g-rahul/5KW_OBC/Auxillary_Supply_UCC28740/IDFReport_Auxillary_Supply_UCC28740.html

Altium customize

# IDF File Translation Report

Date: | | 8/30/2020
Time: | | 11:17:08 AM
Elapsed Time: | | 00:00:00
PCB Filename | : | C:\Users\Public\Documents\Altium\Project\5kw_OBC\UCC2895-Q_KW\Auxillary_Supply_UCC28740\Auxillary_Supply_UCC28740.PcbDoc
IDF Board Filename | : | C:\Users\Public\Documents\Altium\Project\5kw_OBC\UCC2895-Q_KW\Auxillary_Supply_UCC28740\Auxillary_Supply_UCC28740.brd
IDF Library Filename | : | C:\Users\Public\Documents\Altium\Project\5kw_OBC\UCC2895-Q_KW\Auxillary_Supply_UCC28740\Auxillary_Supply_UCC28740.pro

Errors

Back to top

Warnings

Back to top

Save Warnings

Back to top

Save Errors

Back to top

Export Warnings

Back to top

Export Errors

Back to top
