g-rahul/5KW_OBC/Auxillary_Supply_UCC28740/WBDesign24.pdf

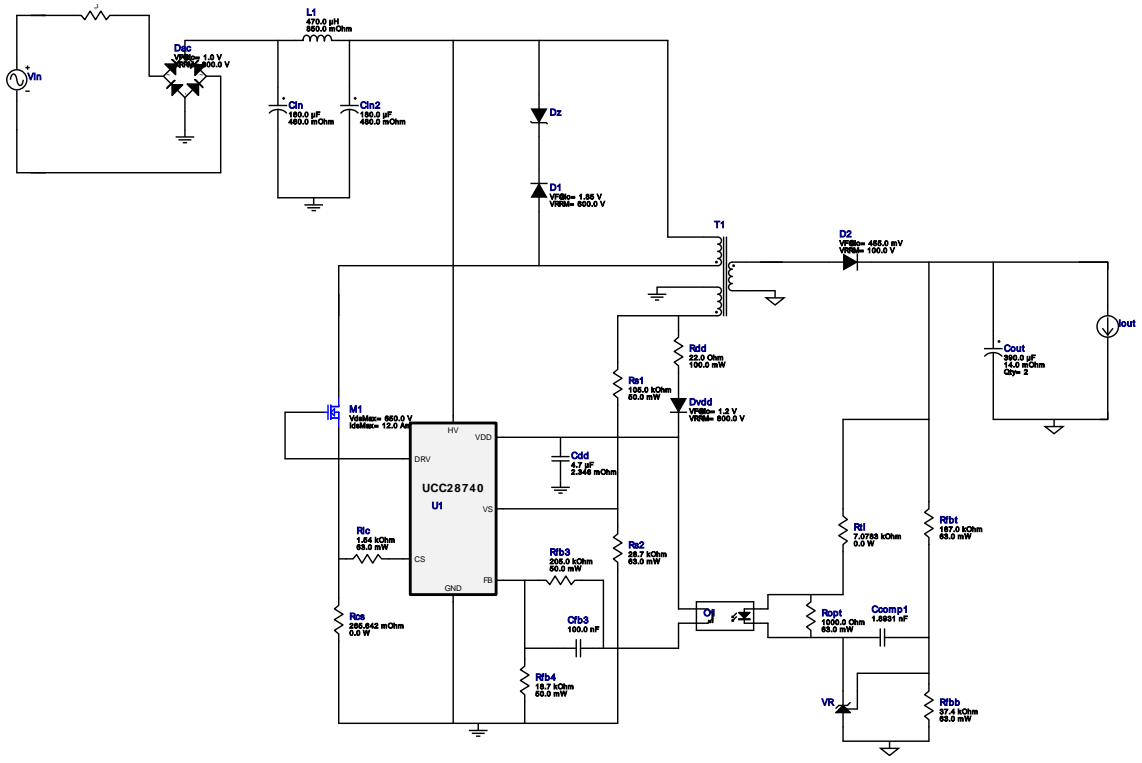
[picture p1: figure]
Ccomp1 Cfb3; Cin2 180.0 µF 480.0 mOhm; D1 VF@Io= 1.85 V VRRM= 600.0 V; D2 VF@Io= 455.0 mV VRRM= 100.0 V; Dac VF@Io= 1.0 V; VRRM= 800.0 V; L1 470.0 µH 850.0 mOhm; M1 VdsMax= 650.0 V IdsMax= 12.0 Amps; Rdd 22.0 Ohm 100.0 mW; Rfb4 18.7 kOhm 50.0 mW; Rlc 1.54 kOhm 63.0 mW; Ropt 1000.0 Ohm; Rs2 26.7 kOhm 63.0 mW; Cdd 4.7 µF 2.346 mOhm; Cin 180.0 µF 480.0 mOhm; Cout 390.0 µF; 14.0 mOhm Qty= 2; Dvdd VF@Io= 1.2 V VRRM= 800.0 V; Rcs 265.642 mOhm 0.0 W; Rfb3 205.0 kOhm 50.0 mW; Rfbb 37.4 kOhm 63.0 mW; Rfbt 187.0 kOhm; Rs1 105.0 kOhm 50.0 mW; Rtl 7.0783 kOhm; UCC28740; VDD; FB GND; DRV; Vin; Iout

Copyright © 2020, Texas Instruments Incorporated | 1 | ti.com/webench

WEBENCH®
Design Report UCC28740DR : UCC28740DR 90V-265V to 15.00V @ 4A March 12, 2020 04:56:46 GMT-07:00

## WEBENCH ® Design Report

Design : 24 UCC28740DR
UCC28740DR 90V-265V to 15.00V @ 4A

VinMin = 90.0V
VinMax = 265.0V
Vout = 15.0V
Iout = 4.0A

Device = UCC28740DR
Topology = Flyback
Created = 2020-03-12 04:49:58.049 BOM Cost = NA
BOM Count = 30
Total Pd = 14.47W
1. Rlc, Rtl and the feedback resistors for this design are a starting point, but may need adjustment based on the actual transformer used. For more information please click the design assistance button.
2. Click on the transformer symbol and select 'Design Transformer' to design using specific transformer cores and bobbin

### Design Alerts

Component Selection Information
Click on the transformer symbol in the schematic and select "Explore Transformer Core/Bobbin Selection" to design using specific transformer cores and bobbin.

## Electrical BOM

Name | Manufacturer | Part Number | Properties | Qty Price | Footprint
Ccomp1 | CUSTOM | CUSTOM Series= ? | Cap= 1.8931 nF VDC= 0.0 V IRMS= 0.0 A
1 | NA
| | | | | CUSTOM 0 mm²
Cdd | TDK | C2012X7R1V475K125AC (https://product.tdk.com/en/search/capacitor/ceramic/mlcc/info?part%5Fno%3DC2012X7R1V475K125AC) Series= X7R | Cap= 4.7 uF ESR= 2.346 mOhm VDC= 35.0 V IRMS= 4.2602 A
1 | $0.18
| | | | | 0805 7 mm²
Cfb3 | AVX | 08053C104JAZ2A (http://catalogs.avx.com/SurfaceMount.pdf) Series= X7R

Cap= 100.0 nF
VDC= 25.0 V
IRMS= 0.0 A

1 $0.06
0805 7 mm²

Design

Copyright © 2020, Texas Instruments Incorporated | 2 | ti.com/webench
Name | Manufacturer | Part Number | Properties | Qty Price | Footprint
Cin | Vishay-Bccomponents | MAL215959181E3 (http://www.vishay.com/docs/28341/159pulsi.pdf) Series= 2378 | Cap= 180.0 uF ESR= 480.0 mOhm VDC= 500.0 V IRMS= 1.13 A
1 | $5.30

159PUL-SI_3000x3500
1024 mm²
Cin2 | Vishay-Bccomponents | MAL215959181E3 (http://www.vishay.com/docs/28341/159pulsi.pdf) Series= 2378

Cap= 180.0 uF
ESR= 480.0 mOhm
VDC= 500.0 V
IRMS= 1.13 A

1 $5.30

159PUL-SI_3000x3500
1024 mm²
Cout | Panasonic | 20SVPF390M Series= SVPF

Cap= 390.0 uF
ESR= 14.0 mOhm
VDC= 20.0 V
IRMS= 4.95 A

2 $0.65

CAPSMT_62_E12 106 mm²
D1 | STMicroelectronics | STTH506B-TR (http://www.st.com/web/en/resource/technical/document/datasheet/CD00110837.pdf) | VF@Io= 1.85 V VRRM= 600.0 V
1 | $0.63

DPAK 102 mm²
D2 | STMicroelectronics | STPS20M100SG-TR (http://www.st.com/web/en/resource/technical/document/datasheet/CD00228904.pdf) | VF@Io= 455.0 mV VRRM= 100.0 V
1 | $1.33

DDPAK 210 mm²
Dac | Vishay-Semiconductor | GBU4K-E3/45 (http://www.vishay.com/docs/88614/gbu4a.pdf) | VF@Io= 1.0 V VRRM= 800.0 V | 1 | $0.68

GBU 131 mm²
Dvdd | Microsemi | UFS180JE3/TR13 | VF@Io= 1.2 V VRRM= 800.0 V | 1 | $0.73

DO-214BA 42 mm²
Dz | Diodes Inc. | SMBJ120A-13-F (http://www.diodes.com/datasheets/ds19002.pdf) | Zener | 1 | $0.09

SMB 44 mm²
L1 | NIC Components | NPI52W471MTRF (http://www.niccomp.com/pn/NPI52W471MTRF) | L= 470.0 µH 850.0 mOhm | 1 | $0.35

IND_NPI52W 358 mm²
M1 | STMicroelectronics | STD16N65M5 (http://www.st.com/web/en/resource/technical/document/datasheet/CD00288956.pdf) | VdsMax= 650.0 V IdsMax= 12.0 Amps
1 | $2.03

DPAK 102 mm²

Copyright © 2020, Texas Instruments Incorporated | 3 | ti.com/webench
Name | Manufacturer | Part Number | Properties | Qty Price | Footprint
NTC | GE Sensing | CL-40 (http://www.amphenol%2Dsensors.com/en/?option%3Dcom%5Fedocman%26task%3Ddocument.download%26id%3D90) Series= CL
Thermistor | 1 | $0.72
| | | | | Thermistor_CL-40 164 mm²
O1 | California Eastern Laboratories
PS2811-1 | Optocoupler | 1 | $0.41
| | | | | SSOP-4 111 mm²
Rcs | CUSTOM | CUSTOM Series= ? | Res= 265.642 mOhm Power= 0.0 W Tolerance= 0.0%
1 | NA
| | | | | CUSTOM 0 mm²
Rdd | Yageo | RC0603FR-0722RL (http://www.yageo.com.tw/exep/pages/download/literatures/PYu%2DR%5FINT%2Dthick%5F7.pdf) Series= ? | Res= 22.0 Ohm Power= 100.0 mW Tolerance= 1.0%
1 | $0.01
| | | | | 0603 5 mm²
Rfb3 | Yageo | RC0201FR-07205KL (http://www.yageo.com/exep/pages/download/literatures/PYu%2DR%5FMarking%5F2.pdf) Series= ? | Res= 205.0 kOhm Power= 50.0 mW Tolerance= 1.0%
1 | $0.01
| | | | | 0201 2 mm²
Rfb4 | Yageo | RC0201FR-0718K7L (http://www.yageo.com/exep/pages/download/literatures/PYu%2DR%5FMarking%5F2.pdf) Series= ? | Res= 18.7 kOhm Power= 50.0 mW Tolerance= 1.0%
1 | $0.01
| | | | | 0201 2 mm²
Rfbb | Vishay-Dale | CRCW040237K4FKED (http://www.vishay.com/docs/20035/dcrcwe3.pdf) Series= CRCW..e3 | Res= 37.4 kOhm Power= 63.0 mW Tolerance= 1.0%
1 | $0.01
| | | | | 0402 3 mm²
Rfbt | Vishay-Dale | CRCW0402187KFKED (http://www.vishay.com/docs/20035/dcrcwe3.pdf) Series= CRCW..e3 | Res= 187.0 kOhm Power= 63.0 mW Tolerance= 1.0%
1 | $0.01
| | | | | 0402 3 mm²
Rlc | Vishay-Dale | CRCW04021K54FKED (http://www.vishay.com/docs/20035/dcrcwe3.pdf) Series= CRCW..e3 | Res= 1.54 kOhm Power= 63.0 mW Tolerance= 1.0%
1 | $0.01
| | | | | 0402 3 mm²
Ropt | Vishay-Dale | CRCW04021K00FKED (http://www.vishay.com/docs/20035/dcrcwe3.pdf) Series= CRCW..e3 | Res= 1000.0 Ohm Power= 63.0 mW Tolerance= 1.0%
1 | $0.01
| | | | | 0402 3 mm²
Rs1 | Yageo | RC0201FR-07105KL (http://www.yageo.com/exep/pages/download/literatures/PYu%2DR%5FMarking%5F2.pdf) Series= ? | Res= 105.0 kOhm Power= 50.0 mW Tolerance= 1.0%
1 | $0.01
| | | | | 0201 2 mm²
Rs2 | Vishay-Dale | CRCW040226K7FKED (http://www.vishay.com/docs/20035/dcrcwe3.pdf) Series= CRCW..e3 | Res= 26.7 kOhm Power= 63.0 mW Tolerance= 1.0%
1 | $0.01
| | | | | 0402 3 mm²
Rtl | CUSTOM | CUSTOM Series= ? | Res= 7.0783 kOhm Power= 0.0 W Tolerance= 0.0%
1 | NA
| | | | | CUSTOM 0 mm²
T1 | Core=Wurth Elektronik , CoilFormer=Wurth Elektronik | Core=150-1680 , CoilFormer=070-5080 (http://katalog.we-online.de/pcd/datasheet/070-5080.pdf) | Lp= 262.0 µH Turns Ratio(Nas)= 9:7 Turns Ratio(Nps)= 47:7 Npri= 47.0 Naux= 9.0 Nsec= 7.0
1 | NA
| | | | | TDK_B66305 714 mm²
U1 | Texas Instruments | UCC28740DR (http://www.ti.com/product/UCC28740) | Switcher | 1 | $0.39

R-PDSO-G7 55 mm²
VR | Texas Instruments | TL431IDBVR (http://www.ti.com/product/TL431) | Voltage References | 1 | $0.07

R-PDSO-G3 16 mm²

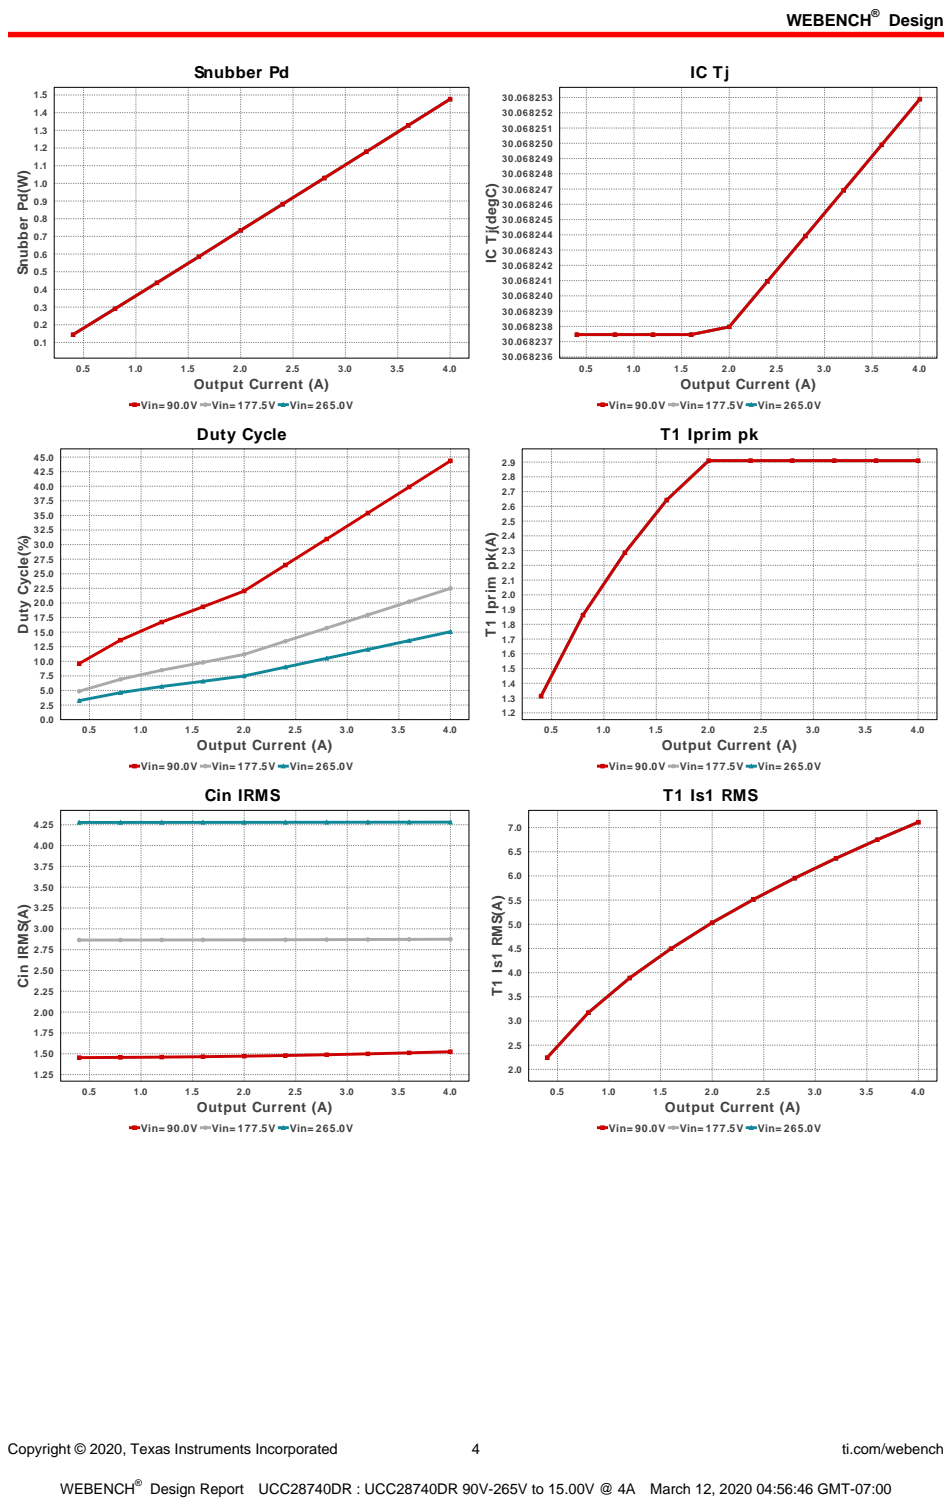
[picture p2: page 4]
Copyright © 2020, Texas Instruments Incorporated; ti.com/webench; Snubber Pd; 4.0 Output Current (A); Snubber Pd(W); Duty Cycle(%); T1 Iprim pk(A); Cin IRMS; Cin IRMS(A); T1 Is1 RMS(A)

IC Tj(degC)

Vin= 90.0V Vin= 177.5V Vin= 265.0V
Duty Cycle

T1 Iprim pk

T1 Is1 RMS

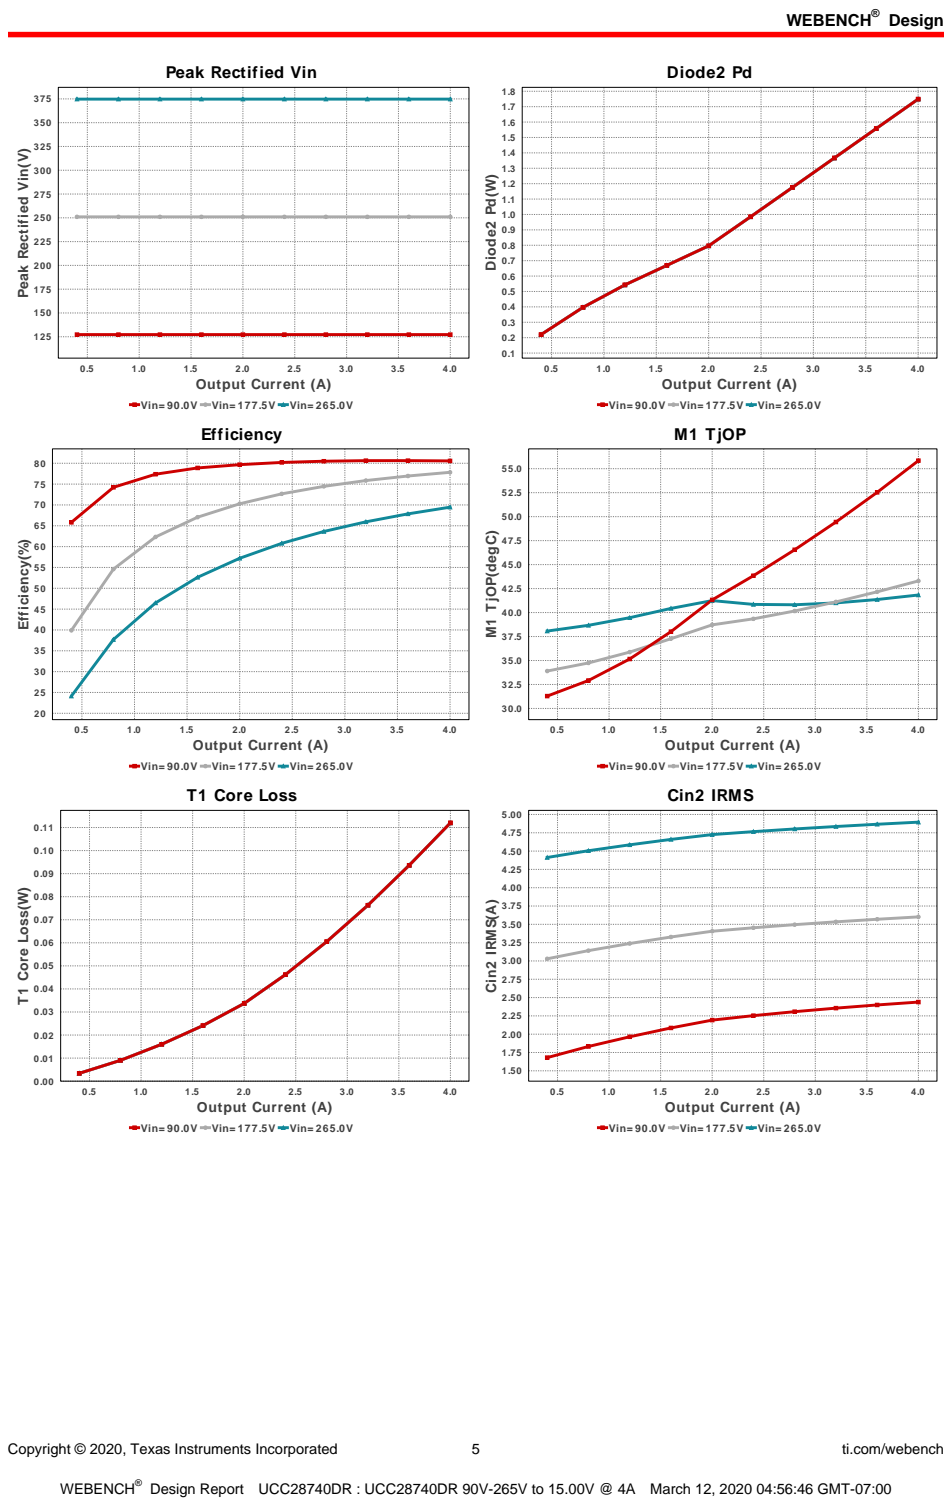
[picture p3: page 5]
Copyright © 2020, Texas Instruments Incorporated; ti.com/webench; 4.0 Output Current (A); Diode2 Pd; Diode2 Pd(W); Efficiency; Efficiency(%); M1 TjOP; M1 TjOP(degC); T1 Core Loss(W); Cin2 IRMS; Cin2 IRMS(A)

Peak Rectified Vin

Peak Rectified Vin(V)

Vin= 90.0V Vin= 177.5V Vin= 265.0V

T1 Core Loss

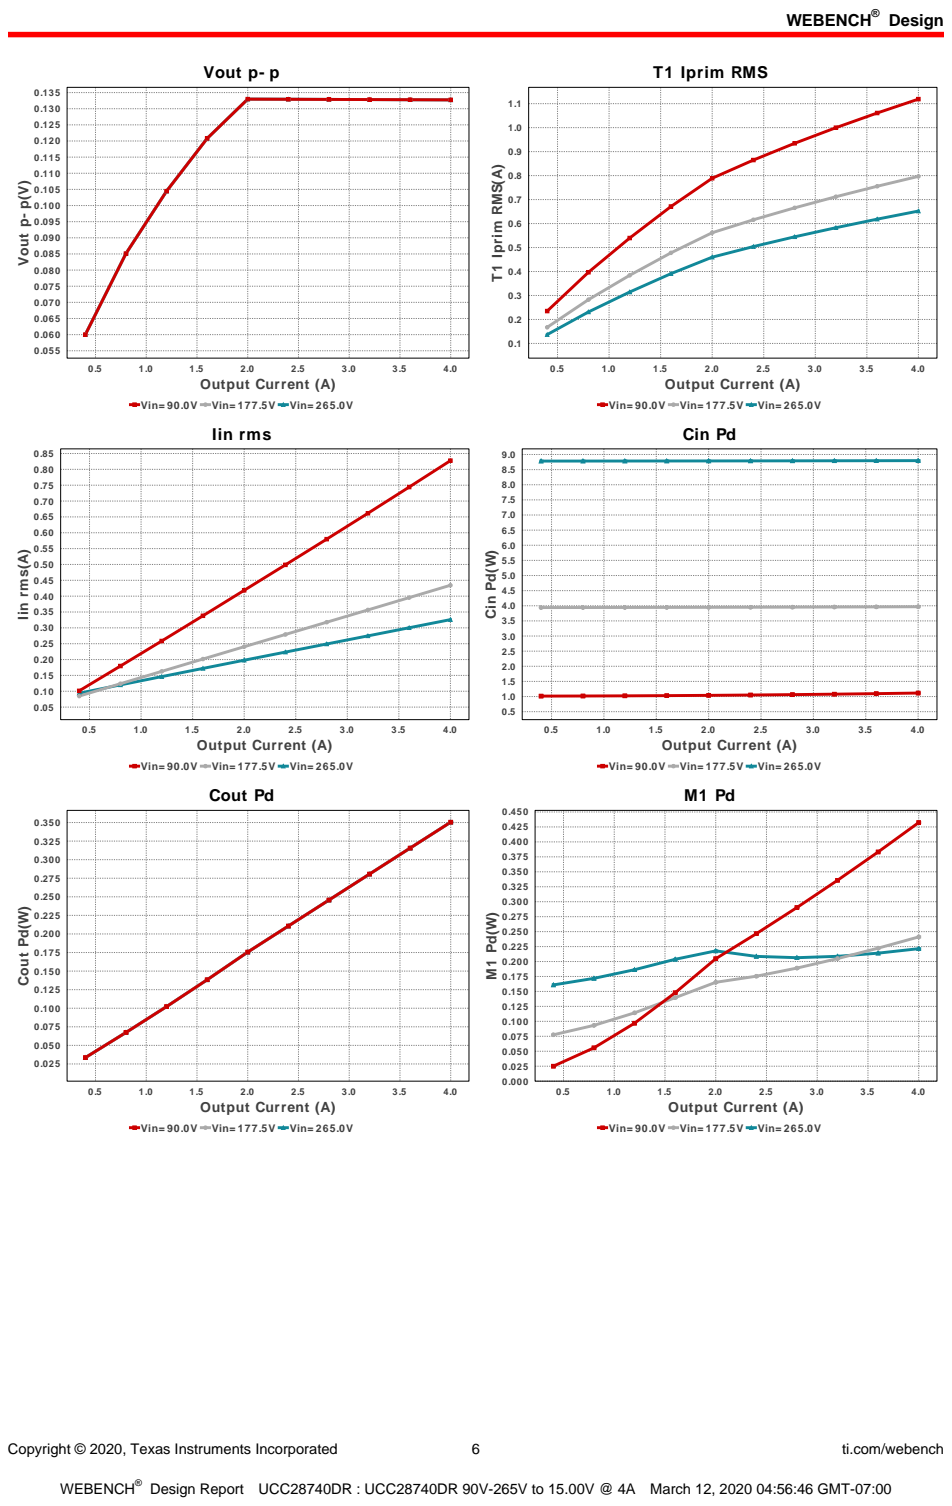
[picture p4: page 6]
Copyright © 2020, Texas Instruments Incorporated; ti.com/webench; Vout p- p; 4.0 Output Current (A); Vout p- p(V); T1 Iprim RMS; T1 Iprim RMS(A); Iin rms; Iin rms(A); Cin Pd; Cin Pd(W); Cout Pd; Cout Pd(W)

Vin= 90.0V Vin= 177.5V Vin= 265.0V

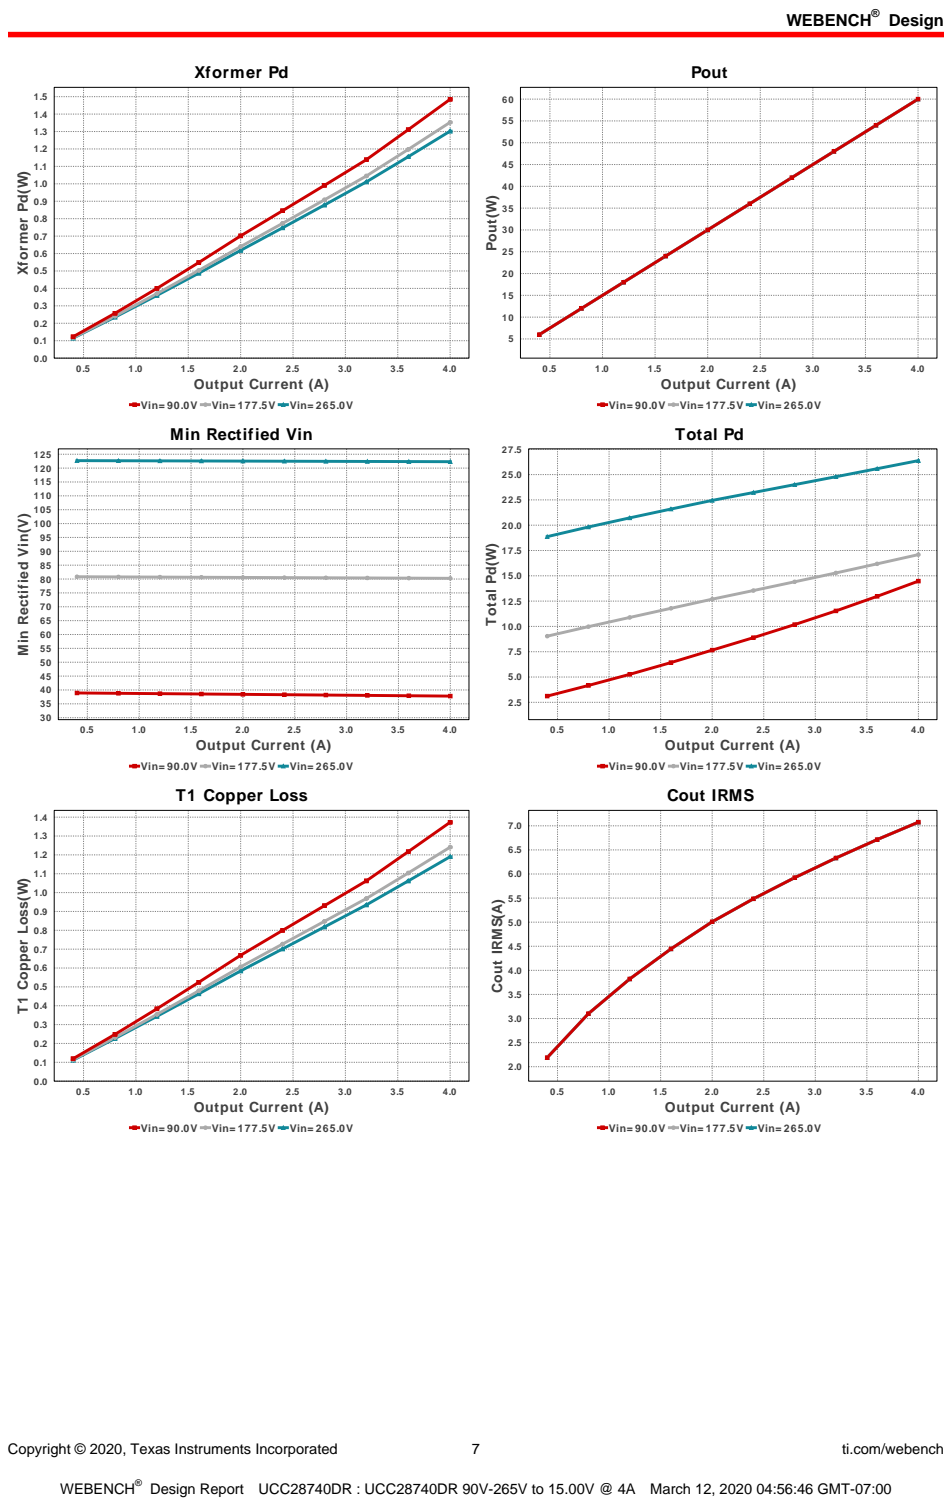
[picture p5: page 7]
Copyright © 2020, Texas Instruments Incorporated; ti.com/webench; Xformer Pd; 4.0 Output Current (A); Xformer Pd(W); Pout; Pout(W); Total Pd; Total Pd(W); T1 Copper Loss(W); Cout IRMS; Cout IRMS(A)

Vin= 90.0V Vin= 177.5V Vin= 265.0V
Min Rectified Vin

Min Rectified Vin(V)

T1 Copper Loss

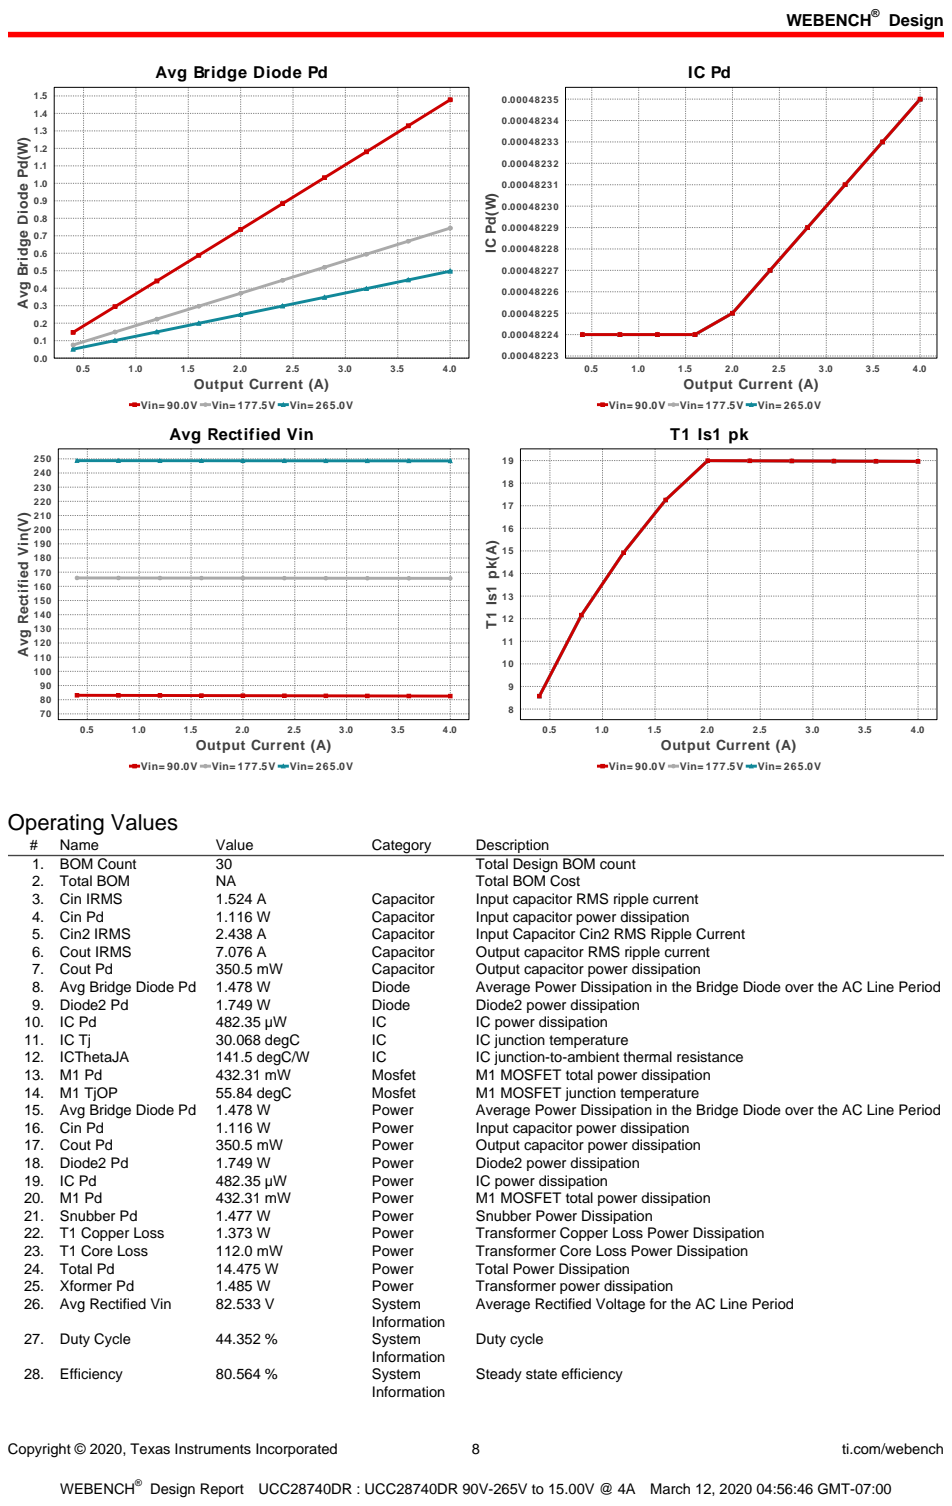
[picture p6: page 8]
Copyright © 2020, Texas Instruments Incorporated; ti.com/webench; 4.0 Output Current (A); Operating Values; Name; Value; Category; Description; 1. BOM Count; Total Design BOM count; 2. Total BOM; Total BOM Cost; 3. Cin IRMS; Capacitor; Input capacitor RMS ripple current; 4. Cin Pd; Input capacitor power dissipation; 5. Cin2 IRMS; Input Capacitor Cin2 RMS Ripple Current; 6. Cout IRMS; Output capacitor RMS ripple current; 7. Cout Pd; Output capacitor power dissipation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

Avg Bridge Diode Pd

Avg Bridge Diode Pd(W)

Vin= 90.0V Vin= 177.5V Vin= 265.0V
Avg Rectified Vin

Avg Rectified Vin(V)

Average Rectified Voltage for the AC Line Period

Steady state efficiency

Copyright © 2020, Texas Instruments Incorporated | 9 | ti.com/webench
# | Name | Value | Category | Description

29. FootPrint | 4.362 k mm² | System
| | | Information | Total Foot Print Area of BOM components
30. Frequency | 66.662 kHz | System
| | | Information | Switching frequency
31. Frequency | 66.662 kHz | System
| | | Information | Switching frequency
32. Iin rms | 827.5 mA | System
| | | Information | RMS Input Current
33. Iout | 4.0 A | System
| | | Information | Iout operating point
34. Min Rectified Vin | 37.787 V | System
| | | Information | Minimum voltage seen at rectified input
35. Mode | DCM | System
| | | Information | Conduction Mode
36. Peak Rectified Vin | 127.278 V | System
| | | Information | Peak voltage seen at rectified input
37. Pout | 60.0 W | System
| | | Information | Total output power
38. Vin_RMS | 90.0 V | System
| | | Information | Vin operating point
39. Vout | 15.0 V | System
| | | Information | Operational Output Voltage
40. Vout Actual | 15.0 V | System
| | | Information | Vout Actual calculated based on selected voltage divider resistors
41. Vout Tolerance | 2.009 % | System
| | | Information | Vout Tolerance based on IC Tolerance (no load) and voltage divider resistors if applicable
42. Vout p-p | 132.743 mV | System
| | | Information | Peak-to-peak output ripple voltage
43. T1 Copper Loss | 1.373 W | Transformer | Transformer Copper Loss Power Dissipation
44. T1 Core Loss | 112.0 mW | Transformer | Transformer Core Loss Power Dissipation
45. T1 Iprim RMS | 1.119 A | Transformer | Transformer Primary RMS Current
46. T1 Iprim pk | 2.91 A | Transformer | Transformer Primary Peak Current
47. T1 Is1 RMS | 7.112 A | Transformer | Transformer Secondary1 RMS Current
48. T1 Is1 pk | 18.963 A | Transformer | Transformer Secondary1 Peak Current
49. Xformer Pd | 1.485 W | Transformer | Transformer power dissipation

## Design Inputs

Name | Value | Description
Iout | 4.0 | Maximum Output Current
VinMax | 265.0 | Maximum input voltage
VinMin | 90.0 | Minimum input voltage
Vout | 15.0 | Output Voltage
acFrequency | 50.0 | AC Frequency
| base_pn | | UCC28740 | Base Product Number
source | AC | Input Source Type
Ta | 30.0 | Ambient temperature


Copyright © 2020, Texas Instruments Incorporated | 10 | ti.com/webench

## Assembly

## Component Testing

Some published data on components in datasheets such as Capacitor ESR and Inductor DC resistance is based on conservative values that will guarantee that the components always exceed the specification. For design purposes it is usually better to work with typical values. Since this data is not always available it is a good practice to measure the Capacitance and ESR values of Cin and Cout, and the inductance and DC resistance of L1 before assembly of the board. Any large discrepancies in values should be electrically simulated in WEBENCH to check for instabilities and thermally simulated in WebTHERM to make sure critical temperatures are not exceeded.

## Soldering Component to Board

If board assembly is done in house it is best to tack down one terminal of a component on the board then solder the other terminal. For surface mount parts with large tabs, such as the DPAK, the tab on the back of the package should be pre-tinned with solder, then tacked into place by one of the pins. To solder the tab town to the board place the iron down on the board while resting against the tab, heating both surfaces simultaneously. Apply light pressure to the top of the plastic case until the solder flows around the part and the part is flush with the PCB. If the solder is not flowing around the board you may need a higher wattage iron (generally 25W to 30W is enough).

## Initial Startup of Circuit

It is best to initially power up the board by setting the input supply voltage to the lowest operating input voltage 90.0V and set the input supply's current limit to zero. With the input supply off connect up the input supply to Vin and GND. Connect a digital volt meter and a load if needed to set the minimum Iout of the design from Vout and GND. Turn on the input supply and slowly turn up the current limit on the input supply.
If the voltage starts to rise on the input supply continue increasing the input supply current limit while watching the output voltage. If the current increases on the input supply, but the voltage remains near zero, then there may be a short or a component misplaced on the board. Power down the board and visually inspect for solder bridges and recheck the diode and capacitor polarities. Once the power supply circuit is operational then more extensive testing may include full load testing, transient load and line tests to compare with simulation results.

## Load Testing

The setup is the same as the initial startup, except that an additional digital voltmeter is connected between Vin and GND, a load is connected between Vout and GND and a current meter is connected in series between Vout and the load. The load must be able to handle at least rated output power + 50% ( 7.5 watts for this design). Ideally the load is supplied in the form of a variable load test unit. It can also be done in the form of suitably large power resistors. When using an oscilloscope to measure waveforms on the prototype board, the ground leads of the oscilloscope probes should be as short as possible and the area of the loop formed by the ground lead should be kept to a minimum. This will help reduce ground lead inductance and eliminate EMI noise that is not actually present in the circuit.

## Transformer Report

## Transformer Electrical Diagram

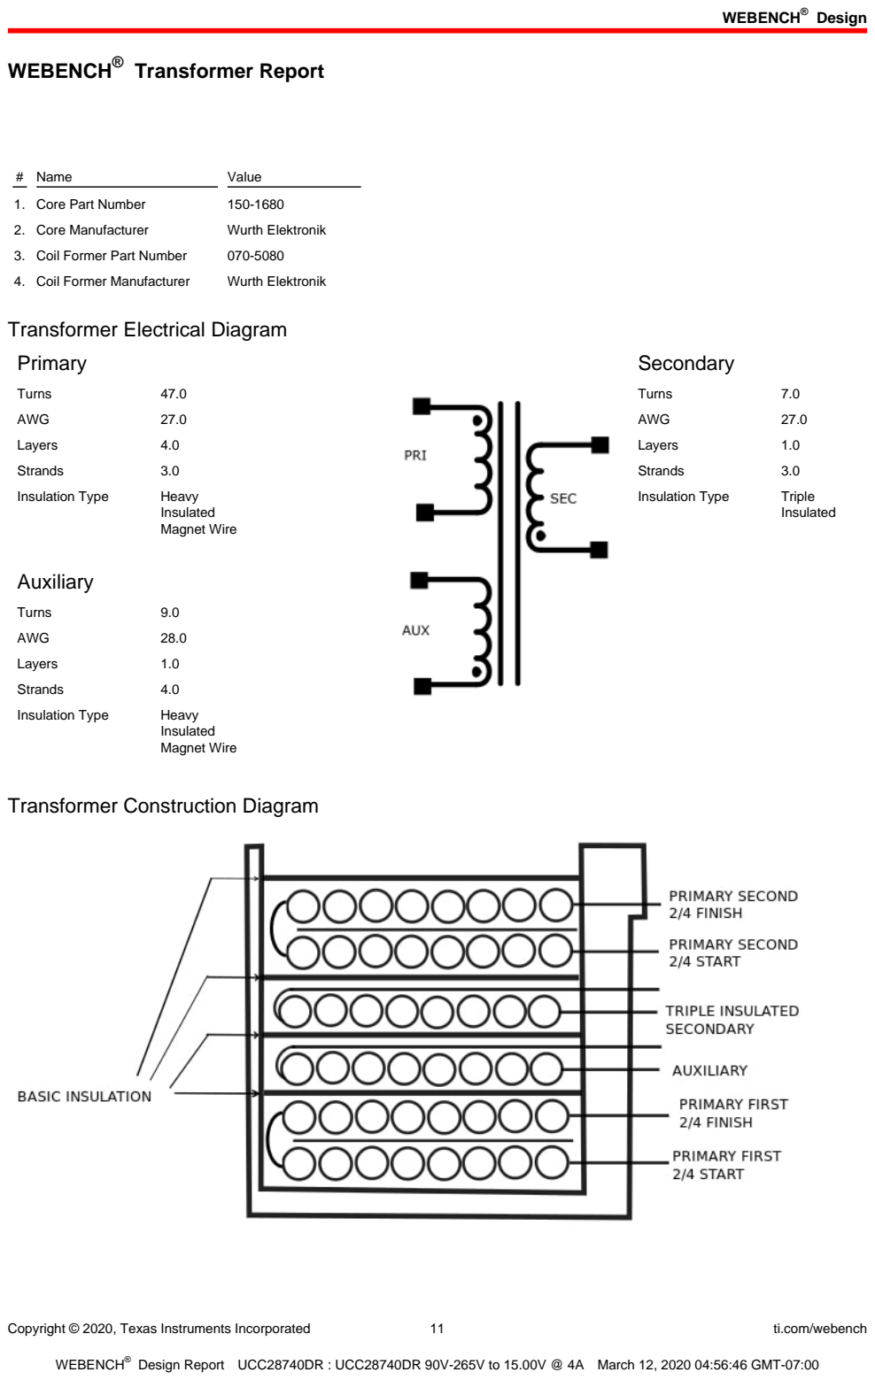
[picture p8: page 11]

Copyright © 2020, Texas Instruments Incorporated | 11 | ti.com/webench
# Name | Value

1. Core Part Number | 150-1680
2. Core Manufacturer | Wurth Elektronik
3. Coil Former Part Number | 070-5080
4. Coil Former Manufacturer | Wurth Elektronik

## Primary

Turns | 47.0
AWG | 27.0
Layers | 4.0
Strands | 3.0
Insulation Type | Heavy
Insulated
Magnet Wire

## Auxiliary

Turns | 9.0
AWG | 28.0
Layers | 1.0
Strands | 4.0
Insulation Type | Heavy
Insulated
Magnet Wire

## Secondary

Turns | 7.0
AWG | 27.0
Layers | 1.0
Strands | 3.0
Insulation Type | Triple Insulated

## Transformer Construction Diagram

Copyright © 2020, Texas Instruments Incorporated | 12 | ti.com/webench

## Winding Instruction

Winding | AWG | Turns | Winding Orientation
Primary First 2/4.0 | 27.0 | 24 | Clockwise
Auxiliary | 28.0 | 9.0 | Counter Clockwise
Triple Insulated Secondary | 27.0 | 7.0 | Counter Clockwise
Primary Second 2/4.0 | 27.0 | 23 | Clockwise

## Transformer Parameters

# Name | Value

1. Lpri | 2.62E-4H
2. Inductance Factor(Al) | 119.0nH
3. Npri | 47.0
4. Nsec | 7.0
5. Naux | 9.0
6. Core Type | EE25/13/11
7. Core Material | TP4A
8. Bmax | 0.21T
9. Switching Frequency | 63.00kHz
10. DMax | 0.51
11. Ipk(Primary) | 2.91A
12. Irms(Primary) | 1.2A
13. Ipk(Secondary) | 19.5A
14. Irms(Secondary) | 7.35A

## Design Assistance

1. Application Hints Rlc Rlc provides the function of feed-forward line compensation to eliminate change in IPP due to change in di/dt and the propagation delay of the internal comparator and MOSFET turn-off time. For best results the chosen value may need to be adjusted based on board, FET and transformer parasitics. Rtl Rtl is added to prevent excessive diode current and limit Iopt to the maximum value necessary for regulationThe Rtl value may be adjusted for optimal limiting later during the porotype evaluation process. Rfbt & Rfbb The feedback resistors will set the output voltage of the circuit. The values chosen may need to be fined tuned based on the final Transformer turns ratios and the voltage across the output diode at close to zero current. Rfb3 & Cfb3 Rfb3 is necessary to limit the current into FB and to avoid excess draining of Cvdd during this type of transient situation.The value of Rfb3 is chosen to limit the excess Ifb and Rfb4 current to an acceptable level when the optocoupler is saturatedCfb3 helps improve the transient response and is estimated initially by equating the time constant to 1ms. This can later beadjusted for optimal performance during prototype evaluation Rfb4 Rfb4 speeds up the turnoff time of the optocoupler in the case of a heavy load-step transient condition. This value tends to fallwithin the range of 10k and 100k. A tradeoff must be made between a lower value for faster transient response and a higher value forlower standby power. Rfb4 also serves to set a minimum bias current for the optocoupler and to drain dark current Part Description The UCC28740 isolated-flyback controller provides Constant-Voltage (CV) using an optical coupler toimprove transient response. Constant-Current (CC) regulation is accomplished through Primary Side Regulation (PSR) techniques. Please see the datasheet for further design guidance. http://www.ti.com/lit/ds/symlink/ucc28740.pdf
2. Master key : BE5D32129D021133[v1]
3. UCC28740 Product Folder : http://www.ti.com/product/UCC28740 : contains the data sheet and other resources.

Important Notice and Disclaimer

TI provides technical and reliability data (including datasheets), design resources (including reference designs), application or other design advice, web tools, safety information, and other resources AS IS and with all faults, and disclaims all warranties. These resources are intended for skilled developers designing with TI products. You are solely responsible for (1) selecting the appropriate TI products for your application, (2) designing, validating and testing your application, and (3) ensuring your application meets applicable standards, and any other safety, security, or other requirements.

These resources are subject to change without notice. TI grants you permission to use these resources only for development of an application that uses the TI products described in the resource. Other reproduction and display of these resources is prohibited. No license is granted to any other TI intellectual property right or to any third party intellectual property right. TI disclaims responsibility for, and you will fully indemnify TI and its representatives against, any claims, damages, costs, losses, and liabilities arising out of your use of these resources.

Providing these resources does not expand or otherwise alter TI's applicable Terms of Sale or other applicable terms available either on ti.com or provided in conjunction with TI products.
