g-rahul/5KW_OBC/Auxillary_Supply_UCC28740/3D Models/E25-13-7-and-B66208B(horizontal).STEP

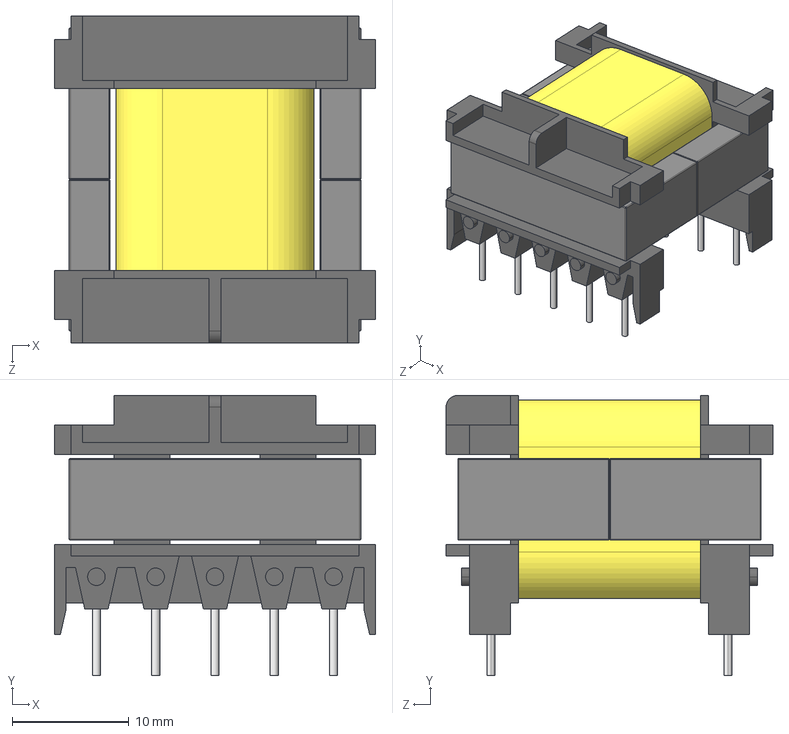
[picture p9: CAD file, 2020-07-27]
Auxillary_Supply_UCC28740/3D Models/E25-13-7-and-B66208B(horizontal).STEP
27.5 x 24.0 x 28.0 mm
B66208B
Ferrite-E25_13_7 x 2
winding-15.6
