g-rahul/5KW_OBC/PFC_Stage/PFC_Stage.DXF

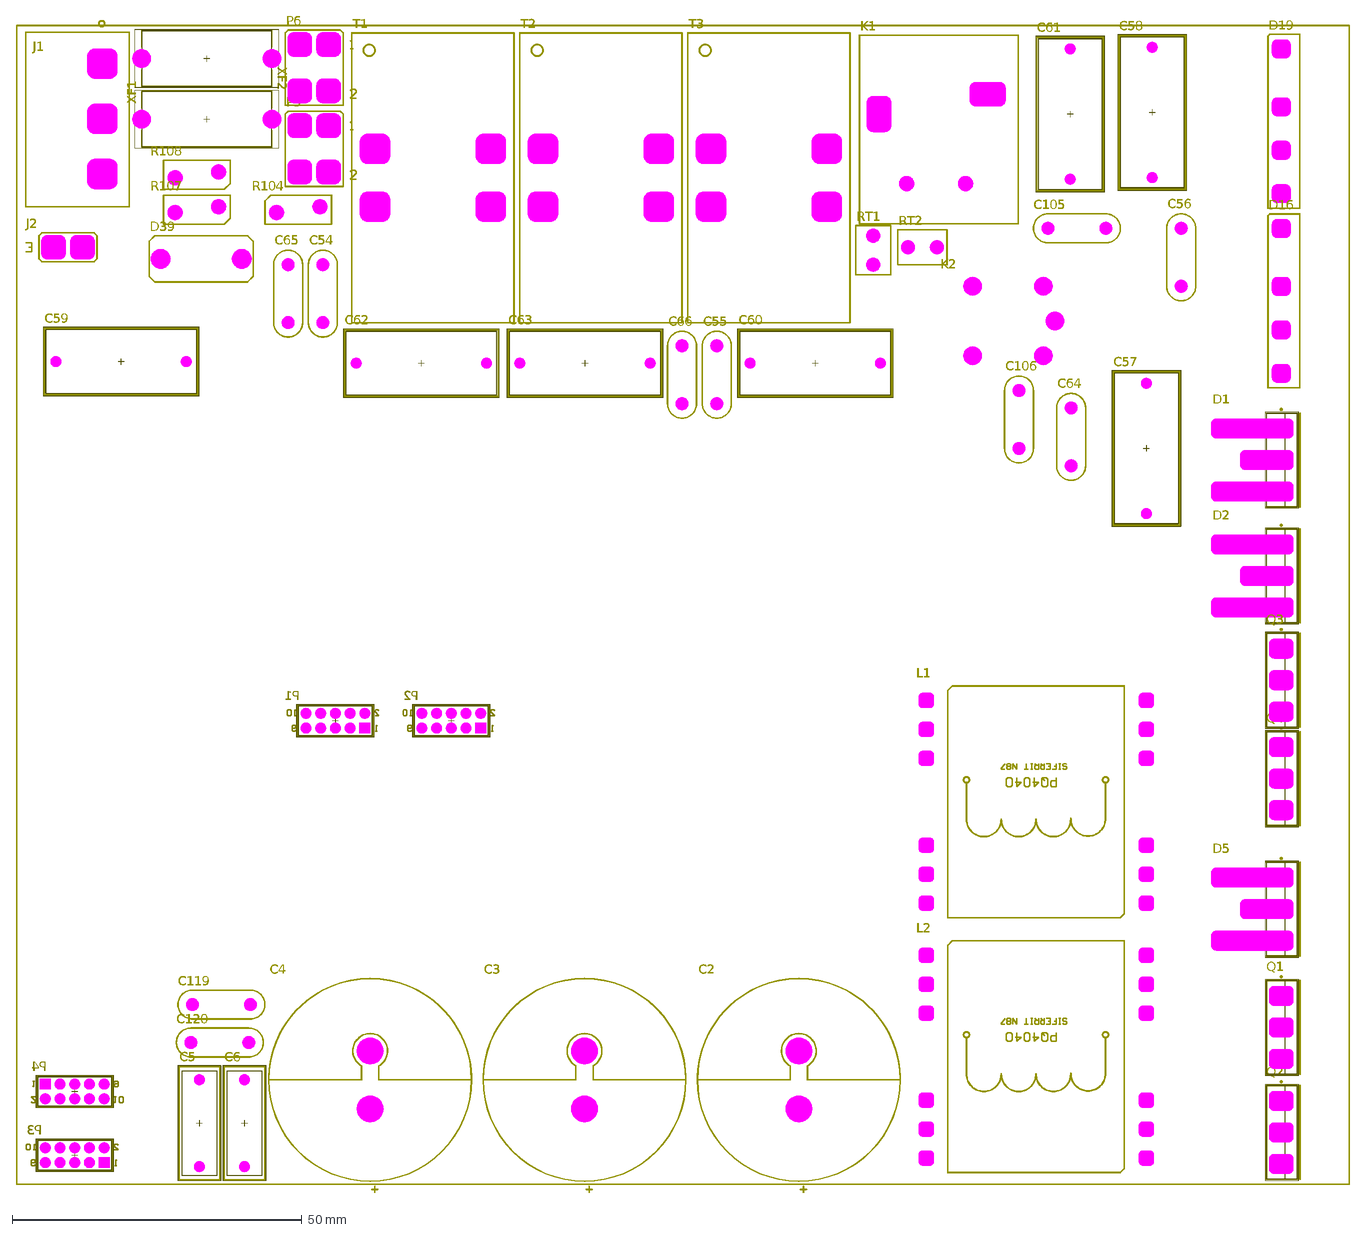
[picture p10: CAD file, 2020-07-27]
PFC_Stage/PFC_Stage.DXF
P4
P3
P2
P1
D5
D2
D1
Q4
Q3
Q2
Q1
L2
L1
C120
C119
C58
C57
C6
C5
C4
C3
C2
K1
XF2
XF1
T3
T2
T1
RT2
RT1
R108
R107
R104
P9
P6
K2
J2
J1
D39
D19
D16
C106
C105
C66
C65
C64
C63
C62
C61
C60
C59
C56
C55
C54
