g-rahul/5KW_OBC/PFC_Stage/Error_Fabrication_Rectified.png

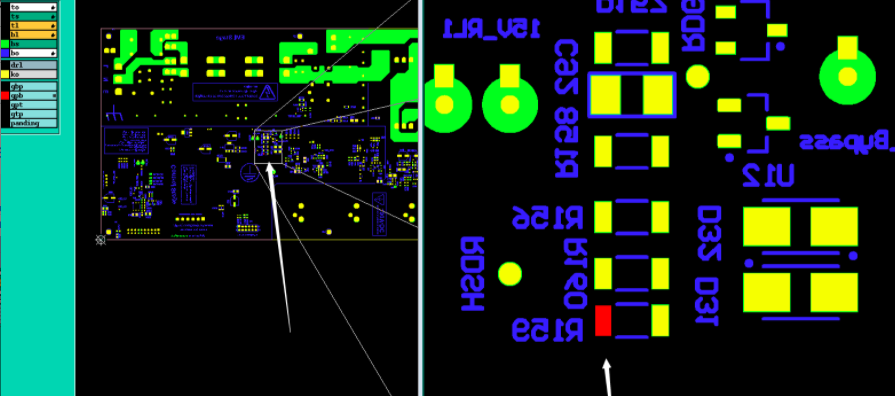
PFC_Stage/Error_Fabrication_Rectified.png
