g-rahul/5KW_OBC/Edge_Card_Ucc28951/PCIE/PCC-0001-00084-1/Images/ItemRevisions/ACF88CD9-87D5-407A-B0E9-1F2CBE642336/2D-F.png

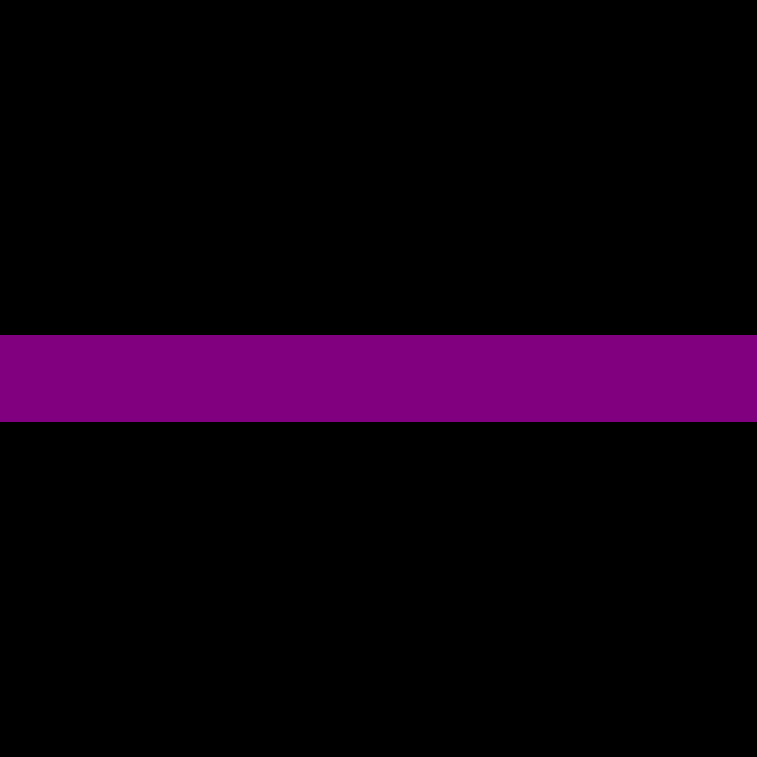
Edge_Card_Ucc28951/PCIE/PCC-0001-00084-1/Images/ItemRevisions/ACF88CD9-87D5-407A-B0E9-1F2CBE642336/2D-F.png
