g-rahul/5KW_OBC/Edge_Card_Ucc28951/PCIE/SYM-0001-00115-1/Images/ItemRevisions/16D01208-DC93-4EAF-9F99-BBC11E26DAC9/1-F.png

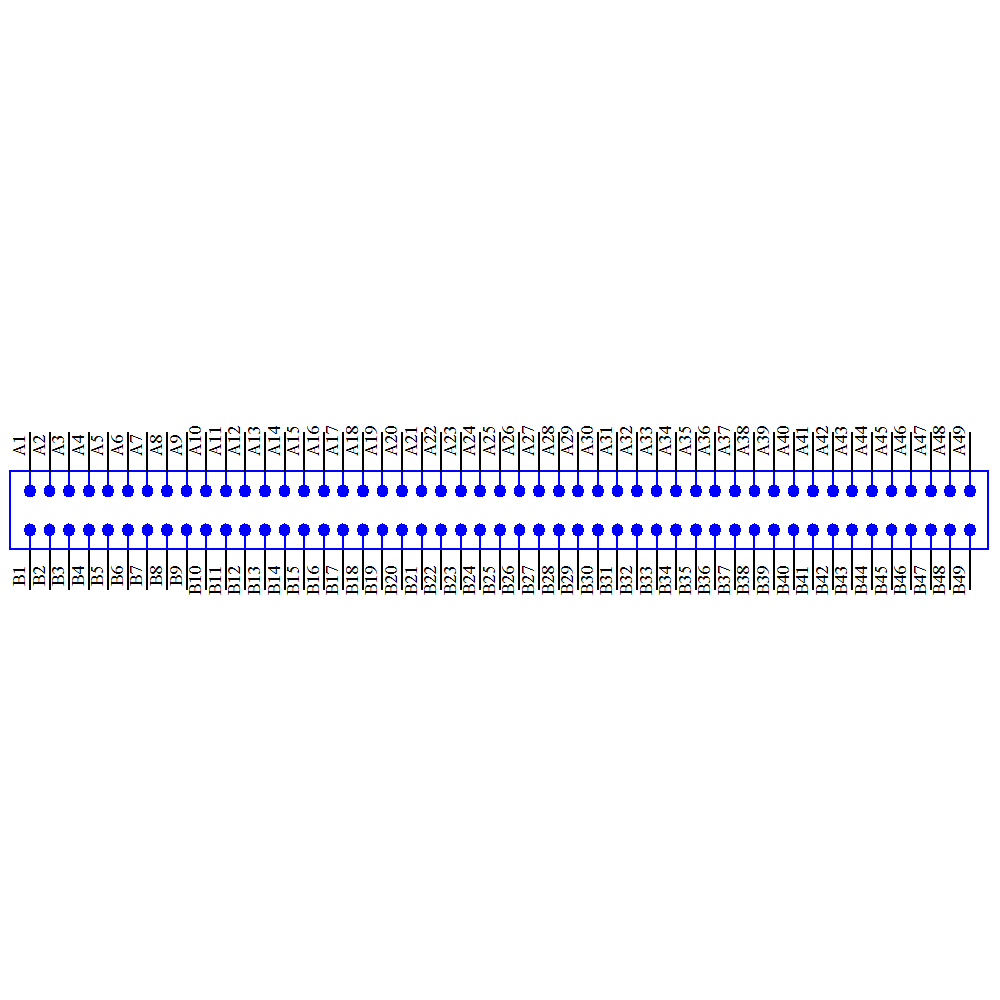
Edge_Card_Ucc28951/PCIE/SYM-0001-00115-1/Images/ItemRevisions/16D01208-DC93-4EAF-9F99-BBC11E26DAC9/1-F.png
