g-rahul/5KW_OBC/Schematic_PDF/Auxillary_Supply_UCC28740.pdf

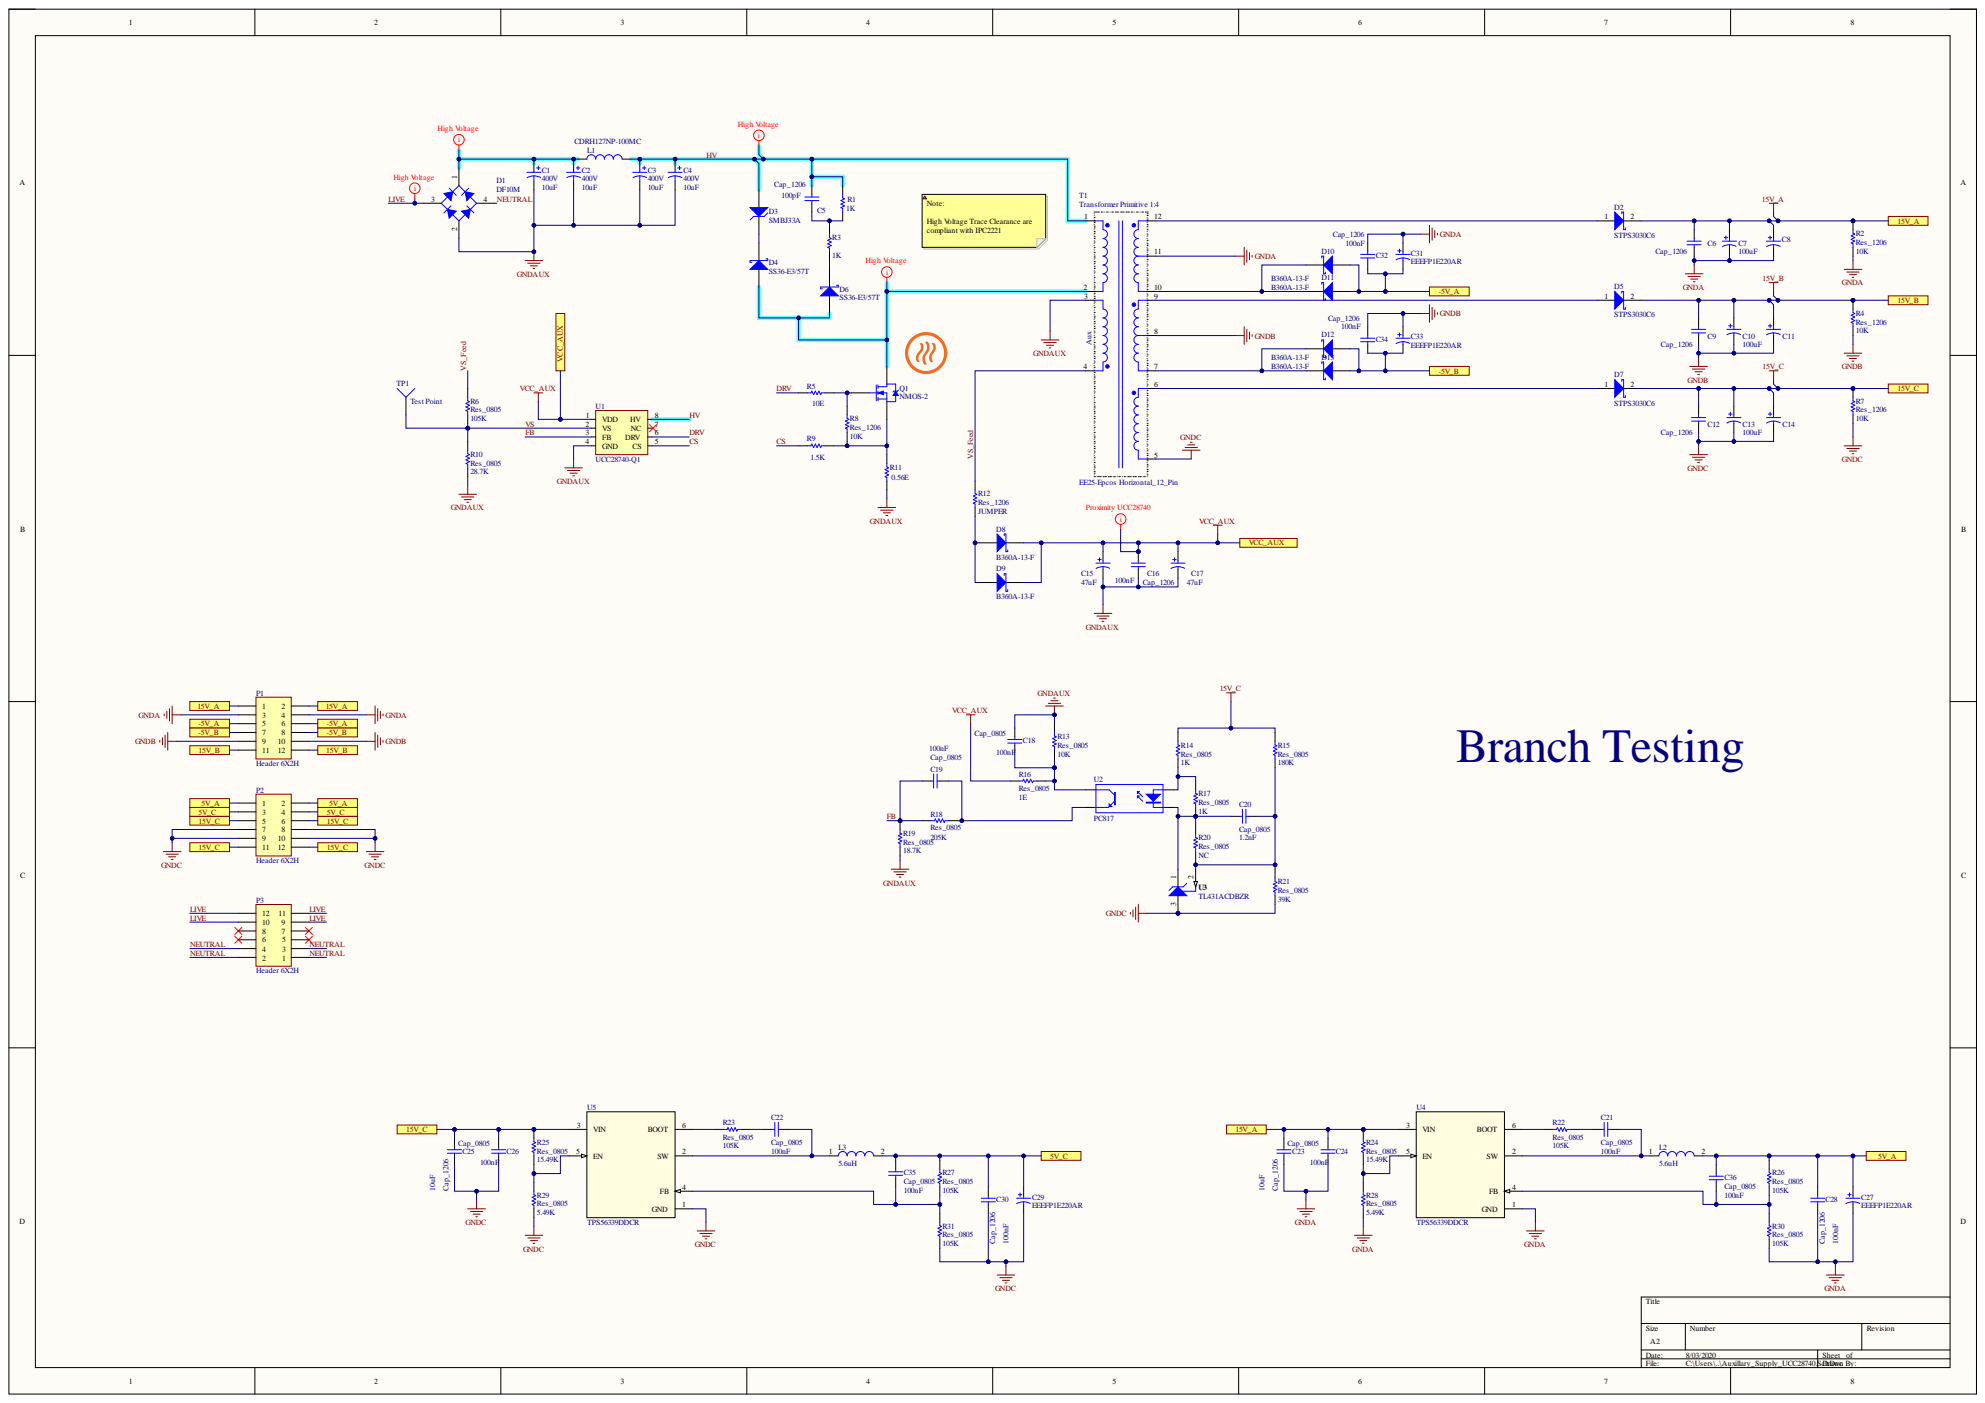
[picture p14: page 1]

High Voltage Trace Clearance are
compliant with IPC2221
