g-rahul/5KW_OBC/Schematic_PDF/Edge_Card_Ucc28951.pdf

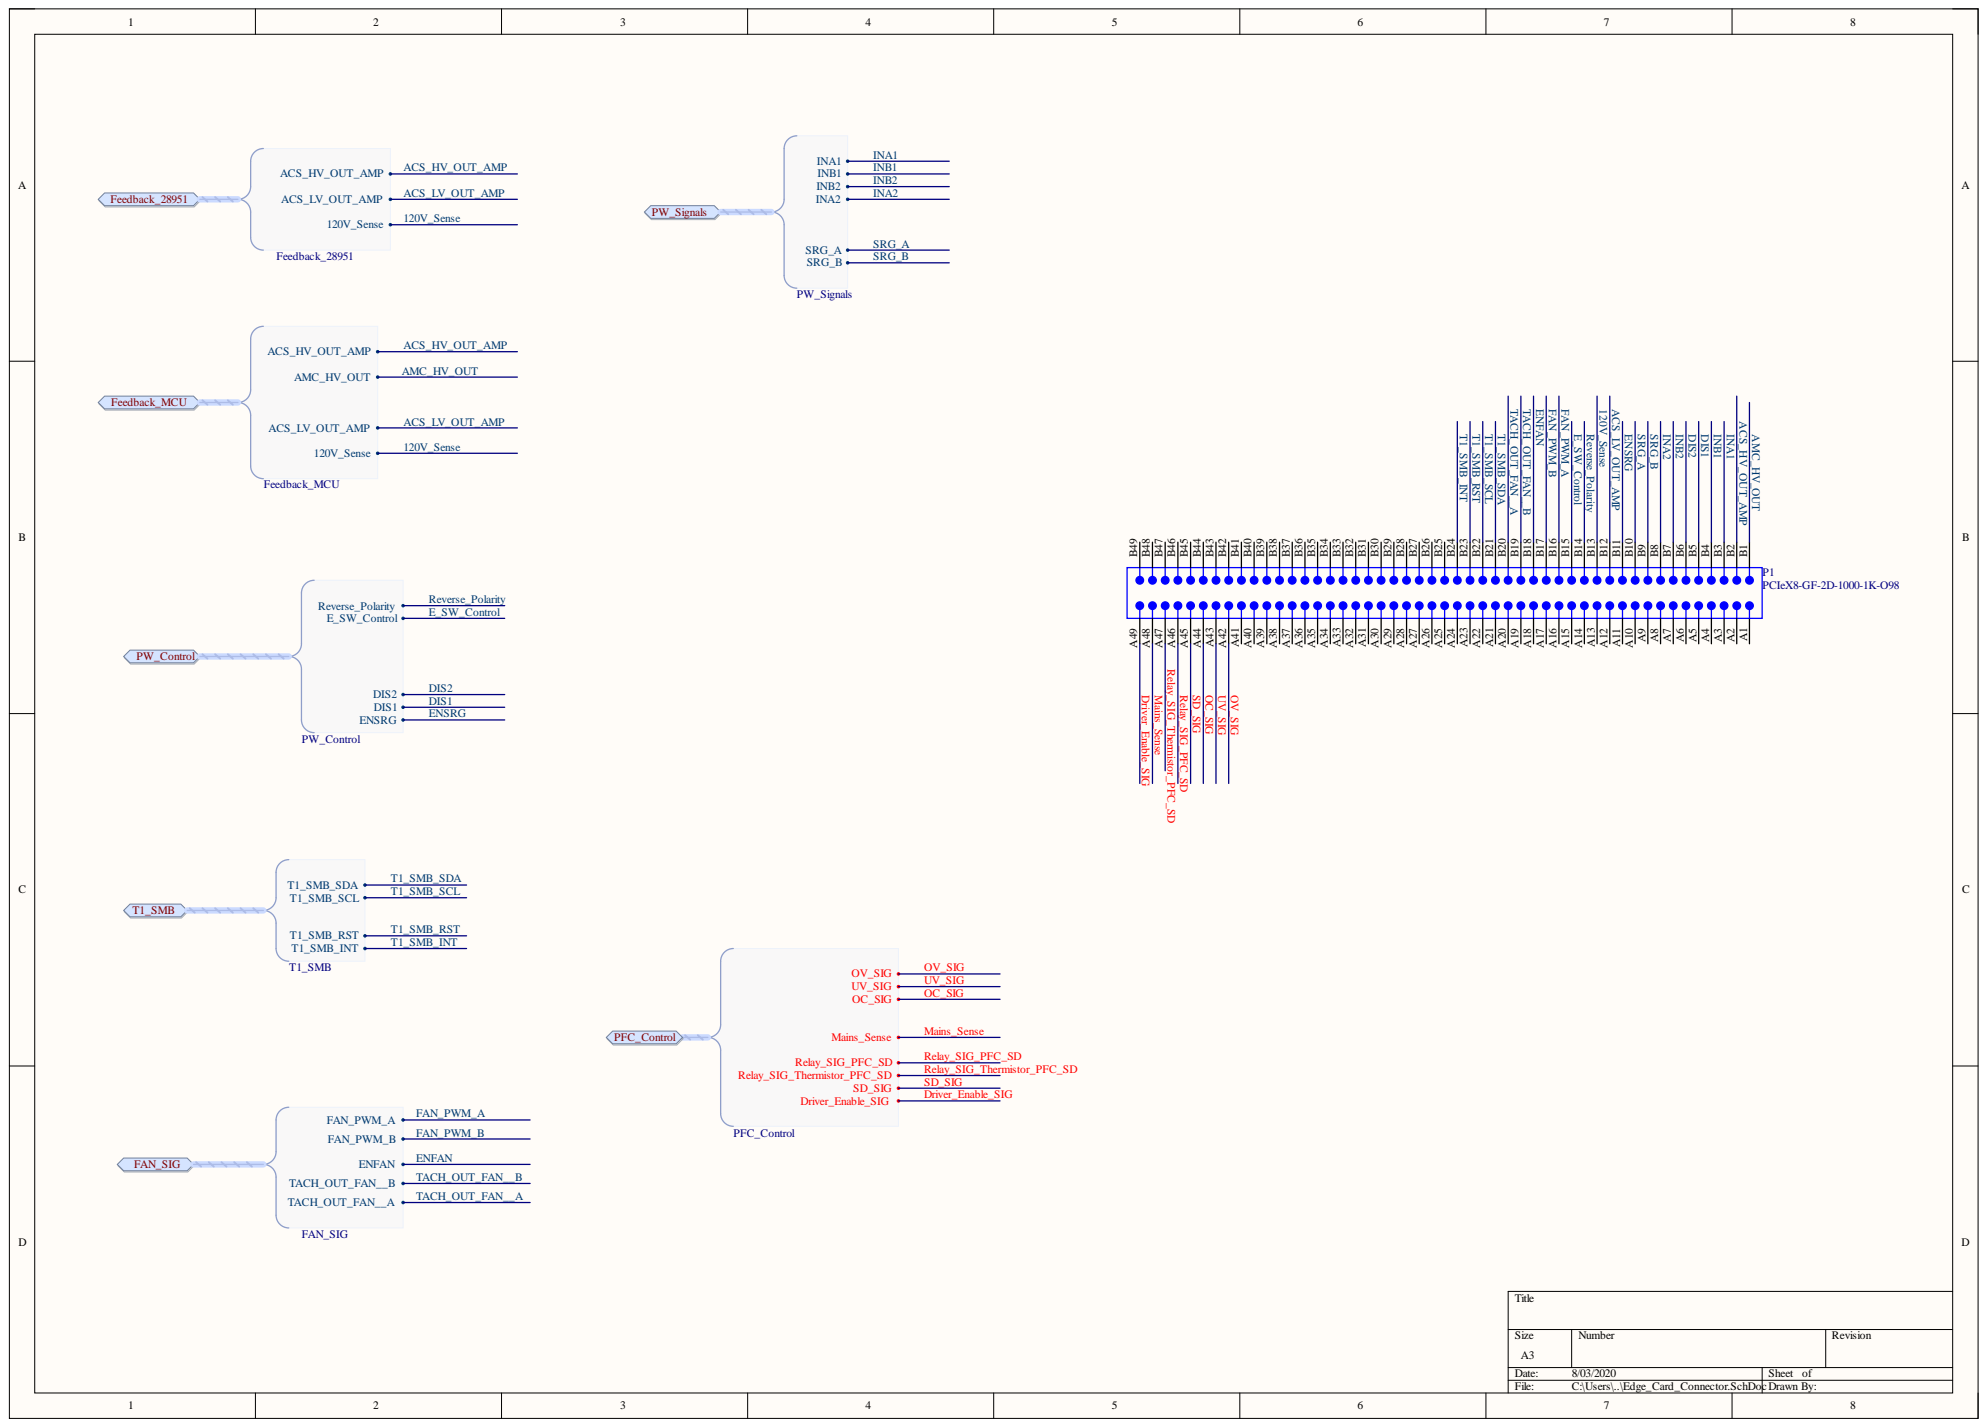
[picture p15: page 1]

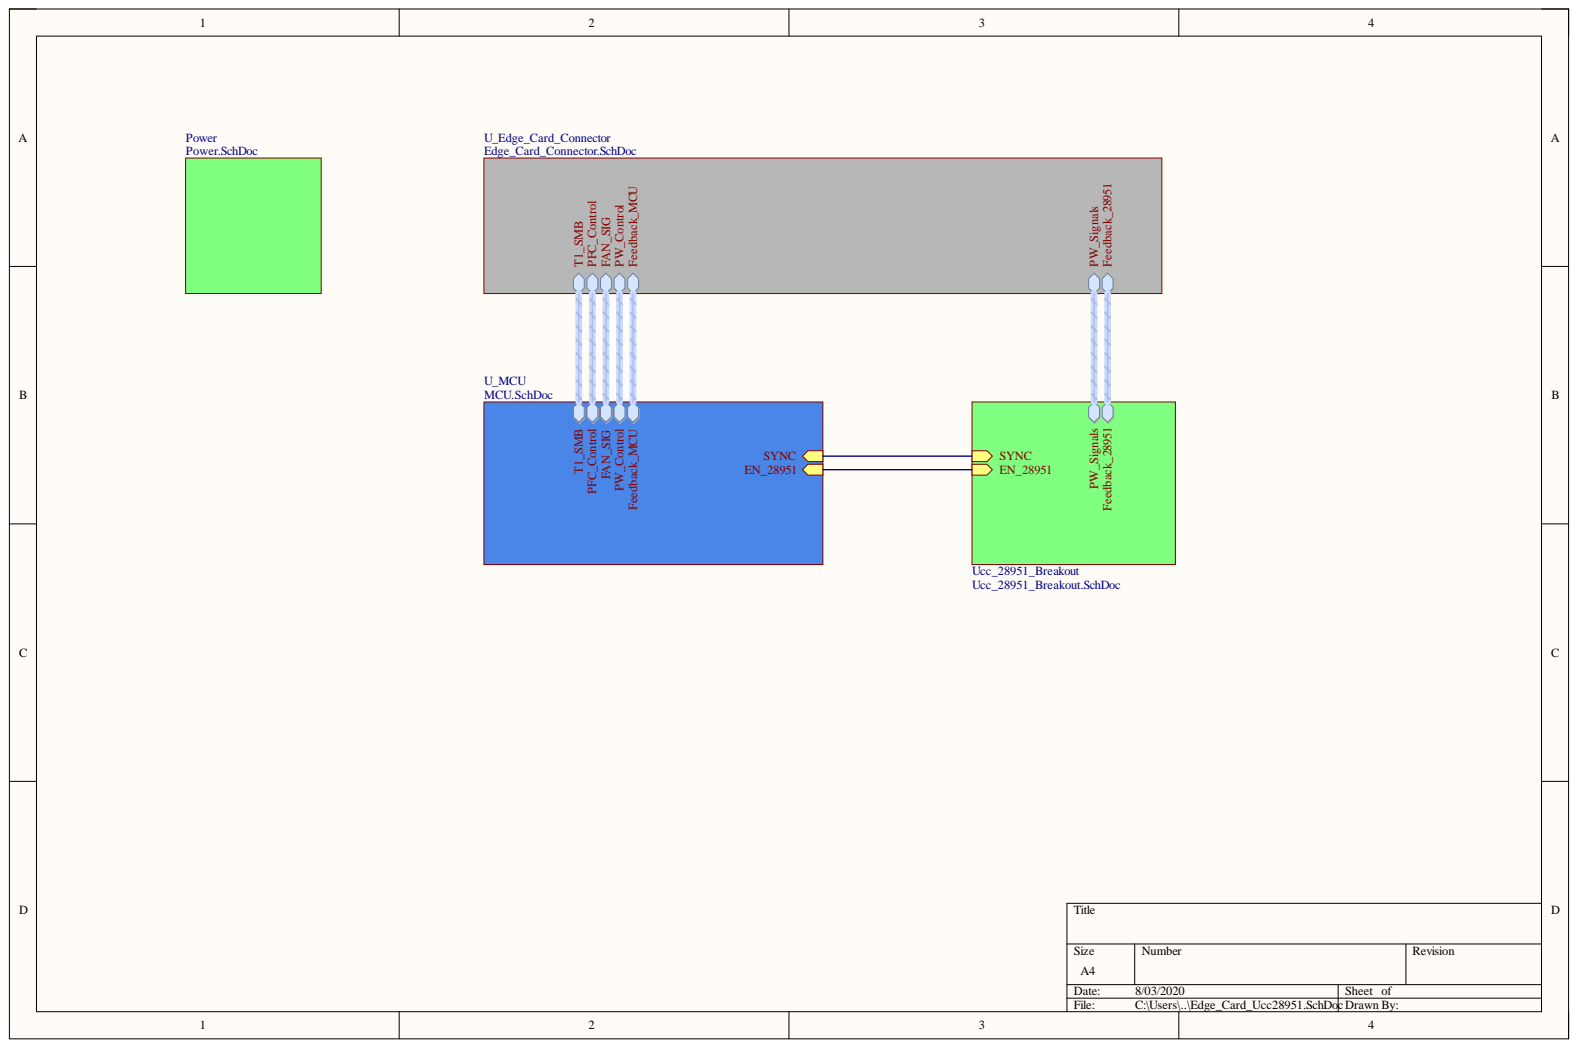
[picture p16: page 2]

Size A4 | Number | Revision

Date: 8/03/2020 | Sheet of
File: C:\Users\..\Edge_Card_Ucc28951.SchDocDrawn By:

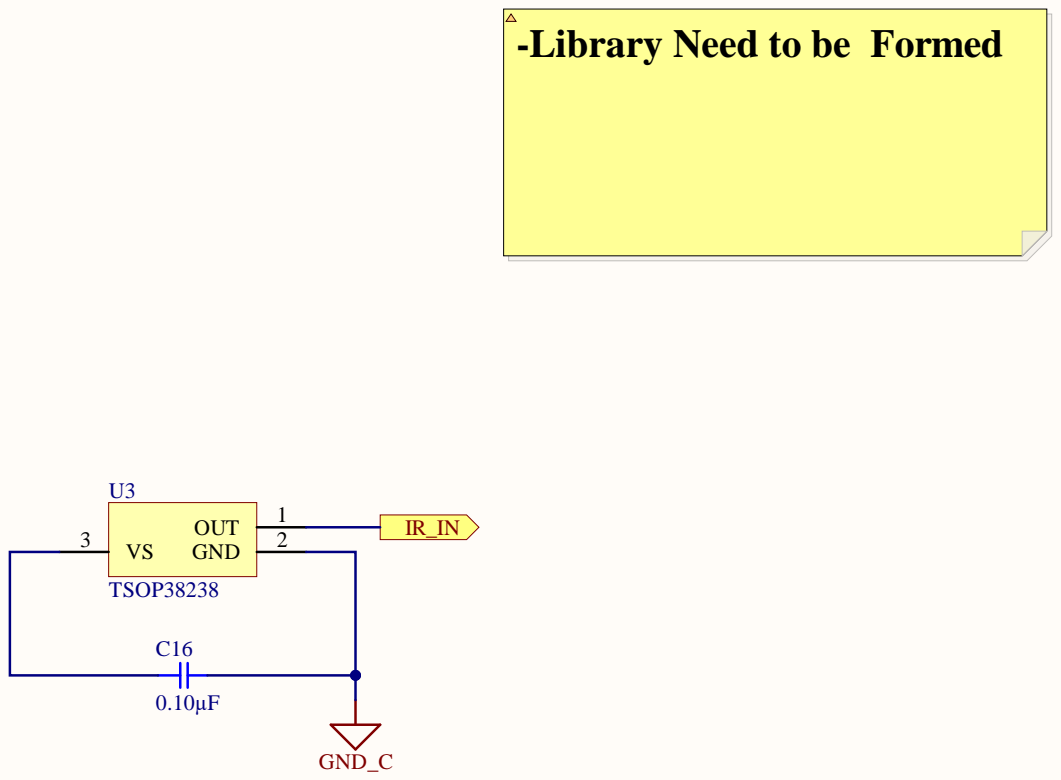
[picture p17: page 3]

-Library Need to be Formed

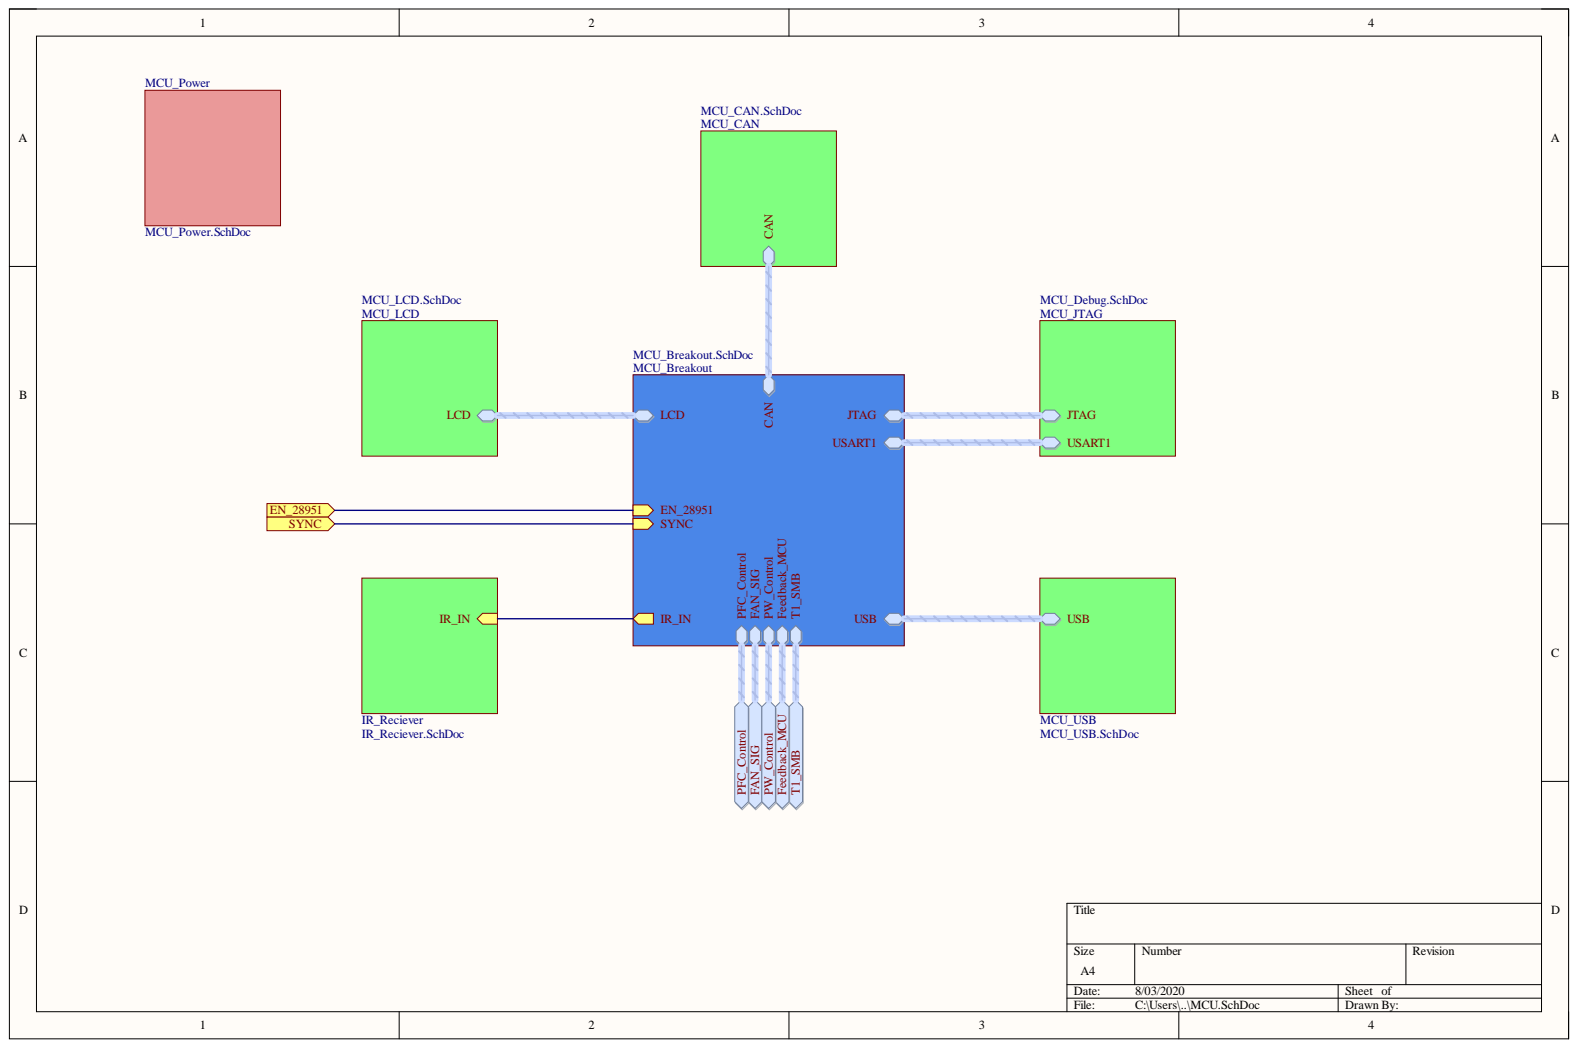
[picture p18: page 4]

S i z e A4 | Numb e r | R e vision

Date : 8/03/202 0 | She et of
F ile : C :\Use rs\. .\MC U . S chDo c | Dr awn By:

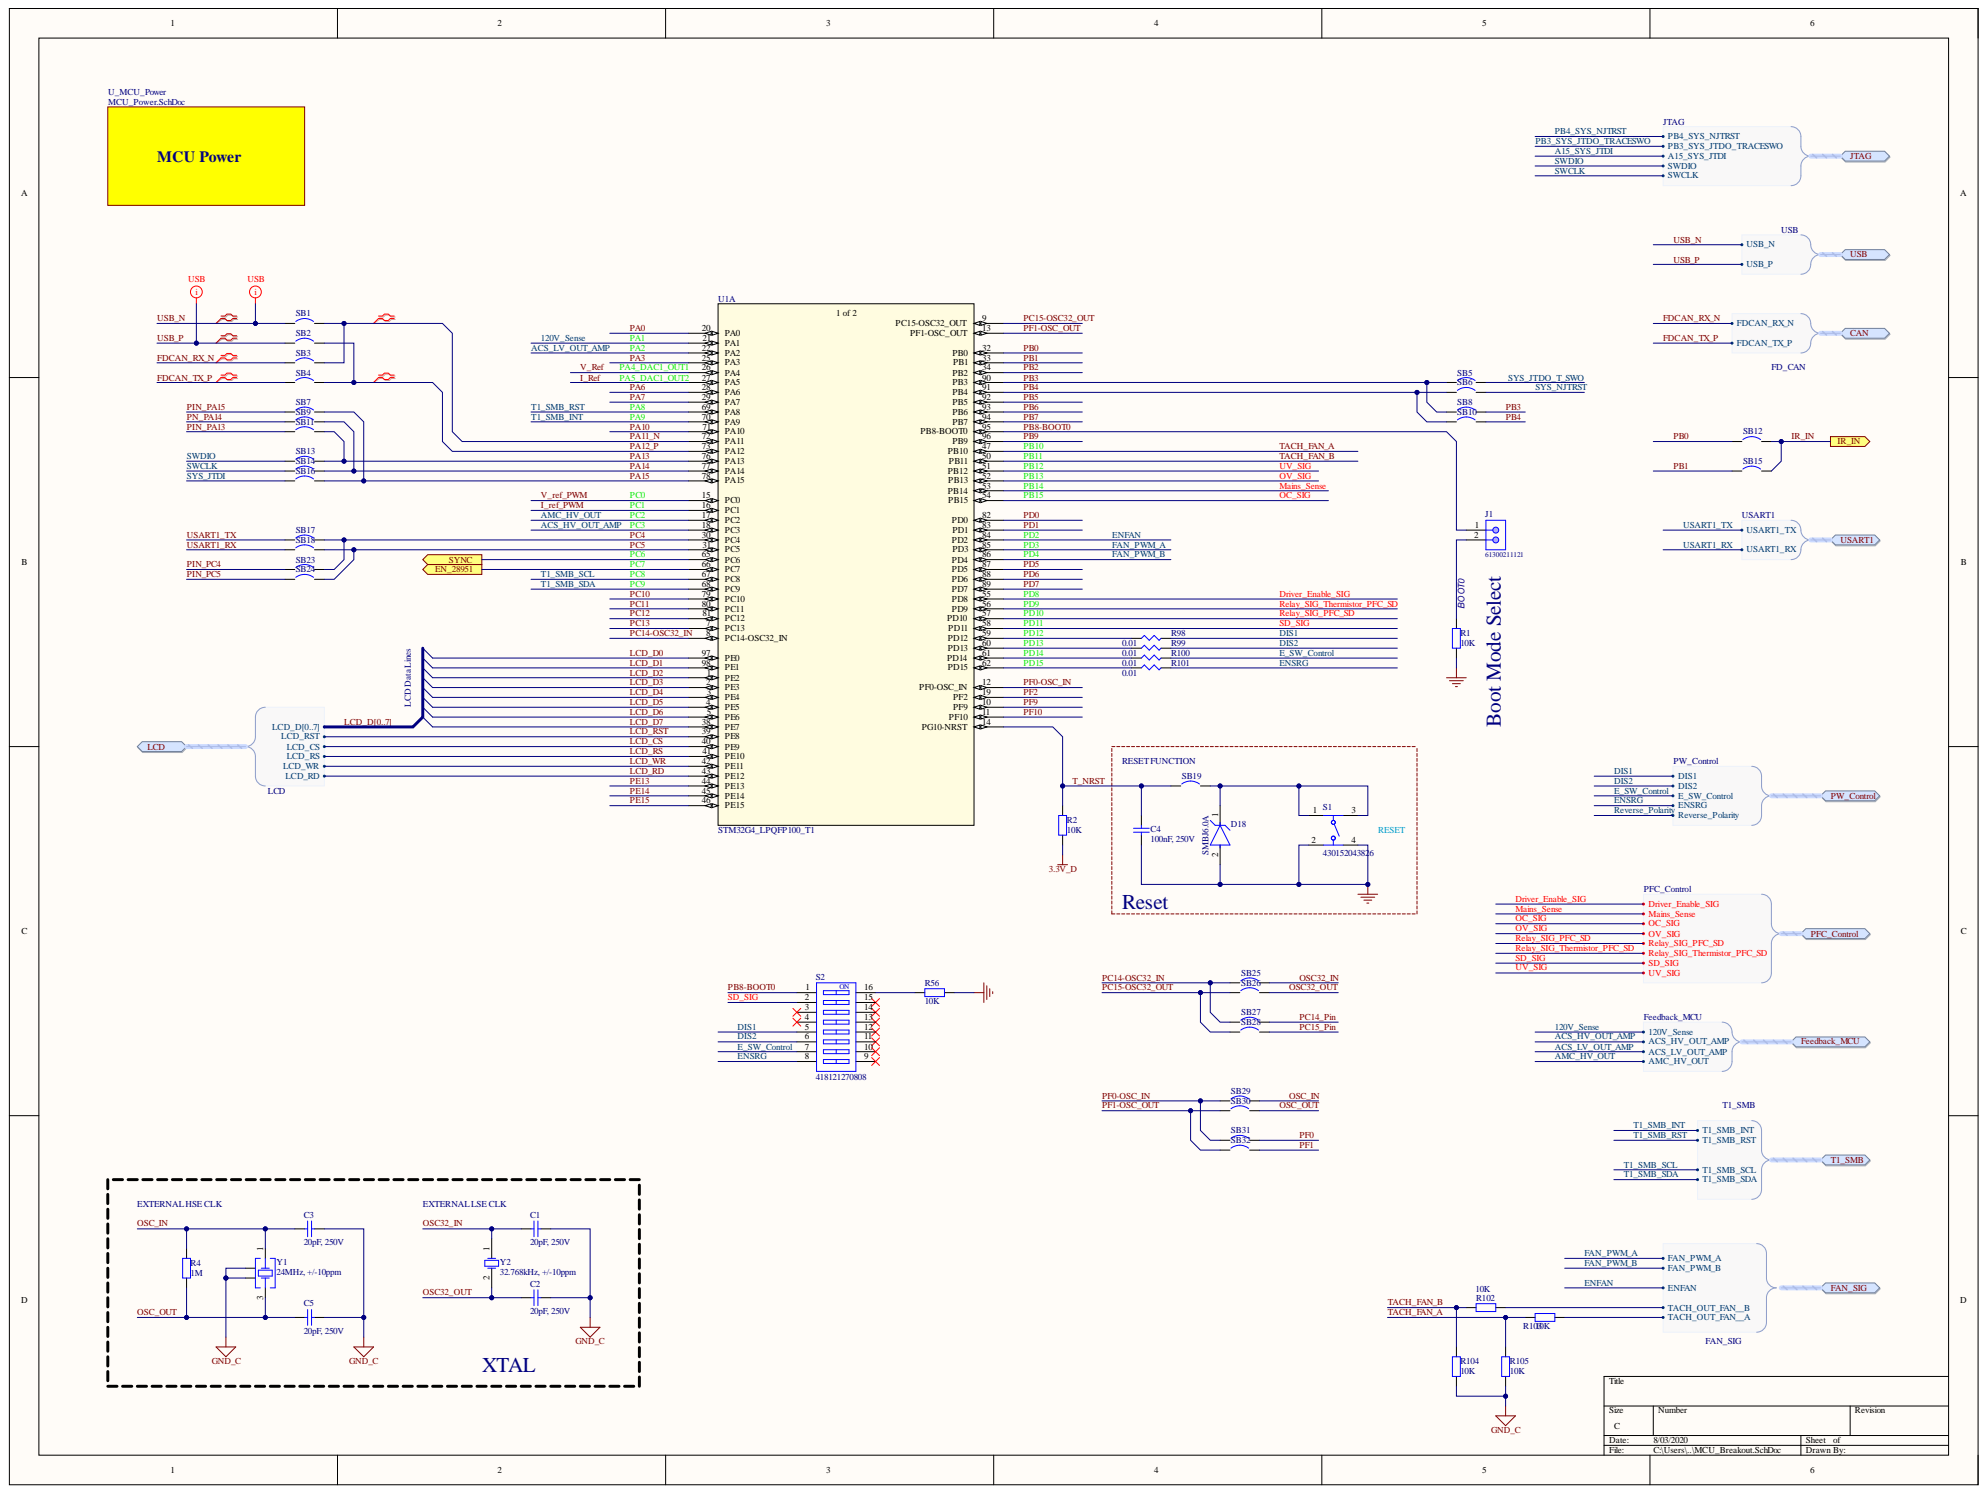
[picture p19: page 5]

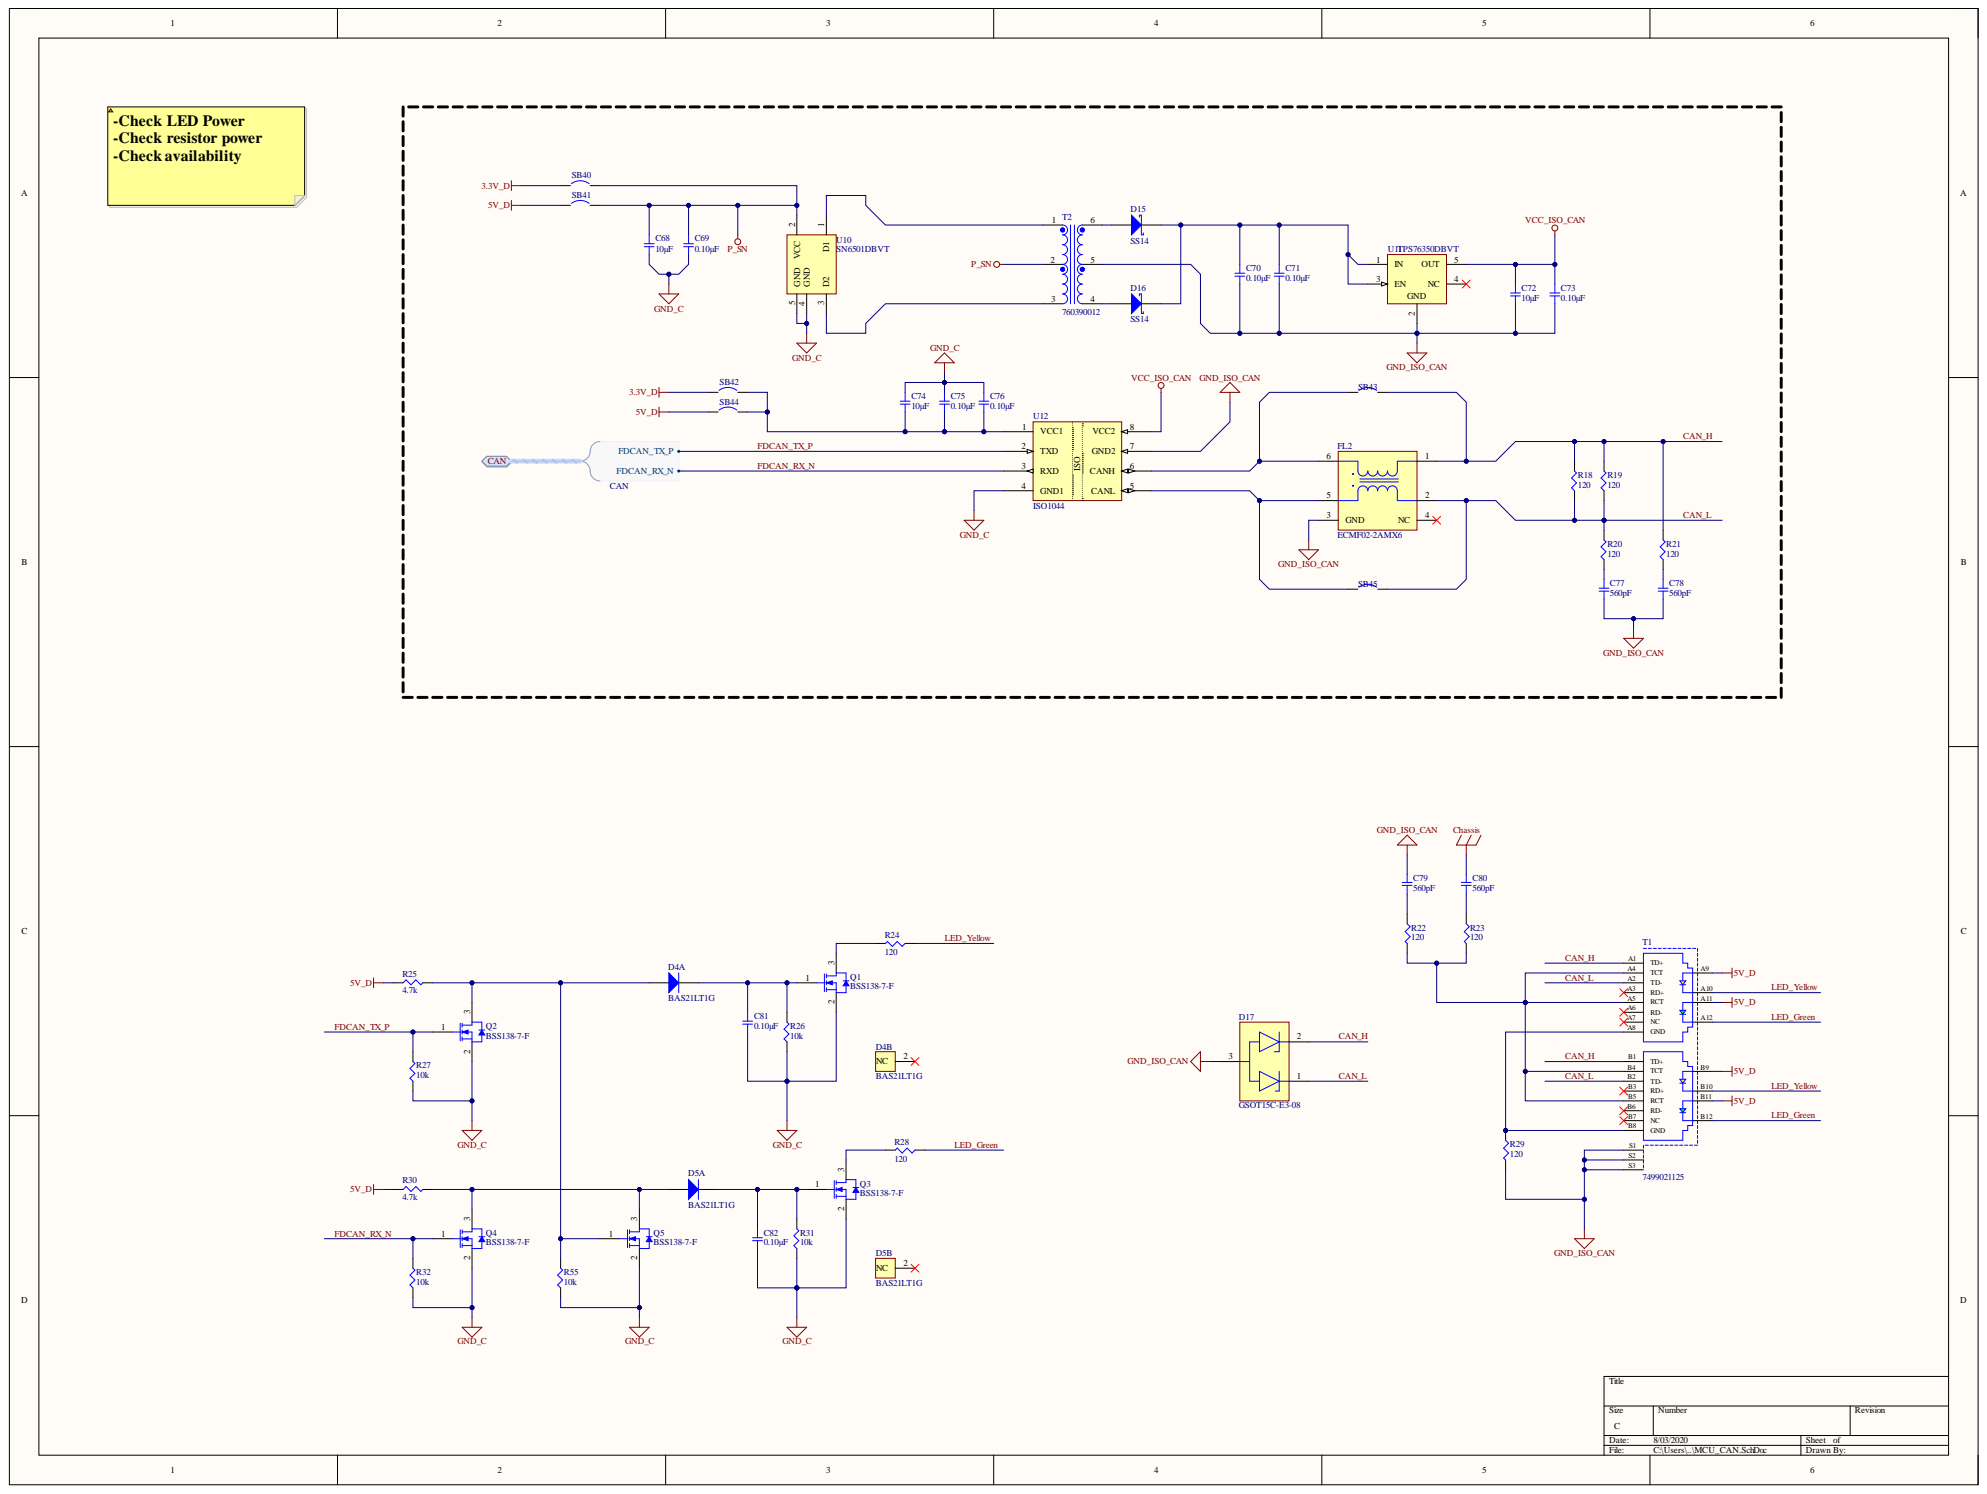
[picture p20: page 6]

CAN_H
CAN_L | | TD- B2 TCT B4 RD+ B3

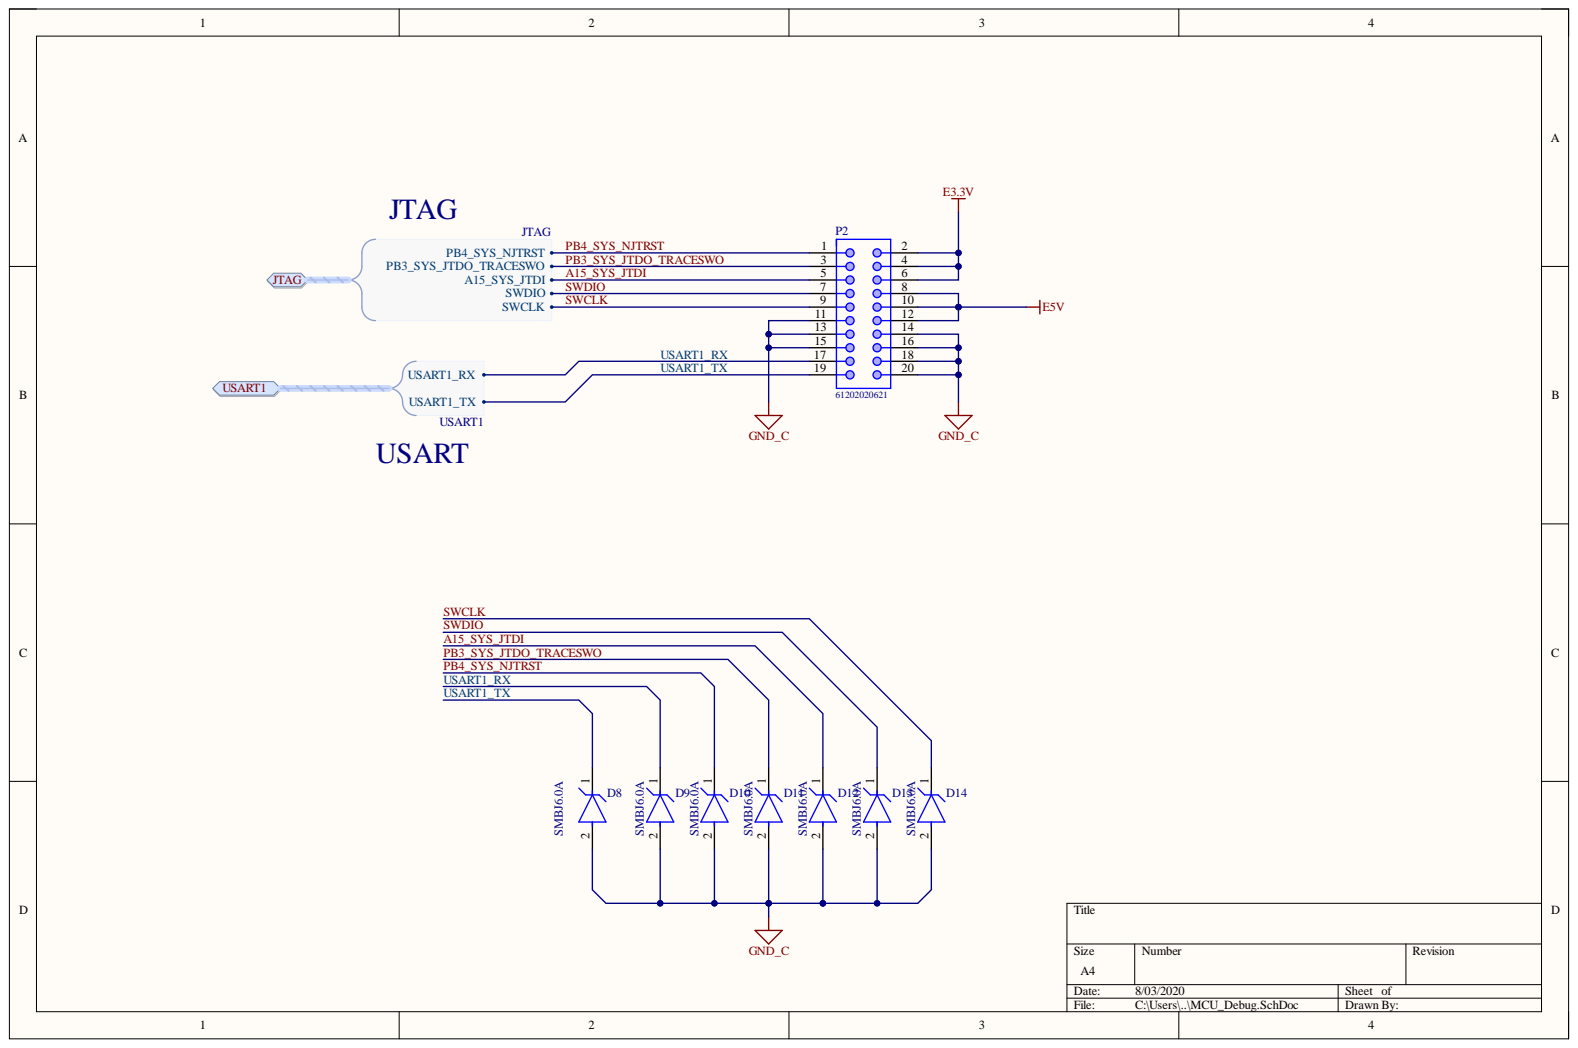
[picture p21: page 7]

Size A4 | Number | Revision

Date: 8/03/2020 | Sheet of
File: C:\Users\..\MCU_Debug.SchDoc | Drawn By:

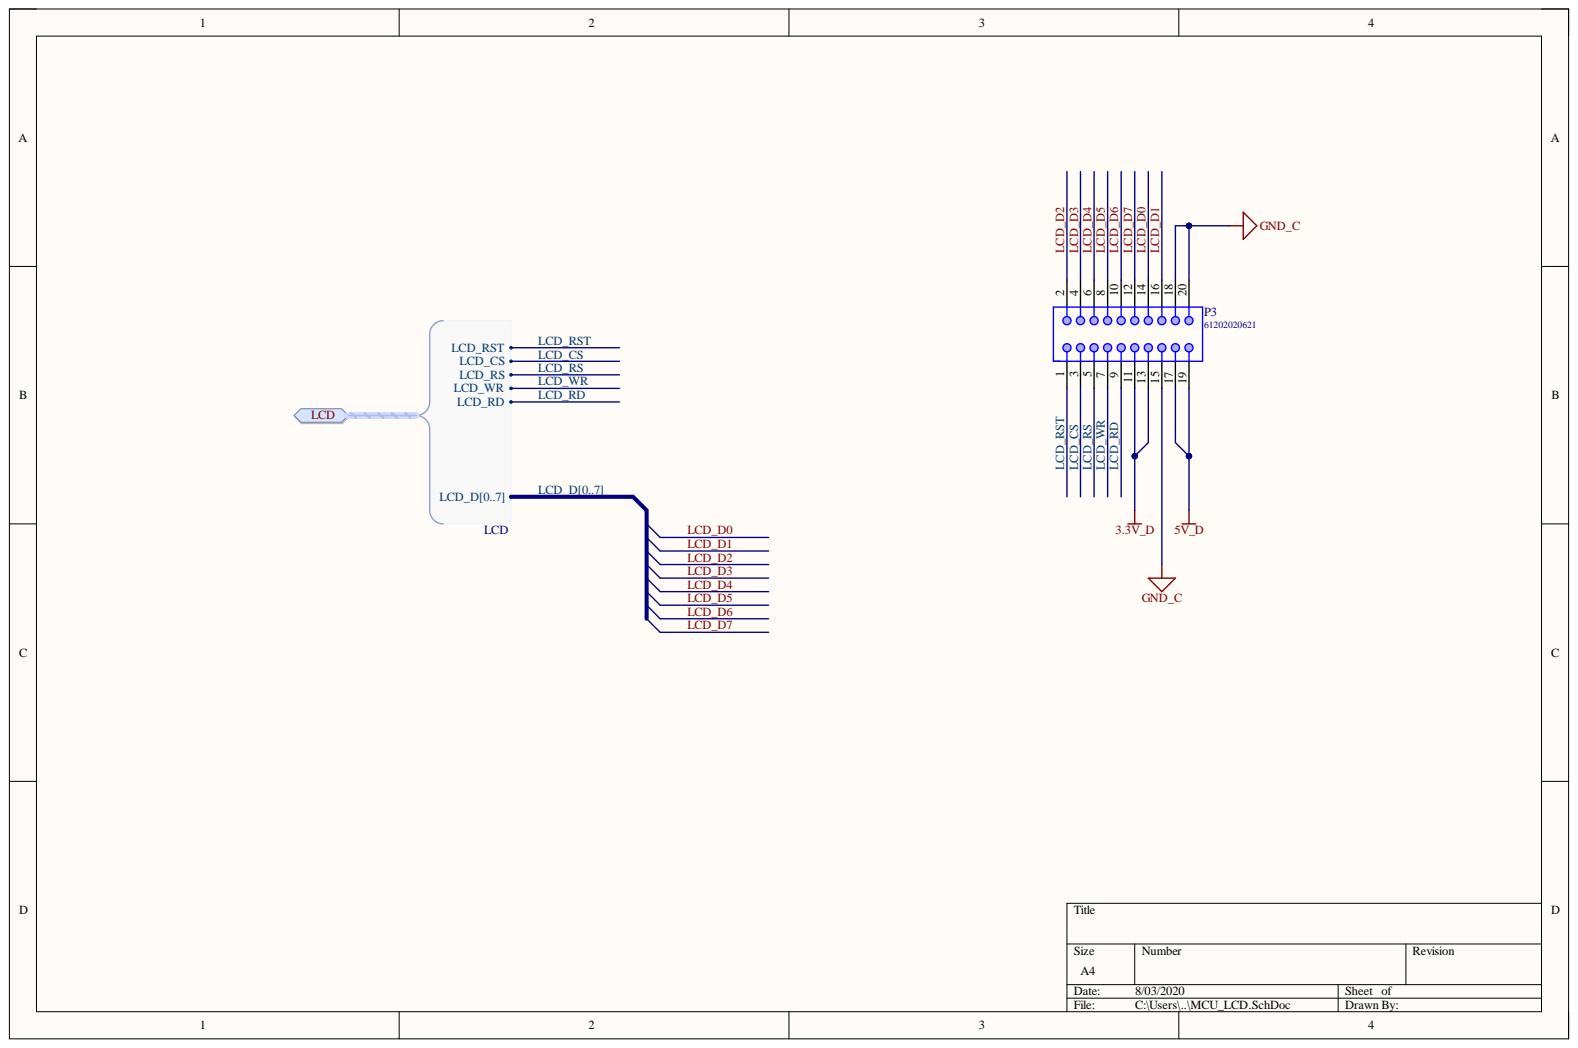
[picture p22: page 8]

S i z e A4 | Numb e r | R e vision

Date : 8/03/202 0 | She et of
F ile : C :\Use rs\. .\MC U_L CD. S chDo c | Dr awn By:

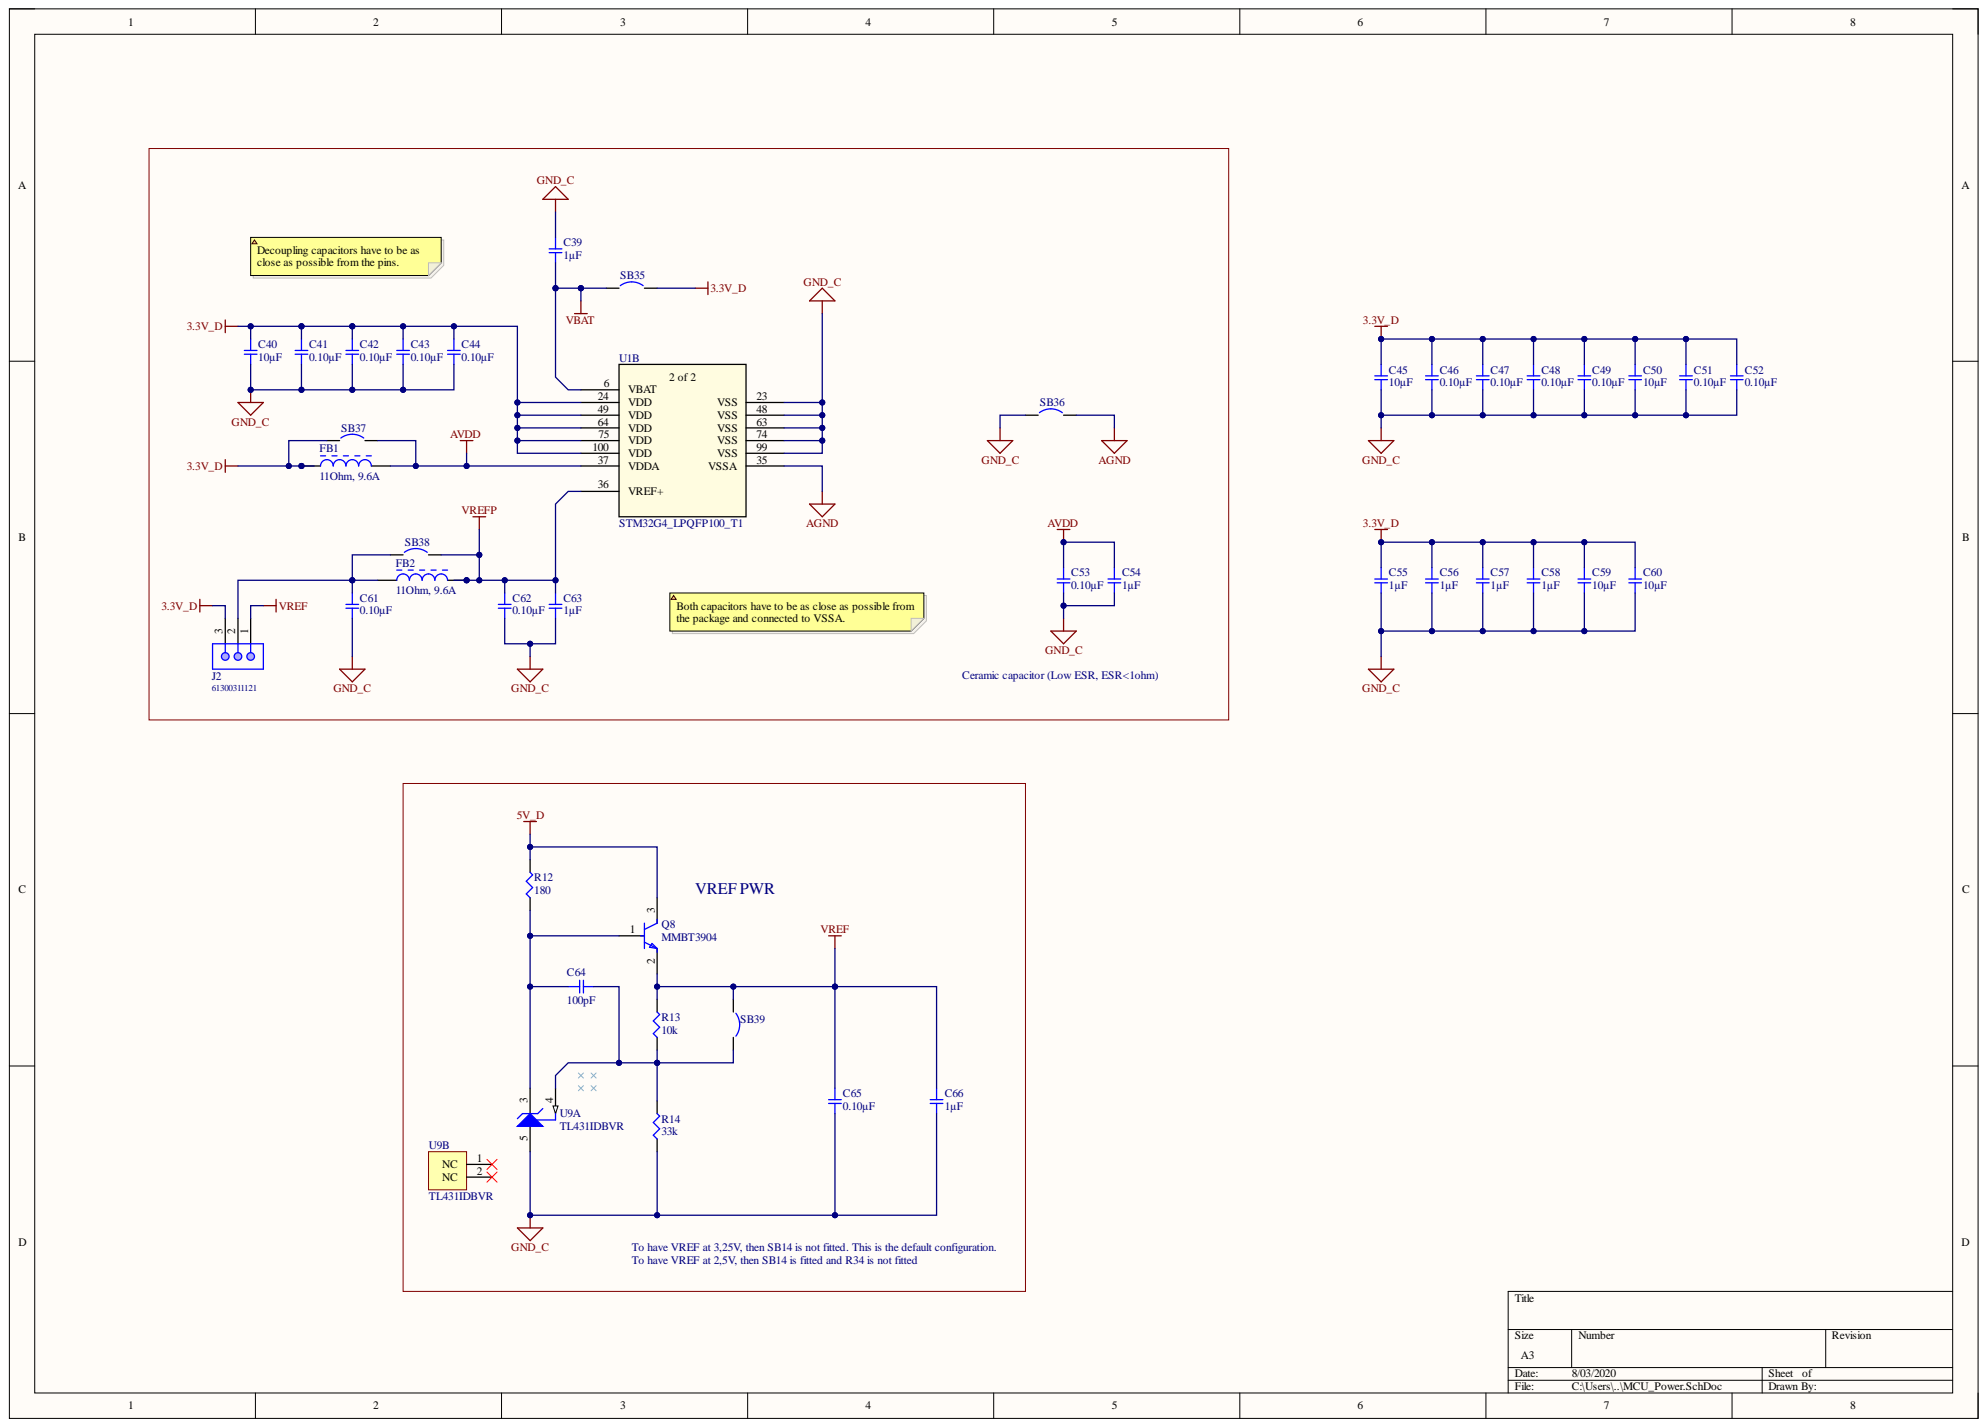
[picture p23: page 9]

Decoupling capacitors have to be as
close as possible from the pins.

Both capacitors have to be as close as possible from
the package and connected to VSSA.

Ceramic capacitor (Low ESR, ESR<1ohm)

To have VREF at 3,25V, then SB14 is not fitted. This is the default configuration.
To have VREF at 2,5V, then SB14 is fitted and R34 is not fitted

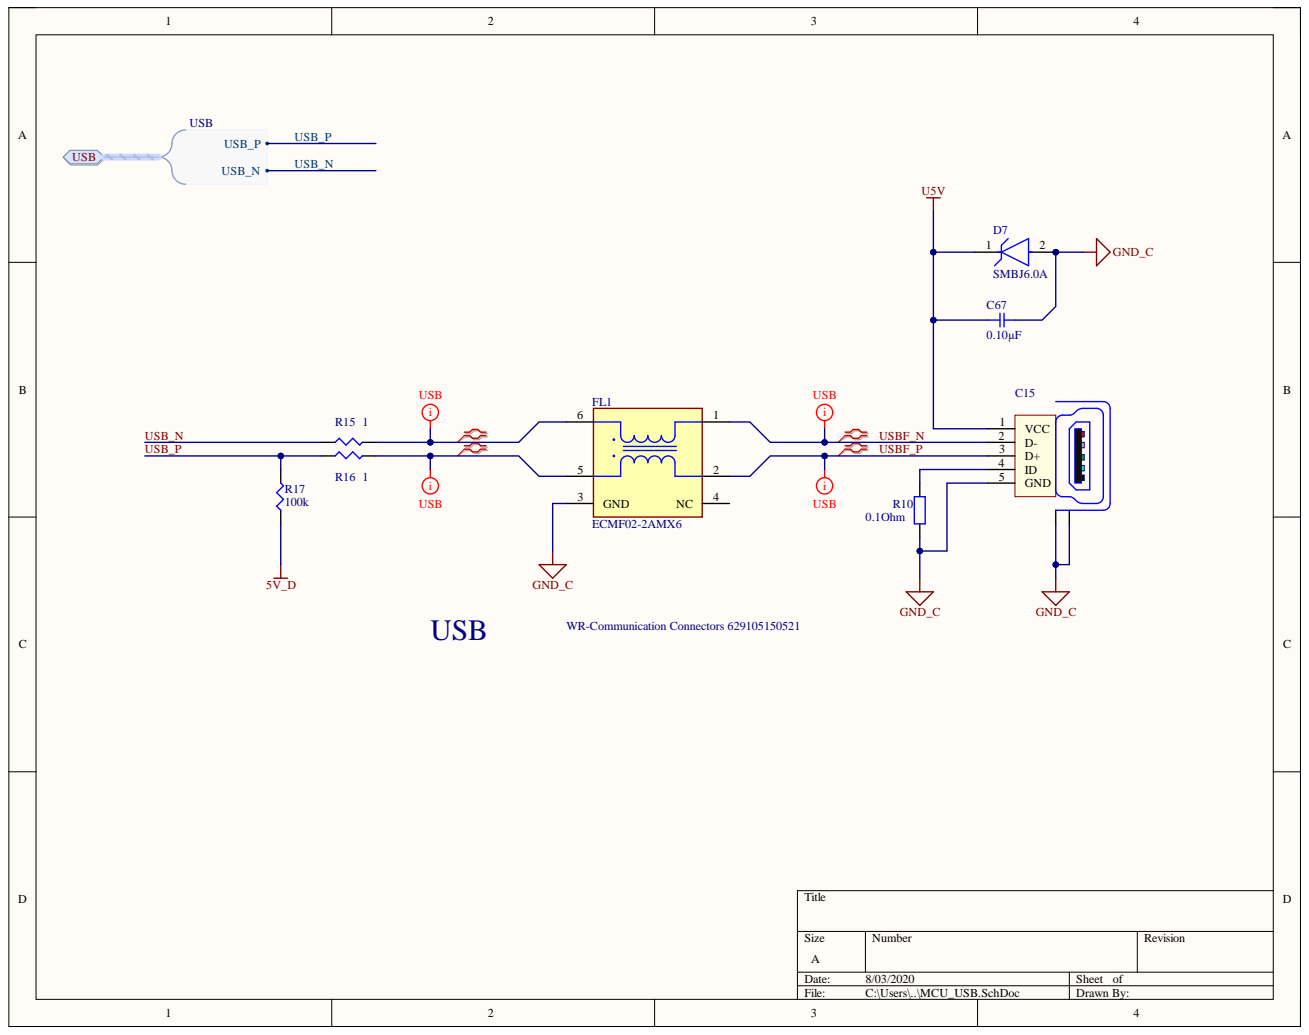
[picture p24: page 10]

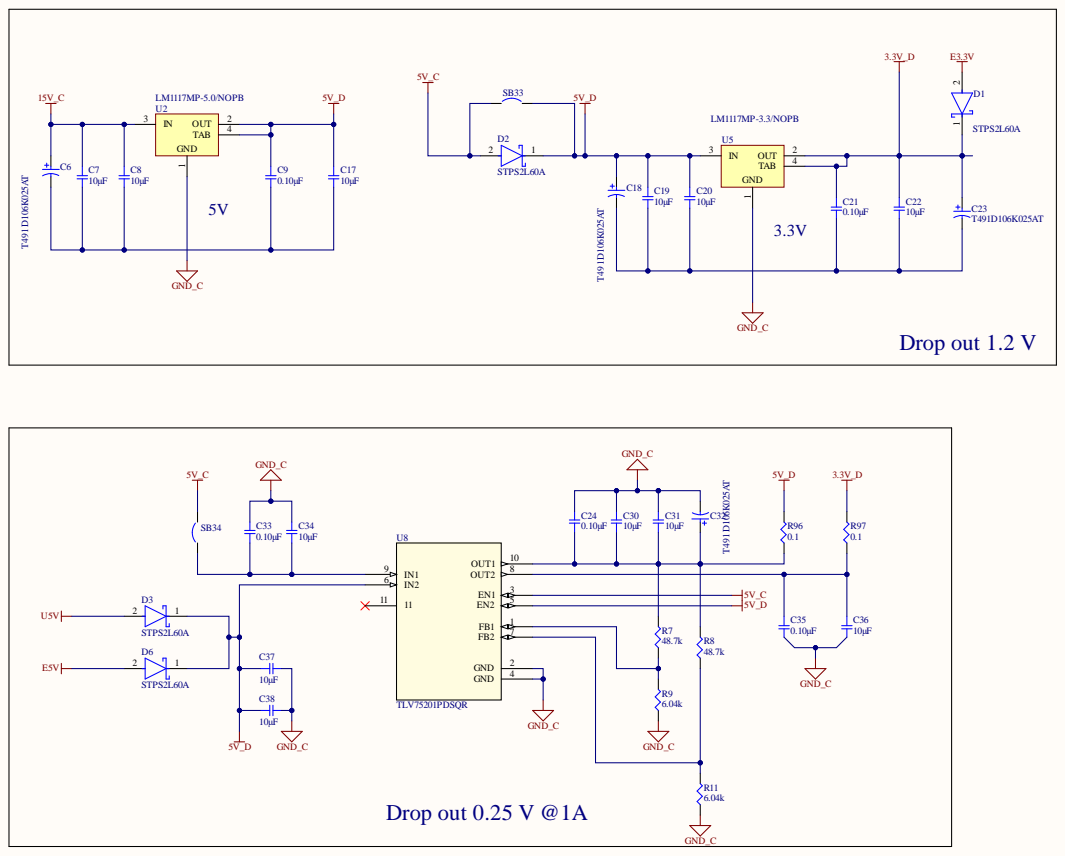
[picture p25: page 11]

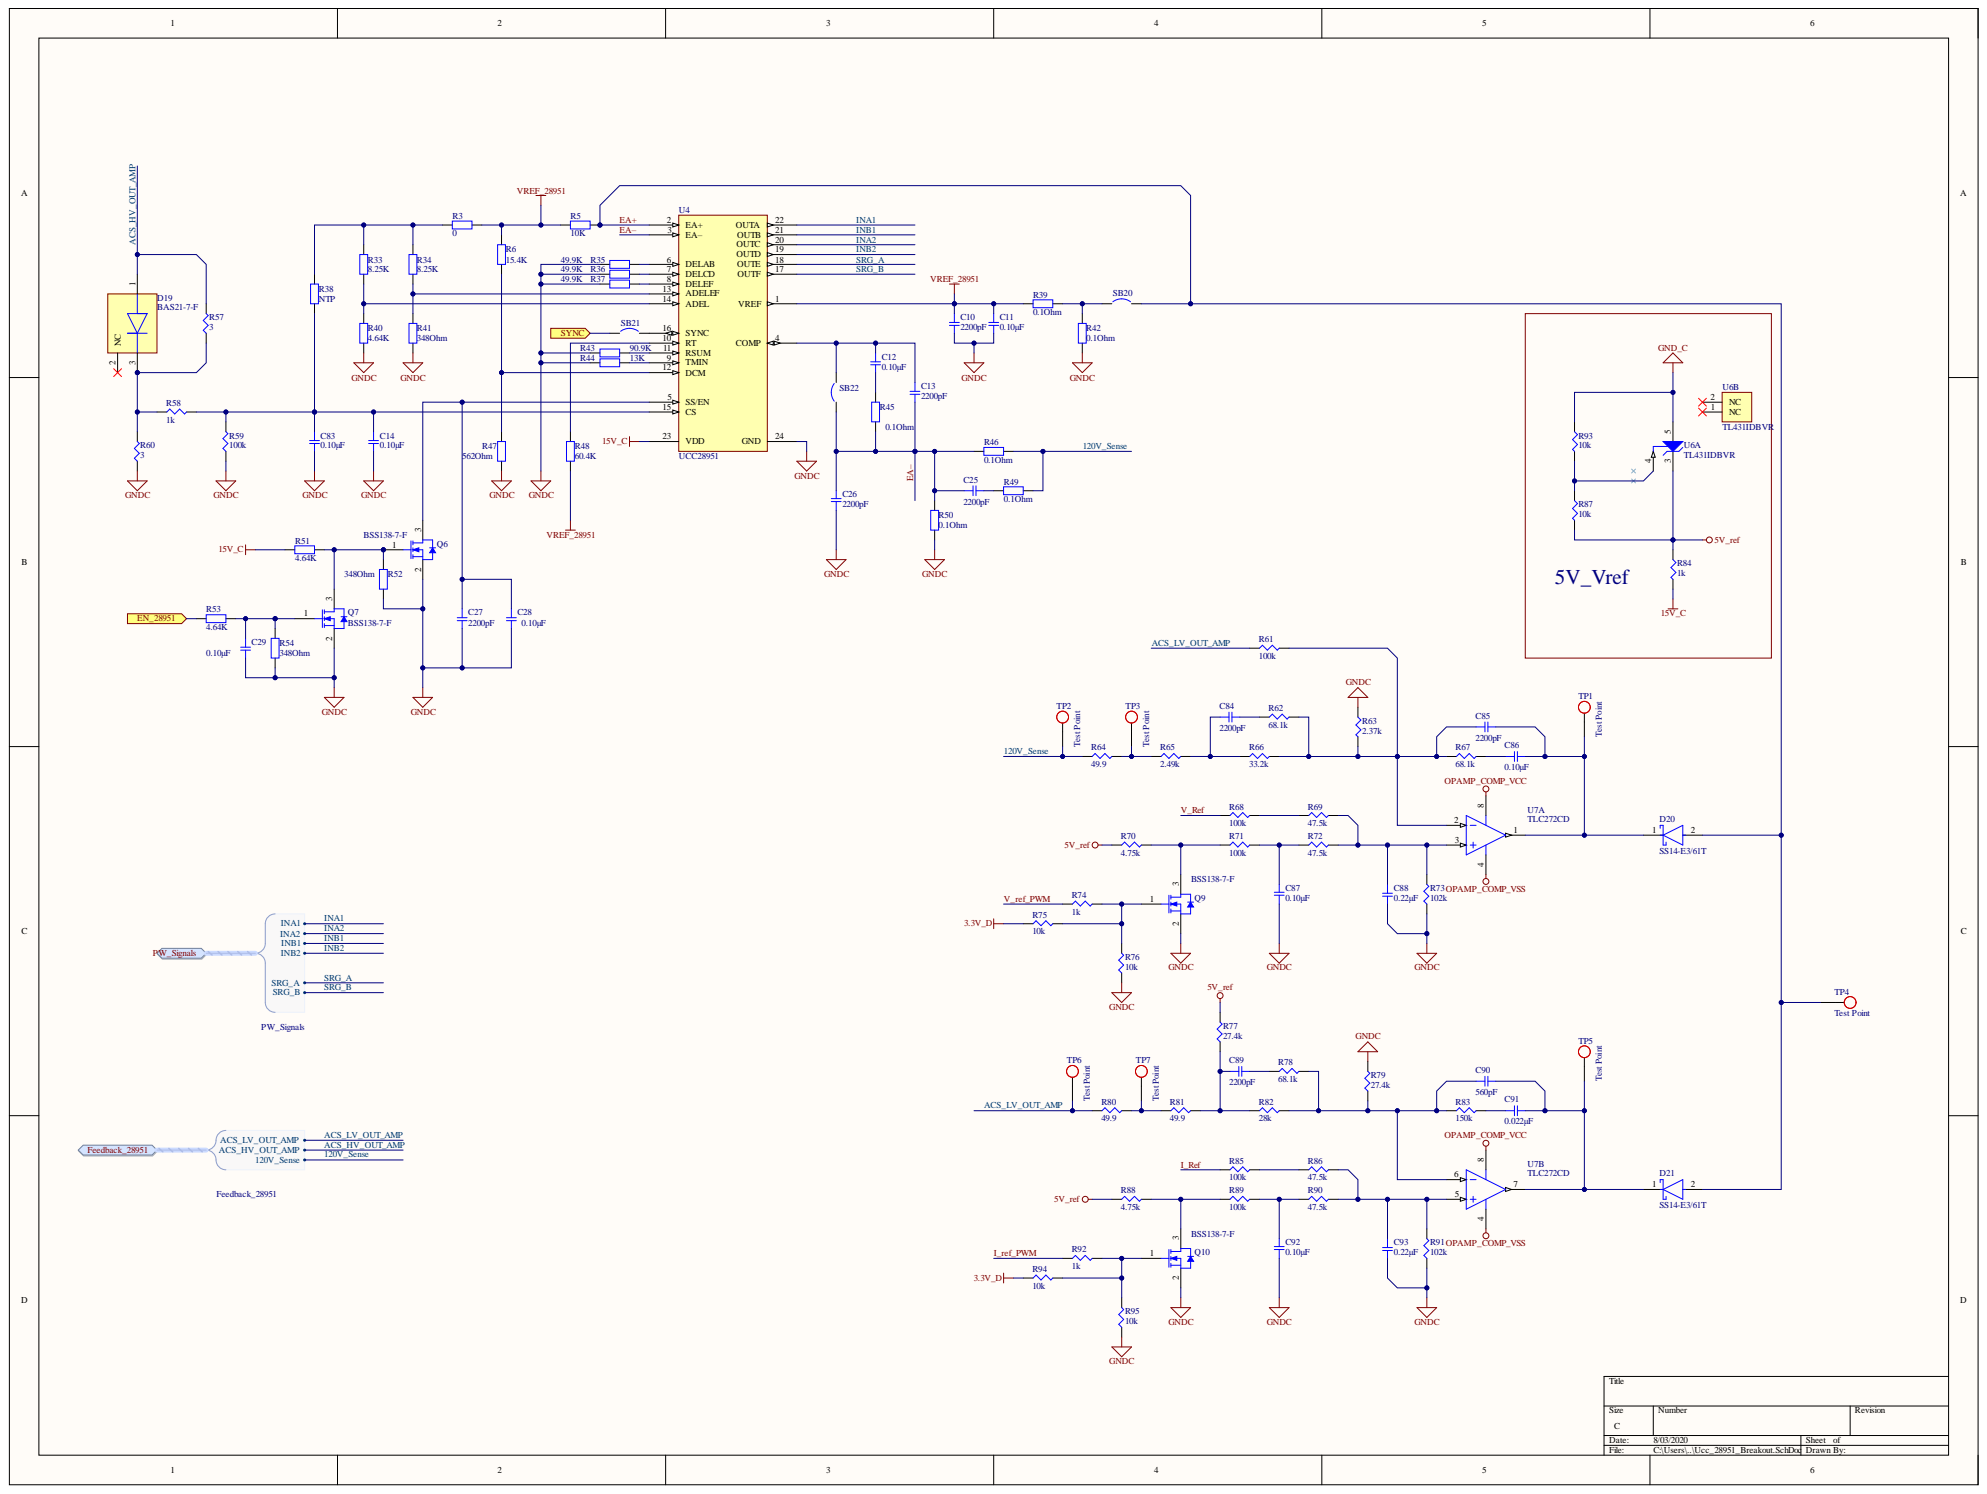
[picture p26: page 12]

R43 90.9K R44 13K | TMIN 9 DCM 12

SS/EN 5
CS 15 VDD 23
