g-rahul/5KW_OBC/Schematic_PDF/Power Board UCC28951.pdf

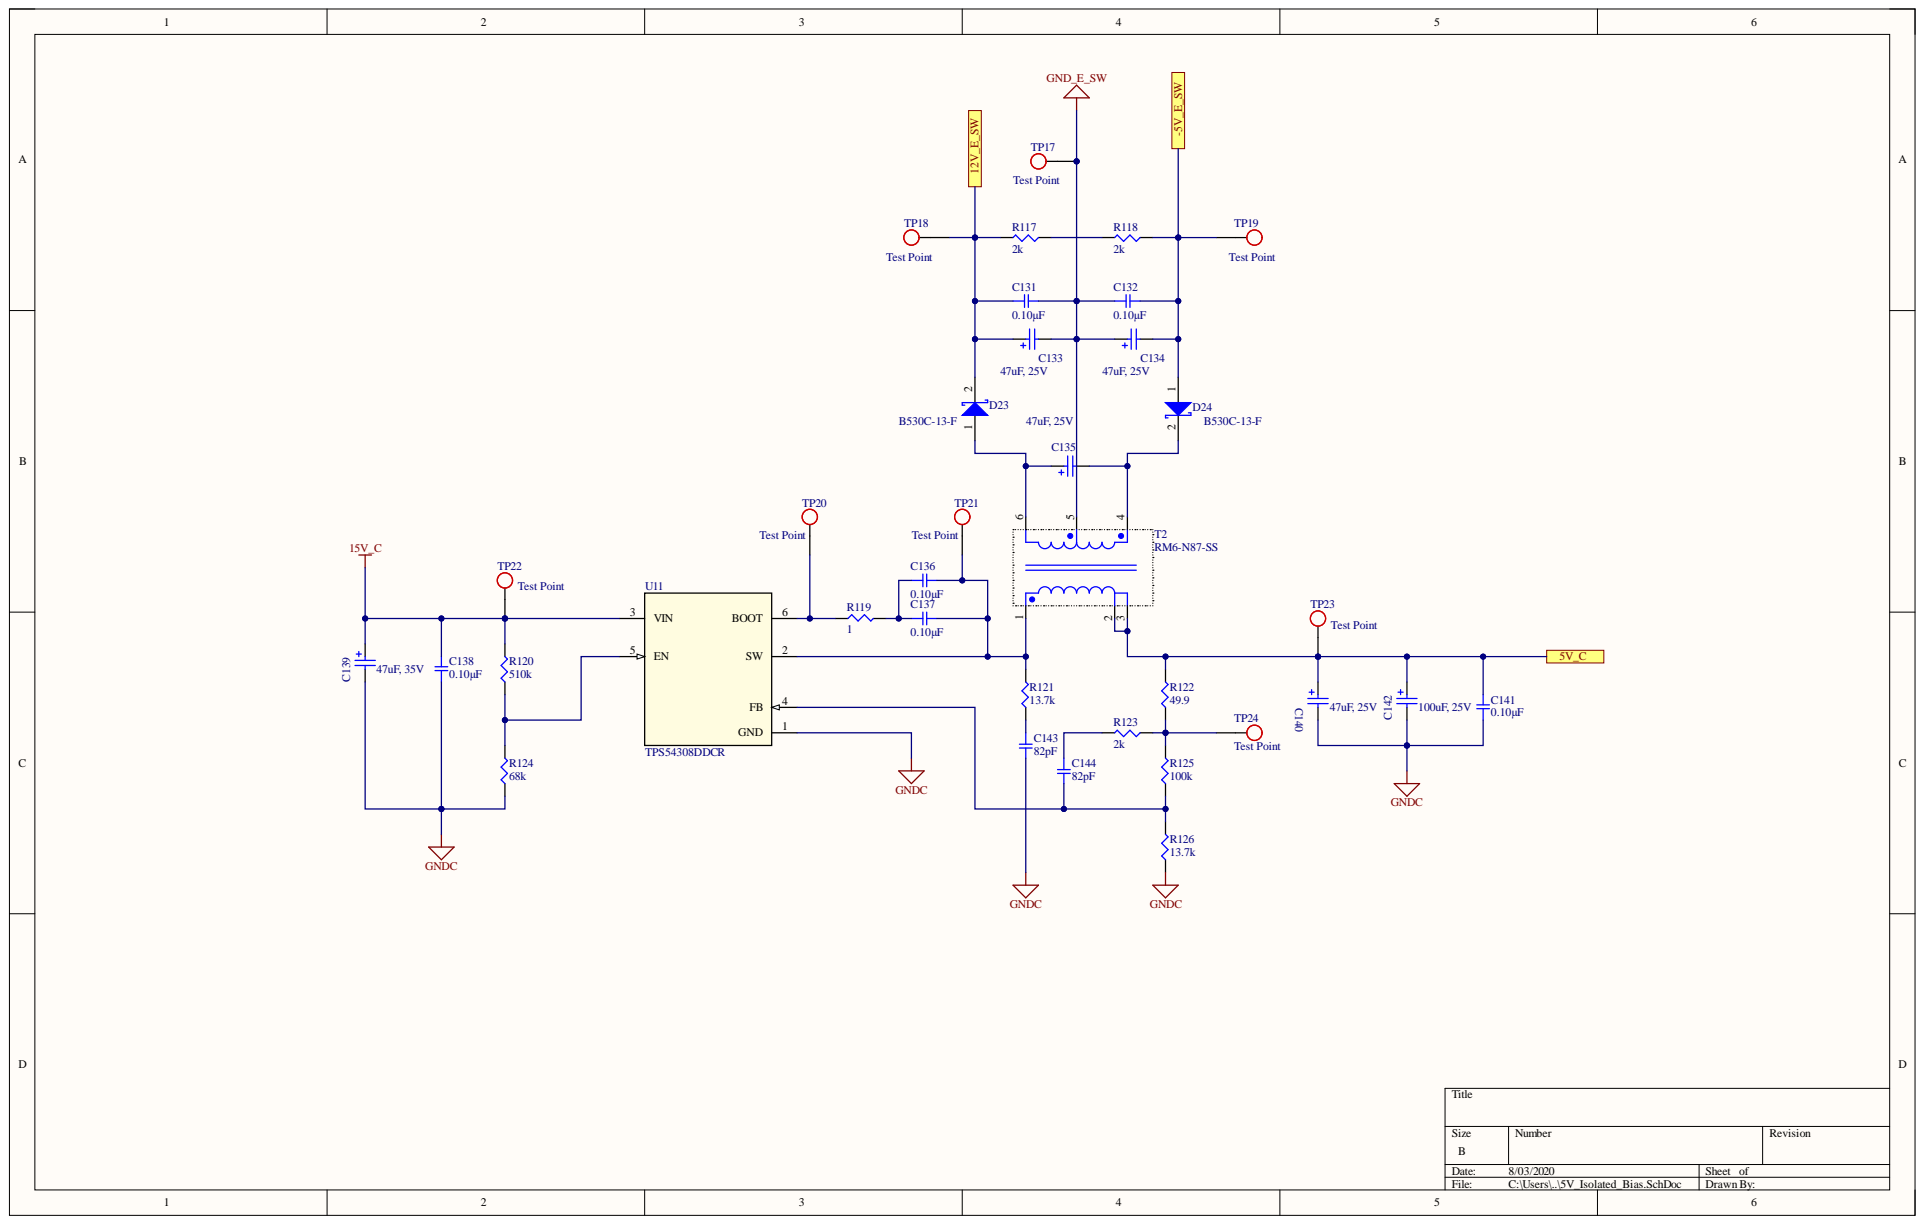
[picture p27: page 1]

Si z e | N umber | Revi s i on

e : 8/03/ 20 20 | Sheet of
Fi l e : C : \User s \..\5V_I solated_B ias.Sch Do c | D raw n B y :

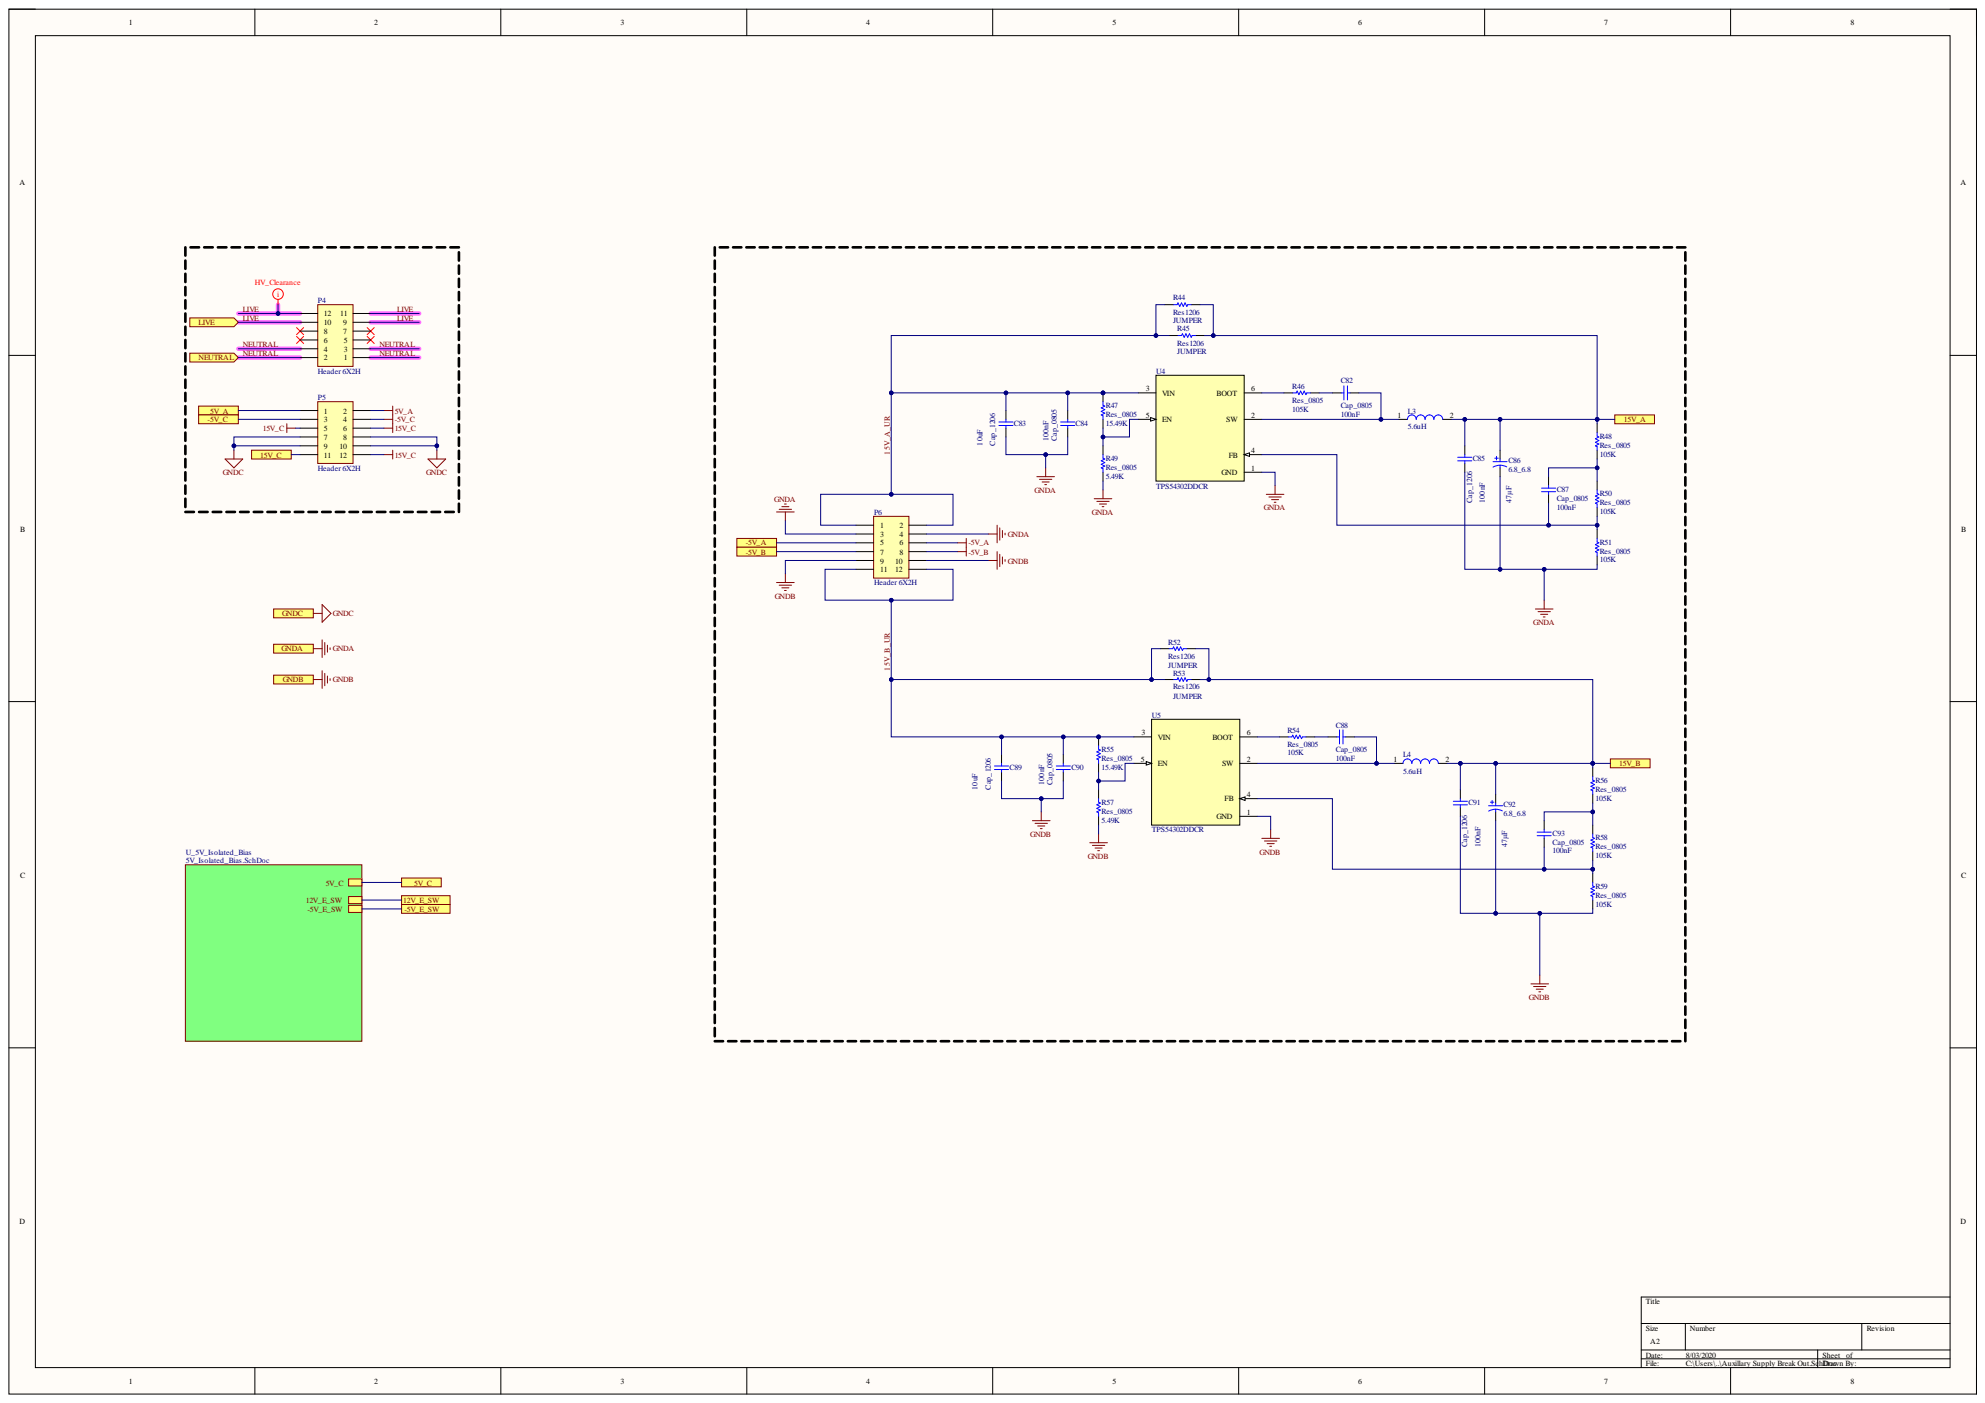
[picture p28: page 2]

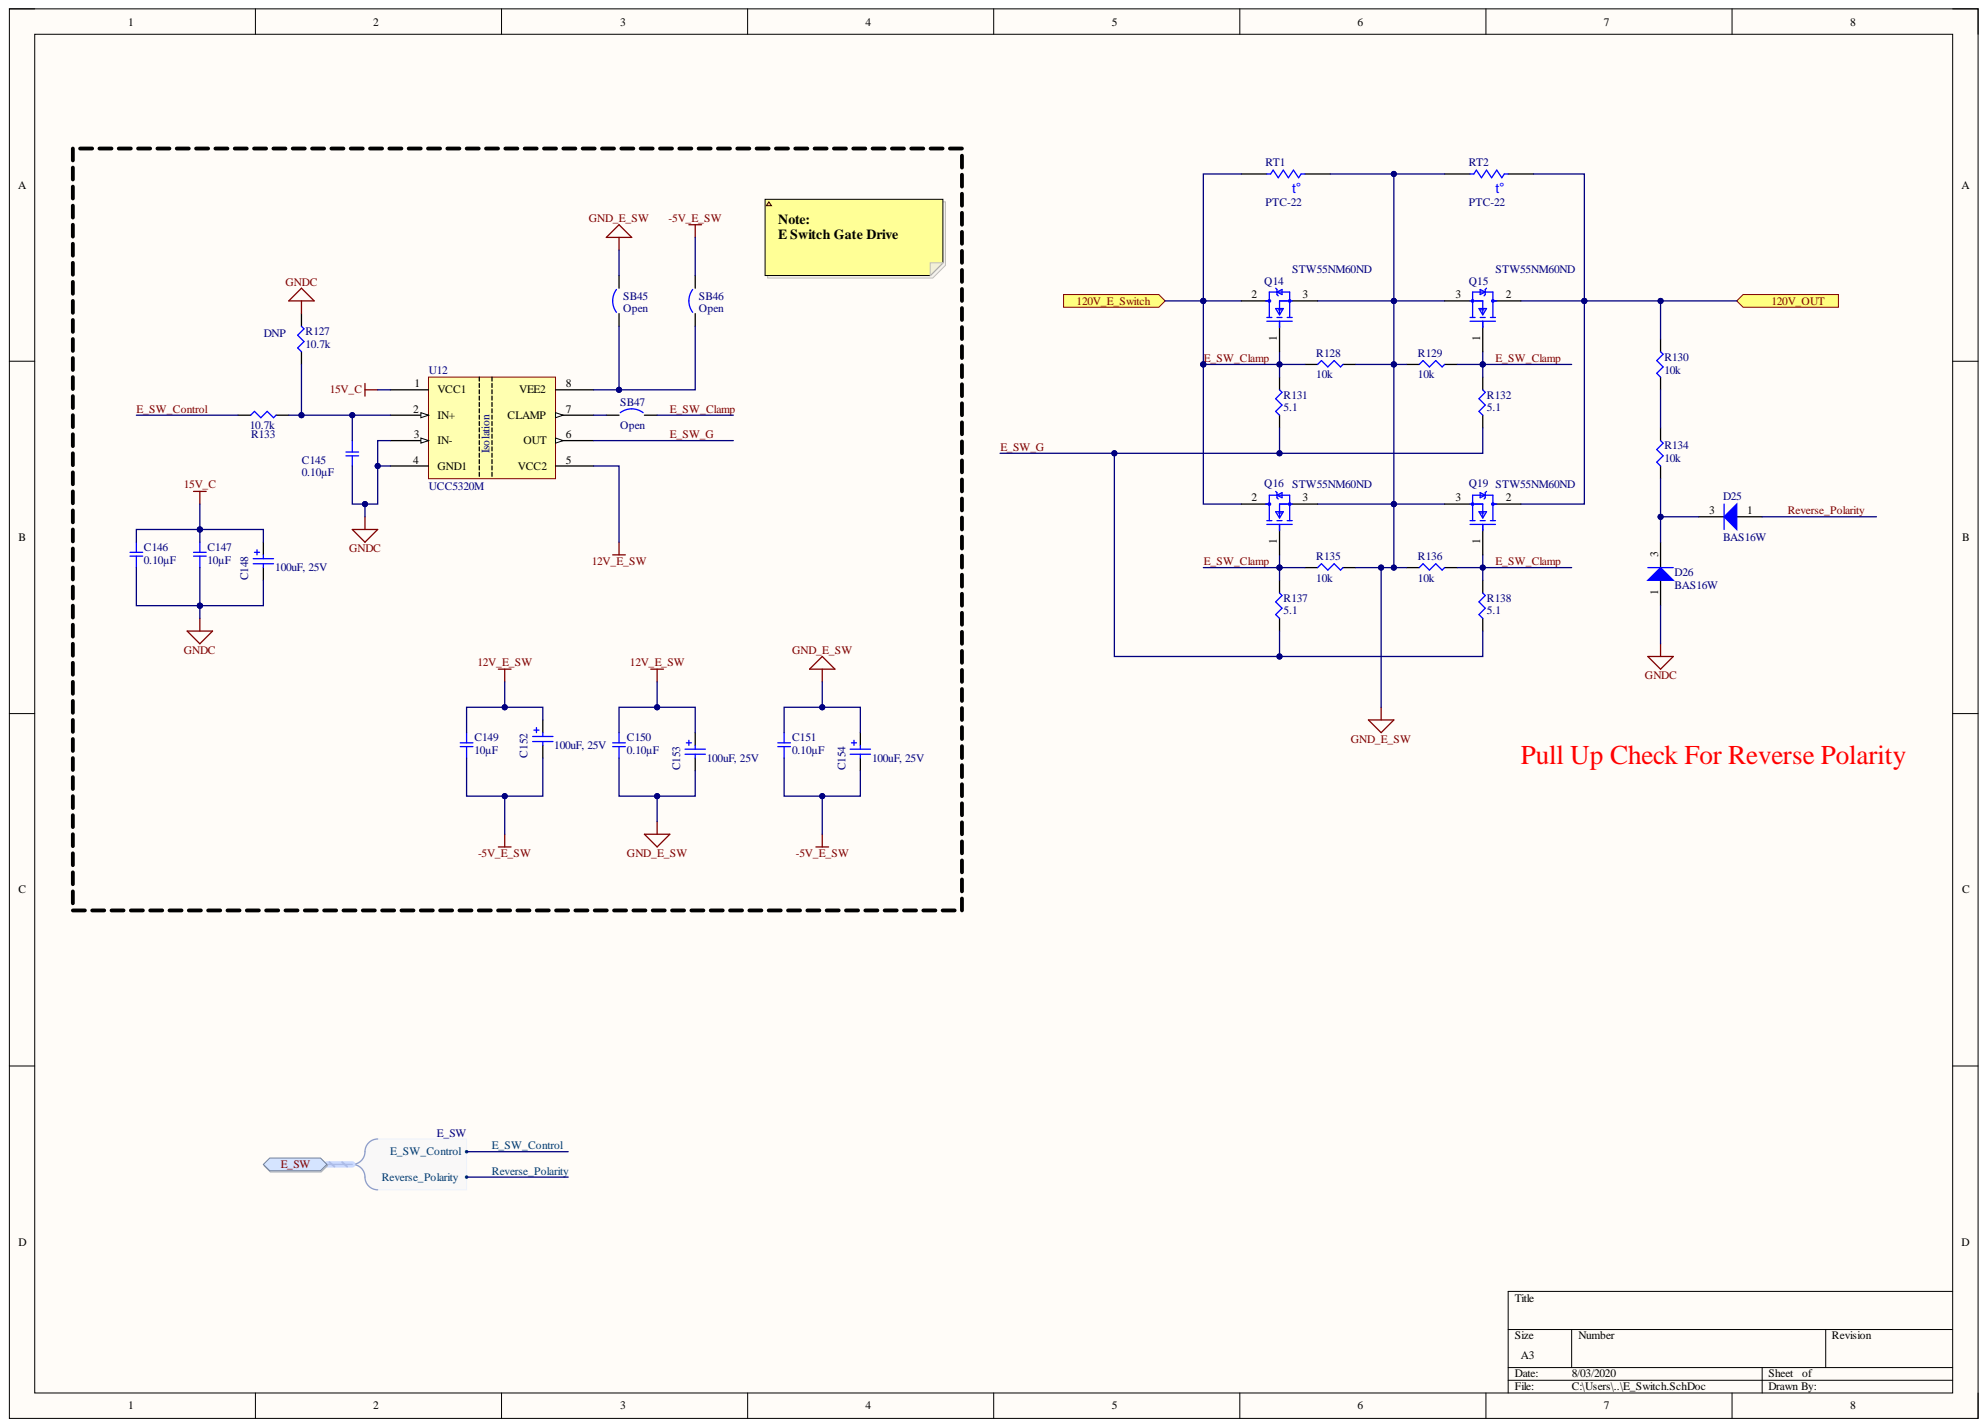
[picture p29: page 3]

Pull Up Check For Reverse Polarity

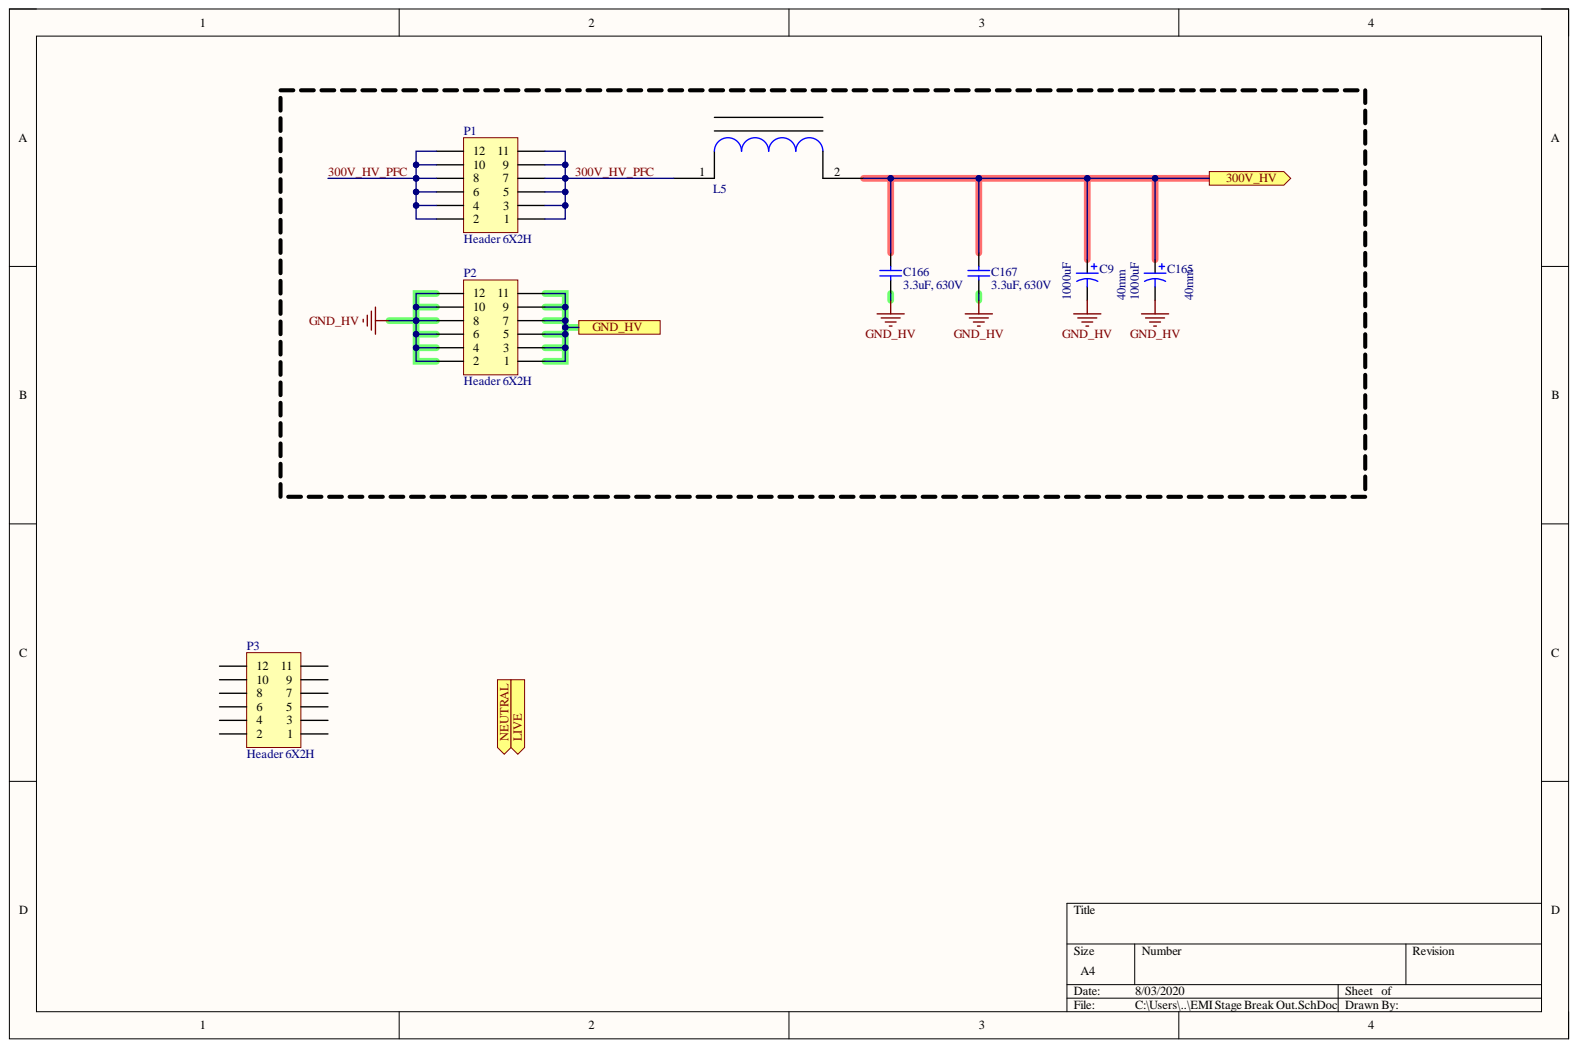
[picture p30: page 4]

Size A4 | Number | Revision

Date: 8/03/2020 | Sheet of
File: C:\Users\..\EMI Stage Break Out.SchDoc | Drawn By:

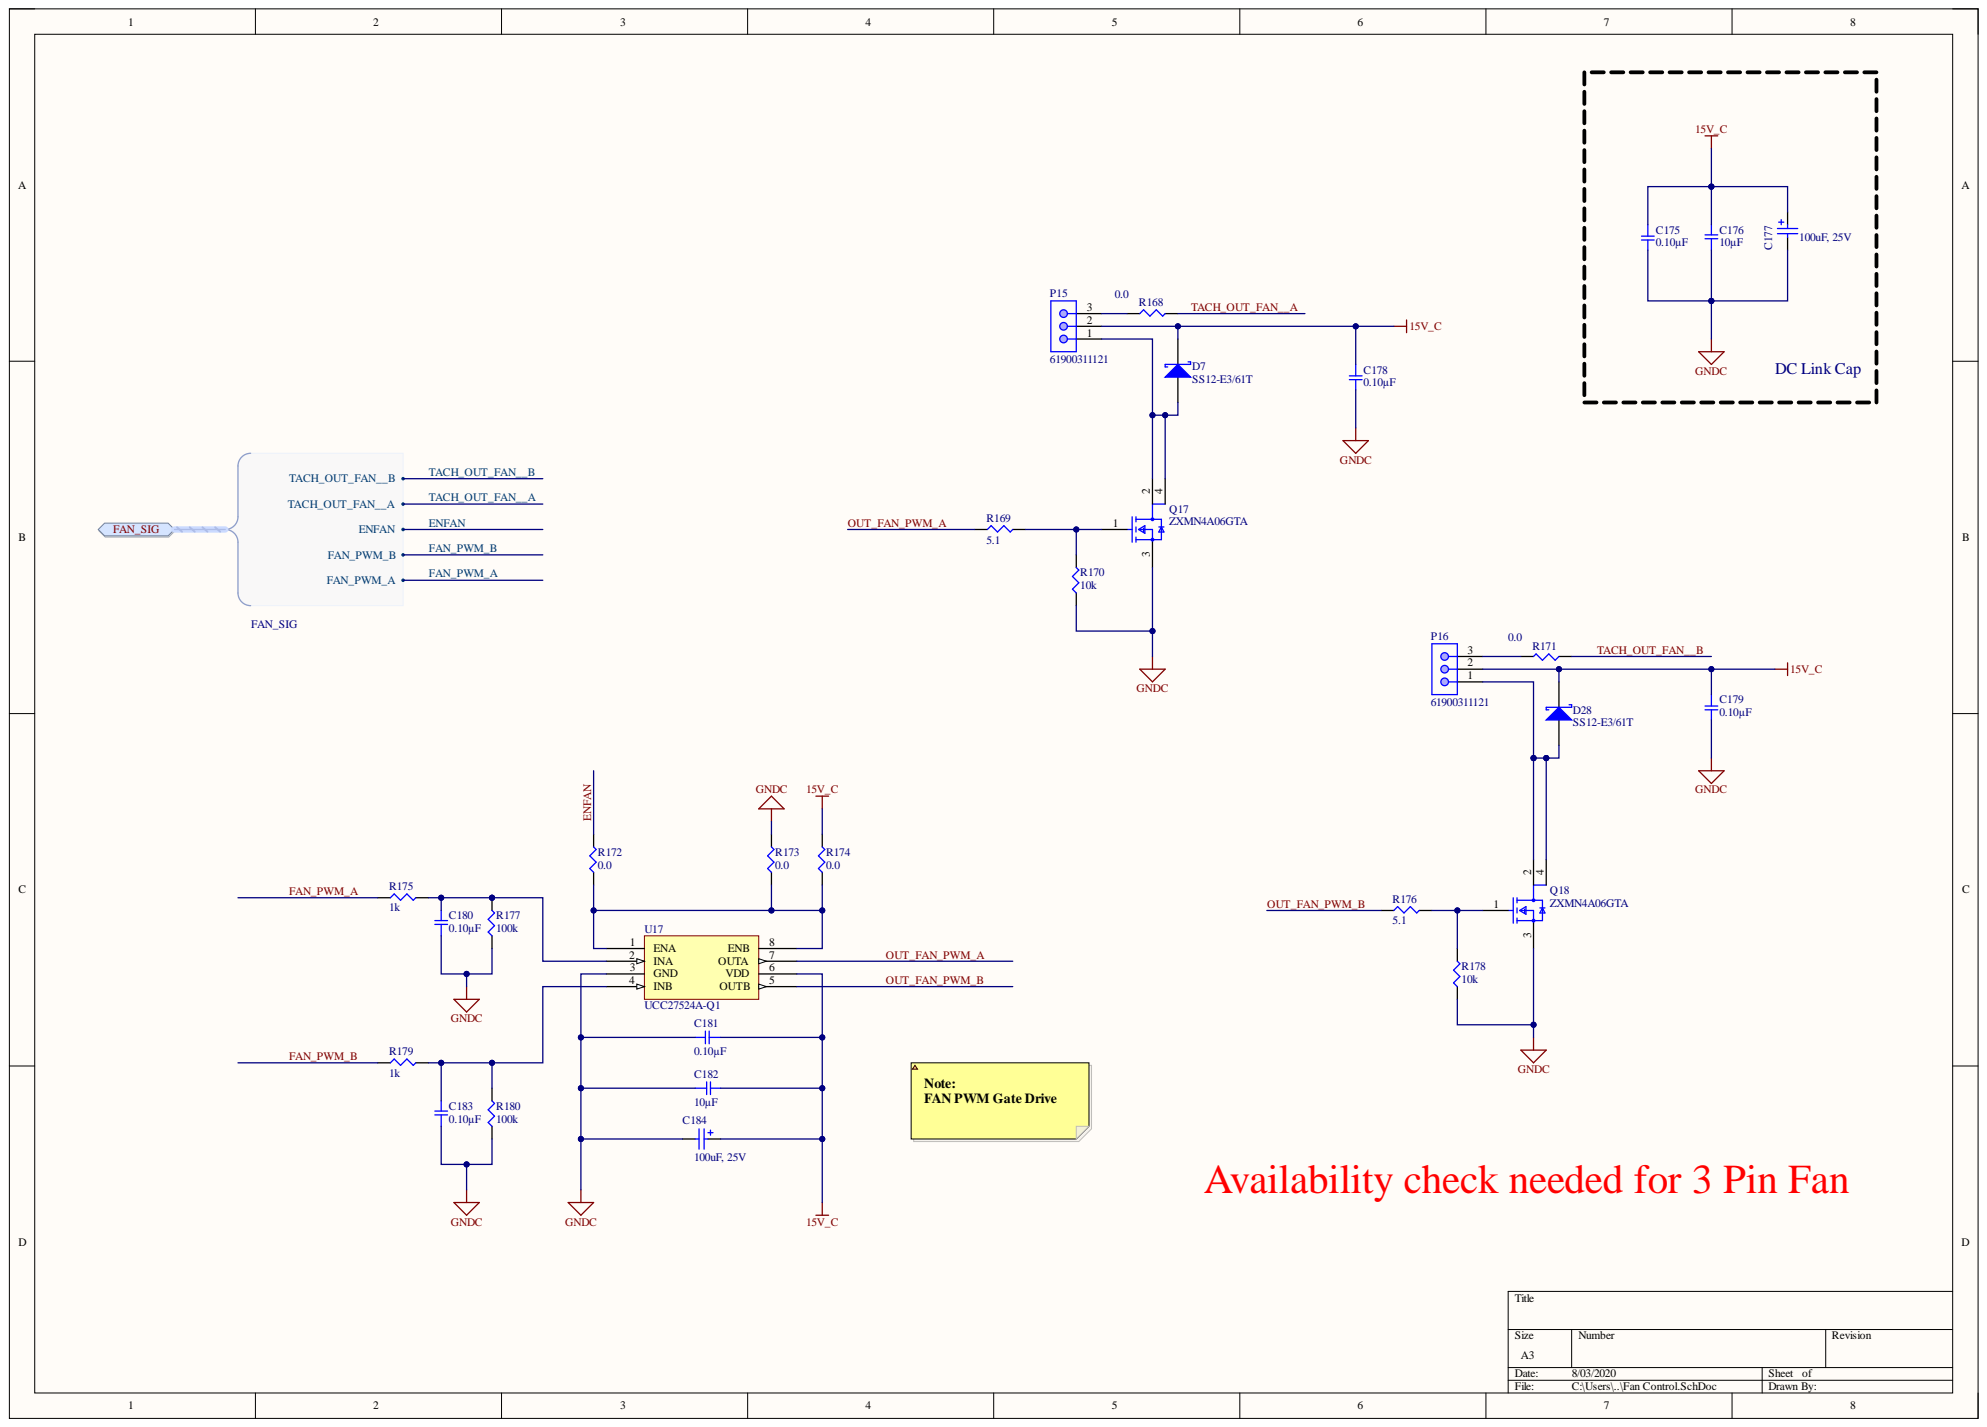
[picture p31: page 5]

Note:
FAN PWM Gate Drive

Availability check needed for 3 Pin Fan

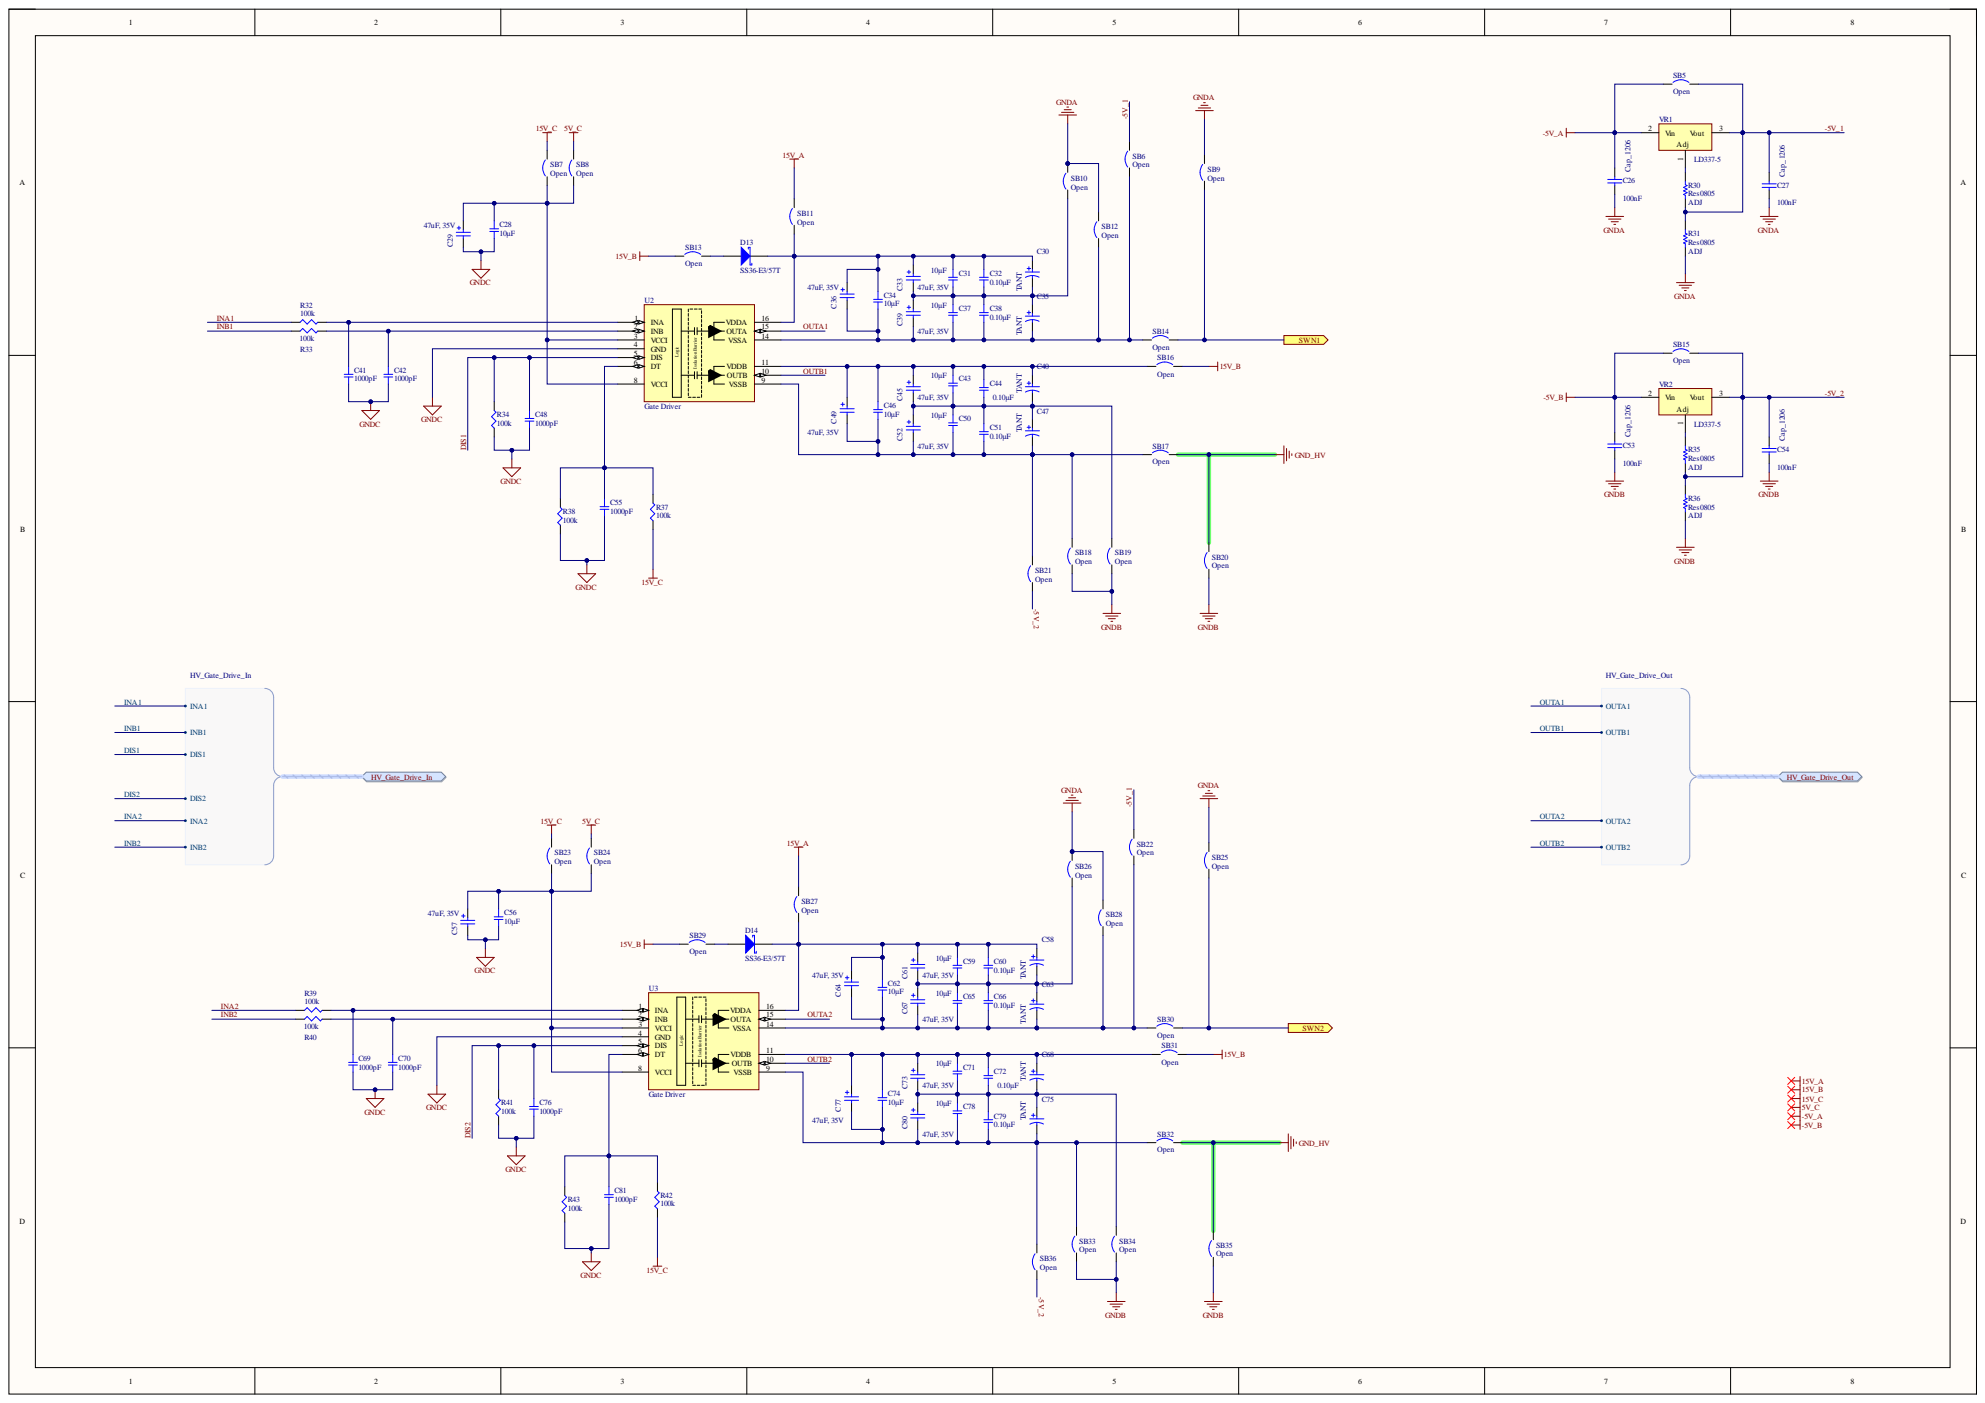
[picture p32: page 6]

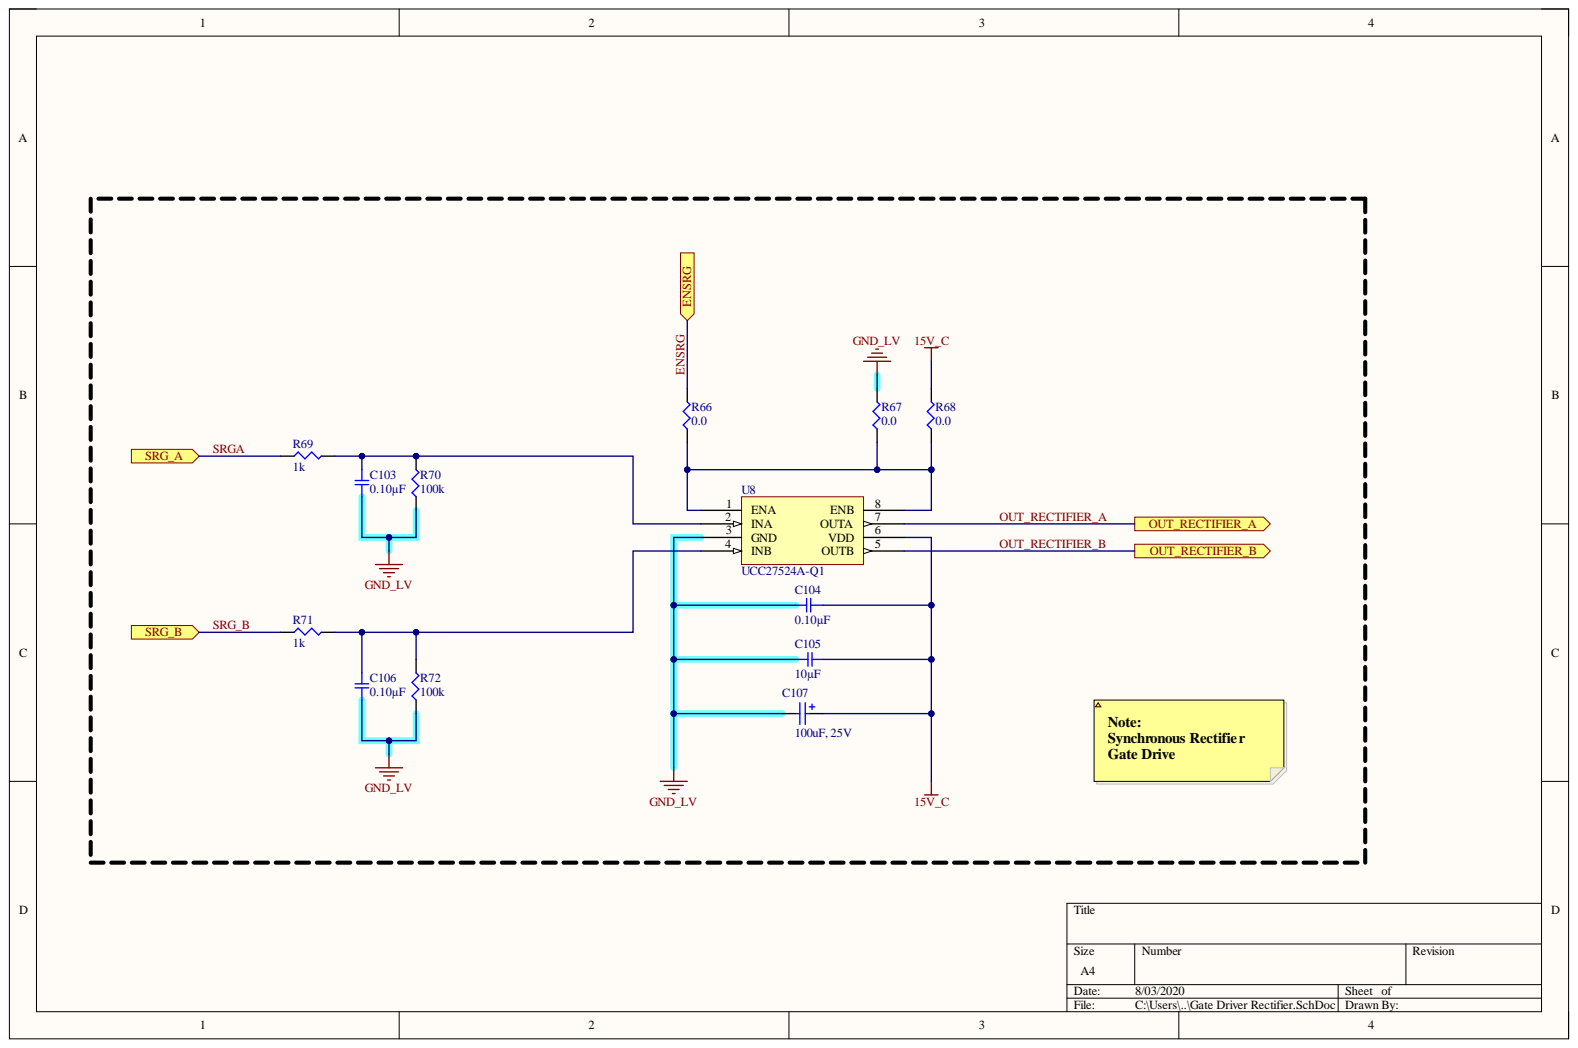
[picture p33: page 7]

2 | INA GND V D D INB

S i z e A4 | Numb e r | R e vision

Date : 8/03/202 0 | She et of
F ile : C :\Use rs\. .\G ate Dr ive r R e cti fi e r . S chDoc | Dr awn By:

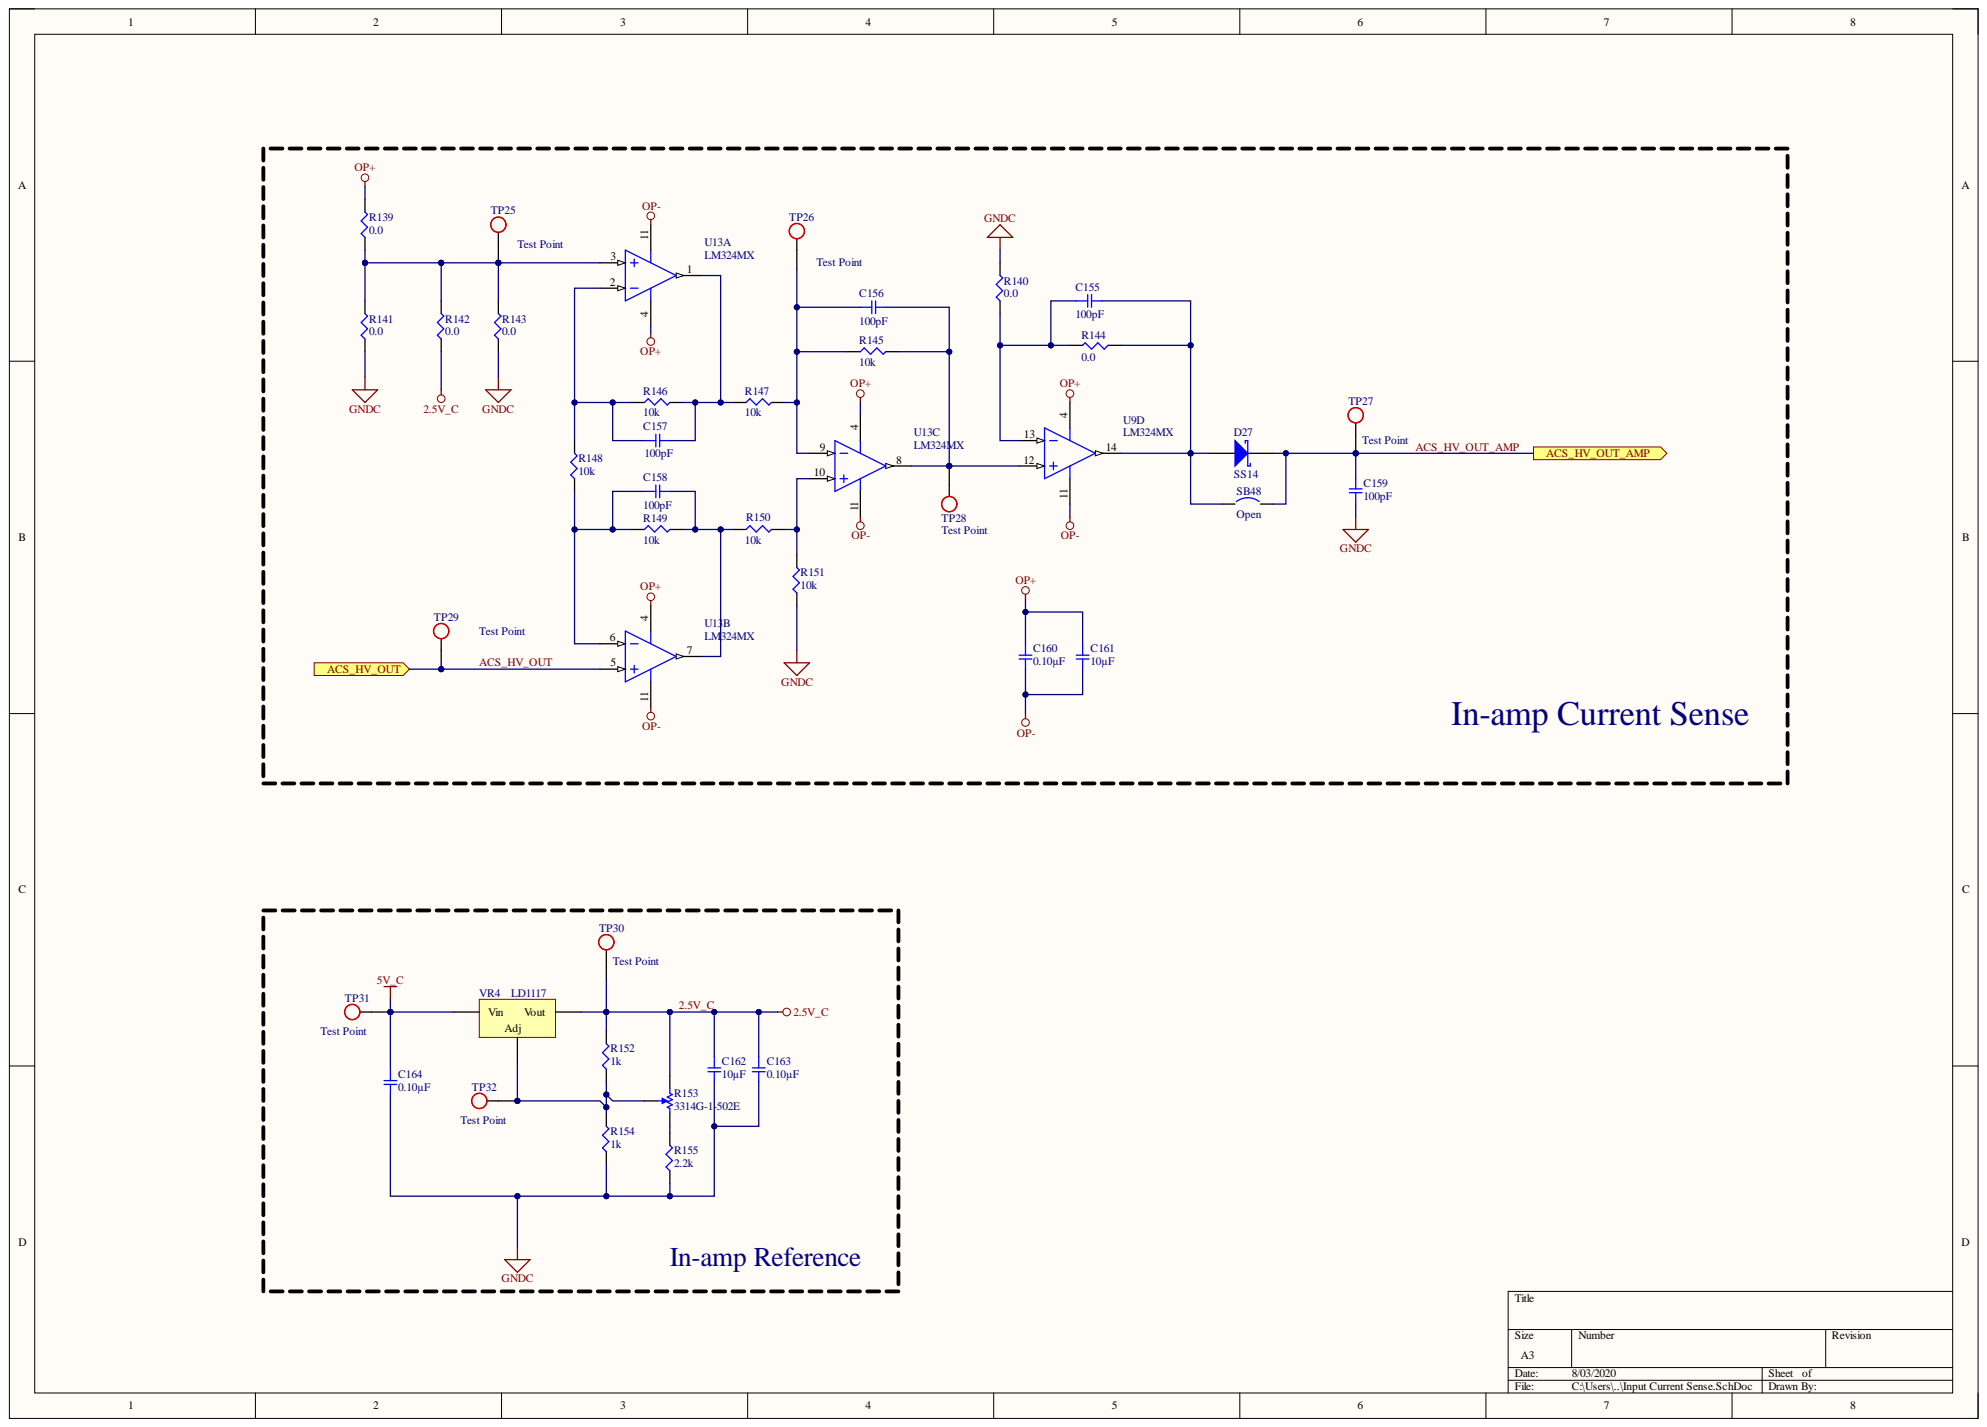
[picture p34: page 8]

In-amp Current Sense

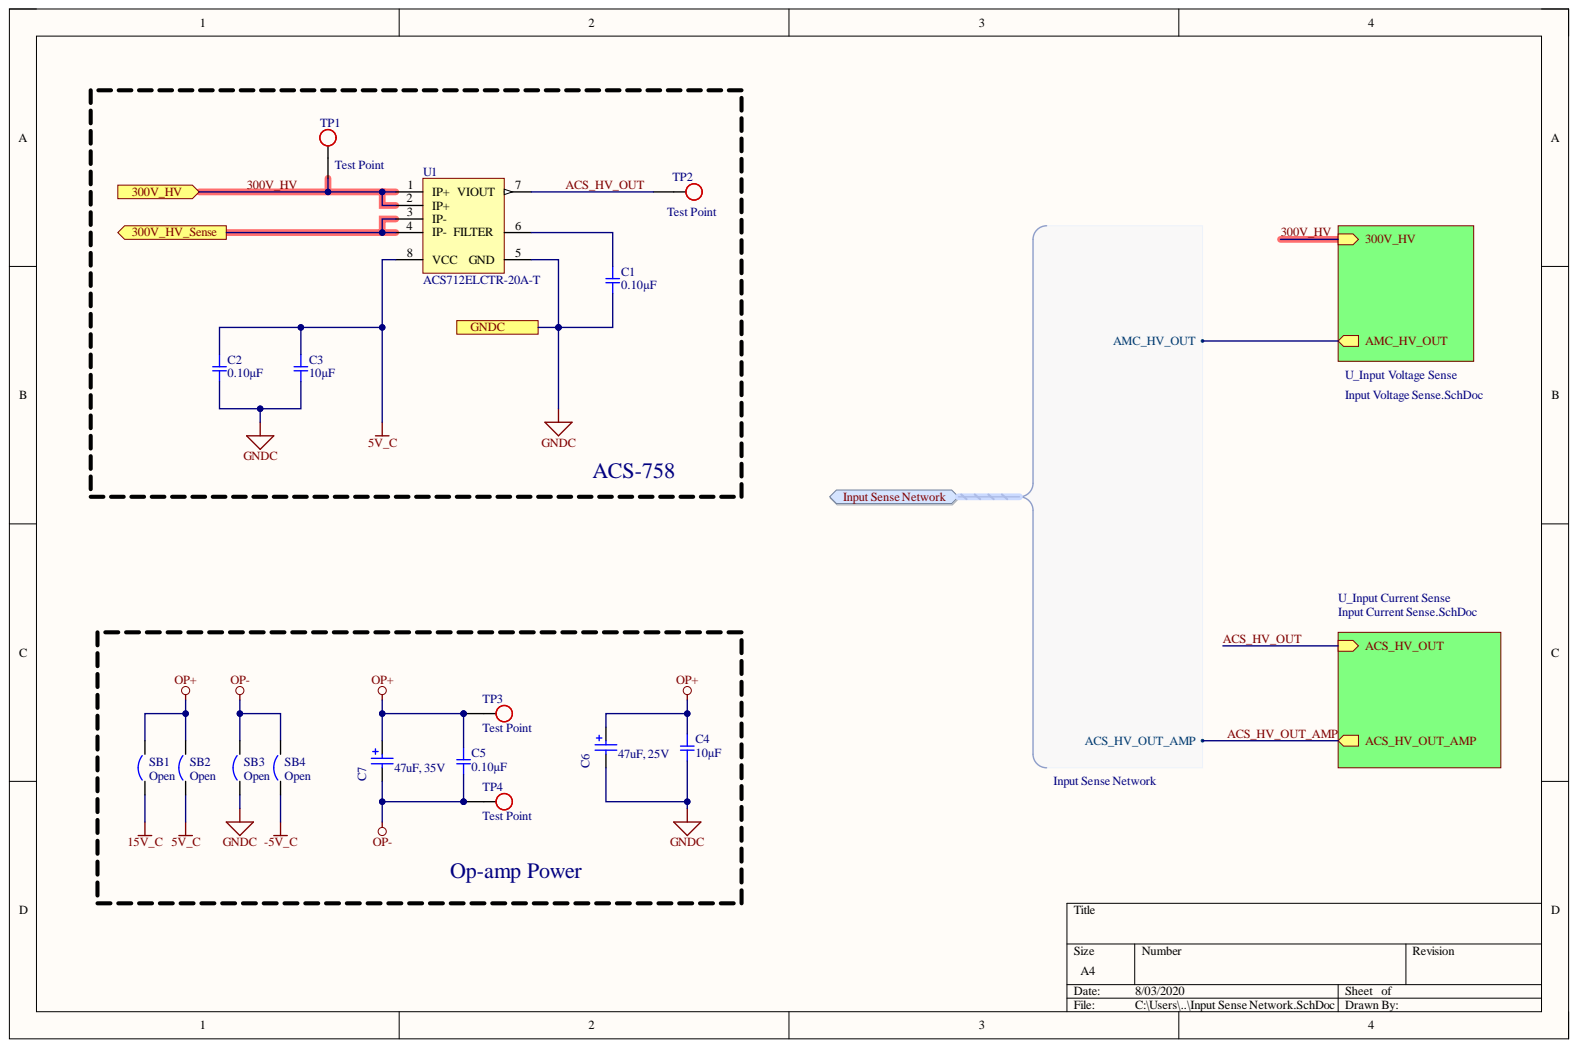
[picture p35: page 9]

U_Input Voltage Sense
Input Voltage Sense.SchDoc

U_Input Current Sense
Input Current Sense.SchDoc

Size A4 | Number | Revision

Date: 8/03/2020 | Sheet of
File: C:\Users\..\Input Sense Network.SchDoc | Drawn By:

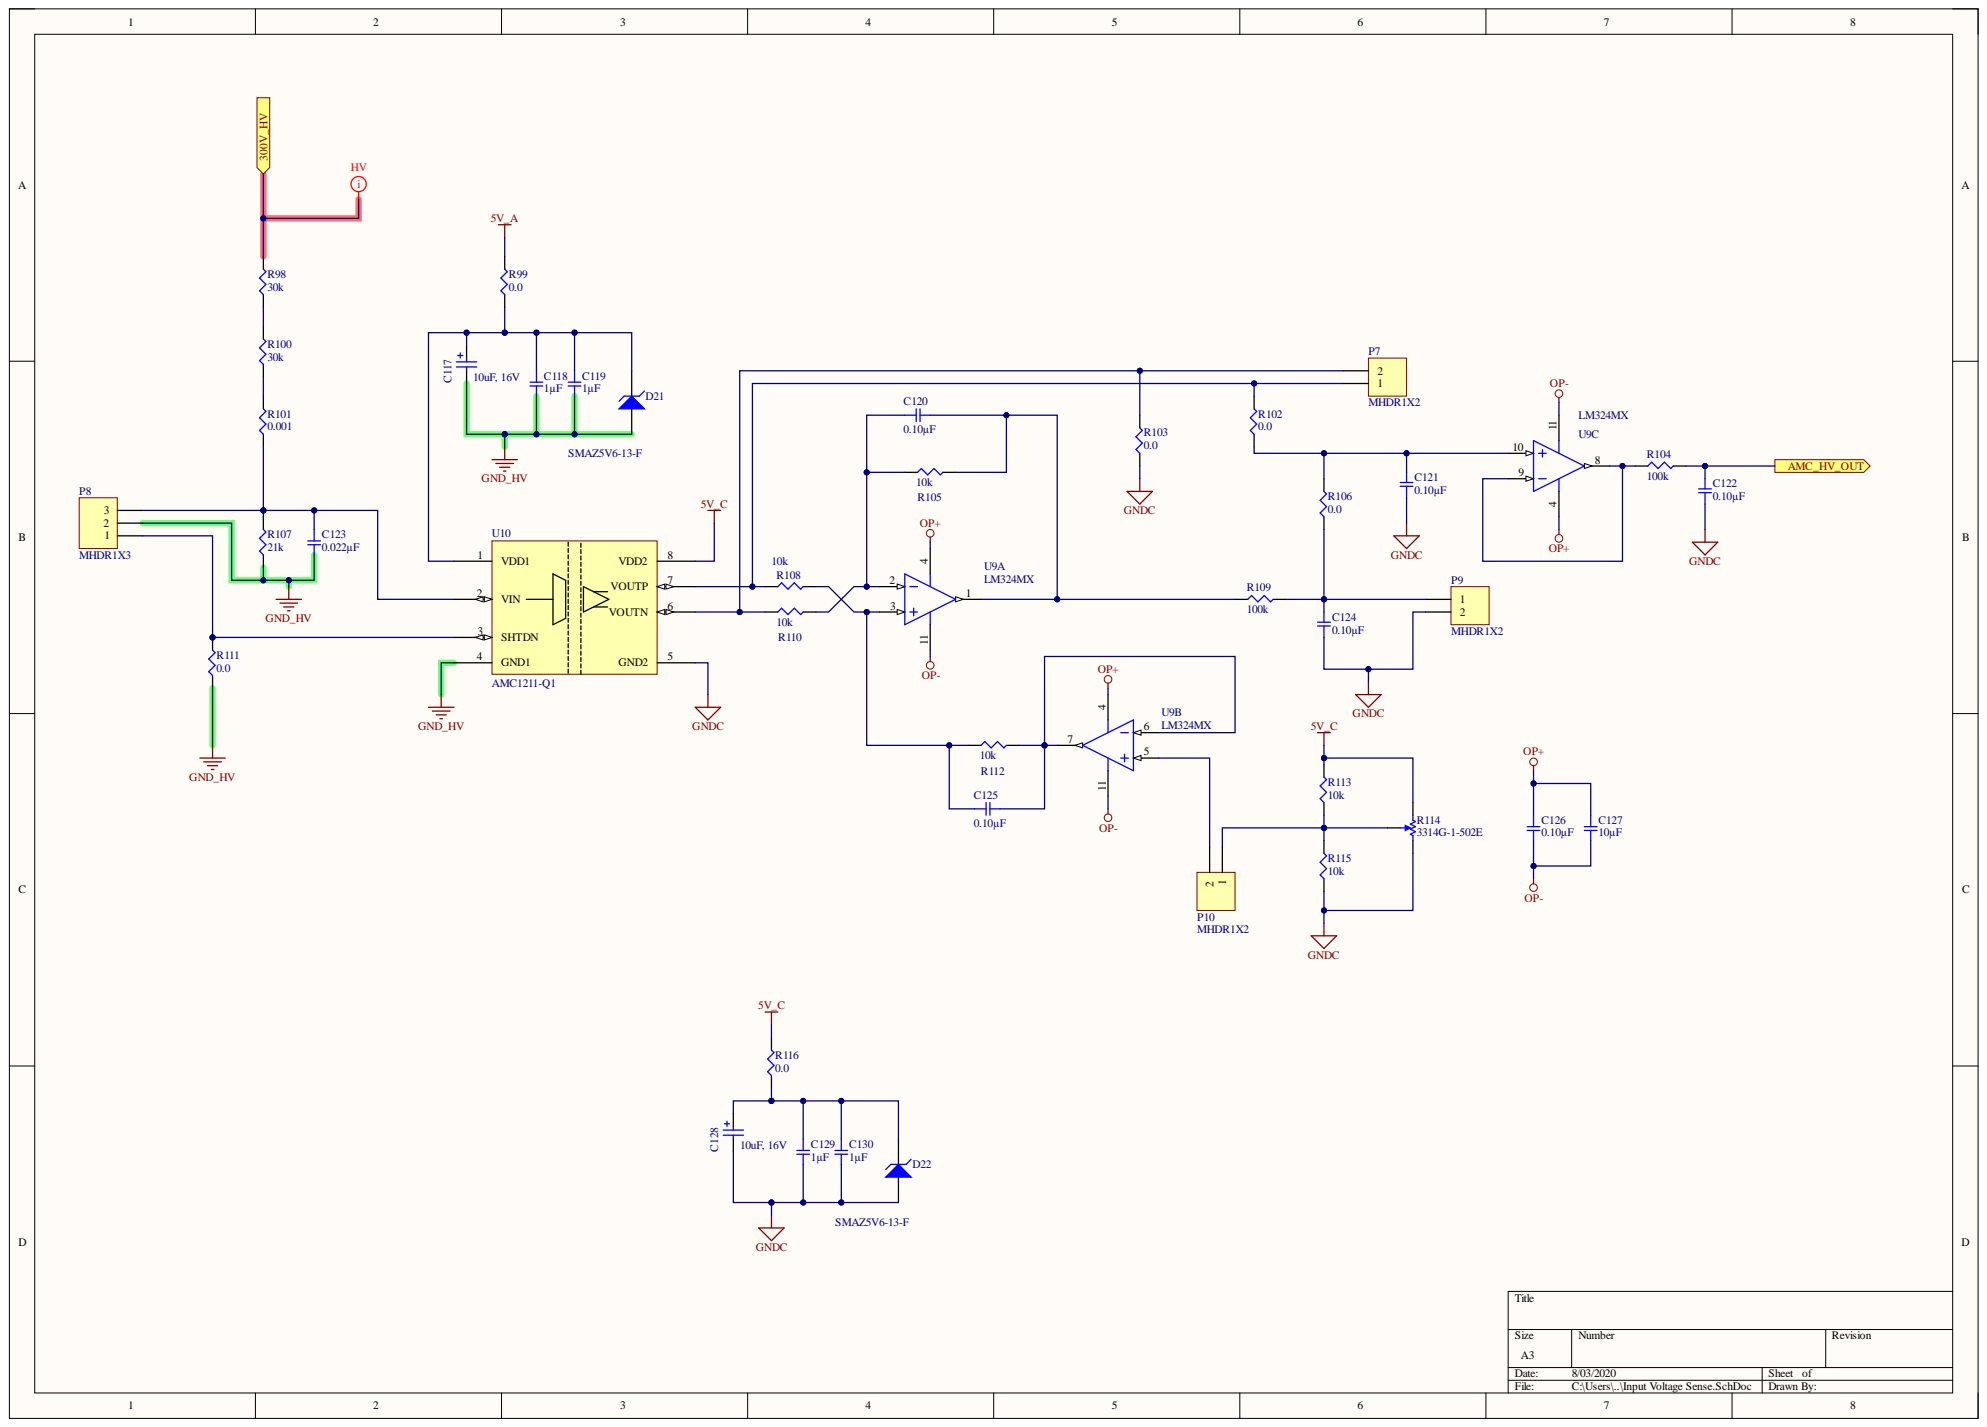
[picture p36: page 10]

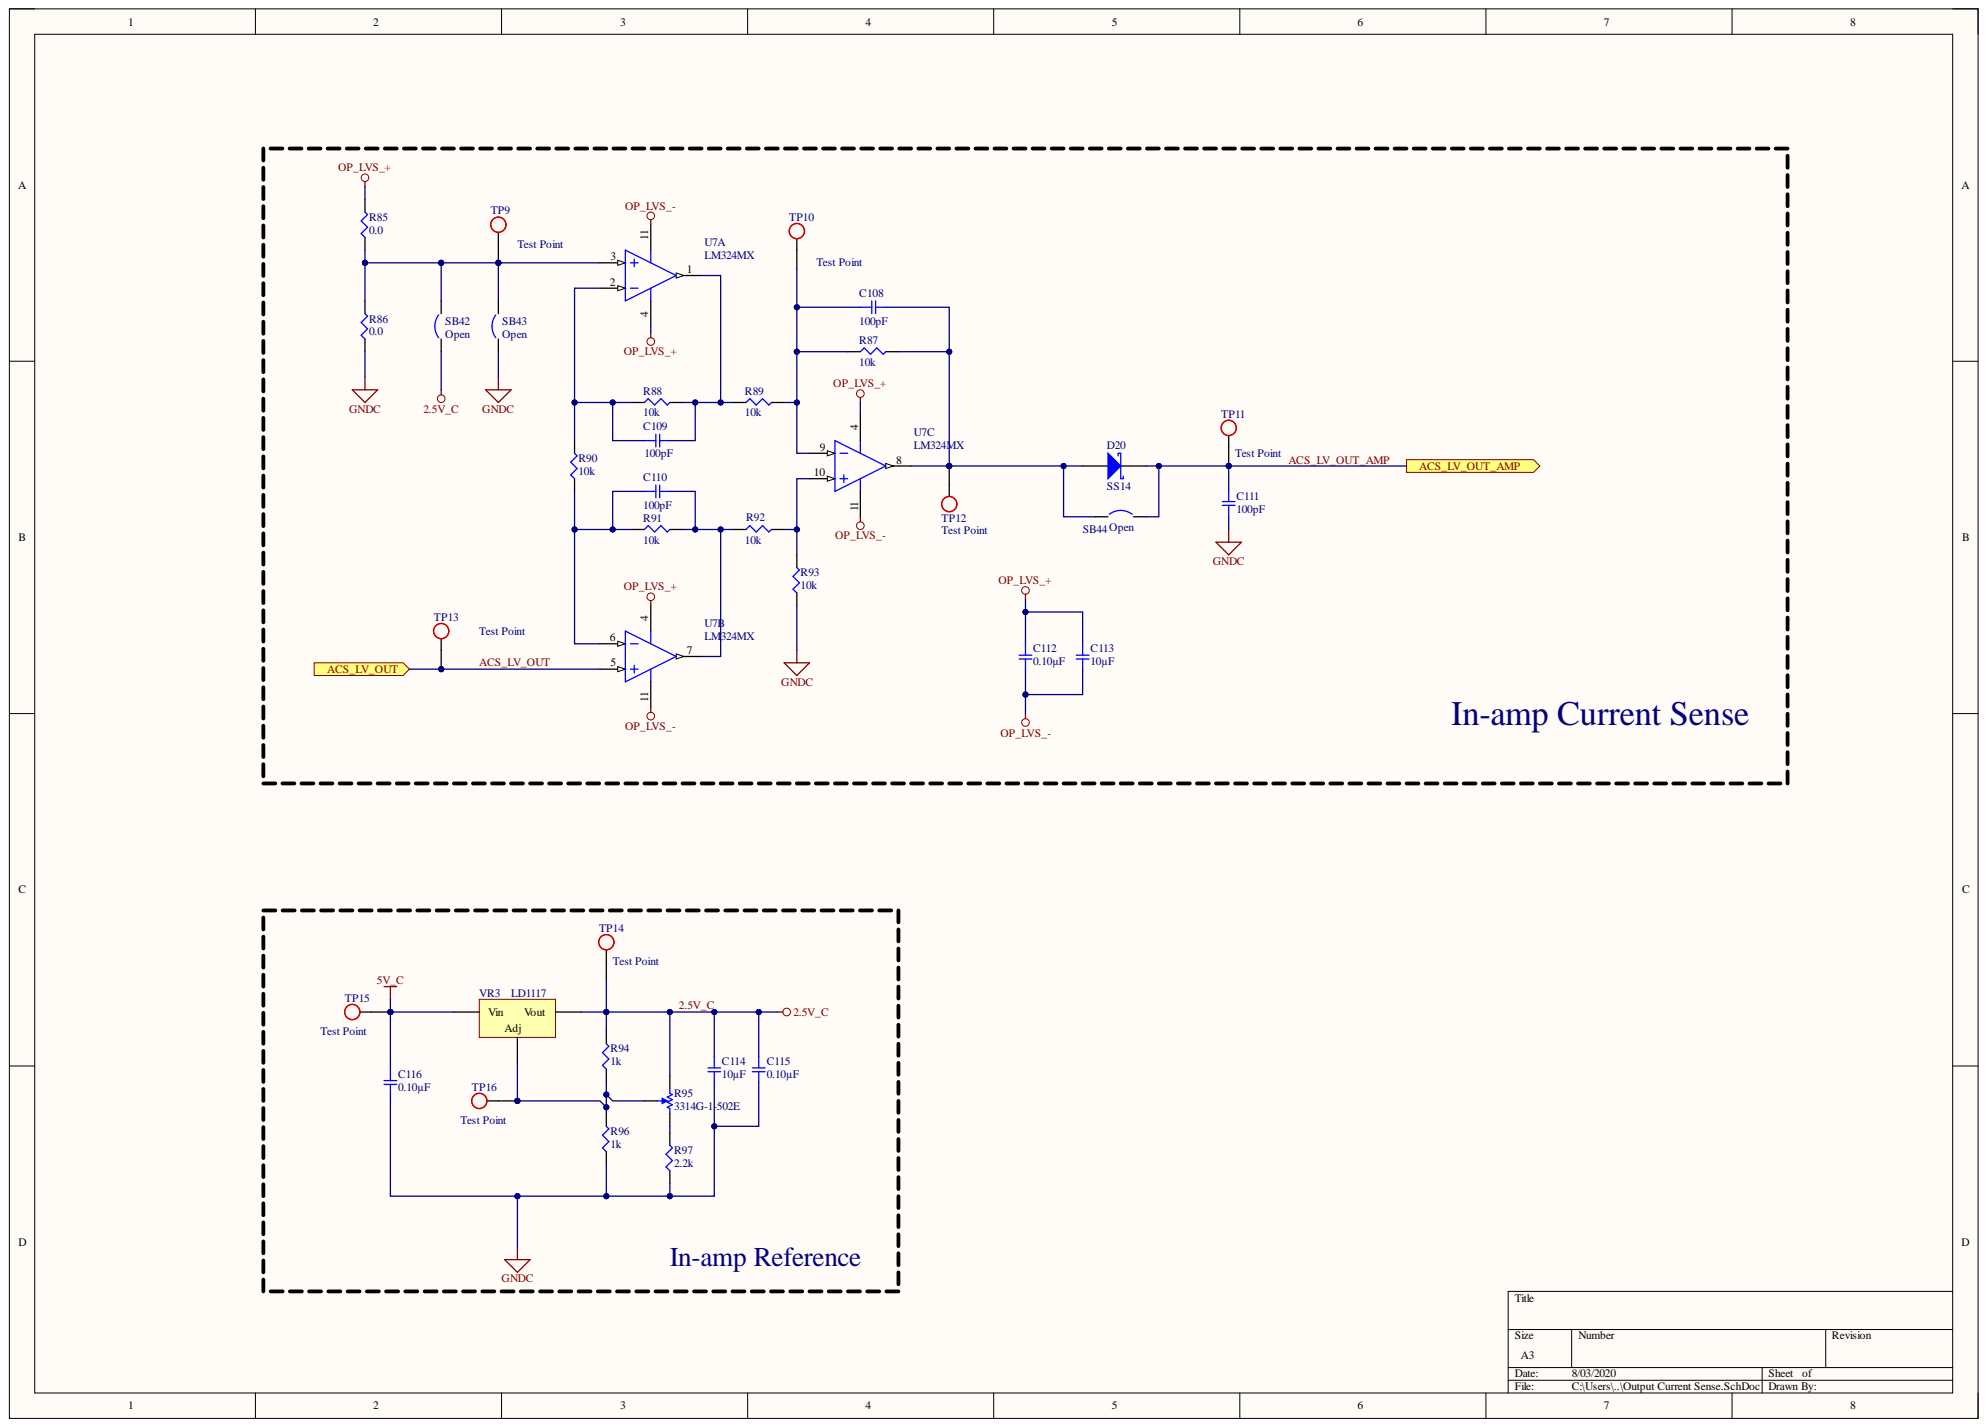
[picture p37: page 11]

In-amp Current Sense

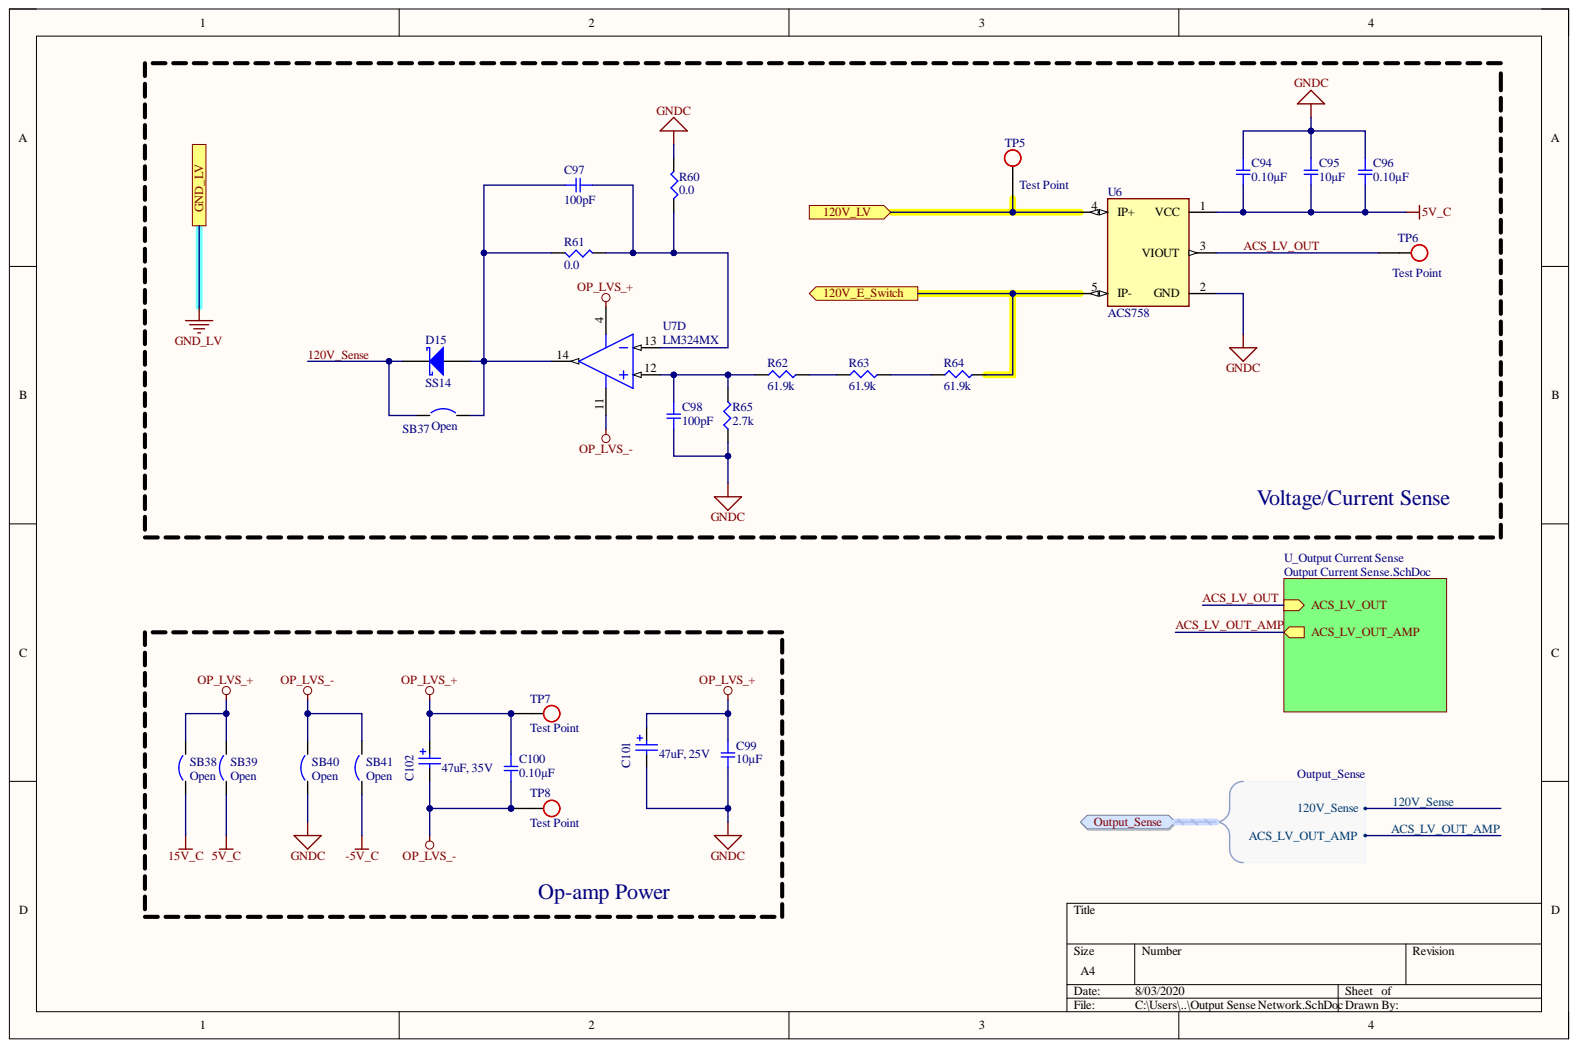
[picture p38: page 12]

U_Output Current Sense
Output Current Sense.SchDoc

Size A4 | Number | Revision

Date: 8/03/2020 | Sheet of
File: C:\Users\..\Output Sense Network.SchDocDrawn By:

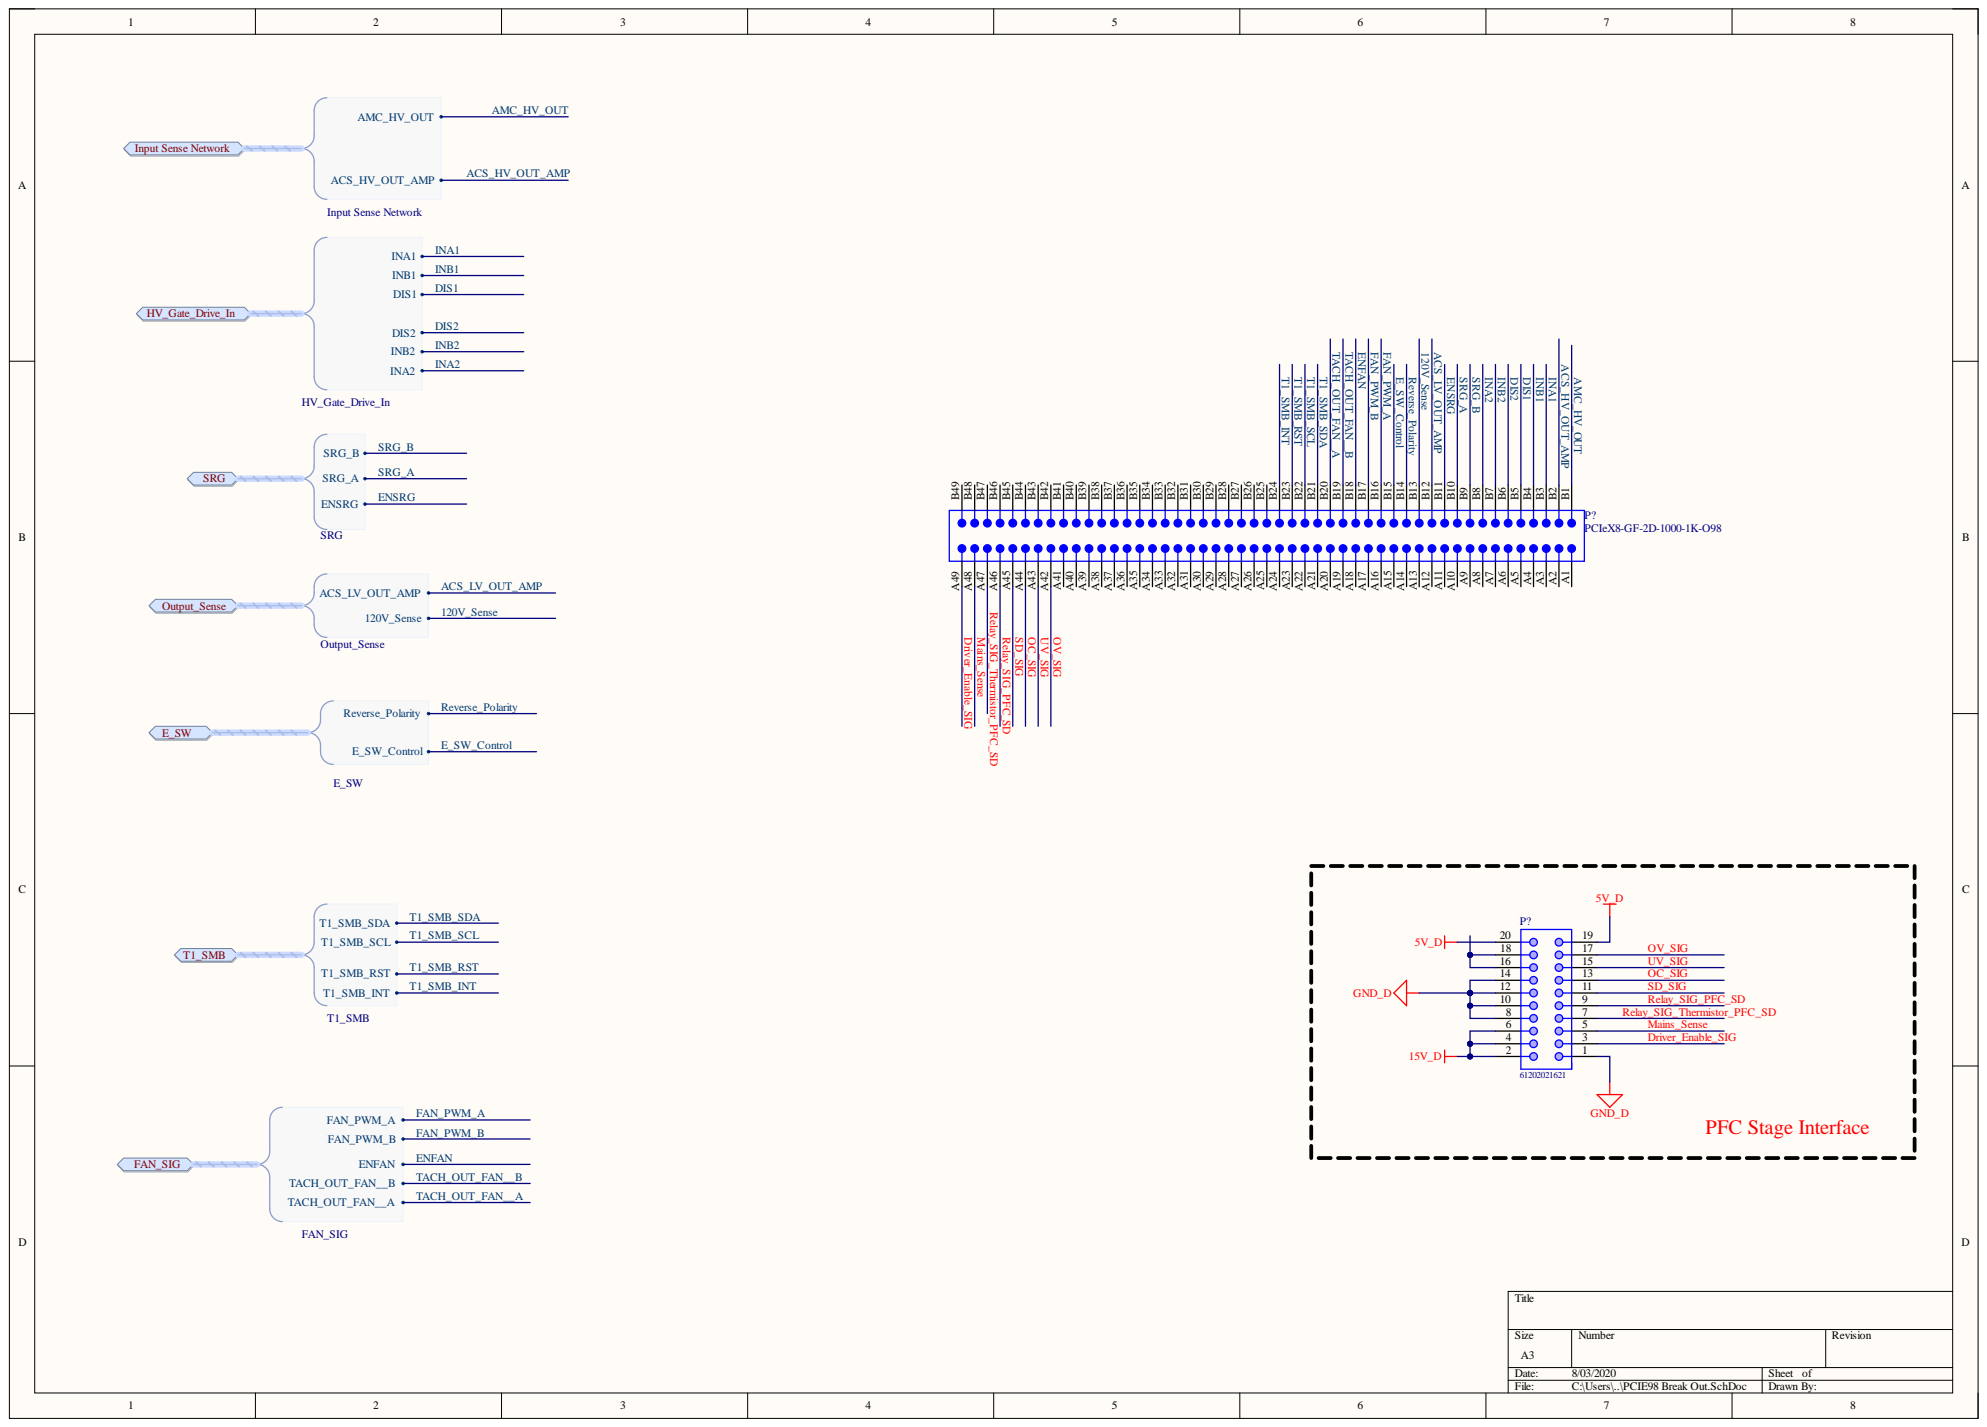
[picture p39: page 13]

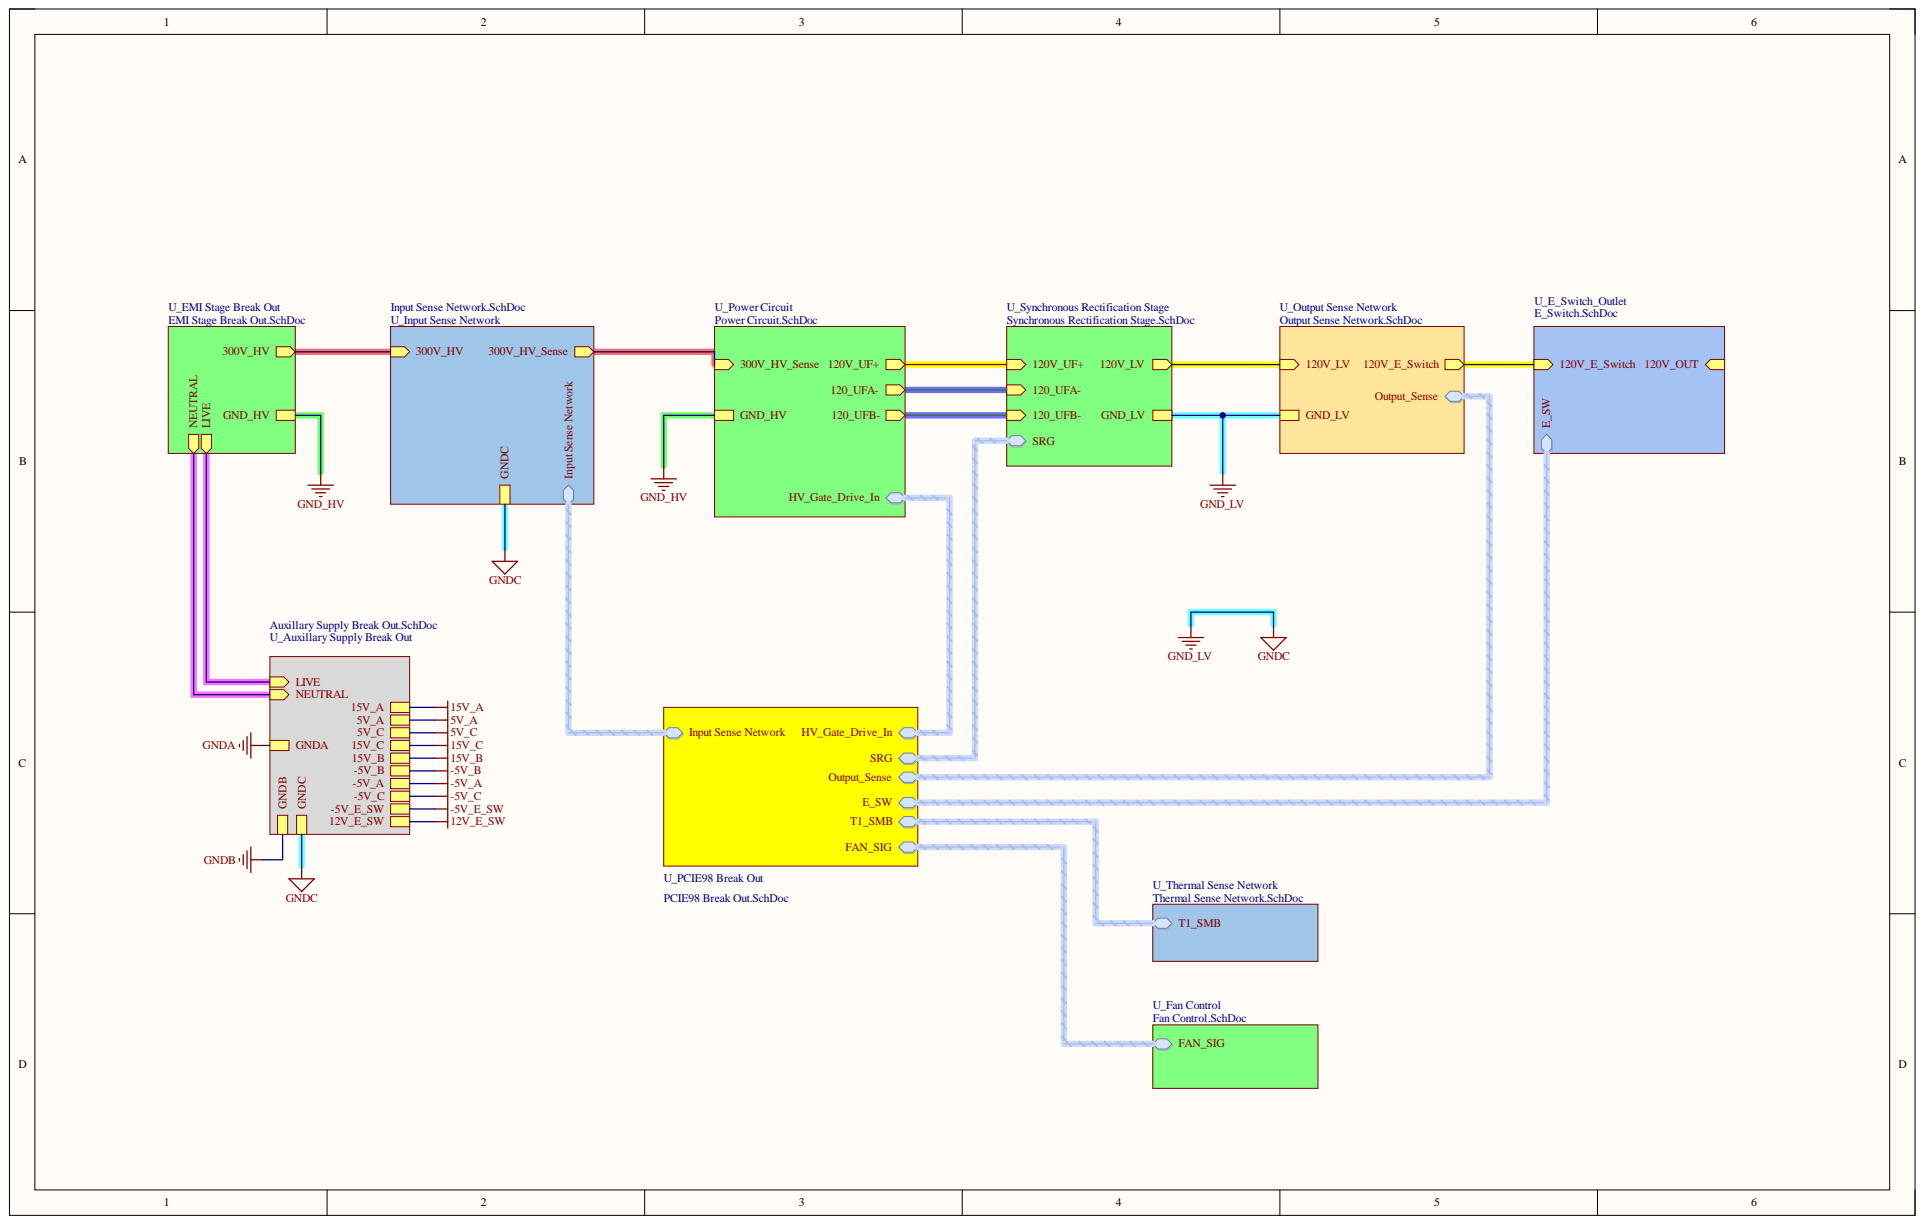
[picture p40: page 14]

U_EMI Stage Break Out
EMI Stage Break Out.SchDoc

Input Sense Network.SchDoc
U_Input Sense Network

U_Synchronous Rectification Stage
Synchronous Rectification Stage.SchDoc

U_Output Sense Network
Output Sense Network.SchDoc

Auxillary Supply Break Out.SchDoc
U_Auxillary Supply Break Out

U_Thermal Sense Network
Thermal Sense Network.SchDoc

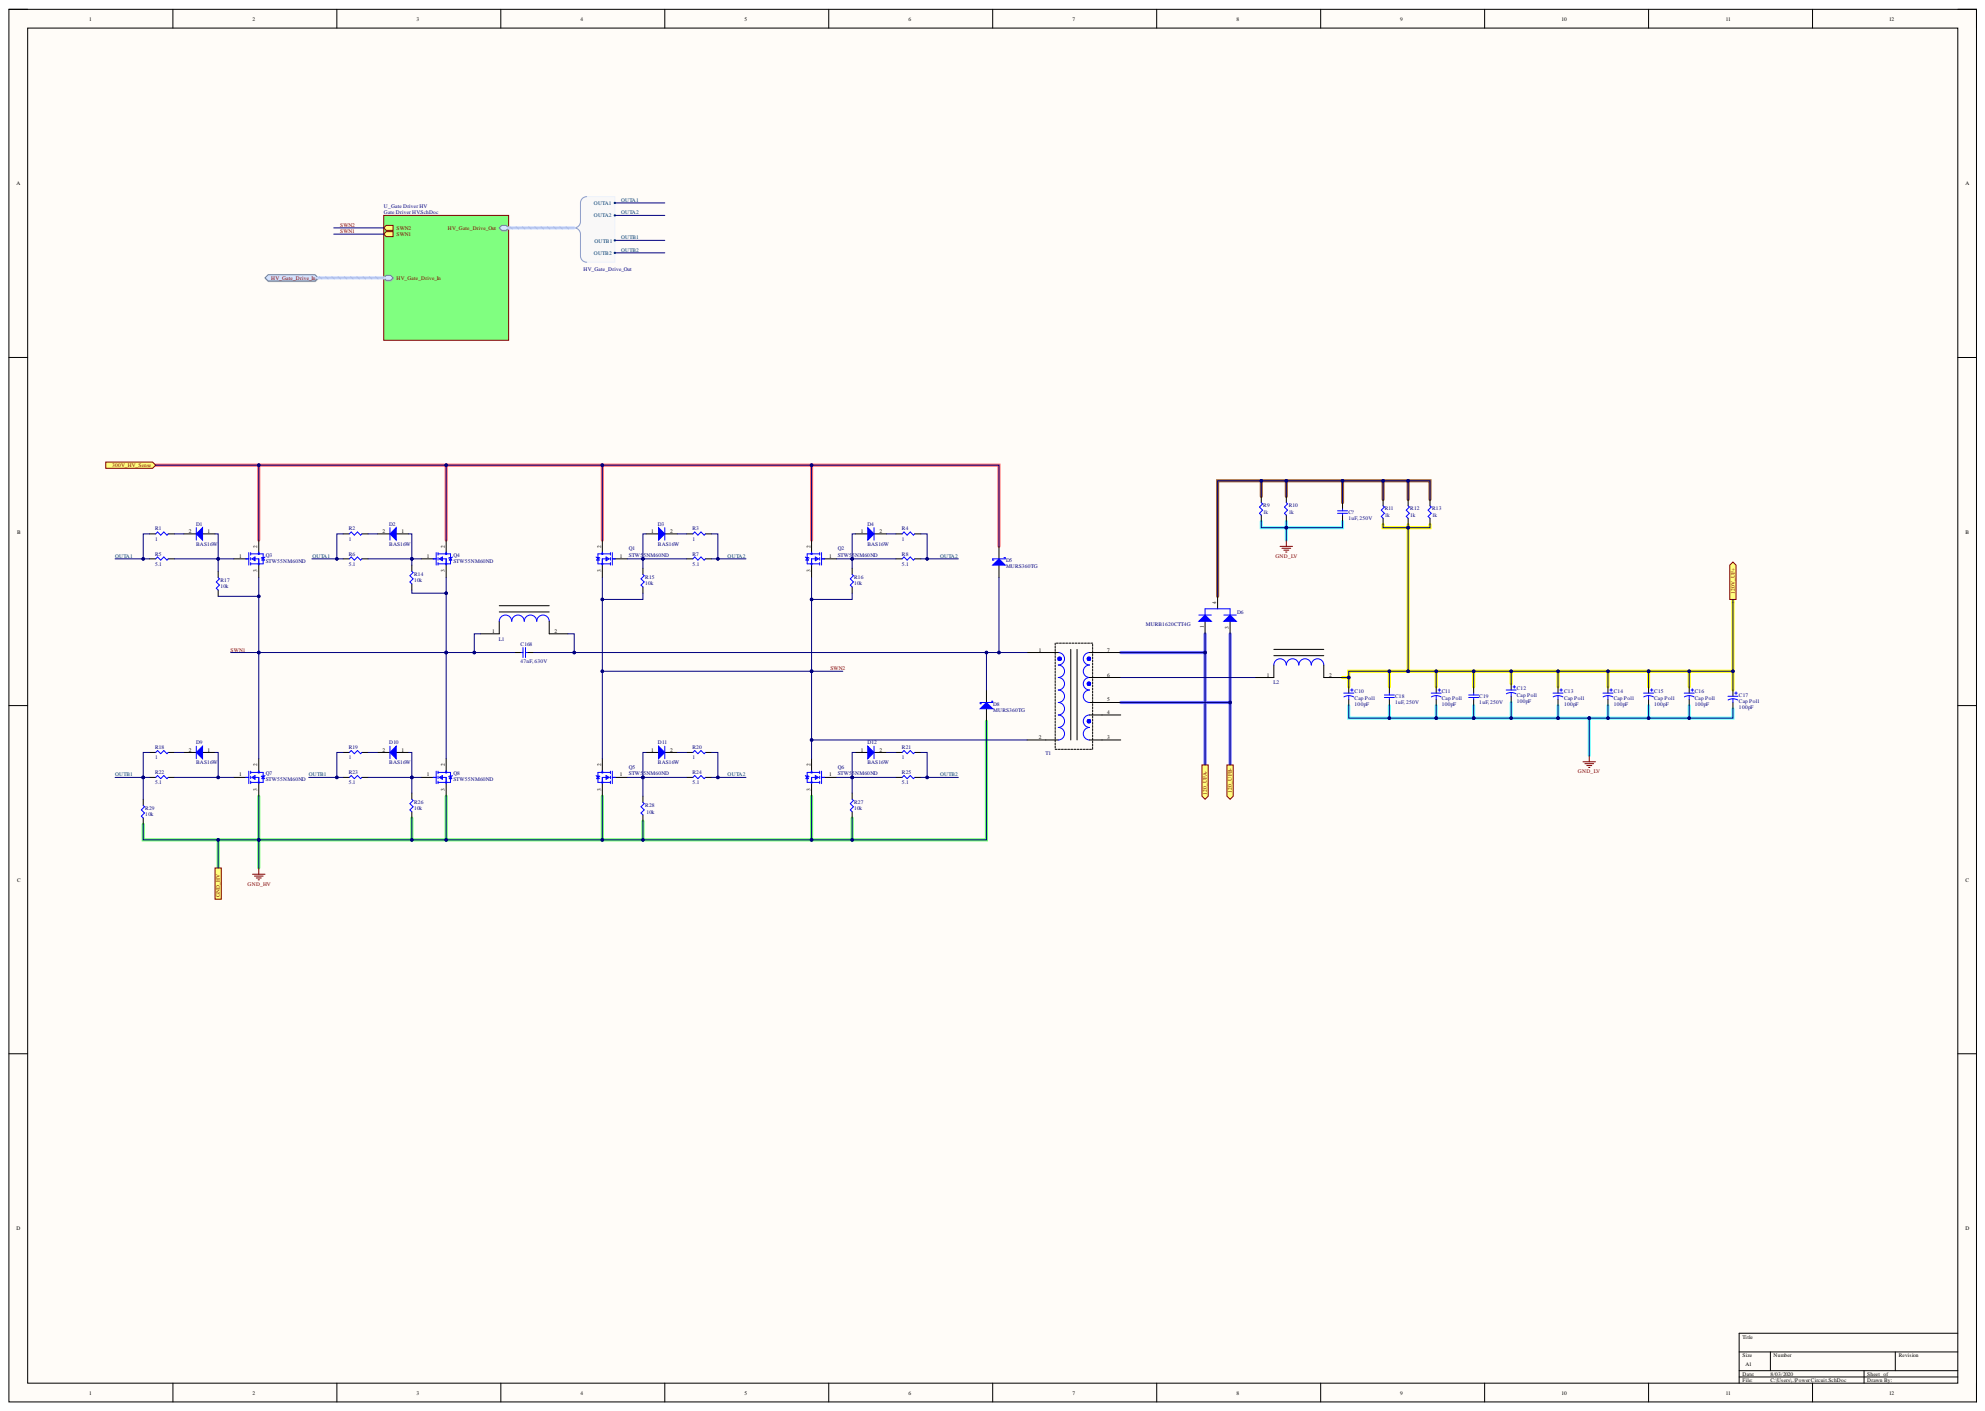
[picture p41: page 15]

BAS1 6W | | | BAS1 6W

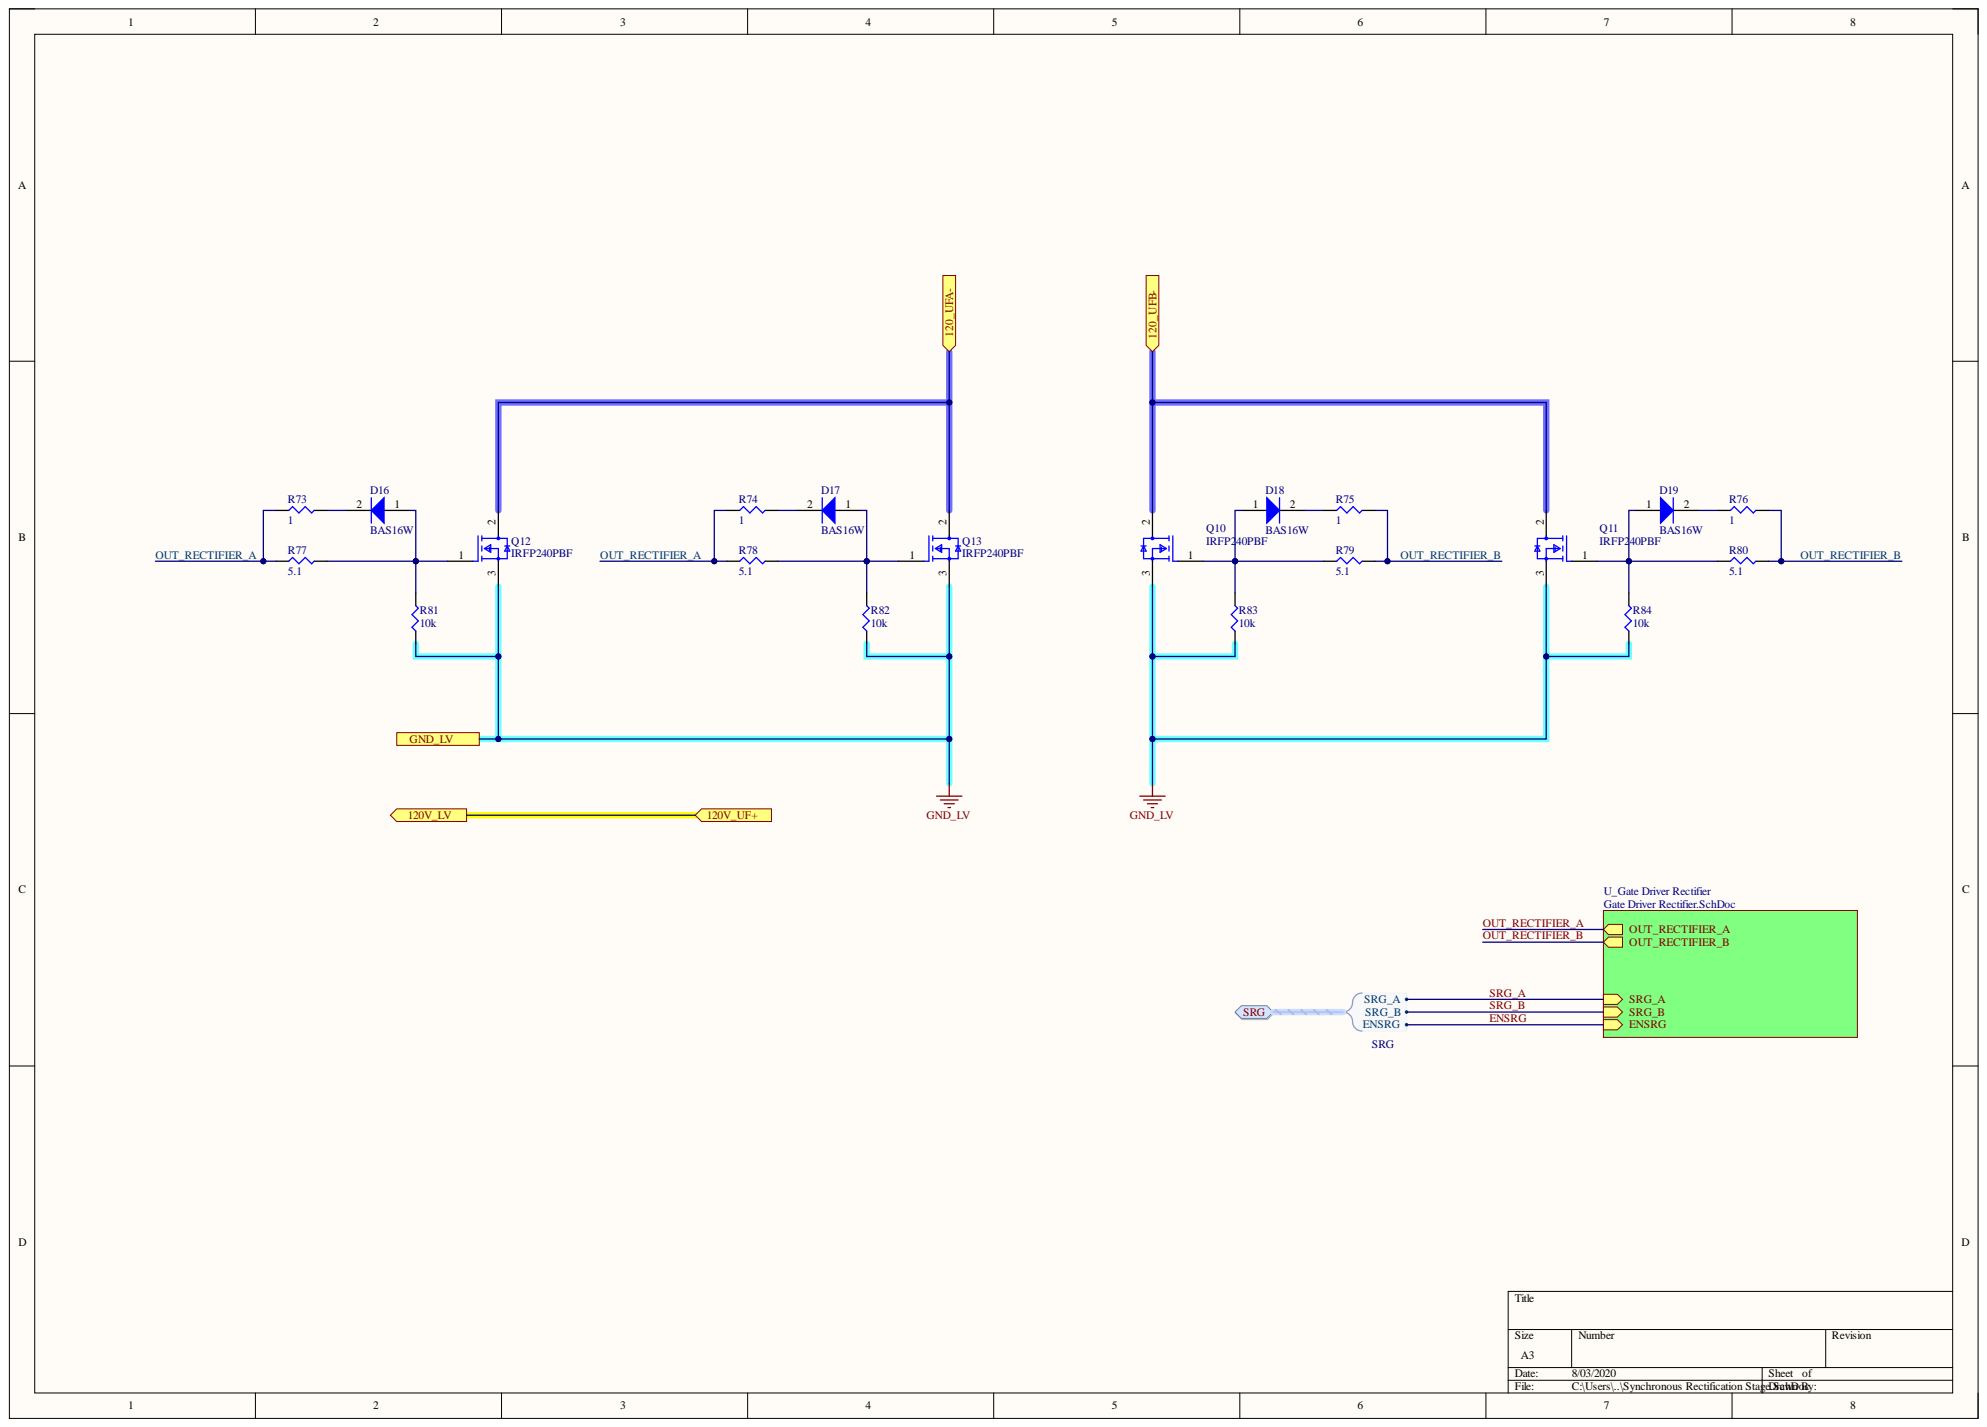
[picture p42: page 16]

U_Gate Driver Rectifier
Gate Driver Rectifier.SchDoc

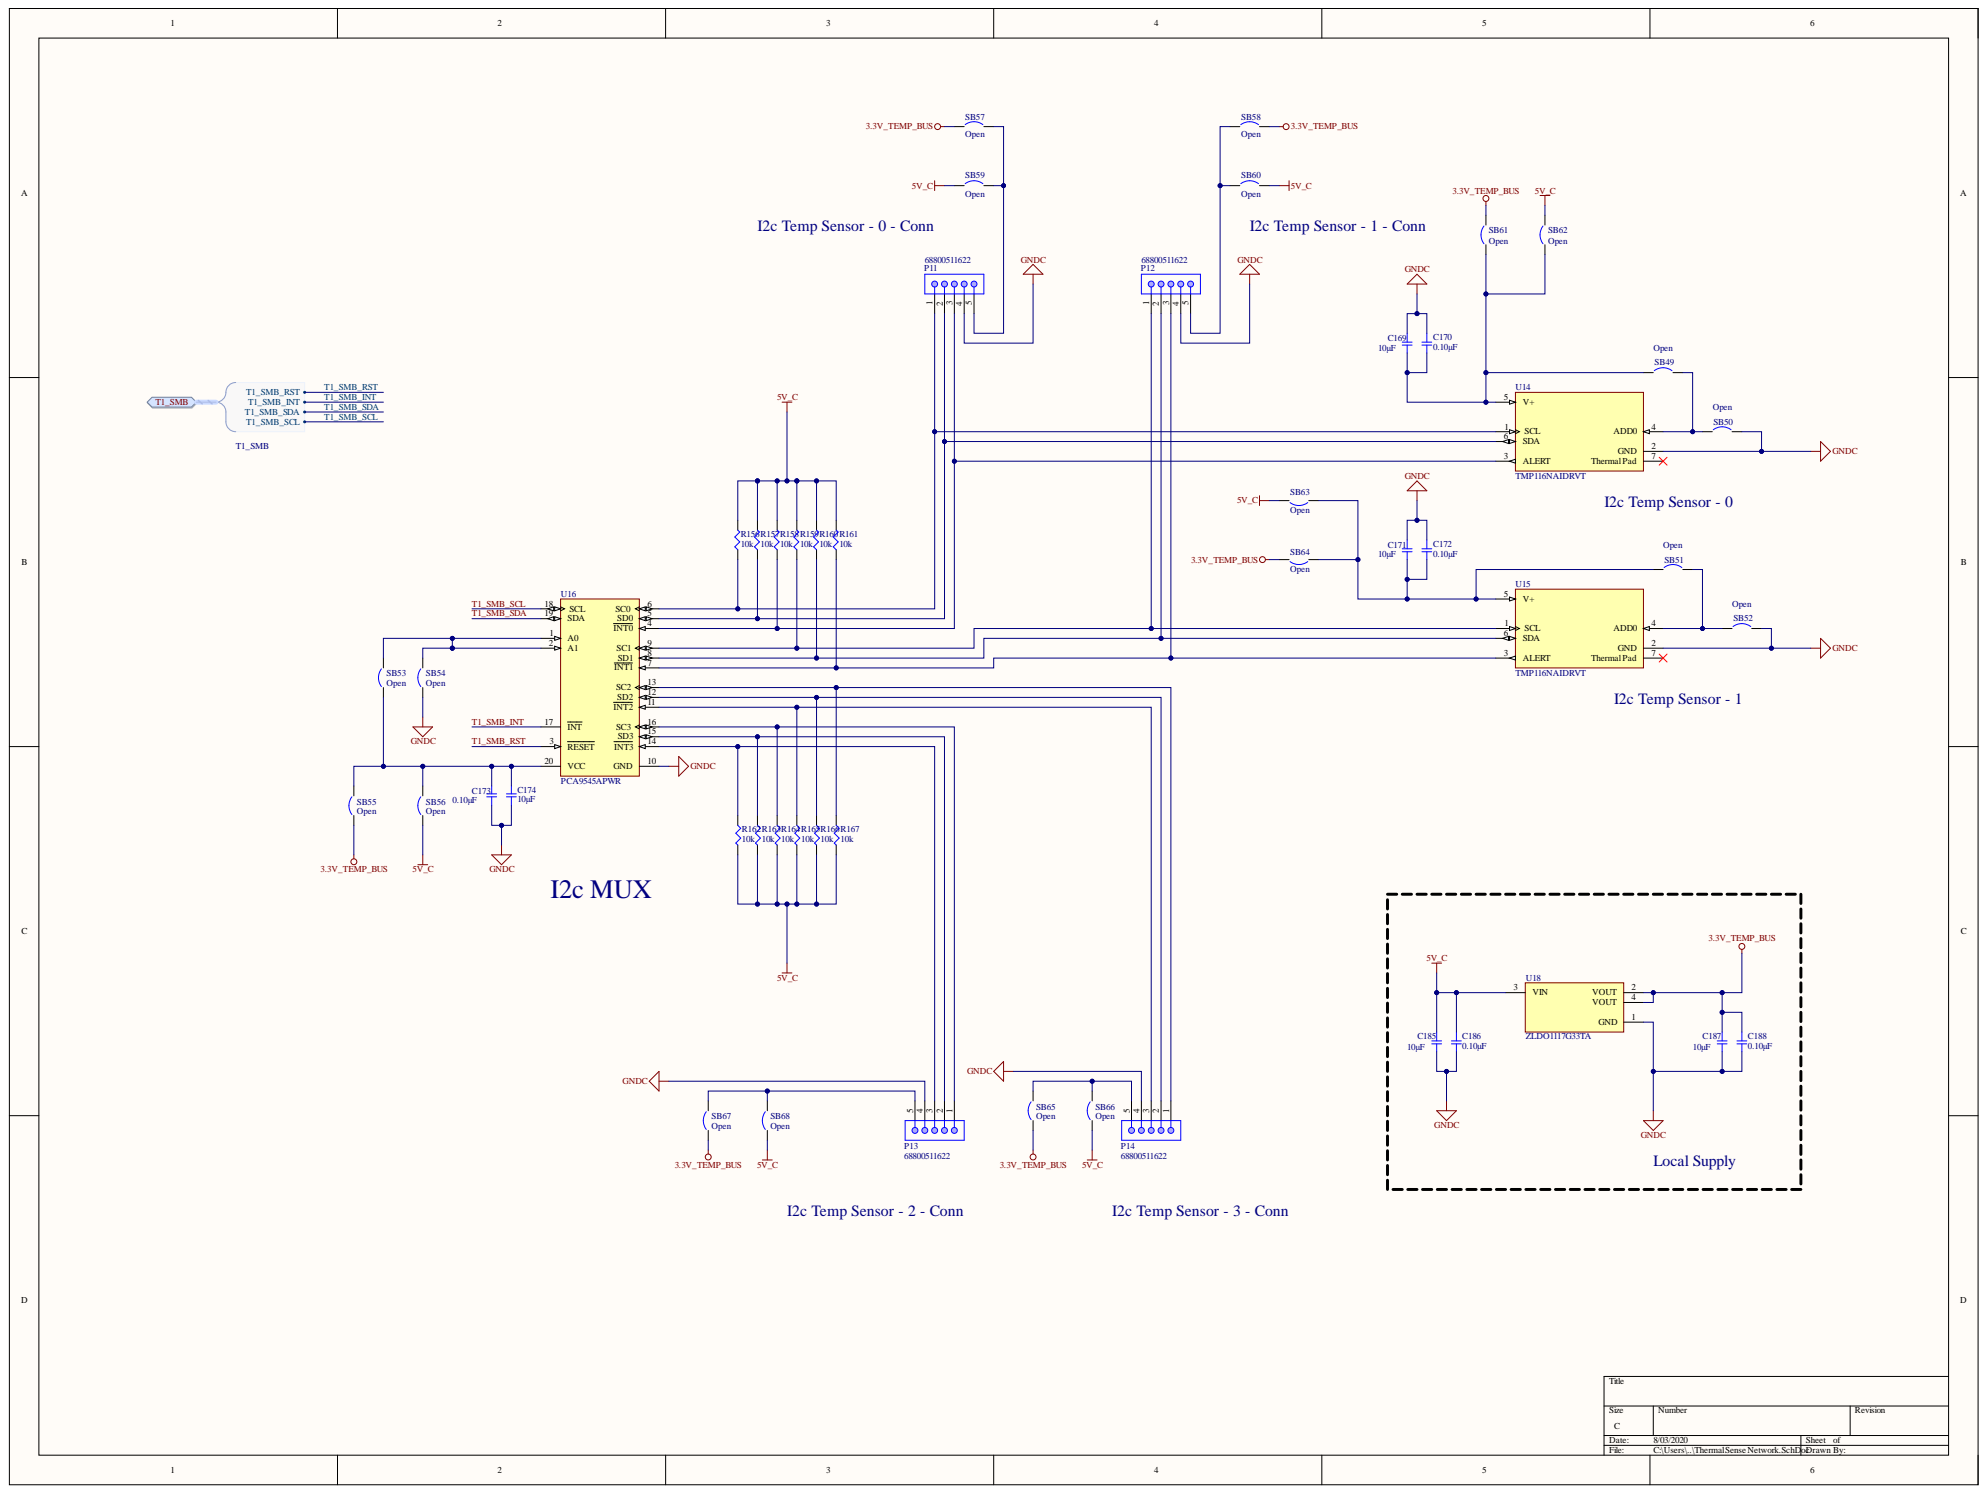
[picture p43: page 17]

SDA 6

ALERT 3
