g-rahul/5KW_OBC/Auxillary_Supply_UCC28740/Auxillary_Supply_UCC28740.pdf

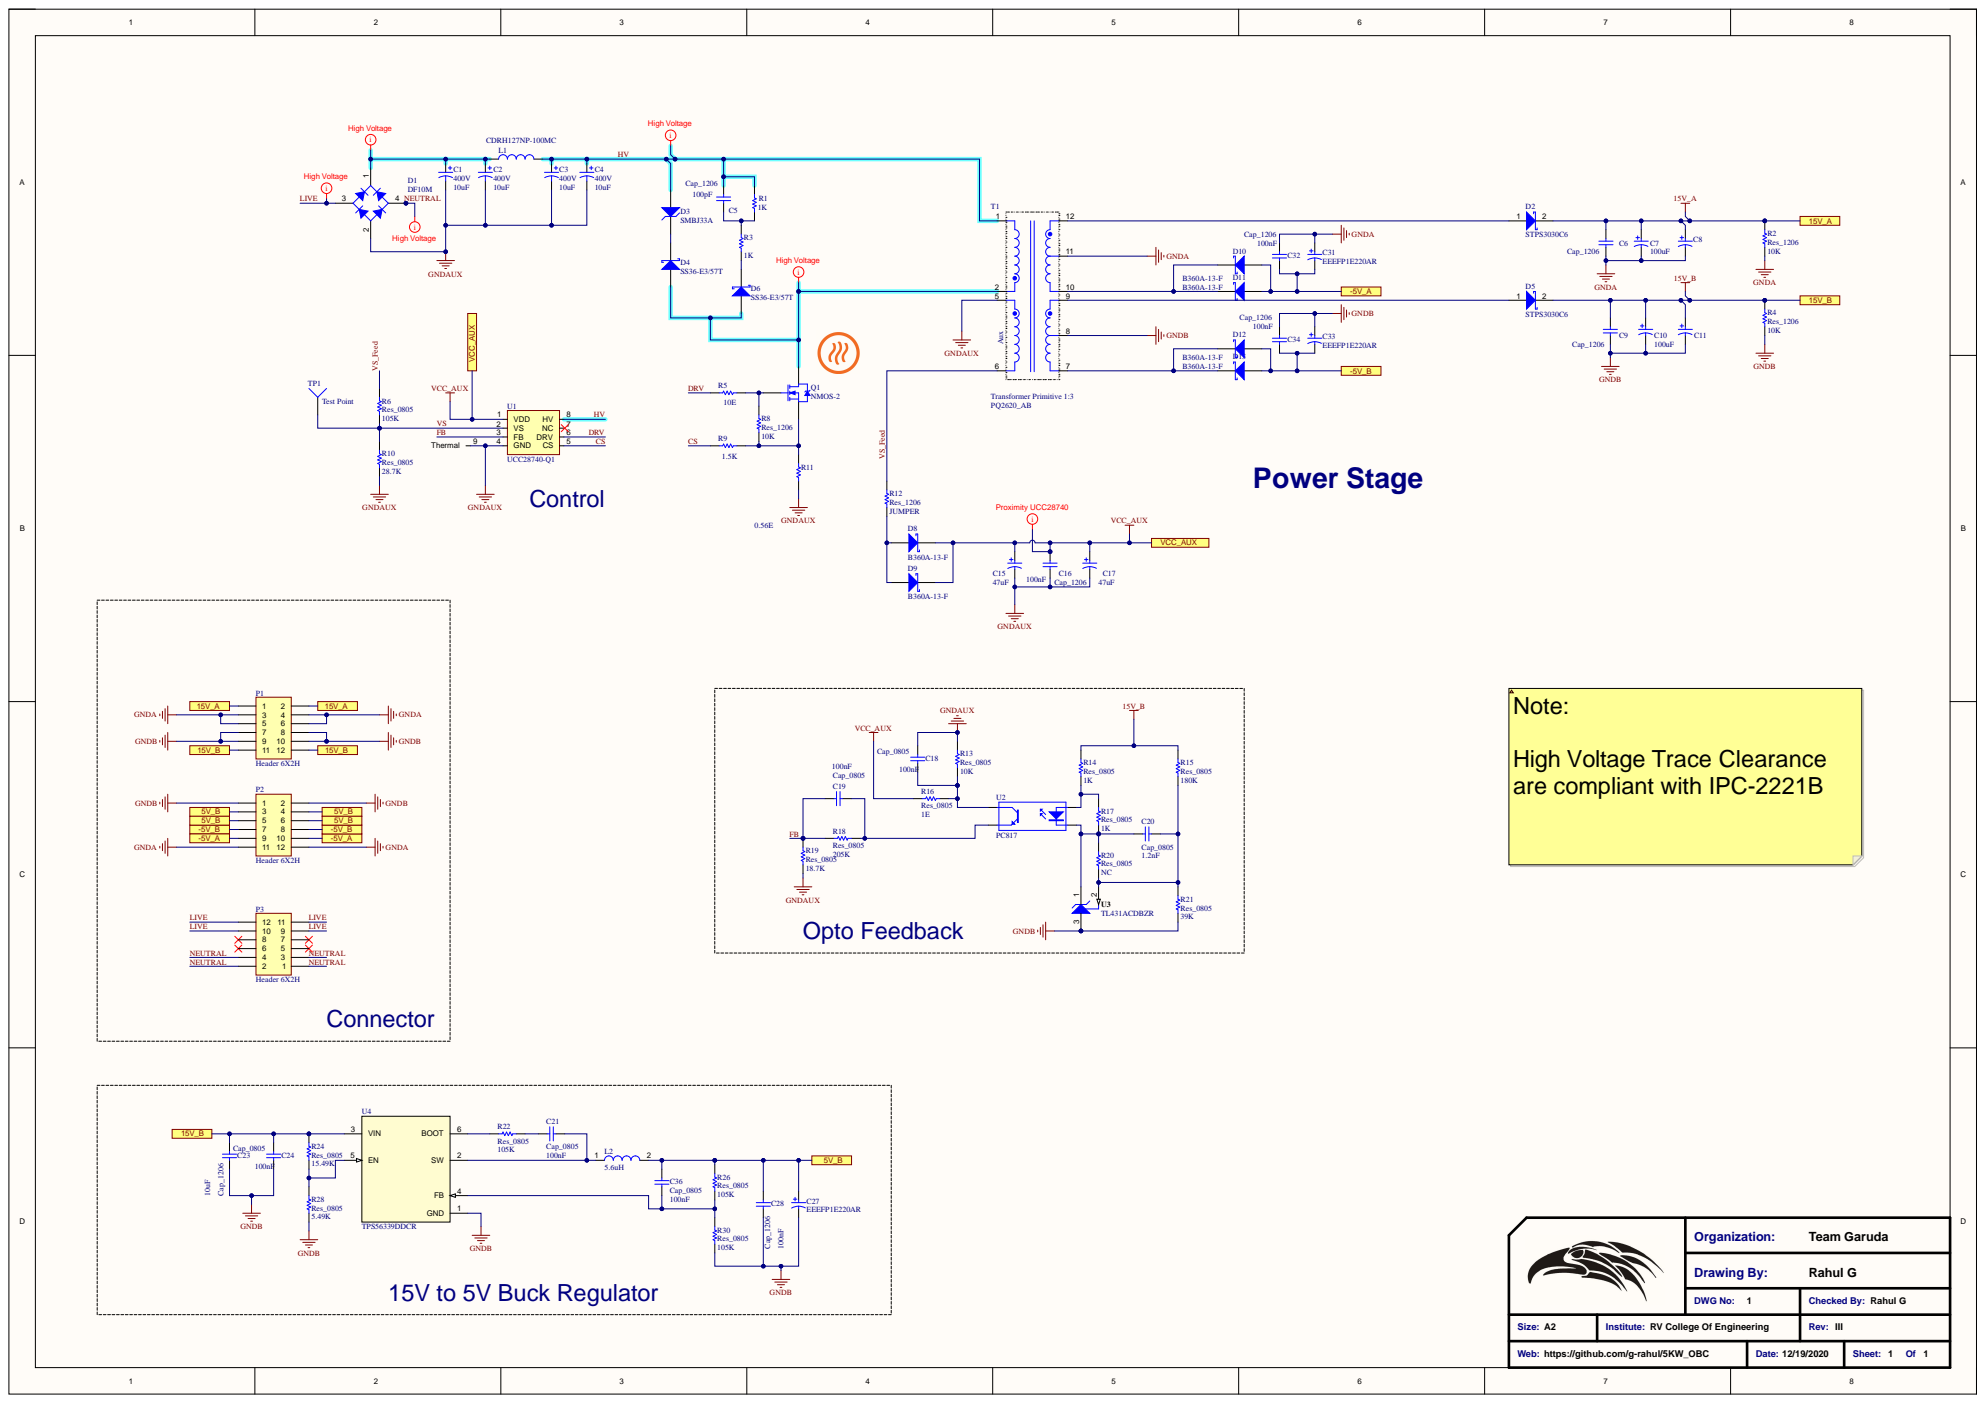
[picture p56: page 1]

High Voltage Trace Clearance
are compliant with IPC-2221B

DWG No: | Checked By: Rahul G

A 2 | Inst i tute: R V Col lege Of | Rev: I I I

ht tps: //gi thub.com /g-rahul /5KW_OB C | Date: 12/19/2020 | Sheet : 1 Of 1
