g-rahul/5KW_OBC/Power Board UCC28951/Power Board UCC28951.pdf

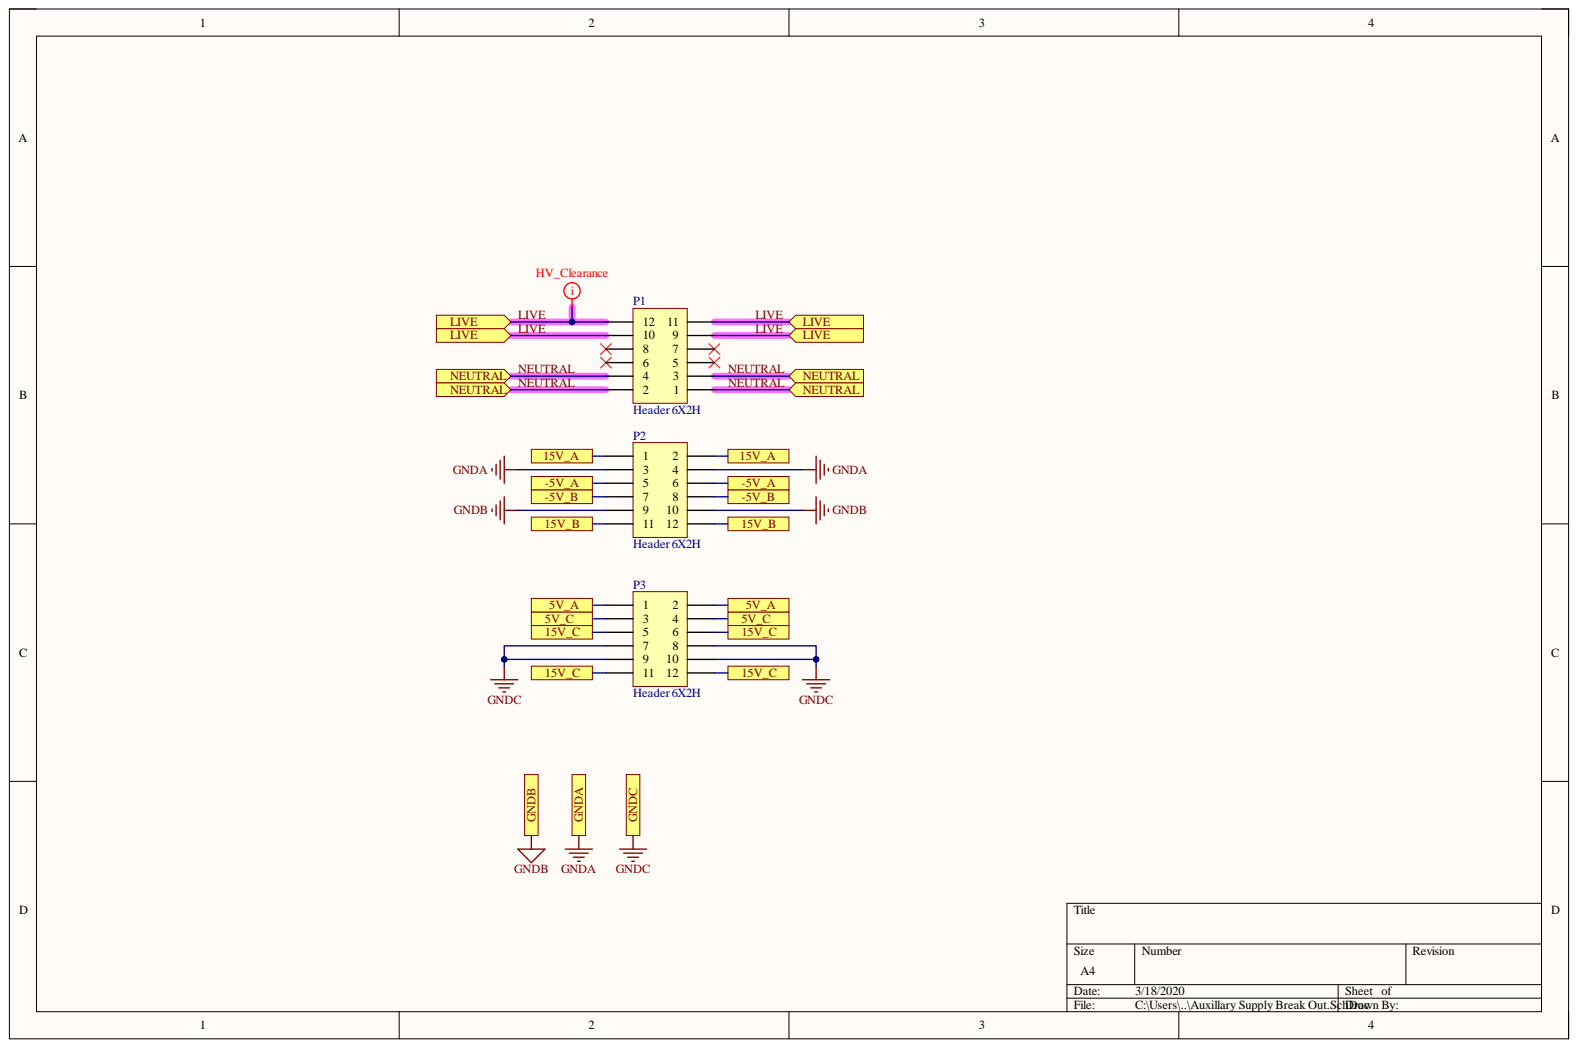
[picture p57: page 1]

5V_C | 5V_C
15V_C | 15V_C

Size A4 | Number | Revision

Date: 3/18/2020 | Sheet of
File: C:\Users\..\Auxillary Supply Break Out.SchDoc Drawn By:

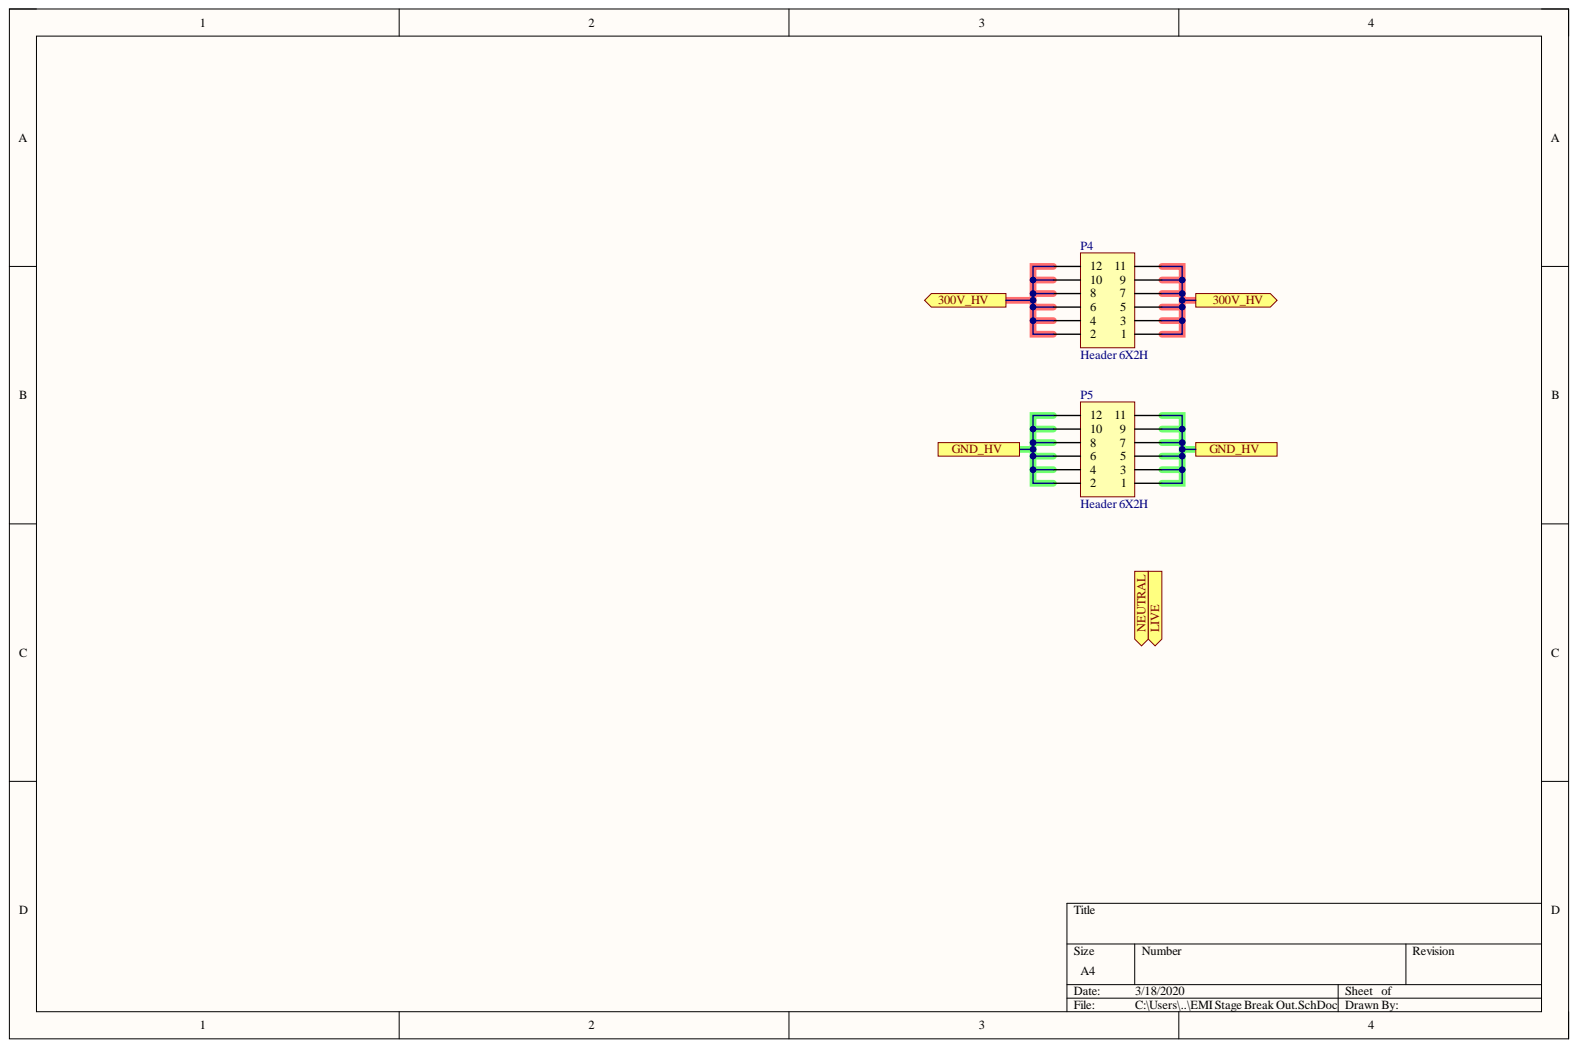
[picture p58: page 2]

Size A4 | Number | Revision

Date: 3/18/2020 | Sheet of
File: C:\Users\..\EMI Stage Break Out.SchDoc | Drawn By:

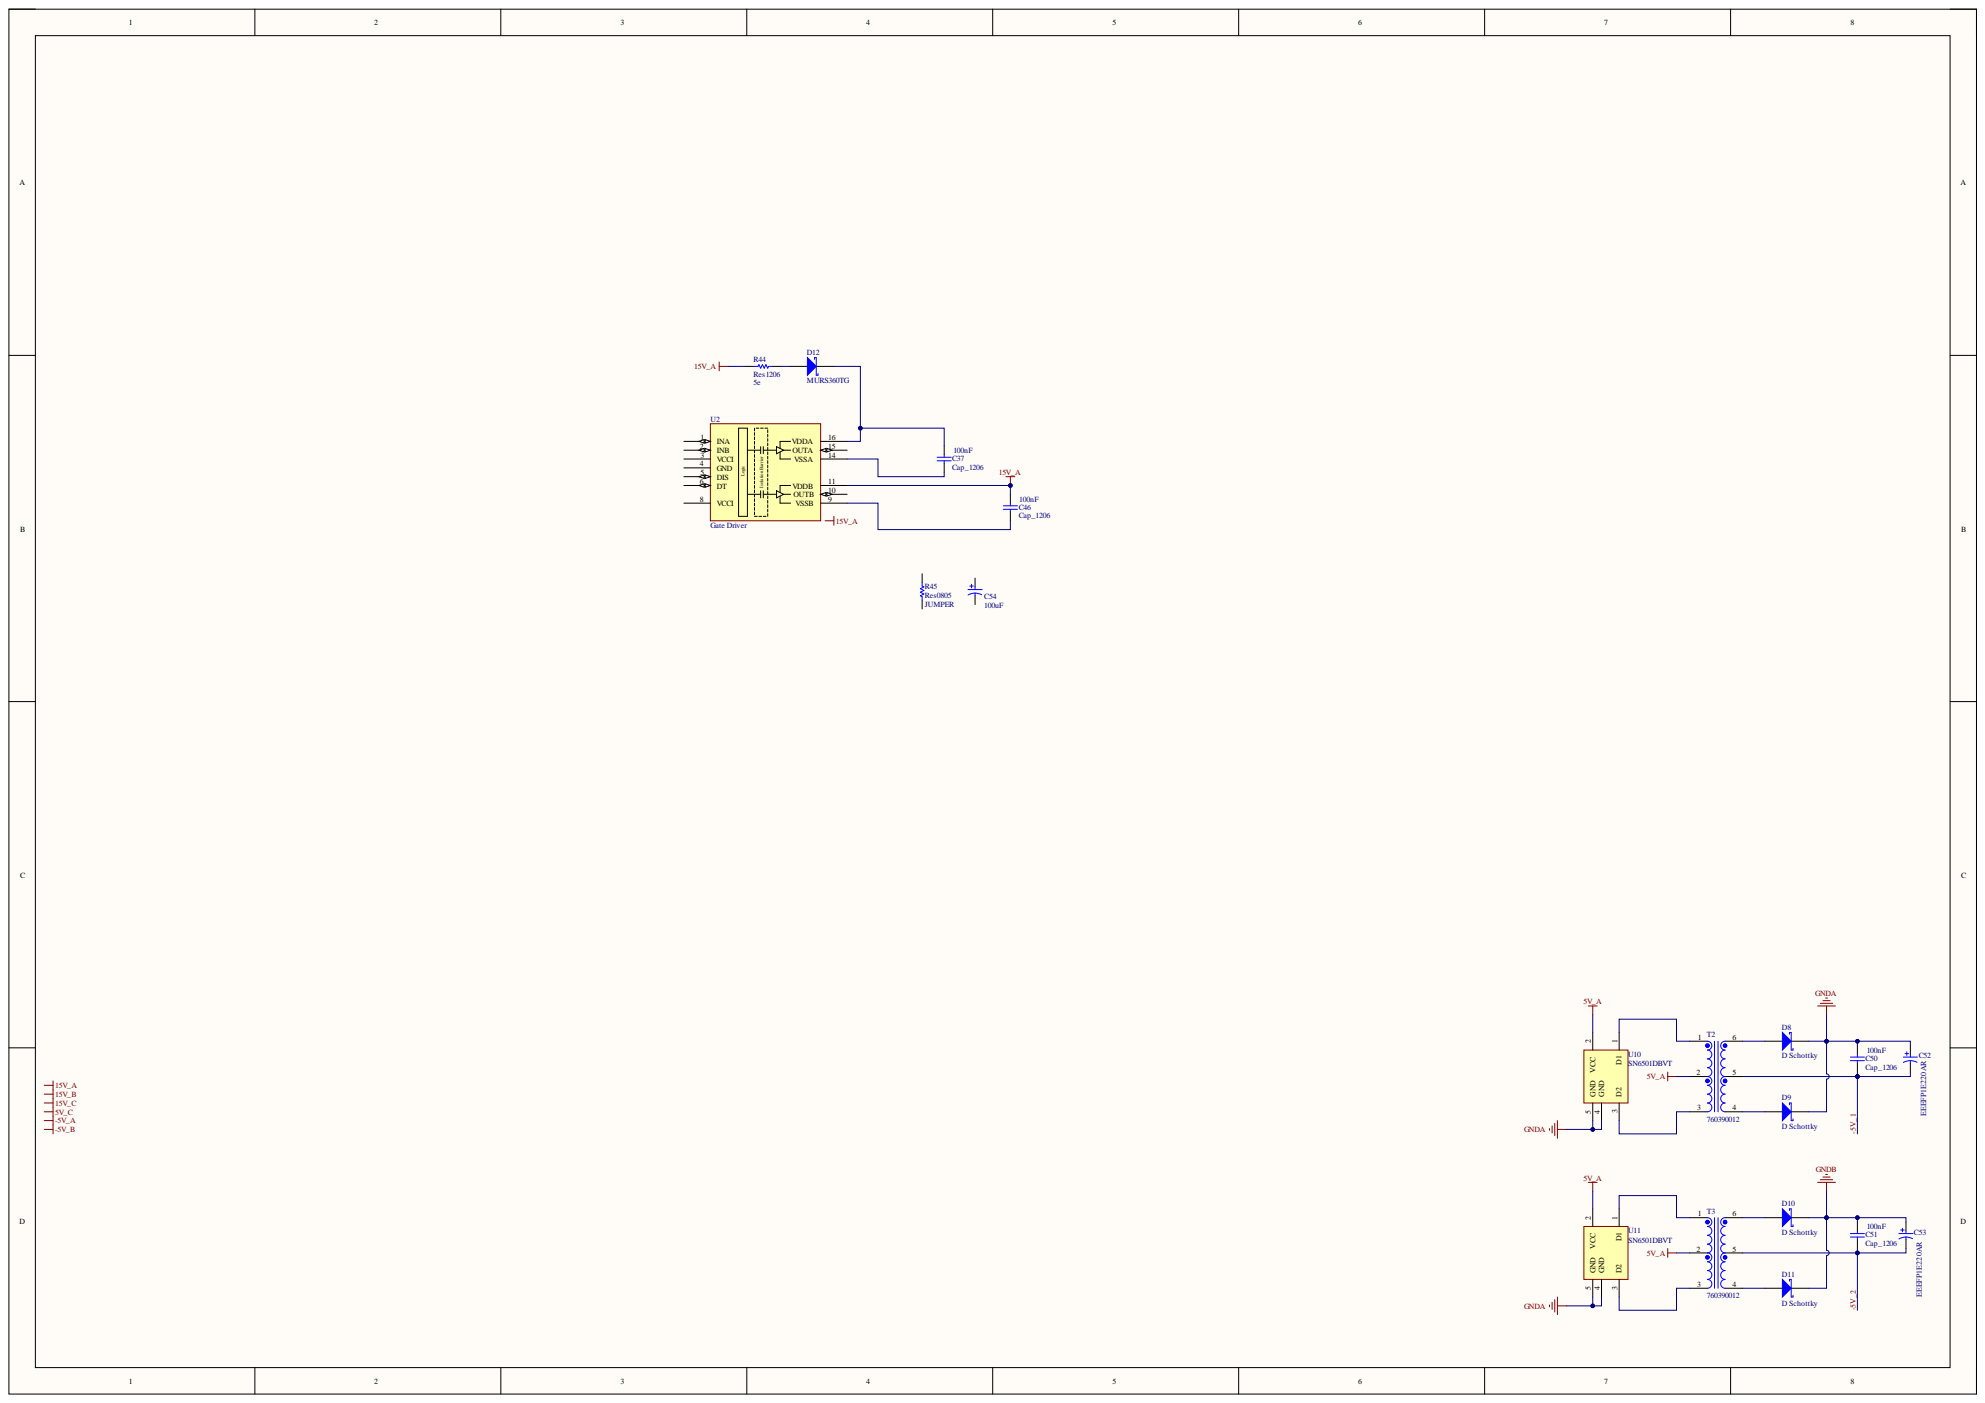
[picture p59: page 3]

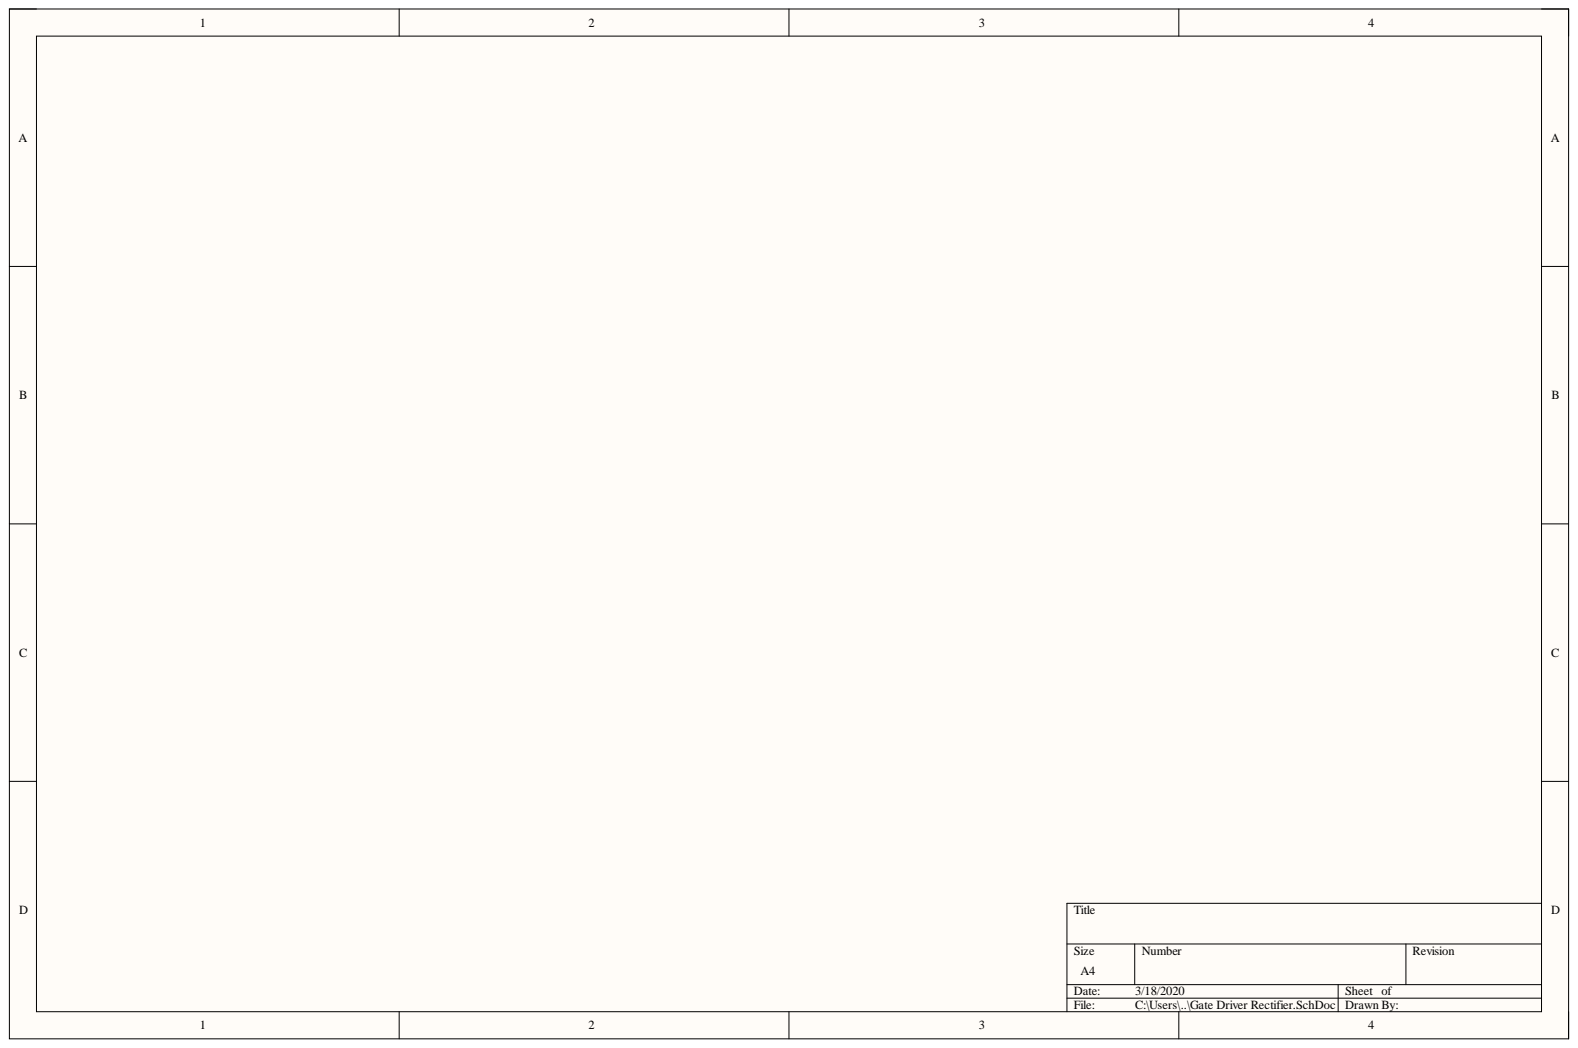
[picture p60: page 4]

Size A4 | Number | Revision

Date: 3/18/2020 | Sheet of
File: C:\Users\..\Gate Driver Rectifier.SchDoc | Drawn By:

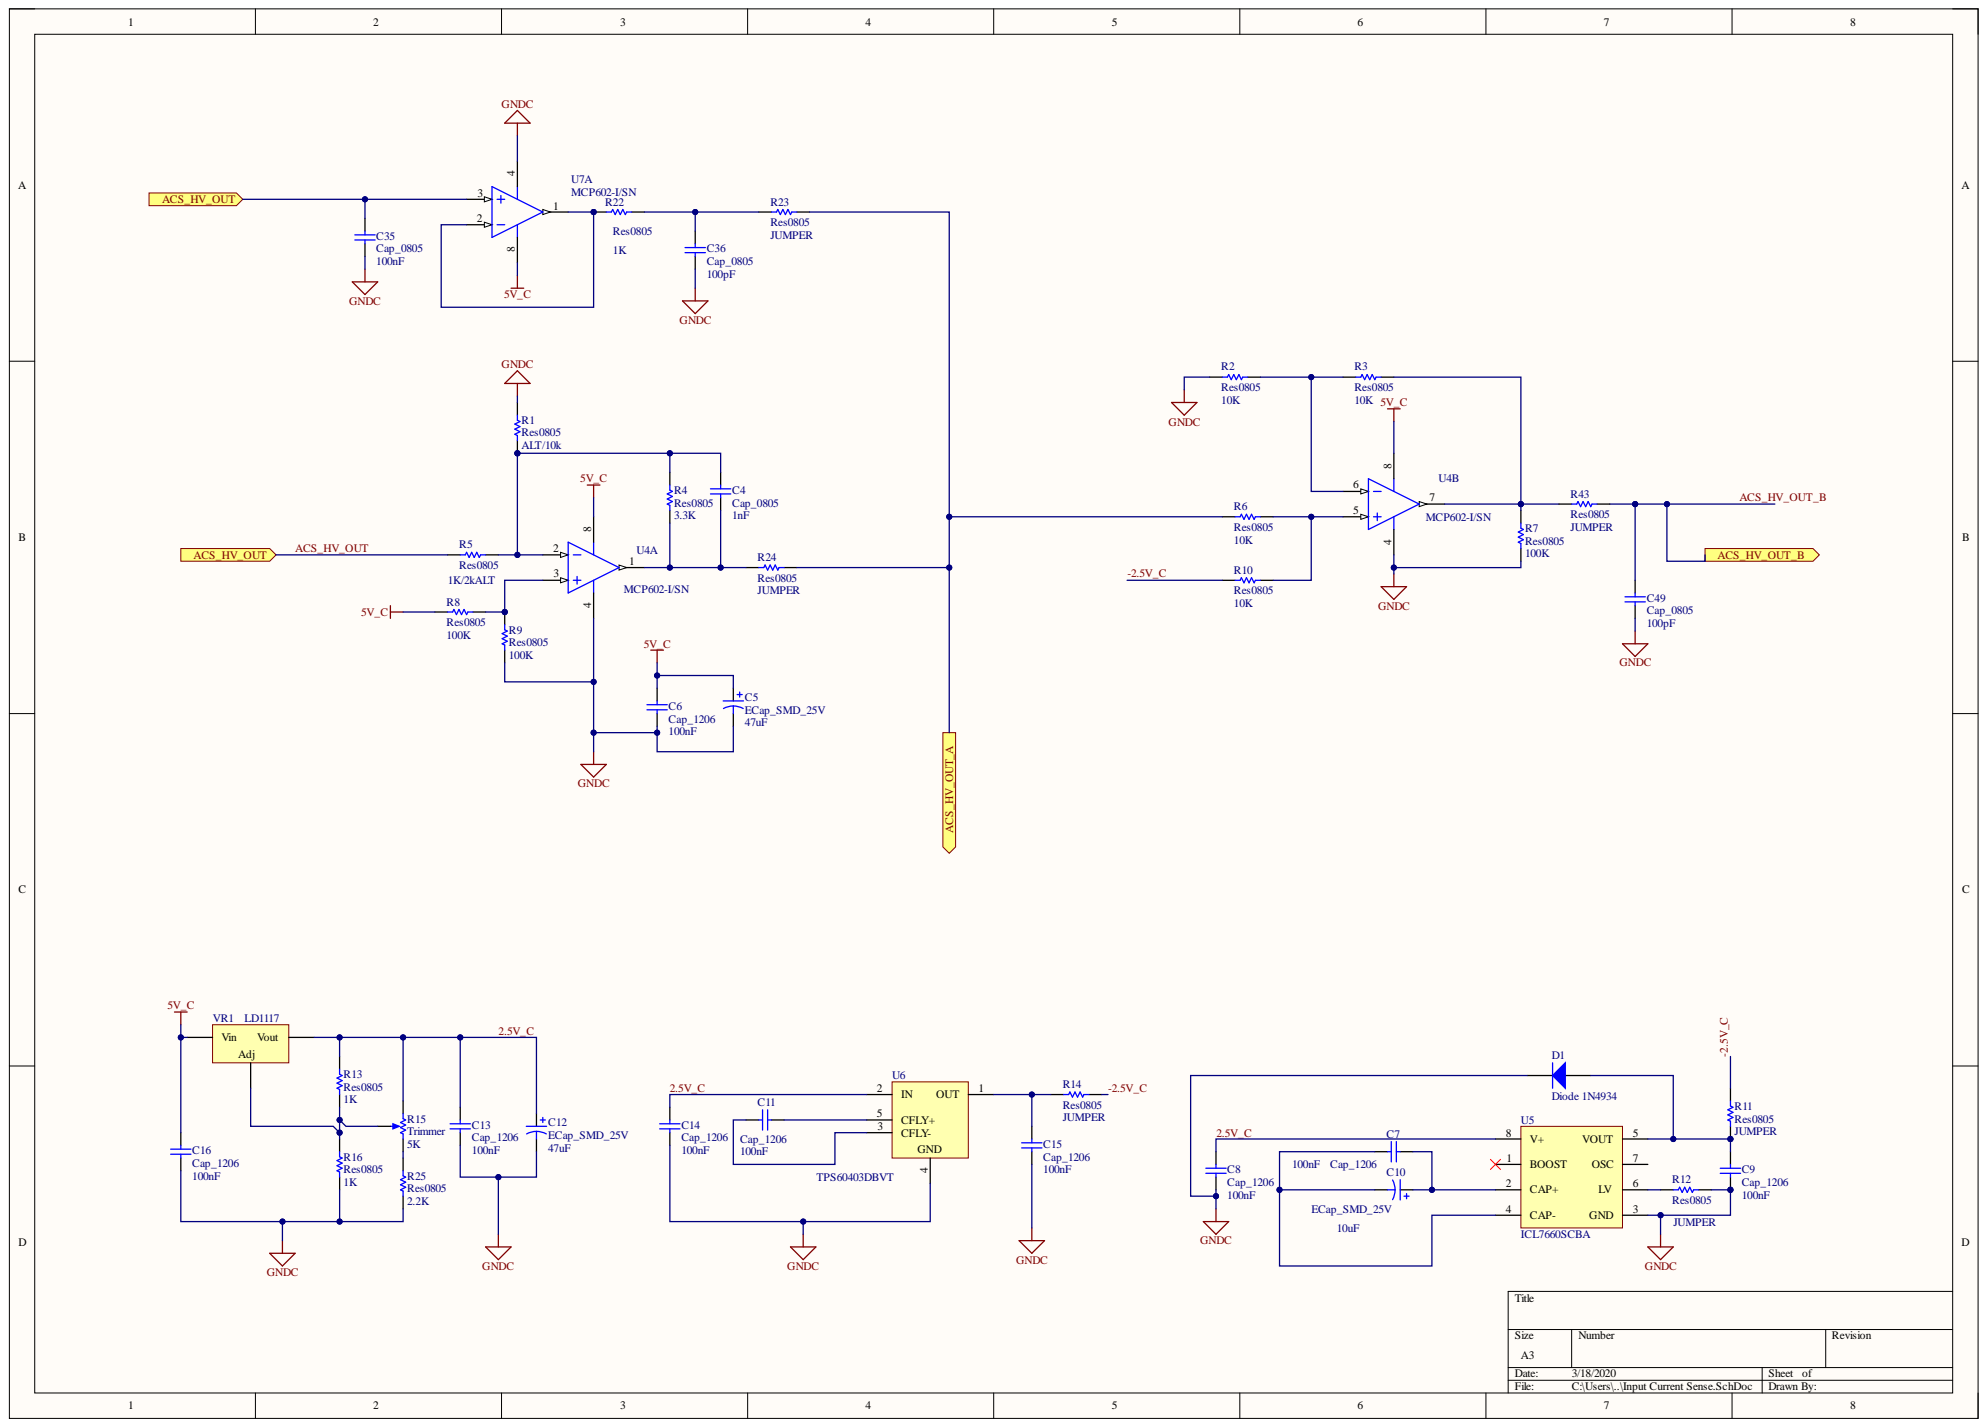
[picture p61: page 5]

R13 Res0805

C11 | CFLY+ 5

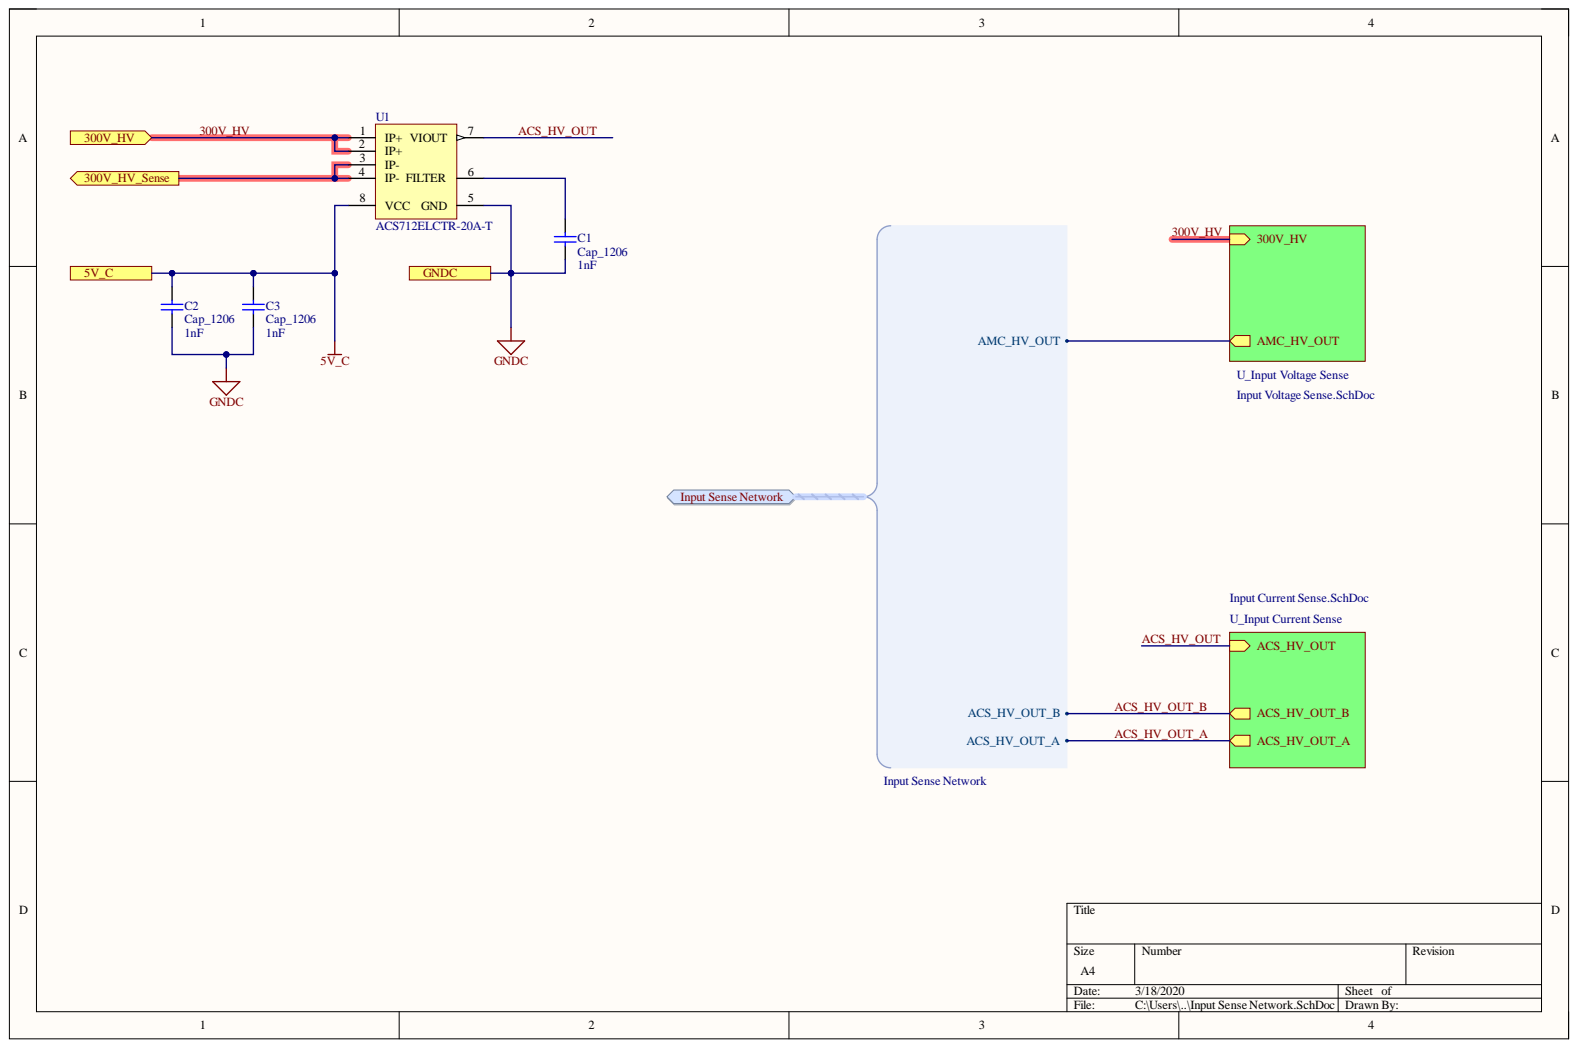
[picture p62: page 6]

IP+ 2
IP- 3
IP- 4

U_Input Voltage Sense
Input Voltage Sense.SchDoc

Input Current Sense.SchDoc
U_Input Current Sense

Size A4 | Number | Revision

Date: 3/18/2020 | Sheet of
File: C:\Users\..\Input Sense Network.SchDoc | Drawn By:

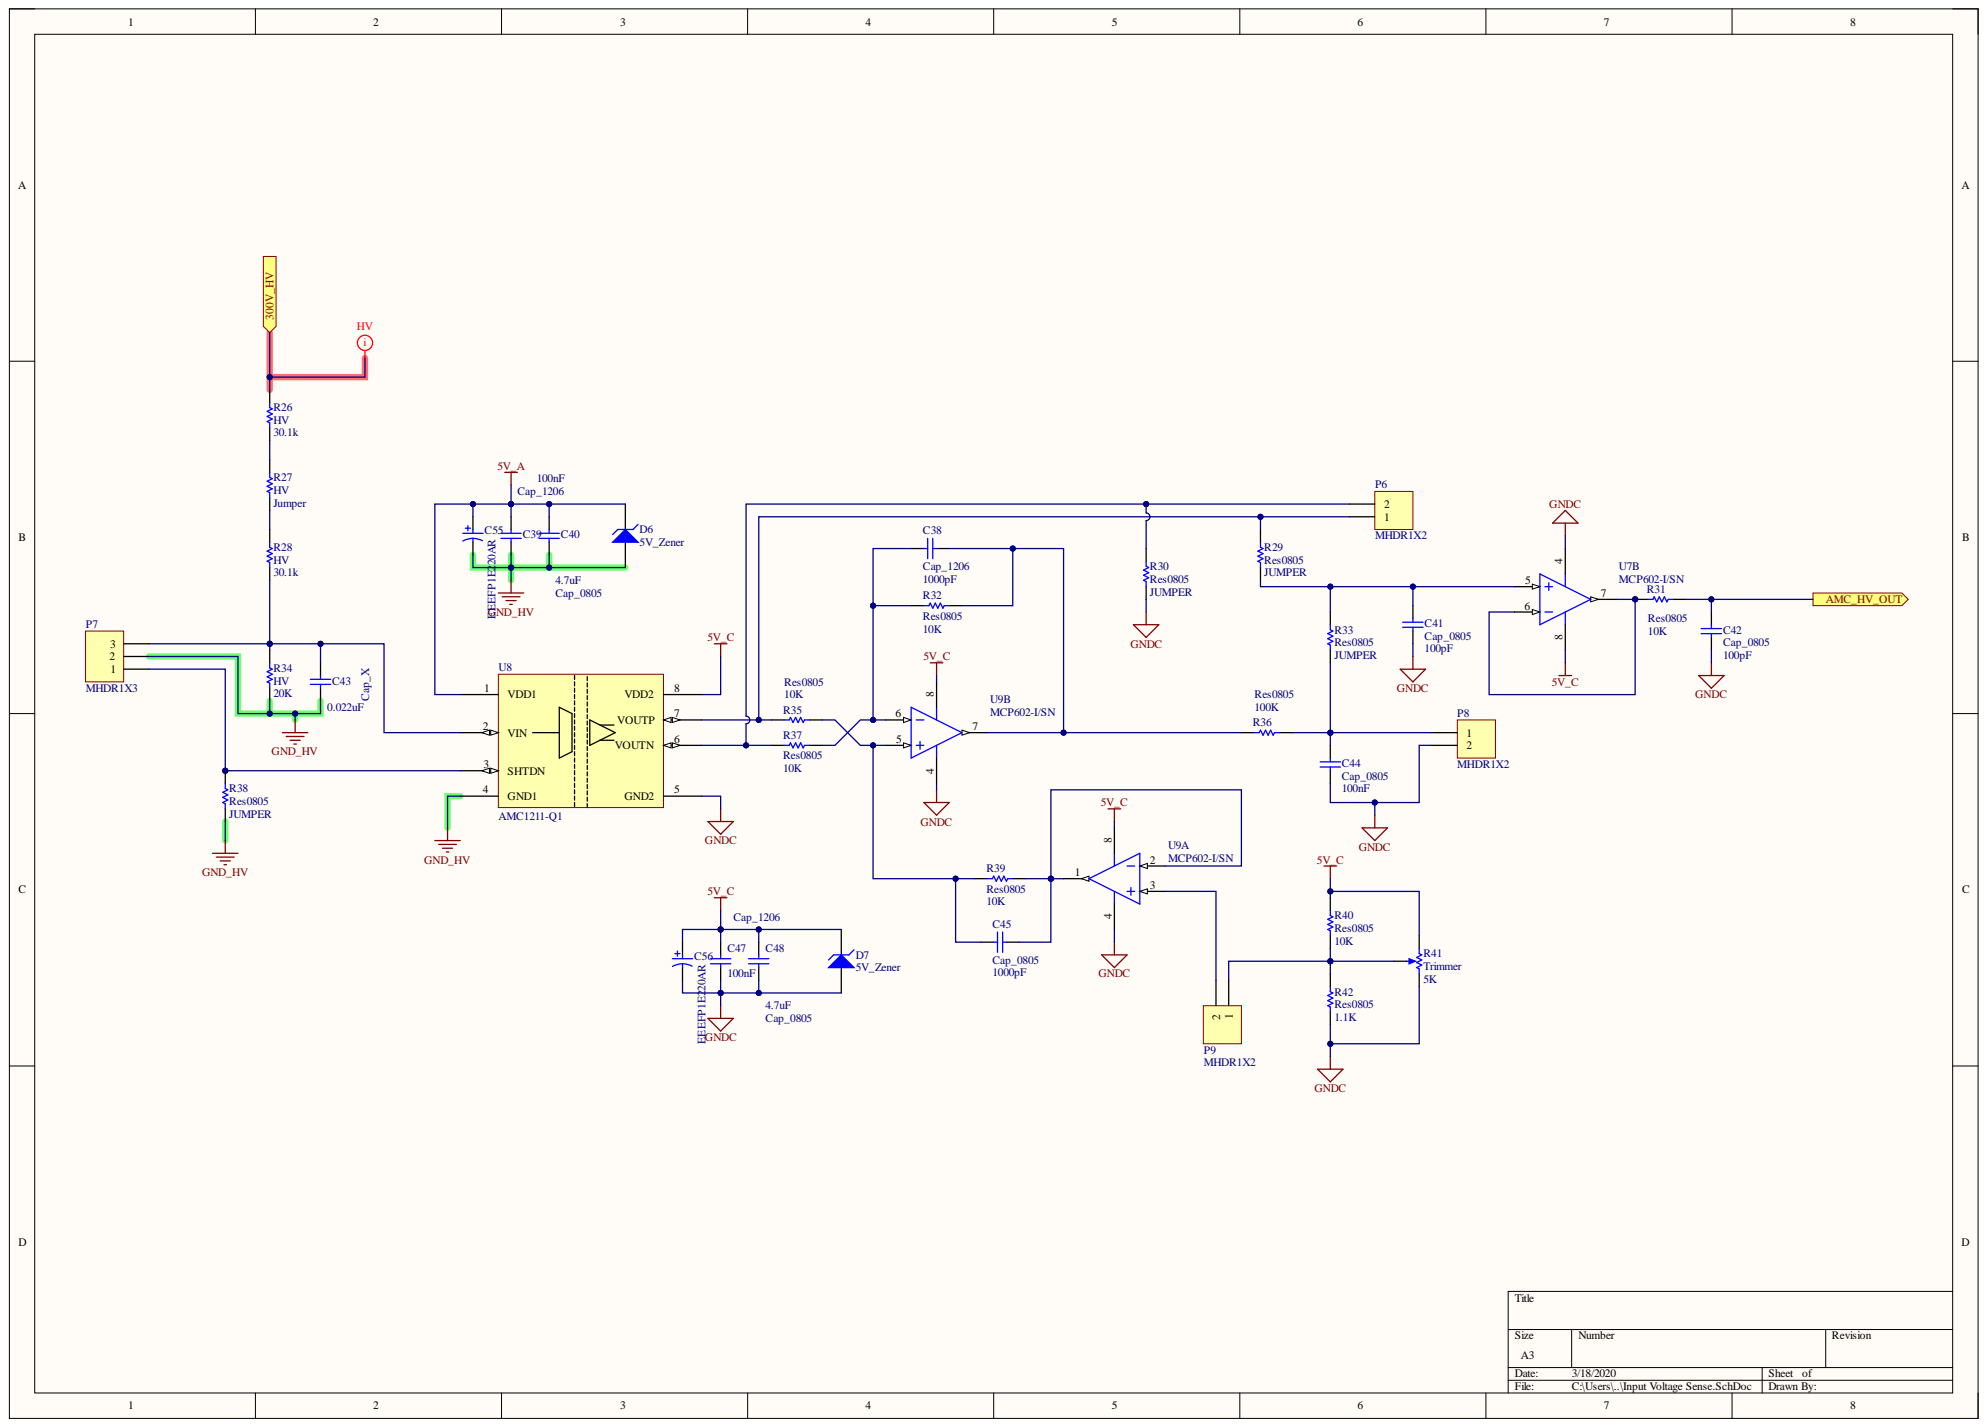
[picture p63: page 7]

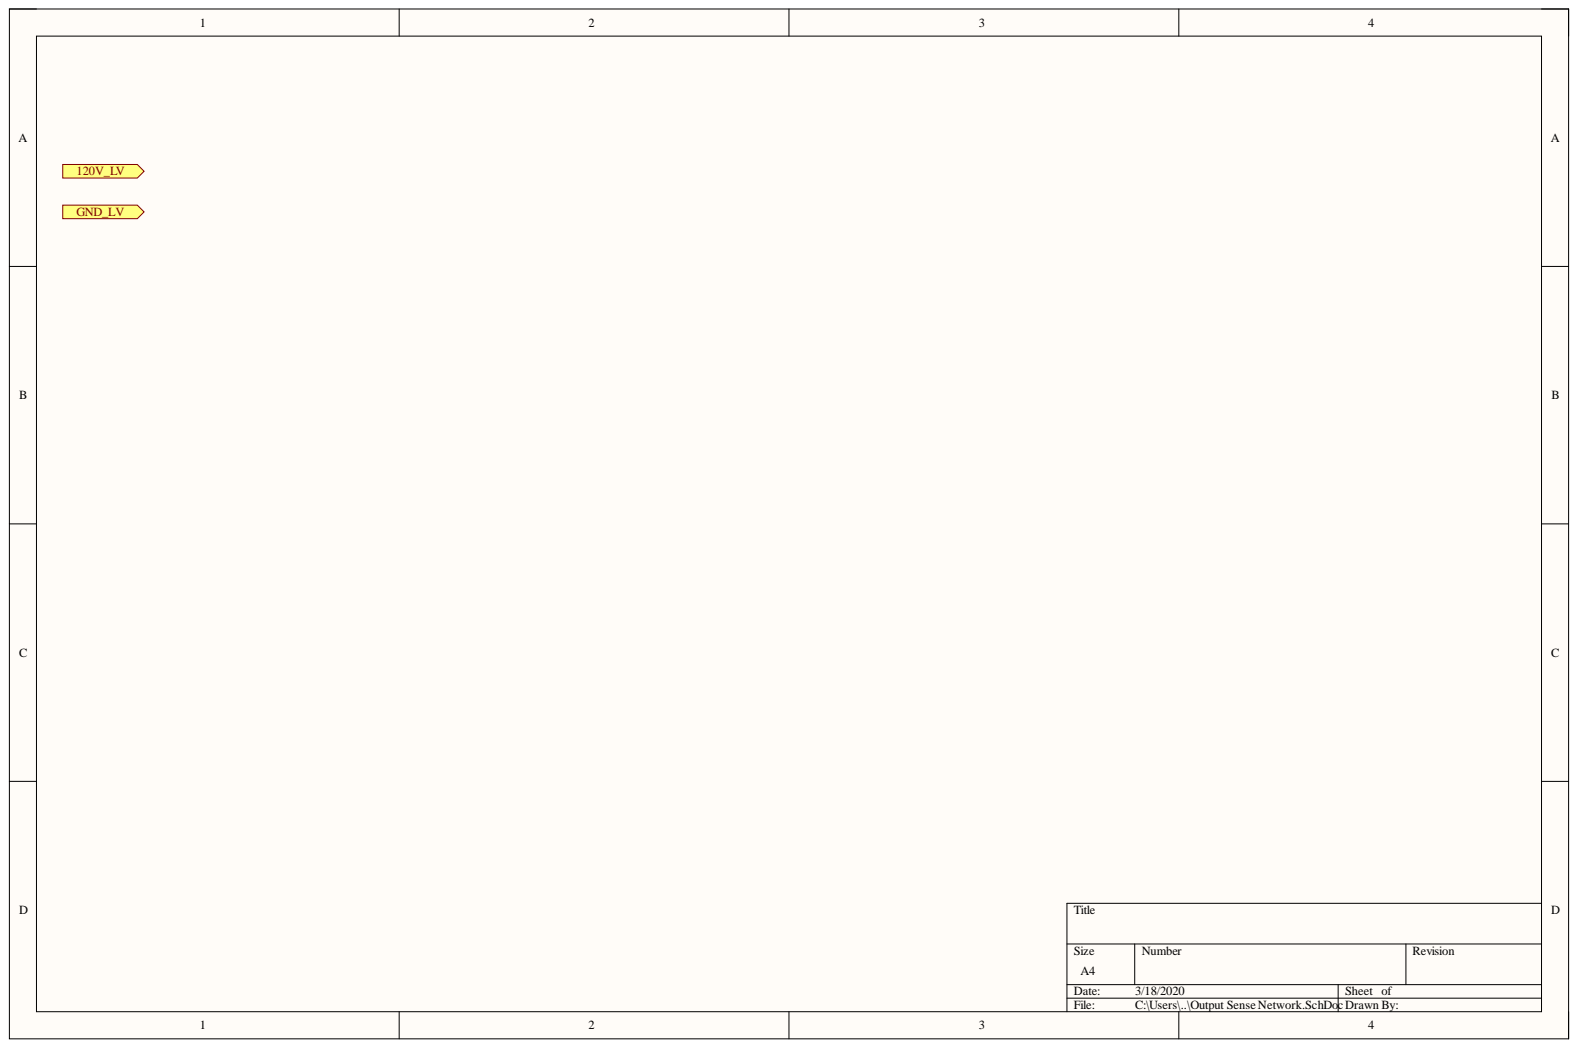
[picture p64: page 8]

Size A4 | Number | Revision

Date: 3/18/2020 | Sheet of
File: C:\Users\..\Output Sense Network.SchDocDrawn By:

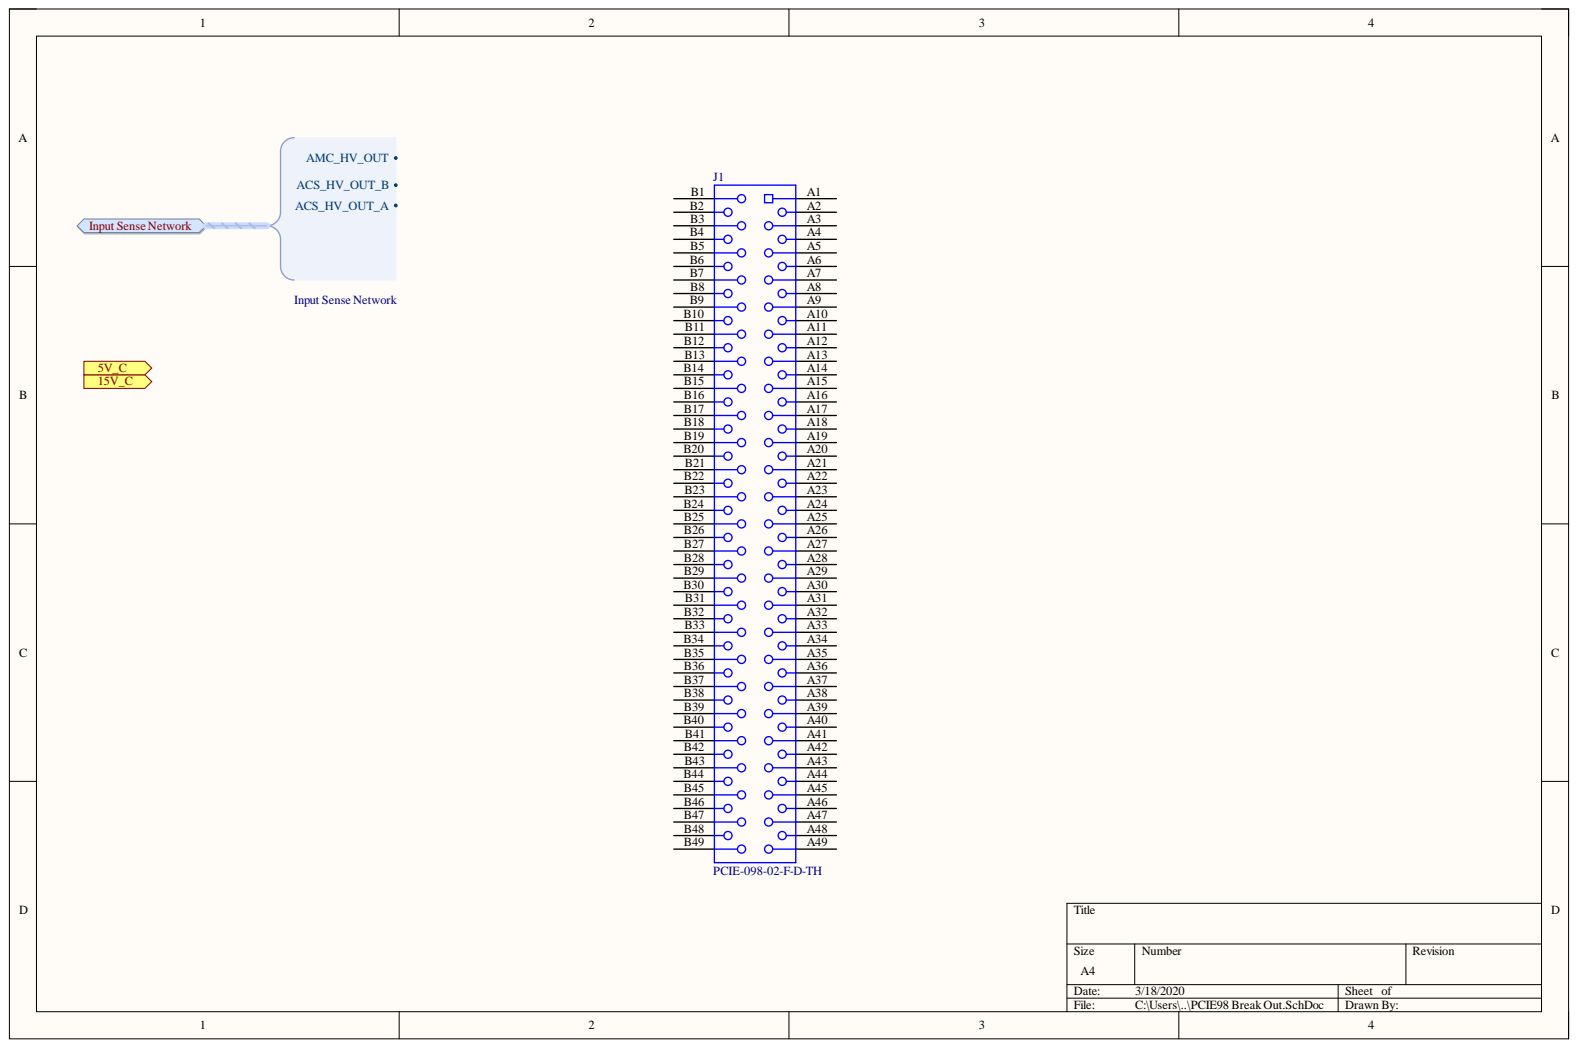
[picture p65: page 9]

Size A4 | Number | Revision

Date: 3/18/2020 | Sheet of
File: C:\Users\..\PCIE98 Break Out.SchDoc | Drawn By:

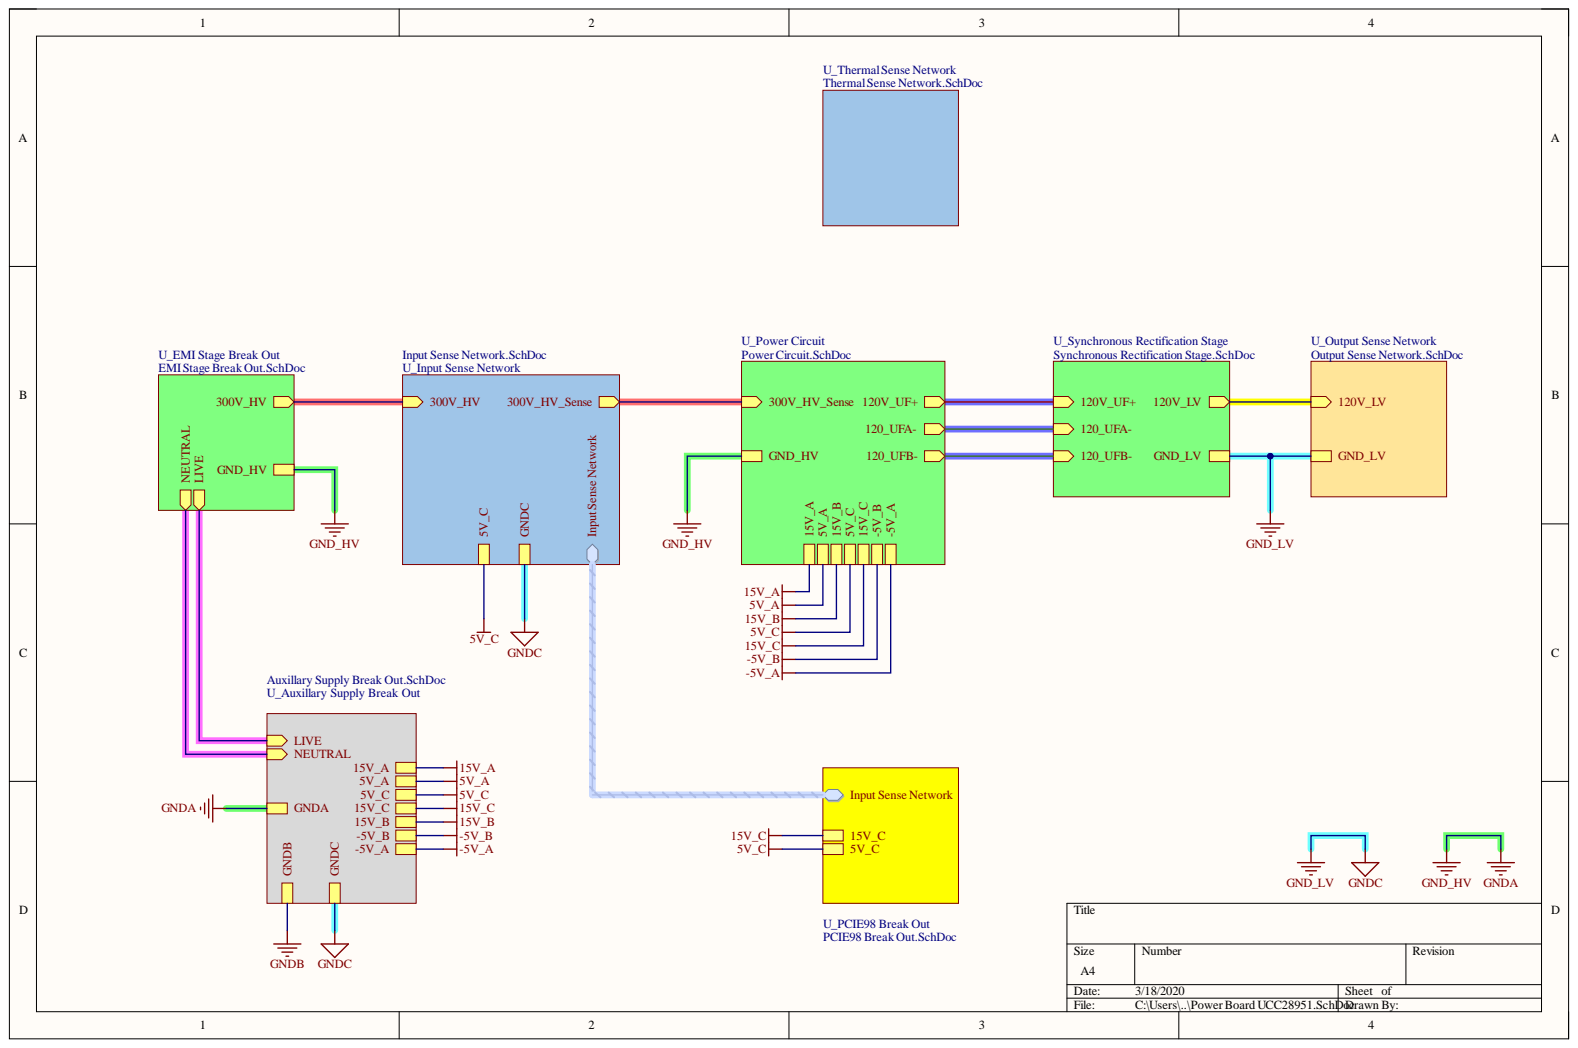
[picture p66: page 10]

U_Synchronous Rectification Stage
Synchronous Rectification Stage.SchDoc

U_Output Sense Network
Output Sense Network.SchDoc

U_EMI Stage Break Out
EMI Stage Break Out.SchDoc

Input Sense Network.SchDoc
U_Input Sense Network

Auxillary Supply Break Out.SchDoc
U_Auxillary Supply Break Out

LIVE NEUTRAL

Input Sense Network

Size A4 | Number | Revision

Date: 3/18/2020 | Sheet of
File: C:\Users\..\Power Board UCC28951.SchDoDrc awn By:

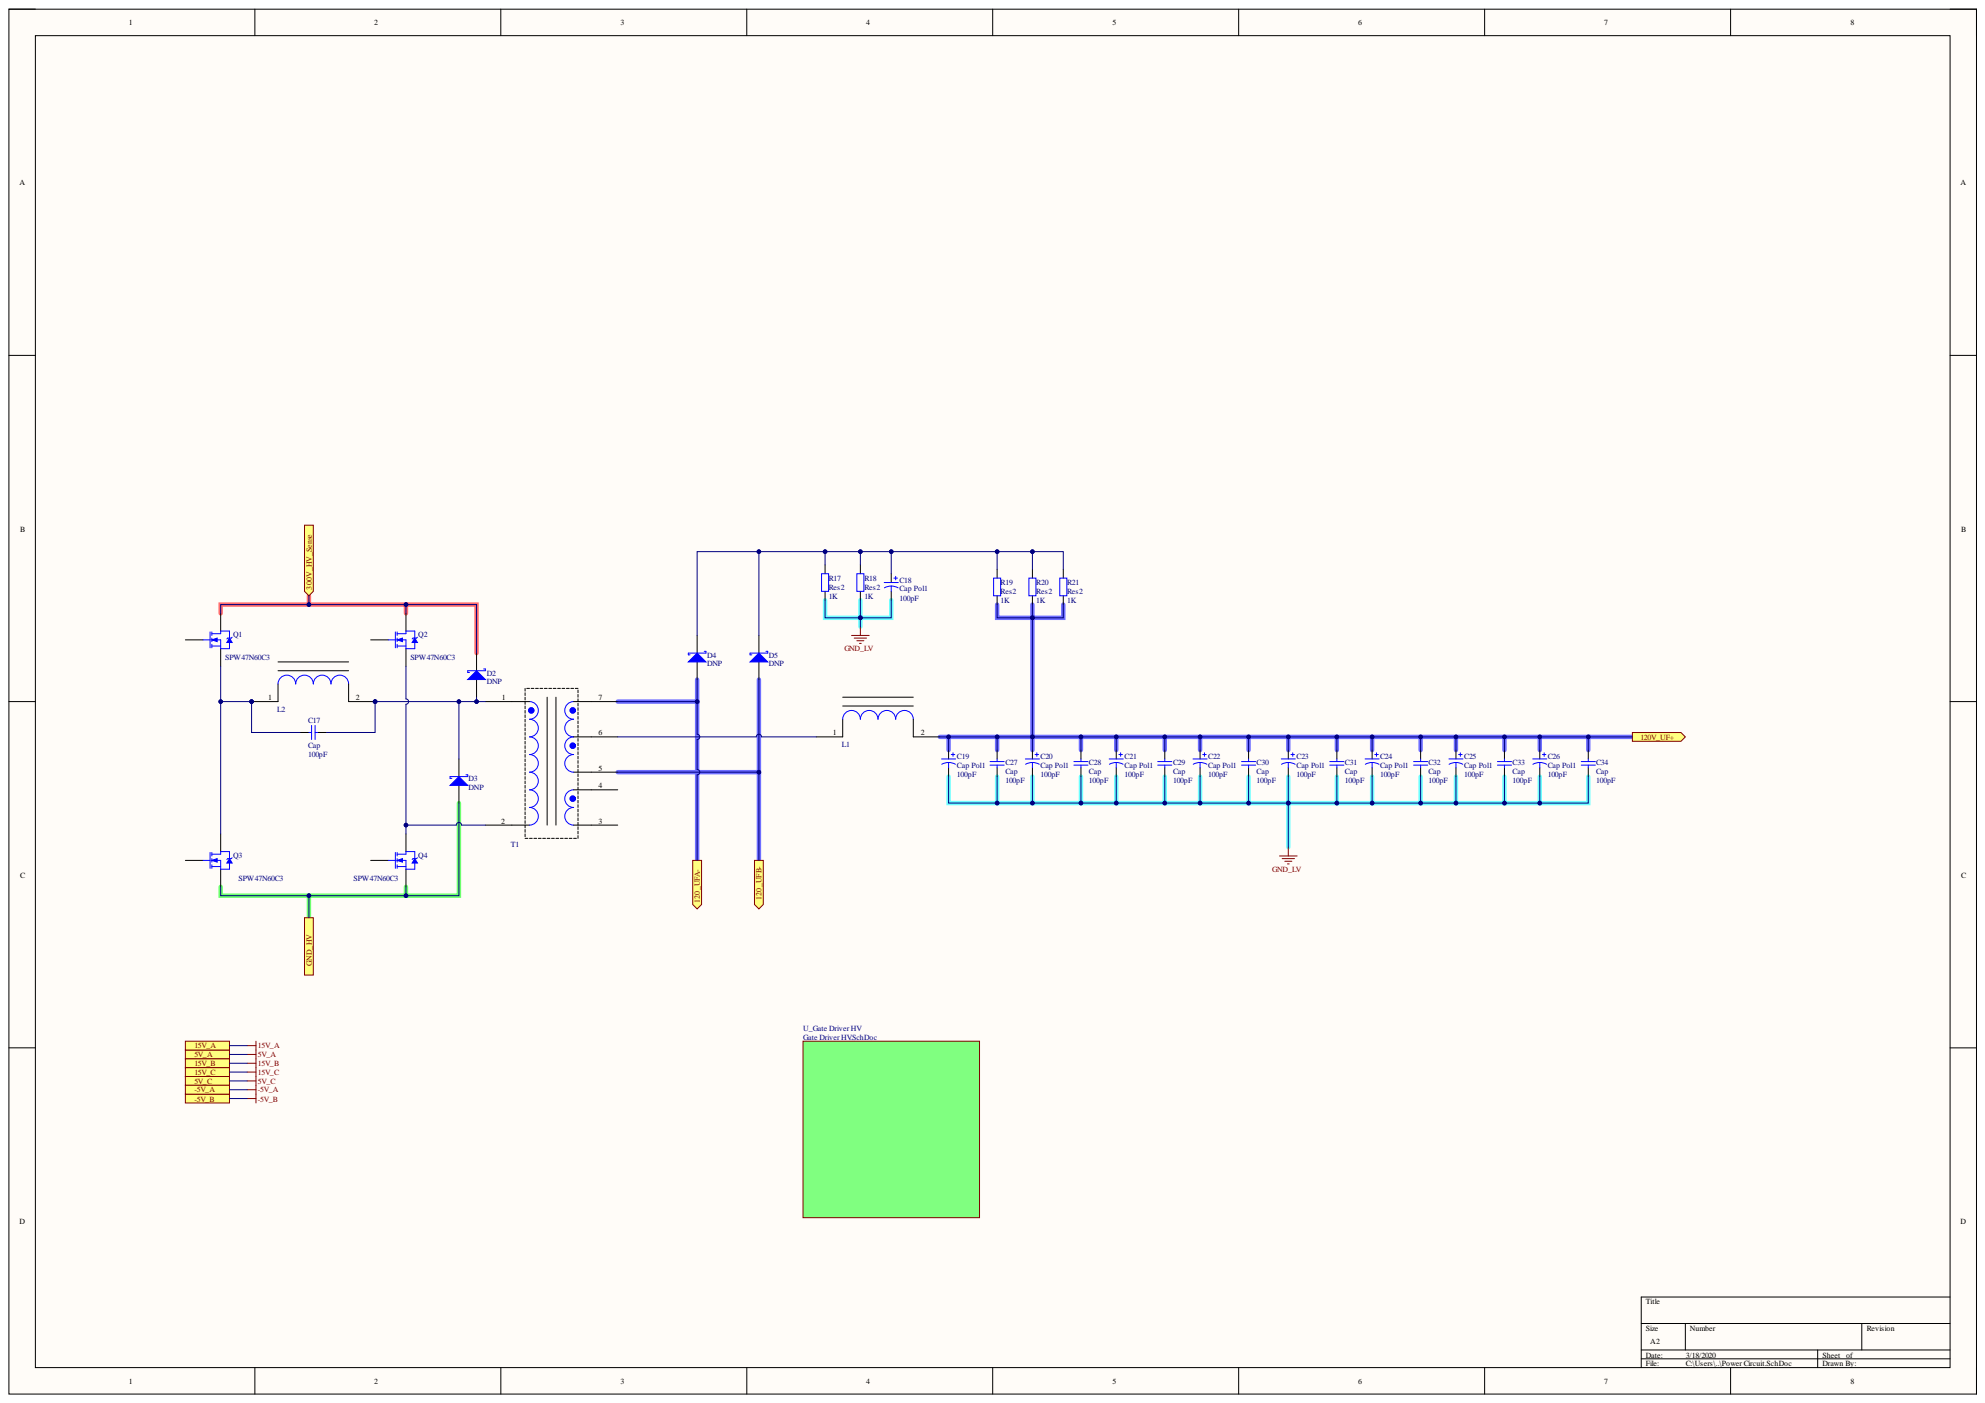
[picture p67: page 11]

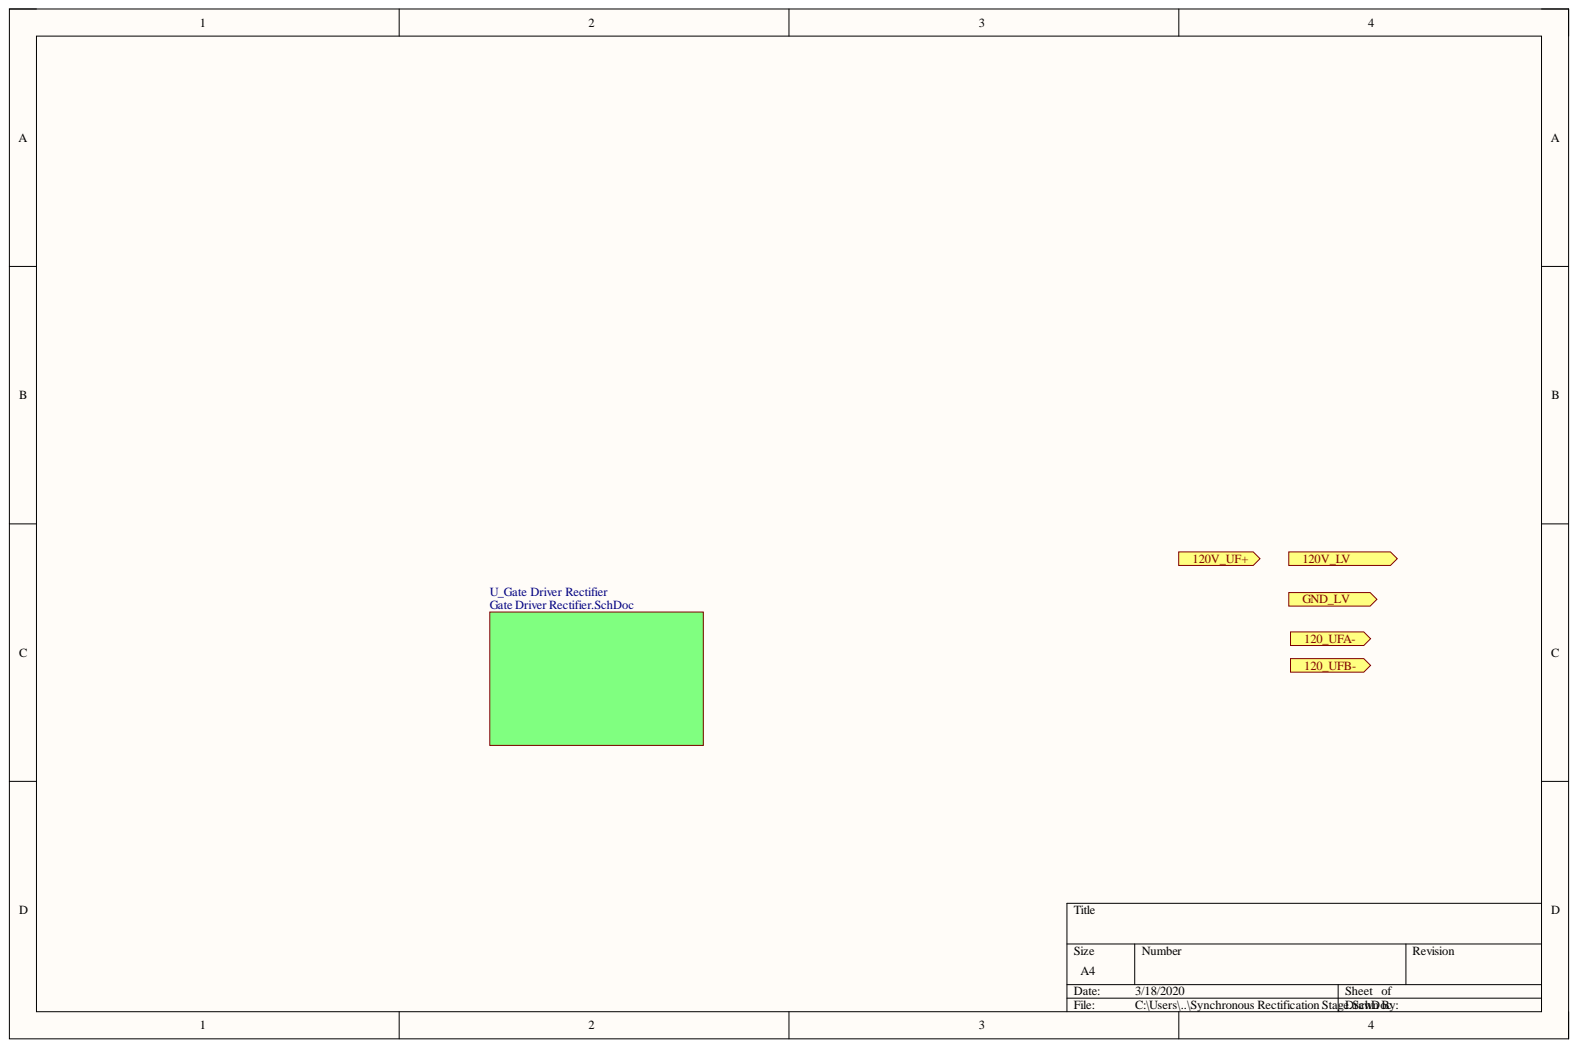
[picture p68: page 12]

U_Gate Driver Rectifier
Gate Driver Rectifier.SchDoc

Size A4 | Number | Revision

Date: 3/18/2020 | Sheet of
File: C:\Users\..\Synchronous Rectification StageDr.Sacwn hDocBy:

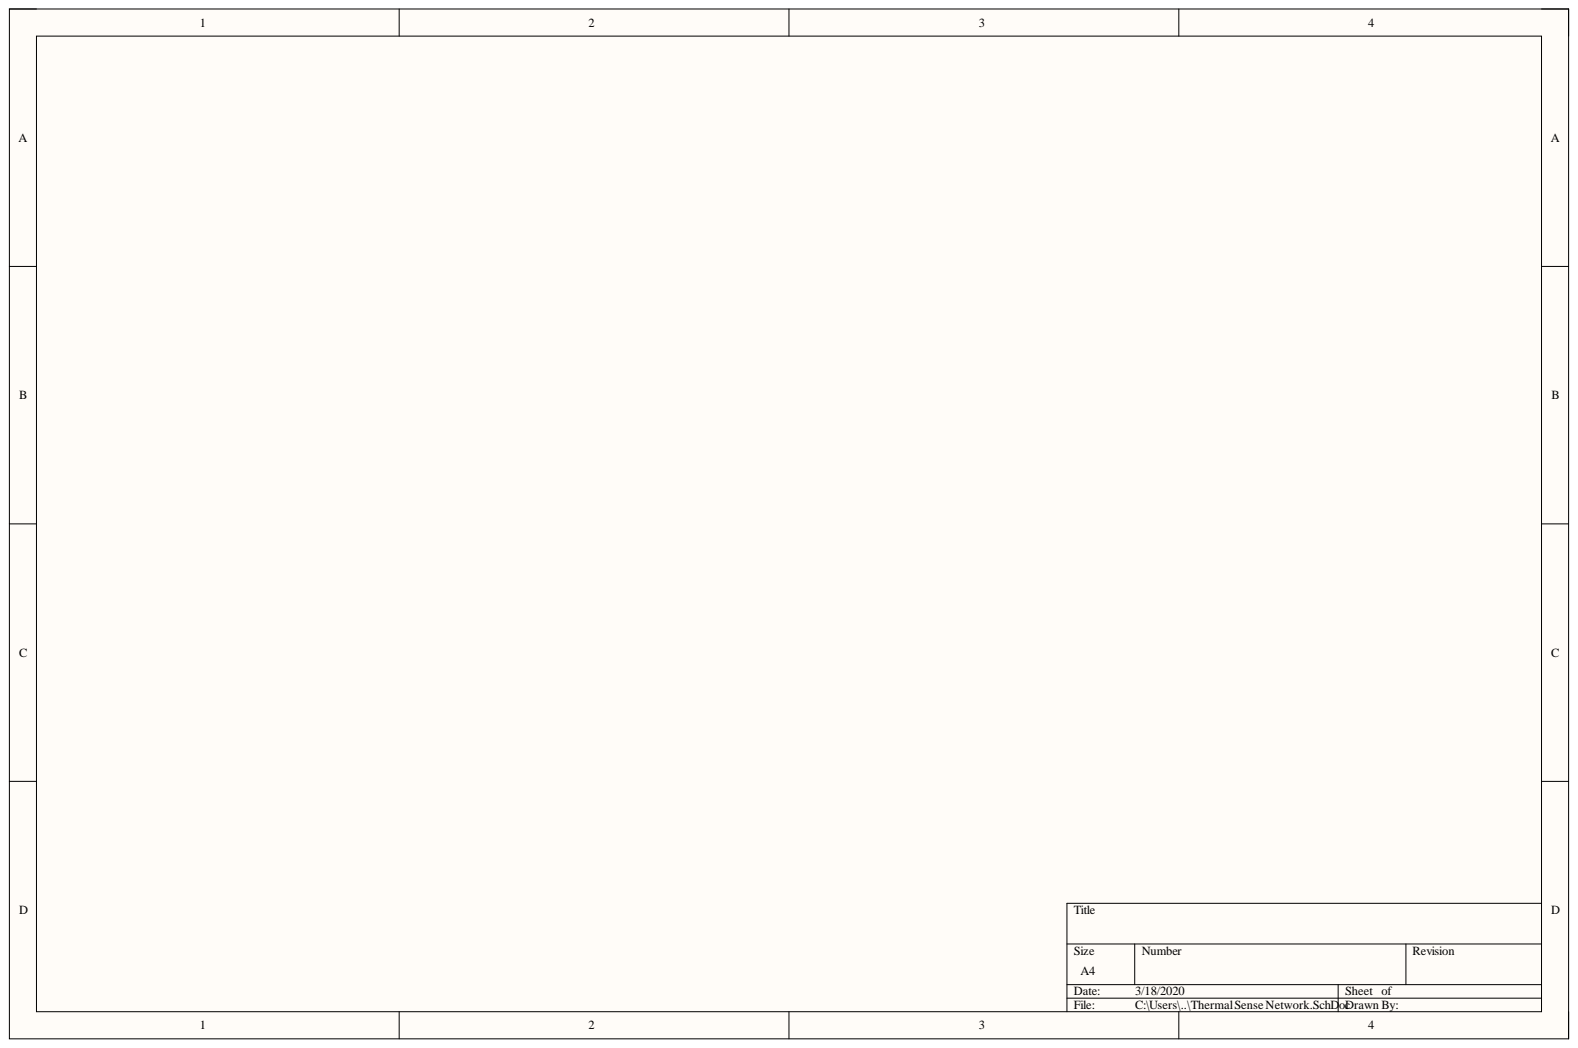
[picture p69: page 13]

Size A4 | Number | Revision

Date: 3/18/2020 | Sheet of
File: C:\Users\..\ThermalSense Network.SchDocDrawn By:
