g-rahul/5KW_OBC/Schematic_PDF/PFC_Stage.pdf

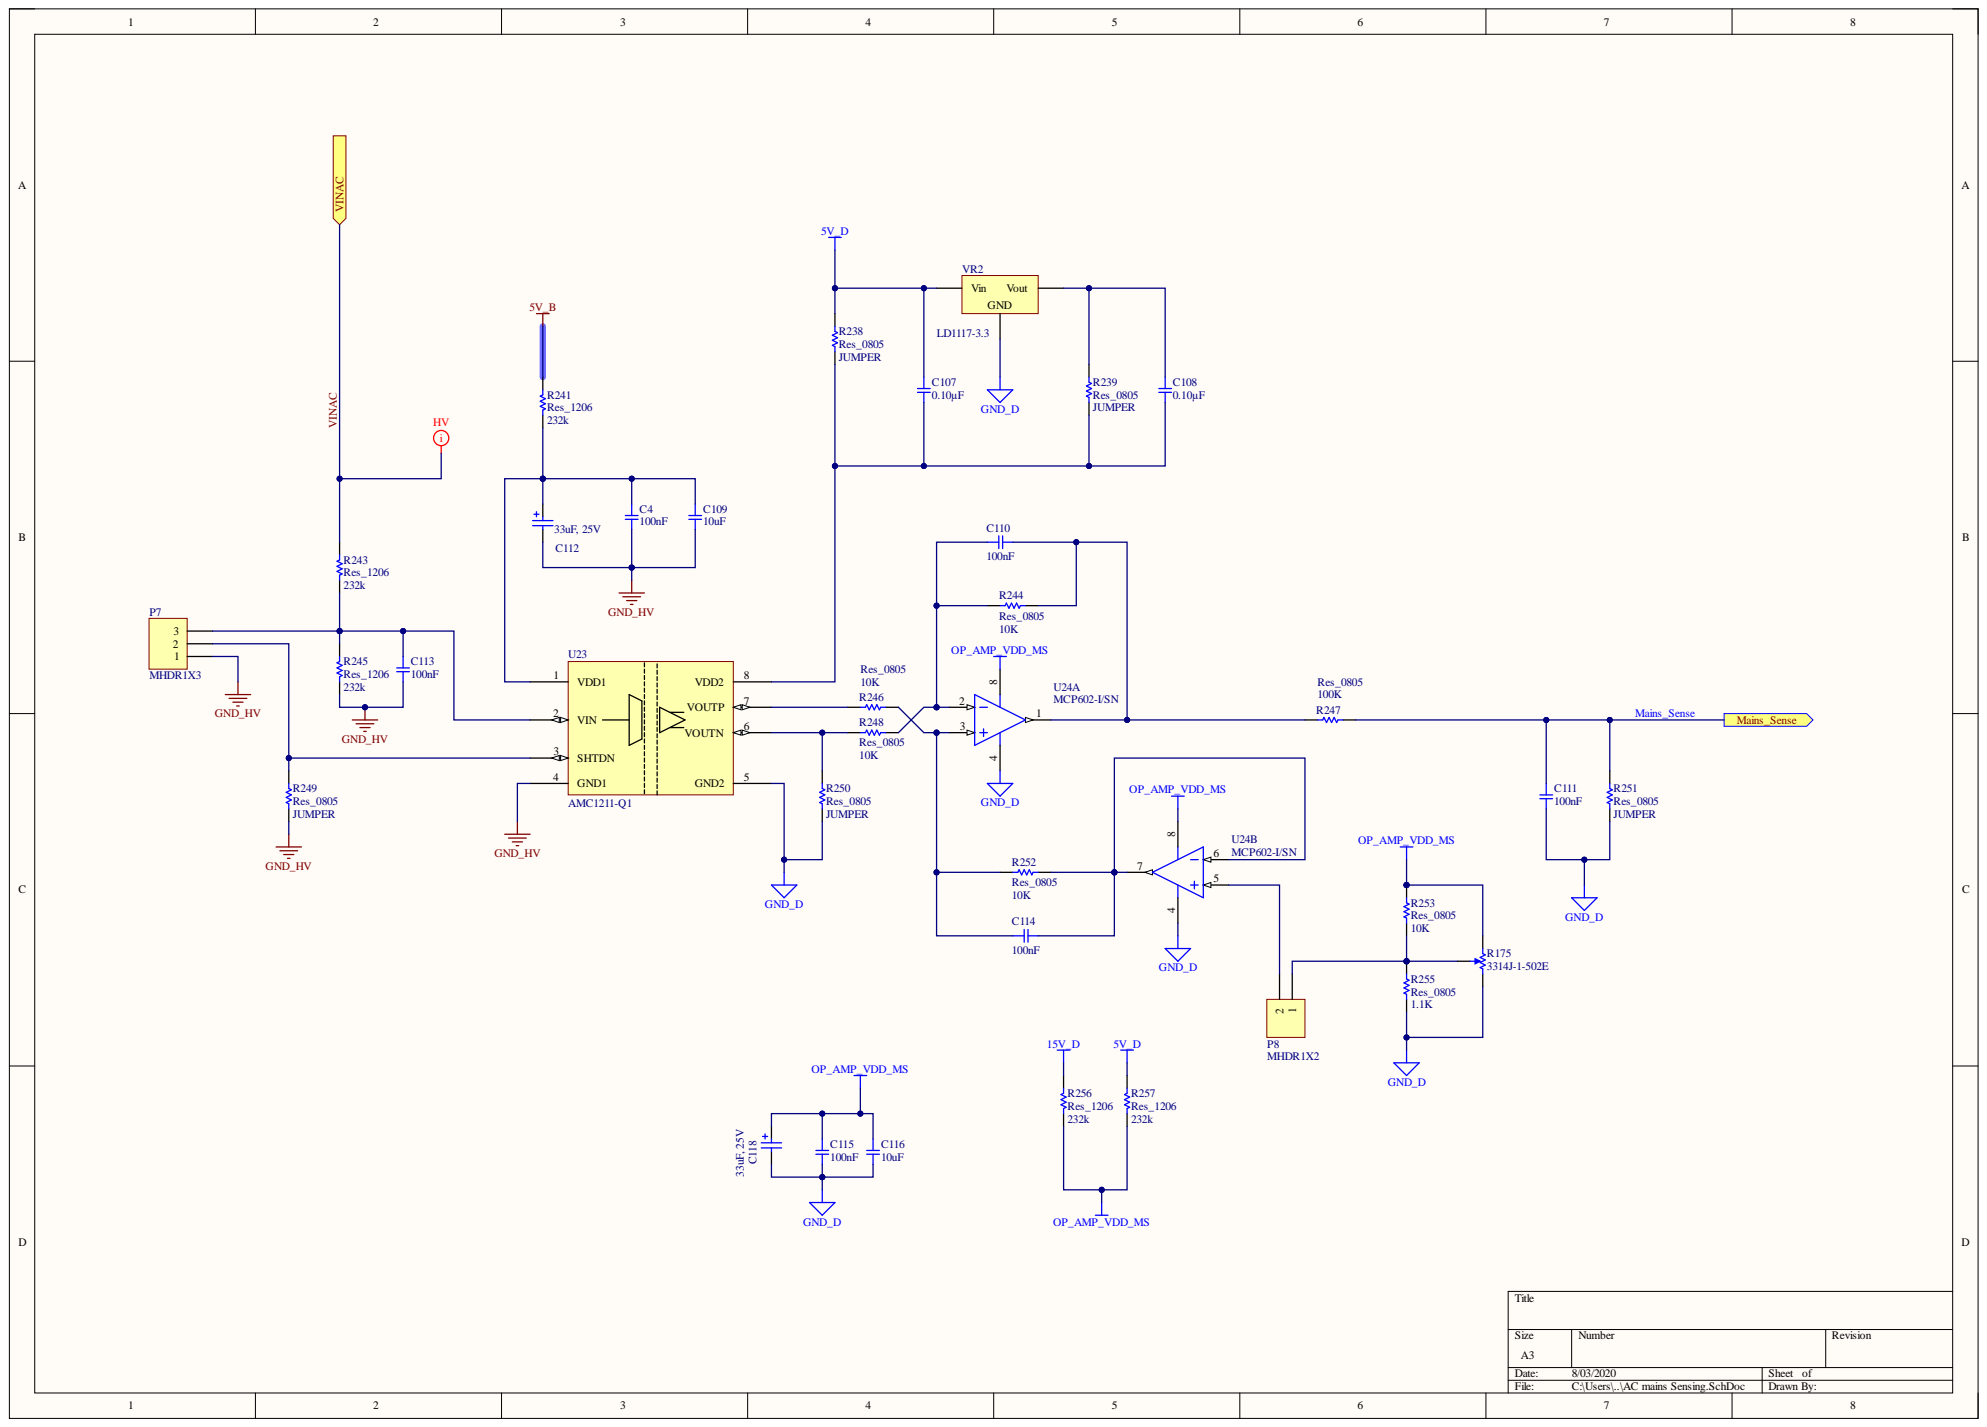
[picture p70: page 1]

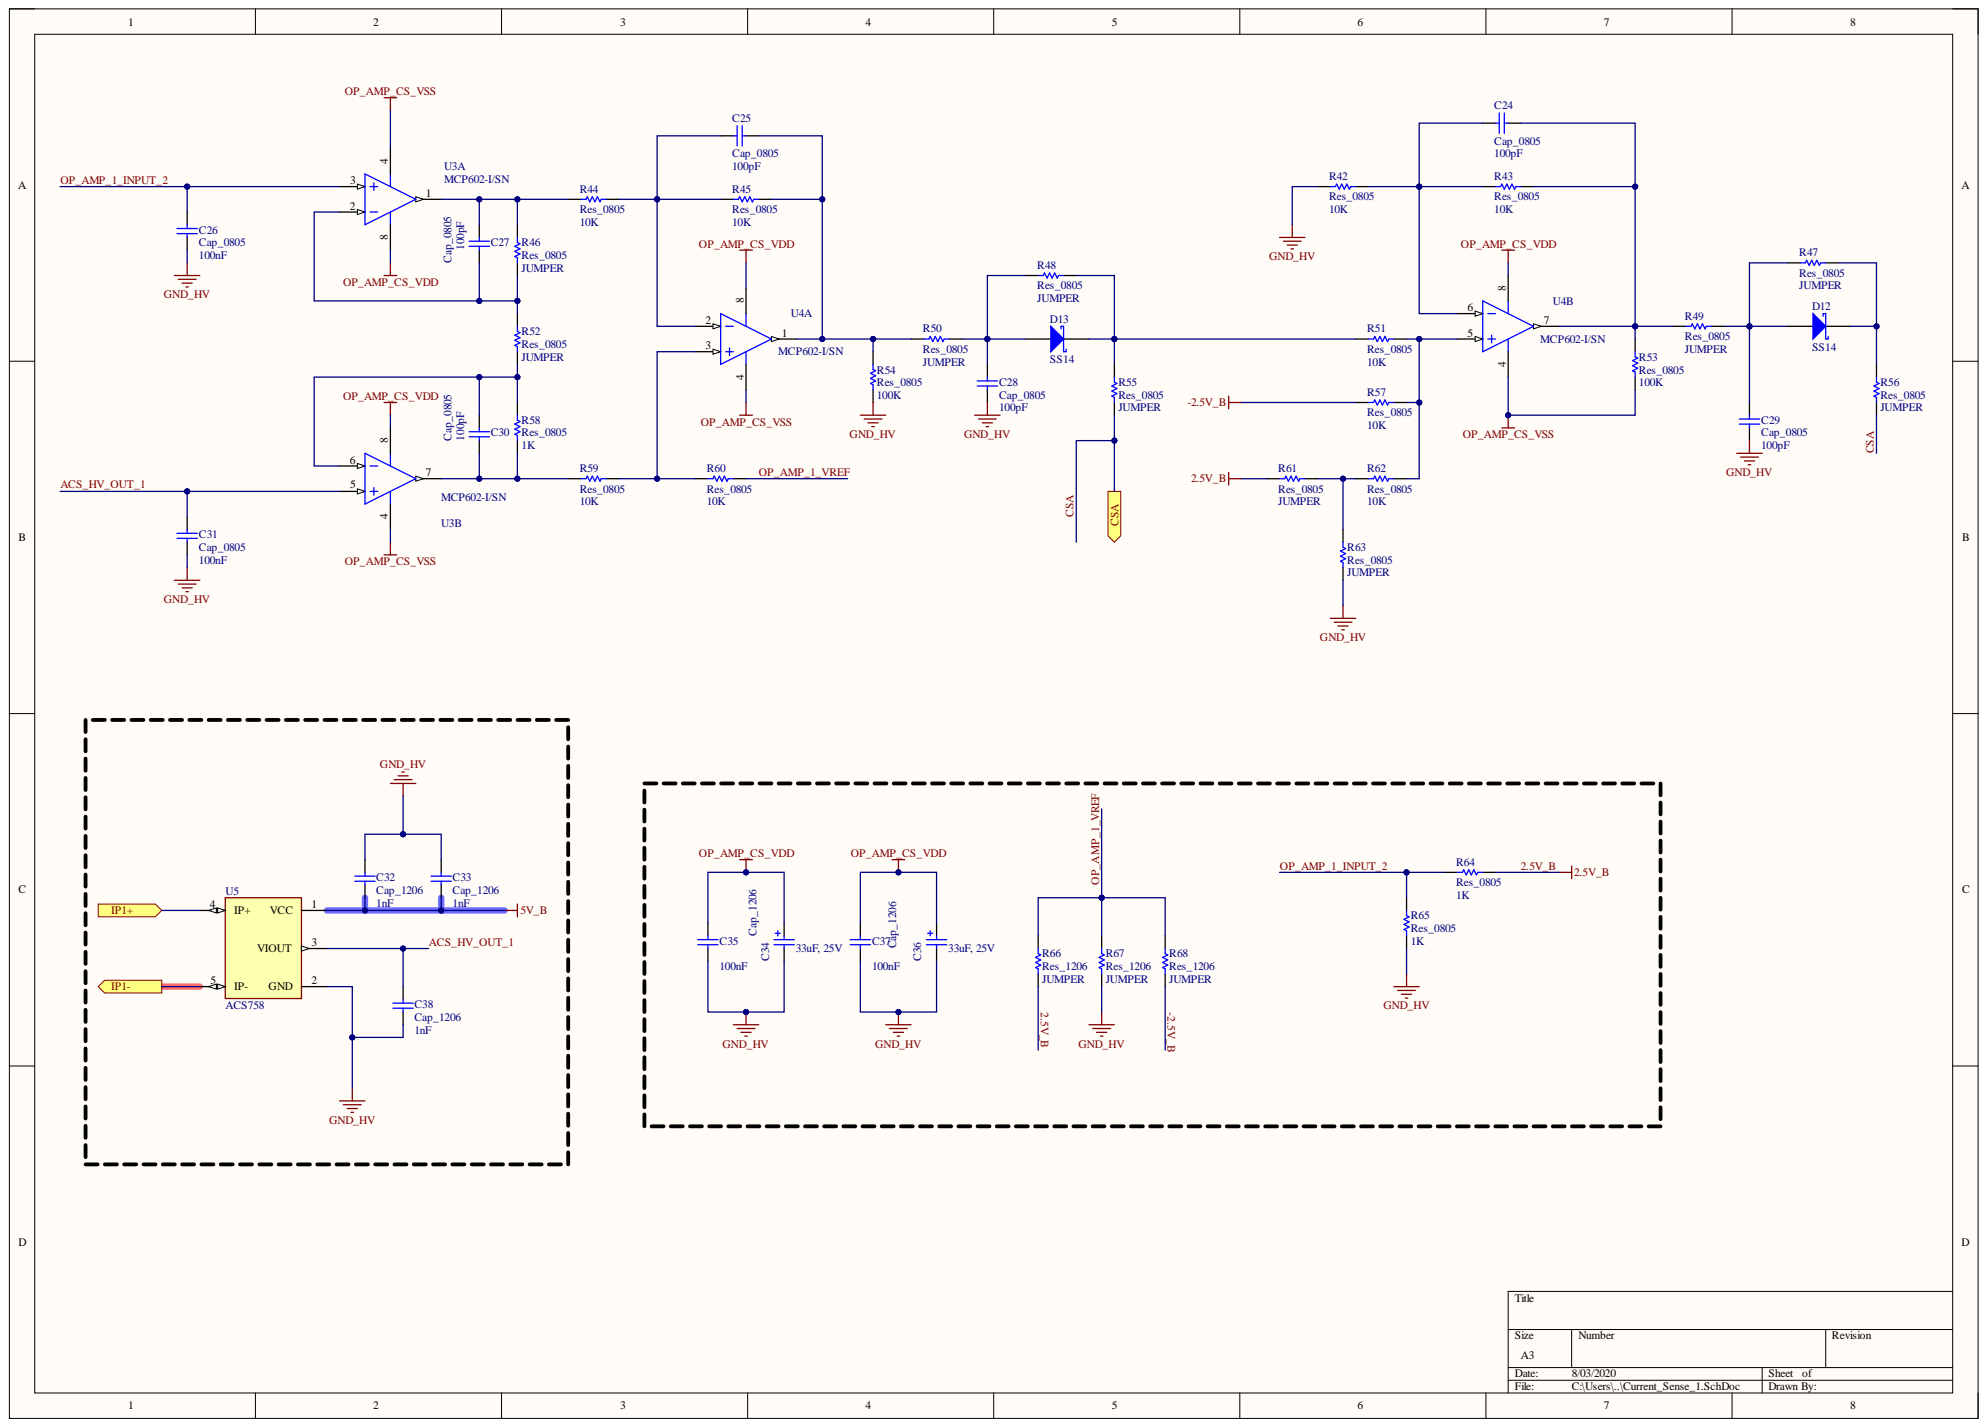
[picture p71: page 2]

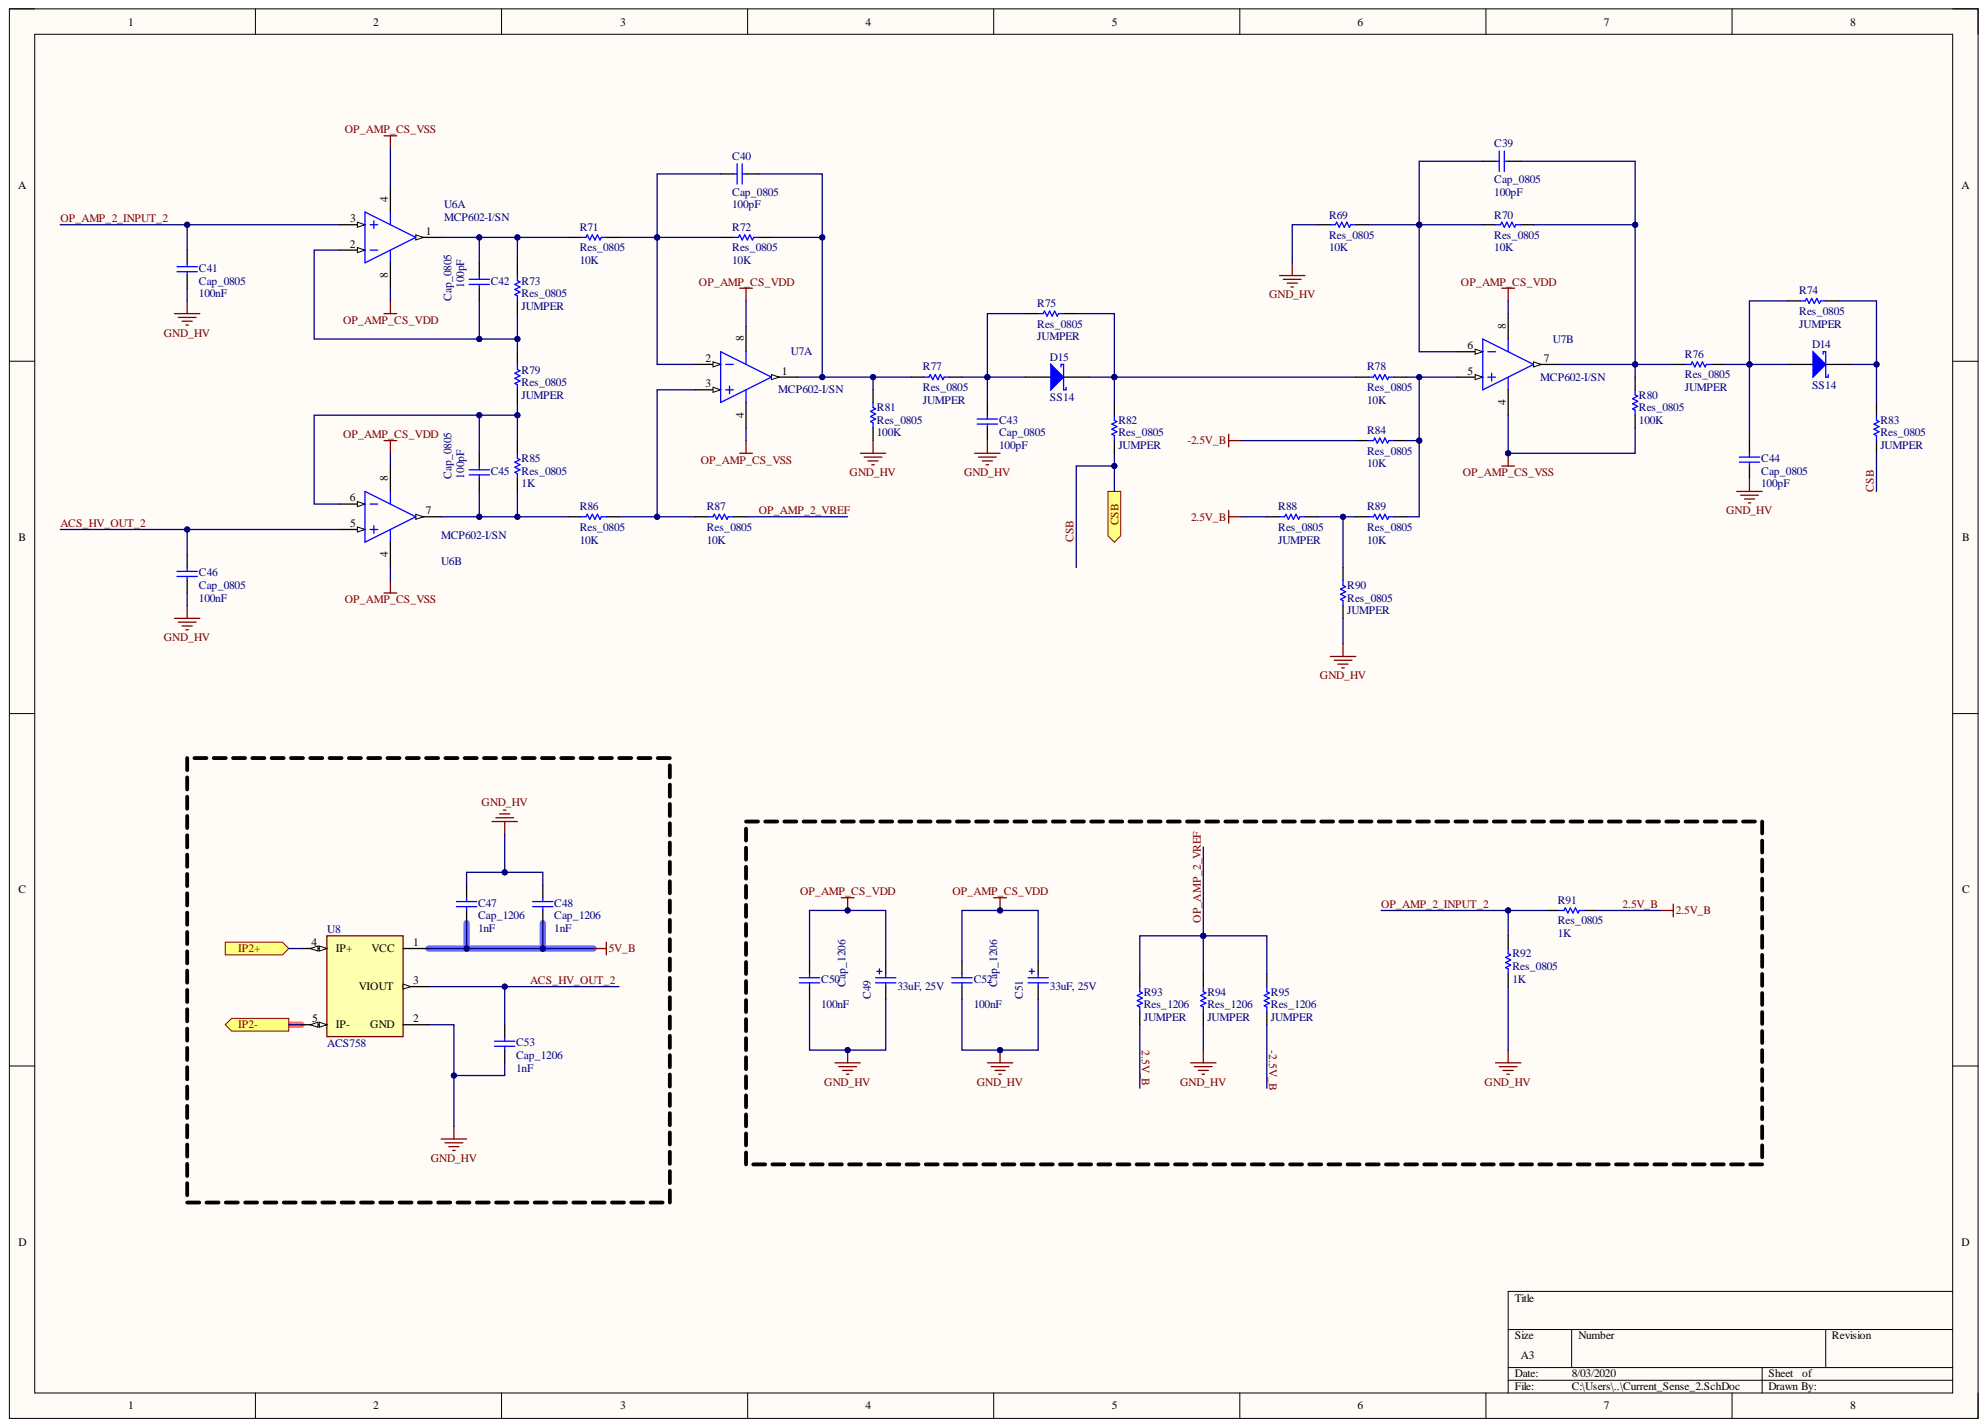
[picture p72: page 3]

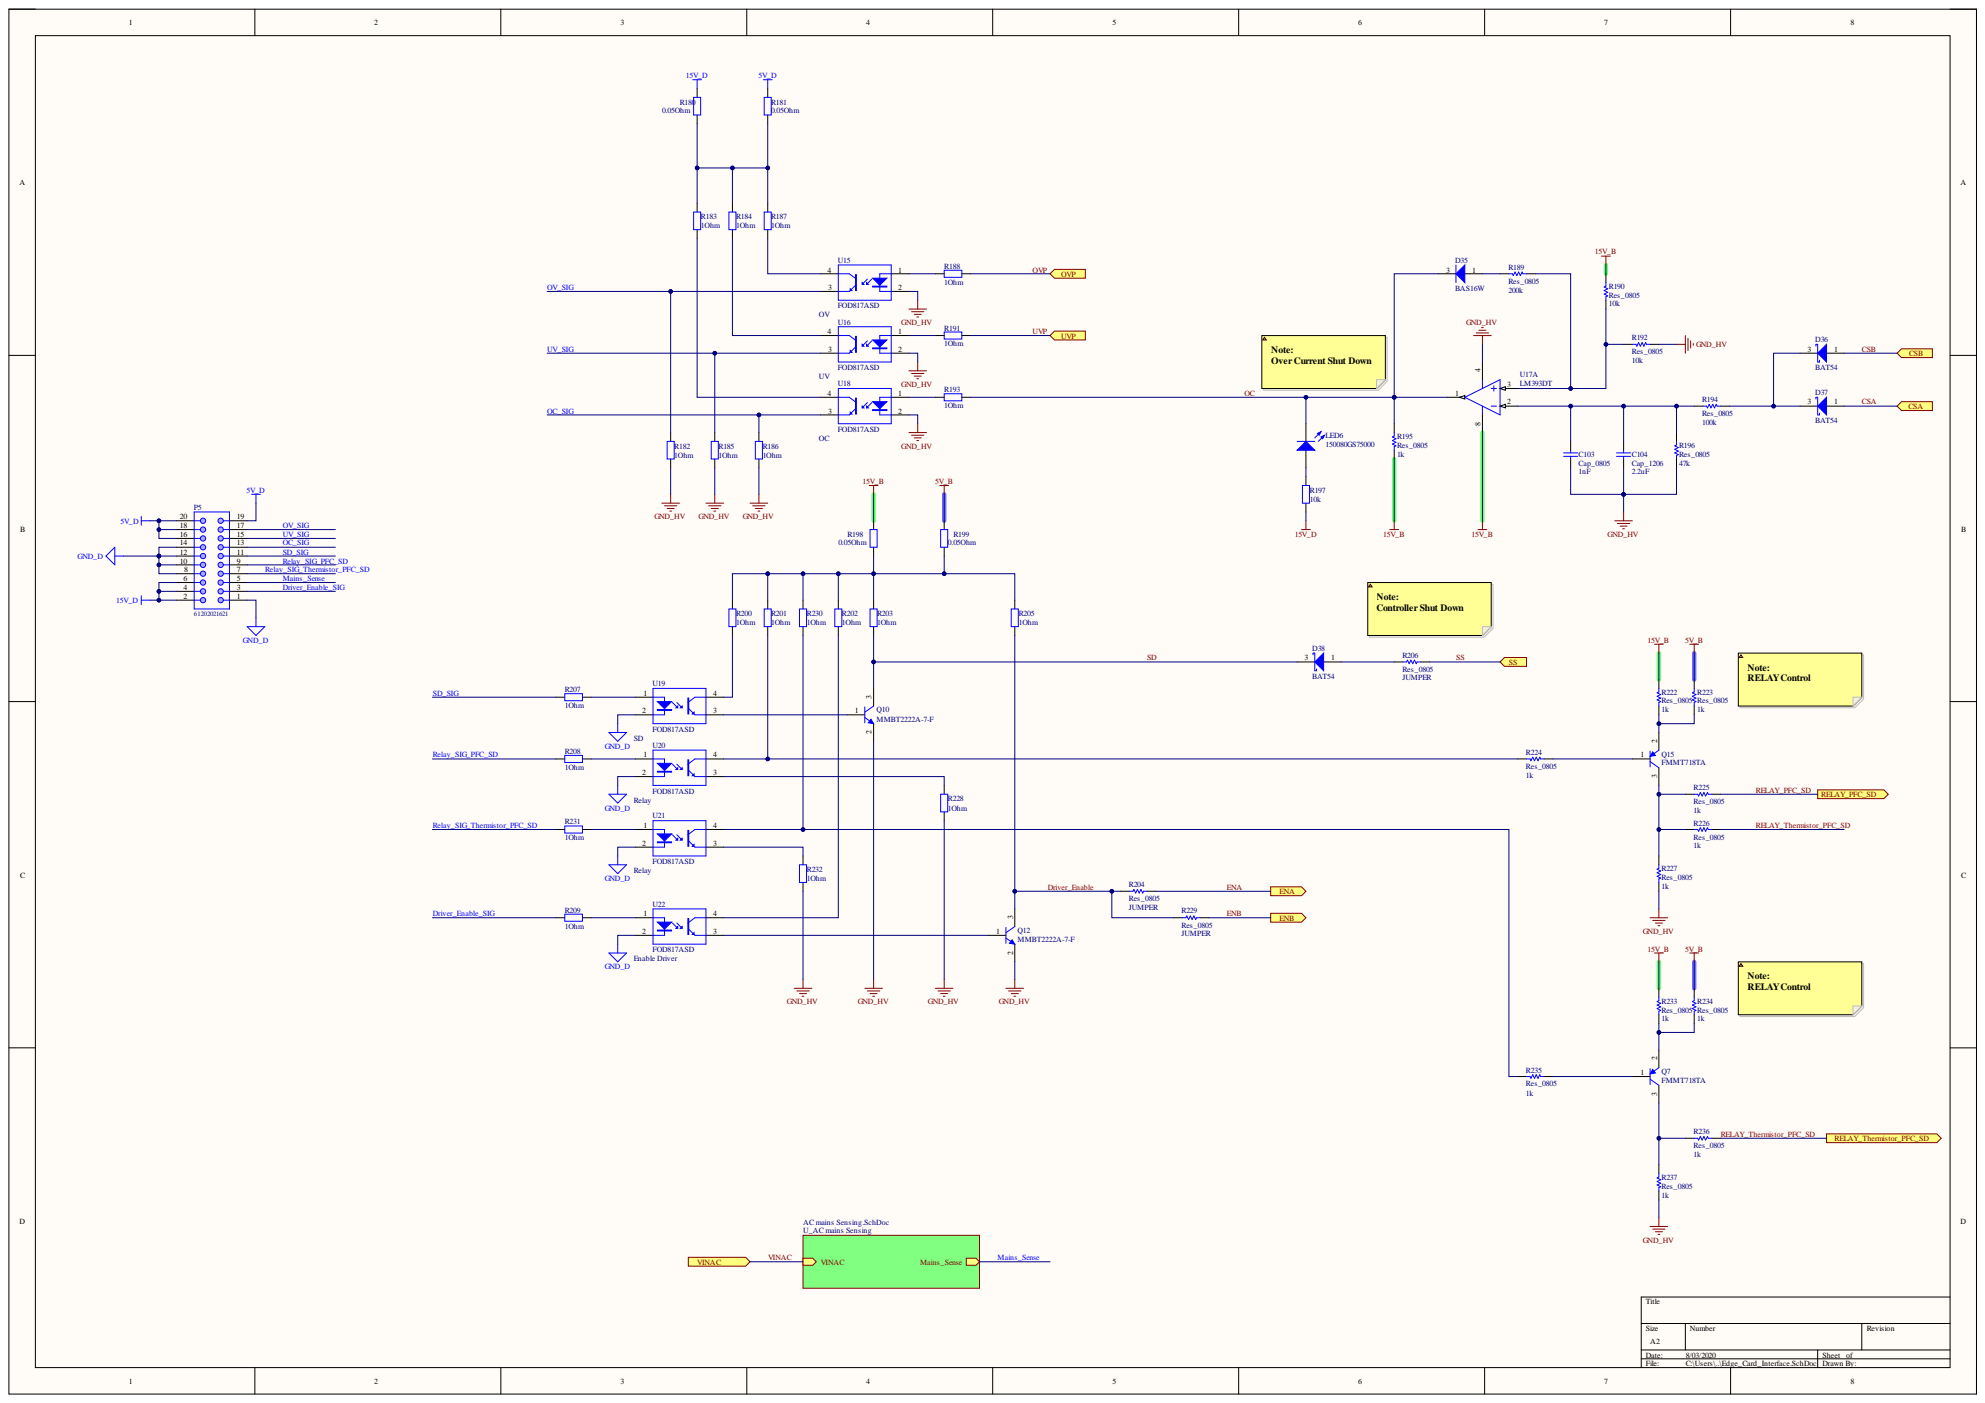
[picture p73: page 4]

Note:
Over Current Shut Down

AC mains Sensing.SchDoc
U_AC mains Sensing

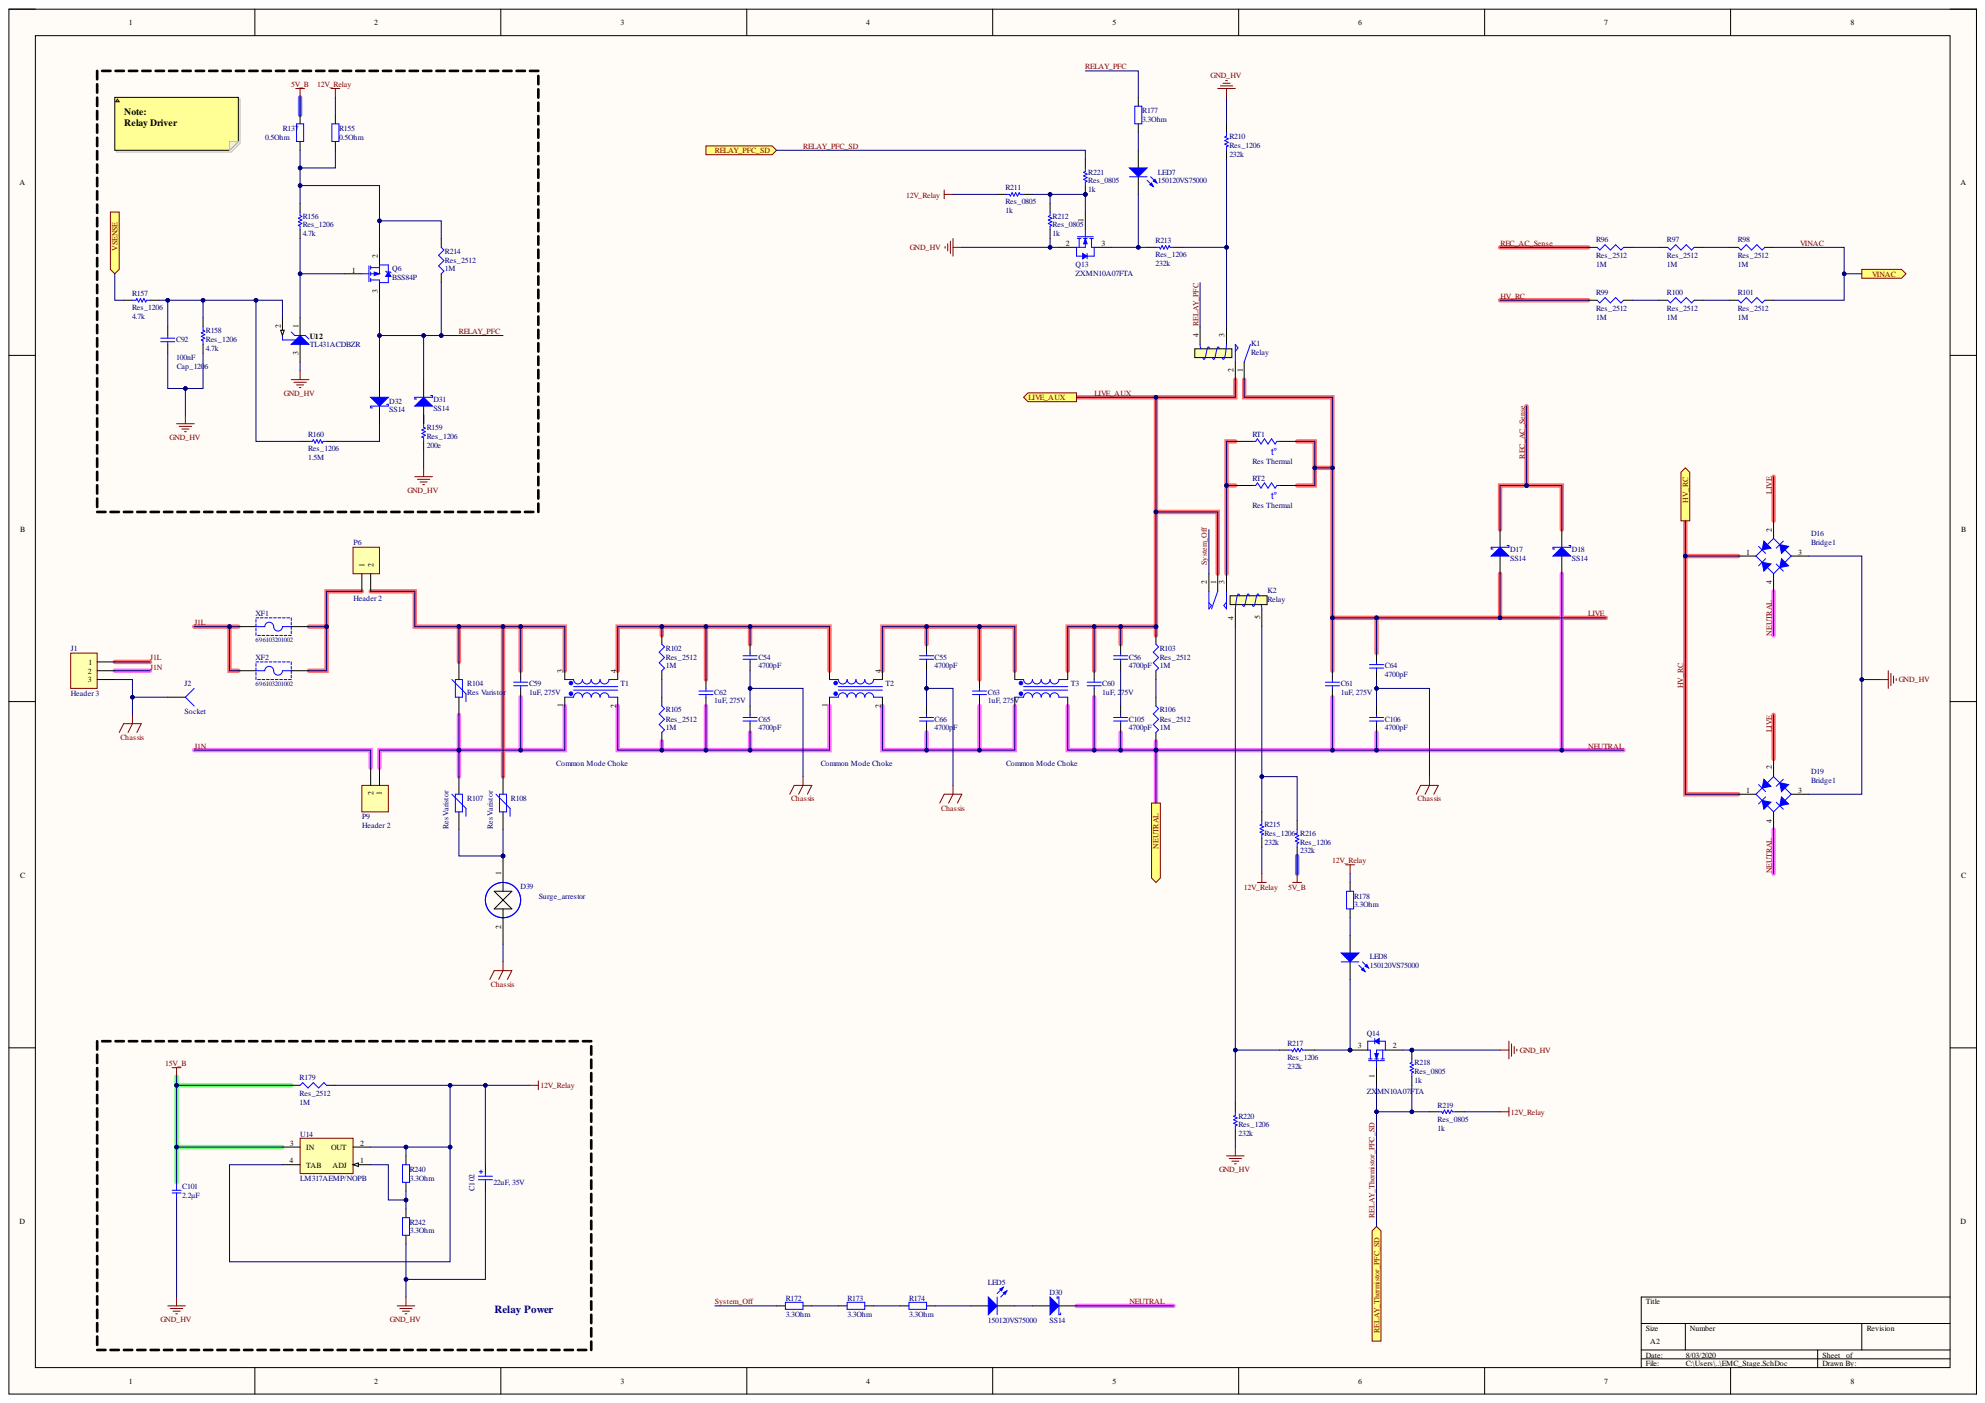
[picture p74: page 5]

LIVE LIVE NEUTRAL NEUTRAL

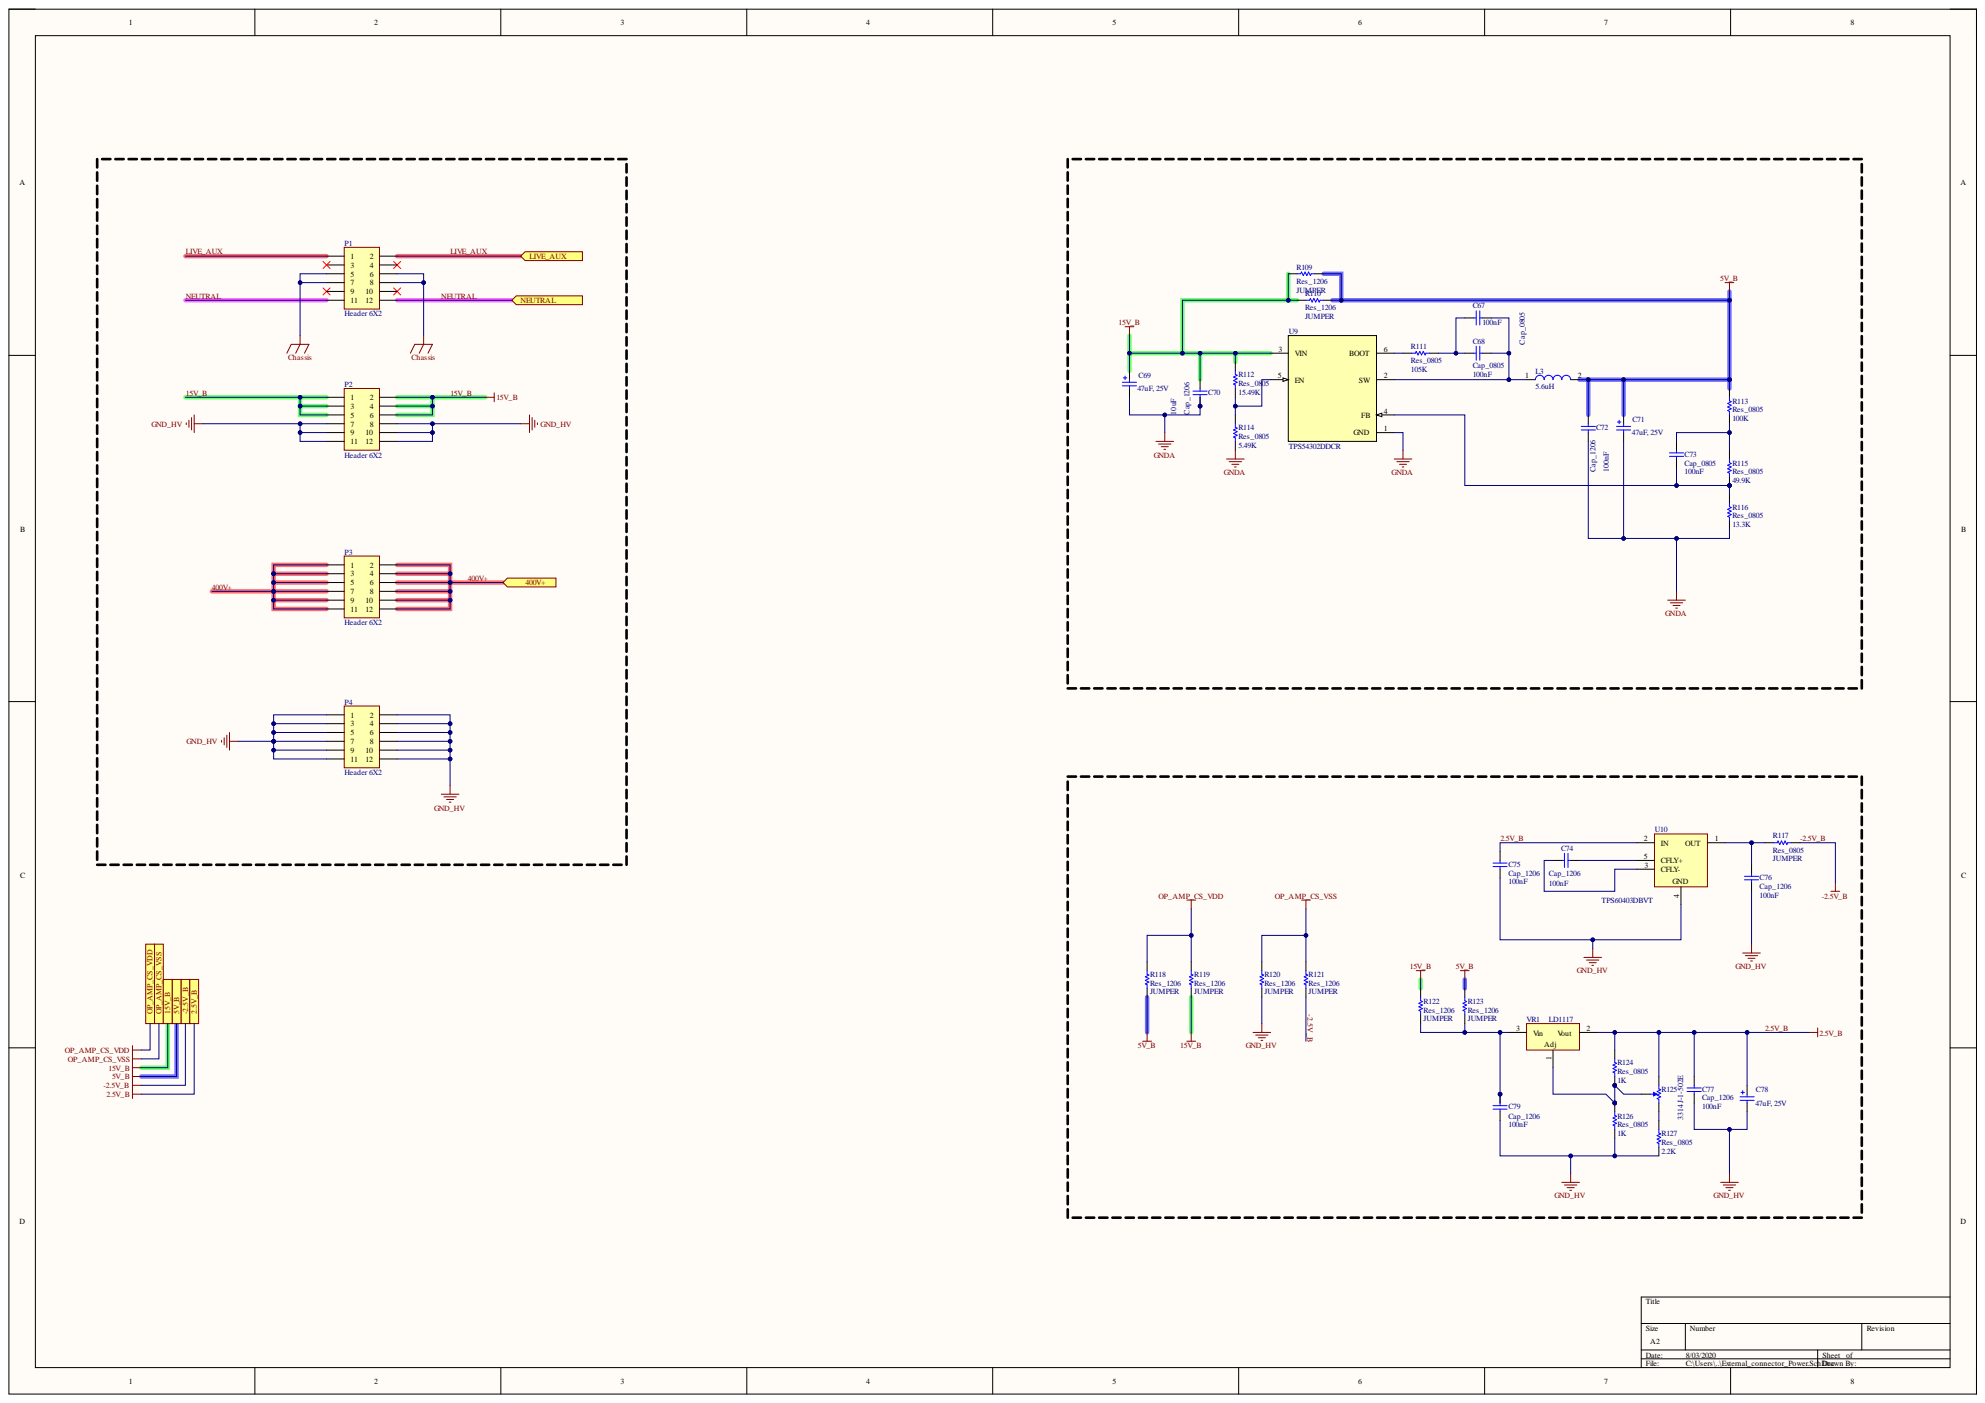
[picture p75: page 6]

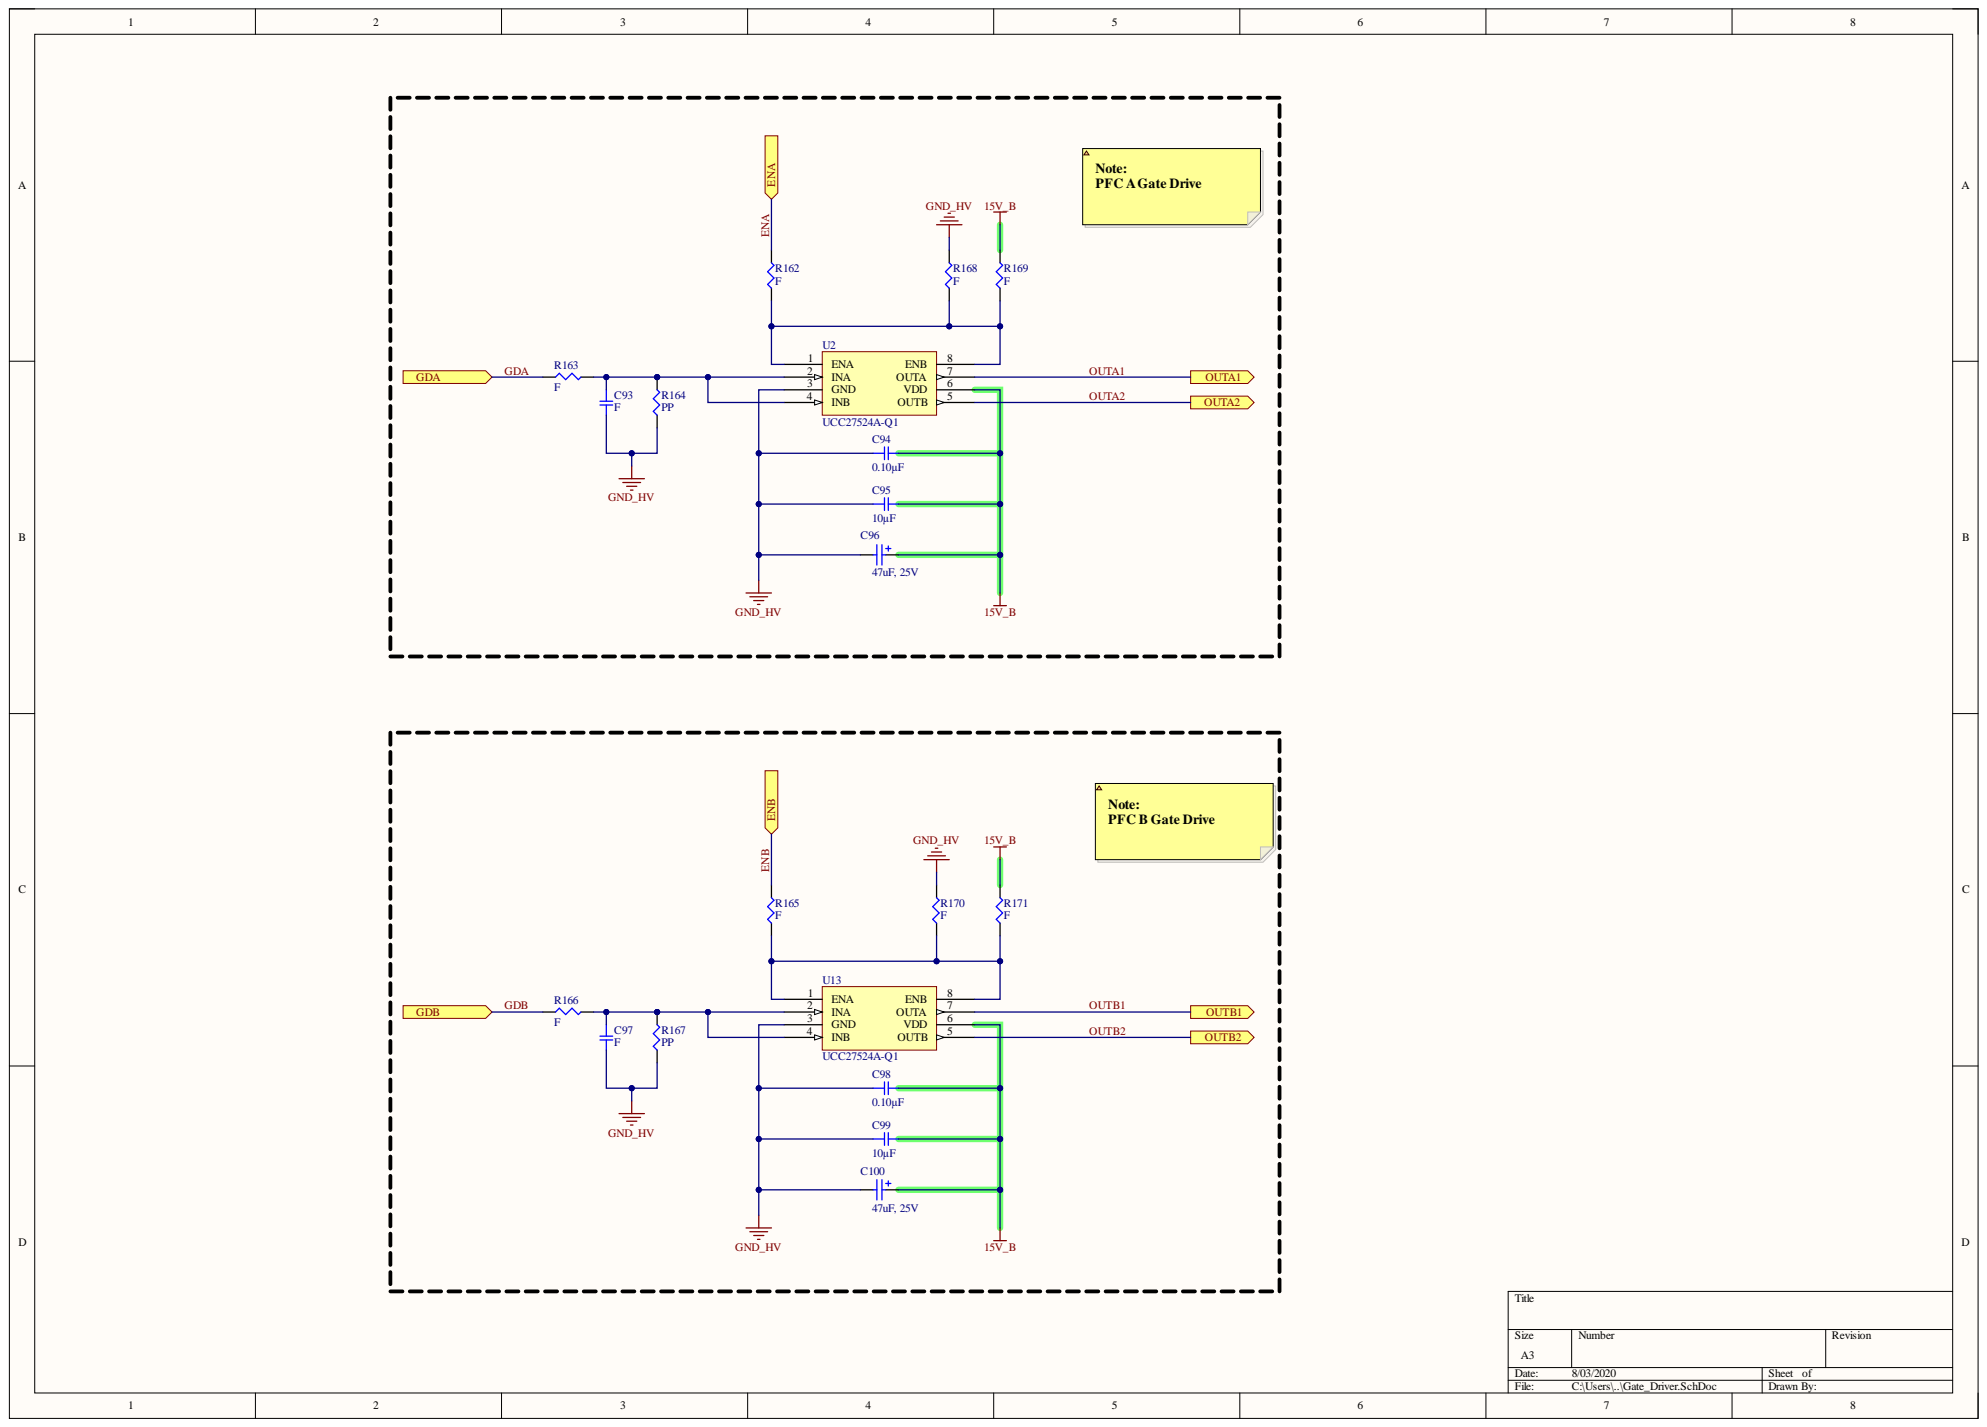
[picture p76: page 7]

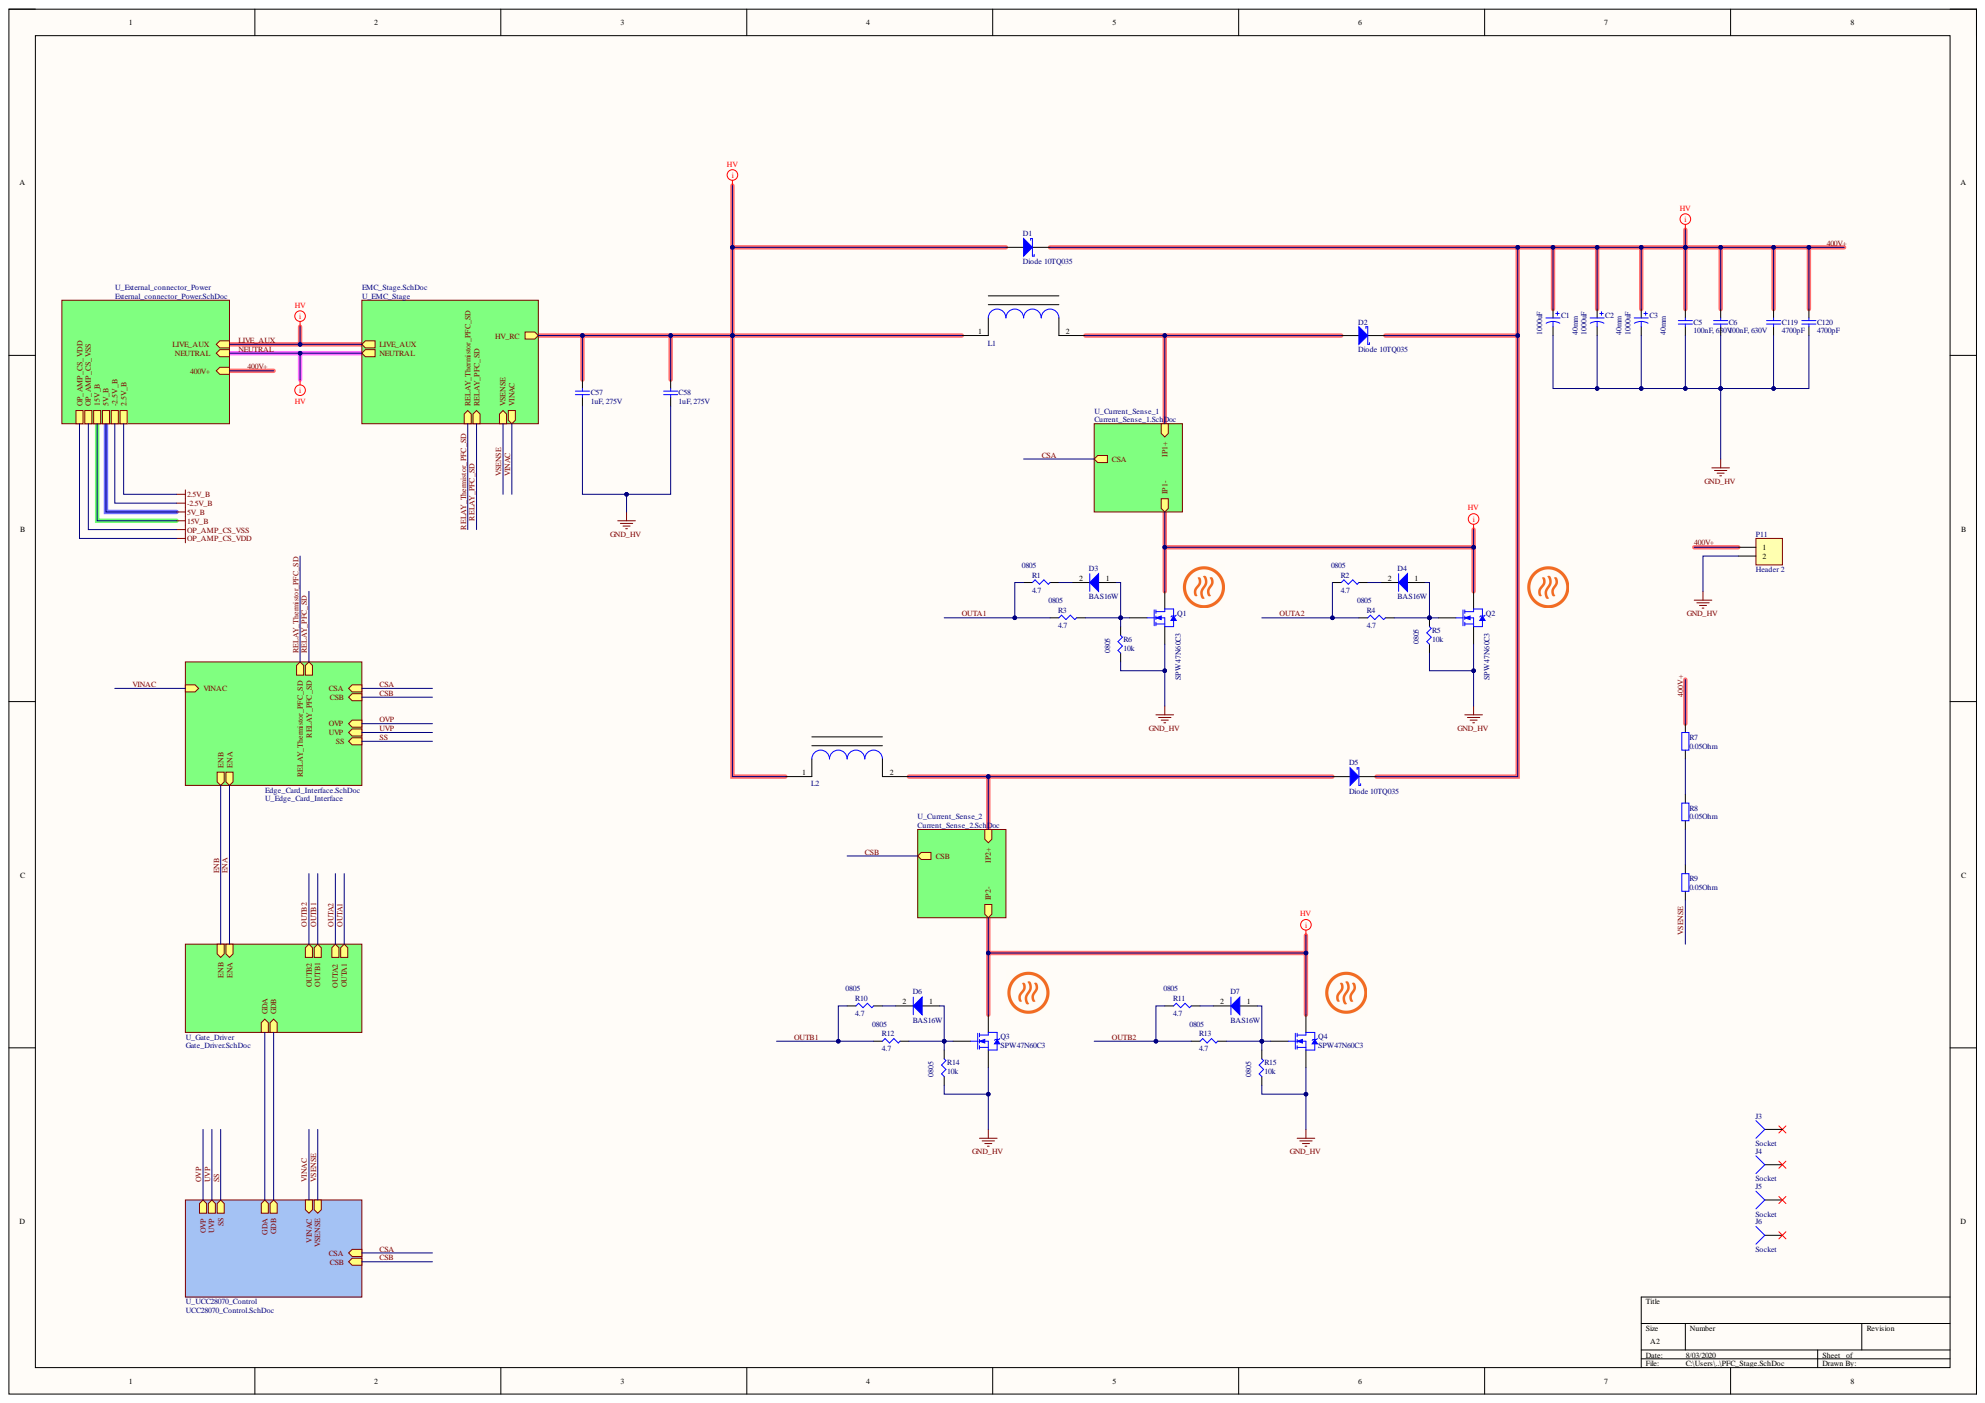
[picture p77: page 8]

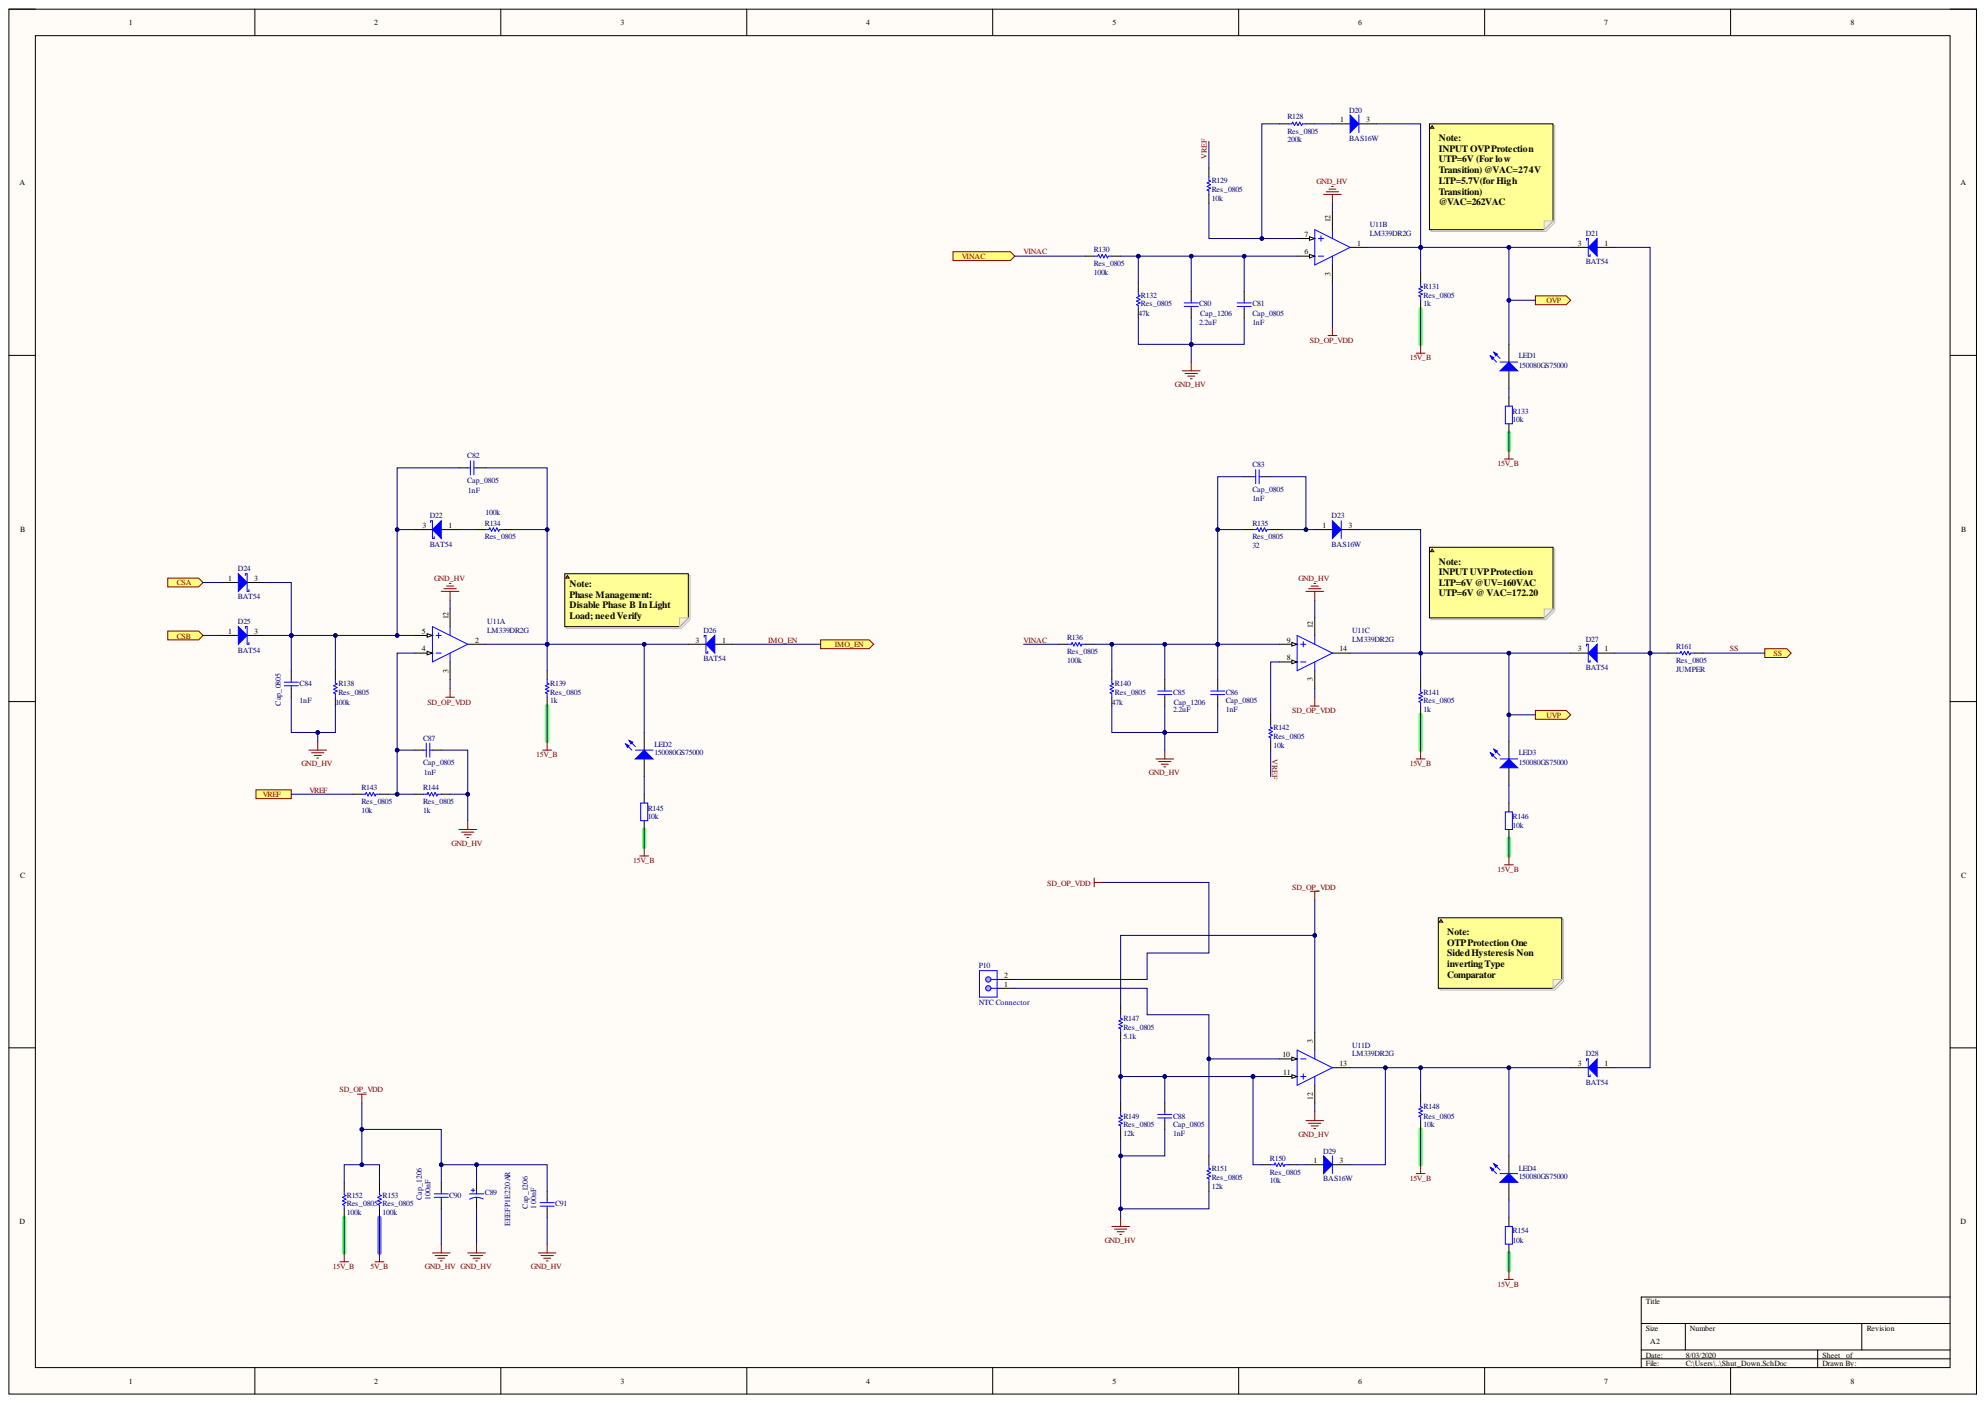
[picture p78: page 9]

Note:
Phase Management:
Disable Phase B In Light
Load; need Verify

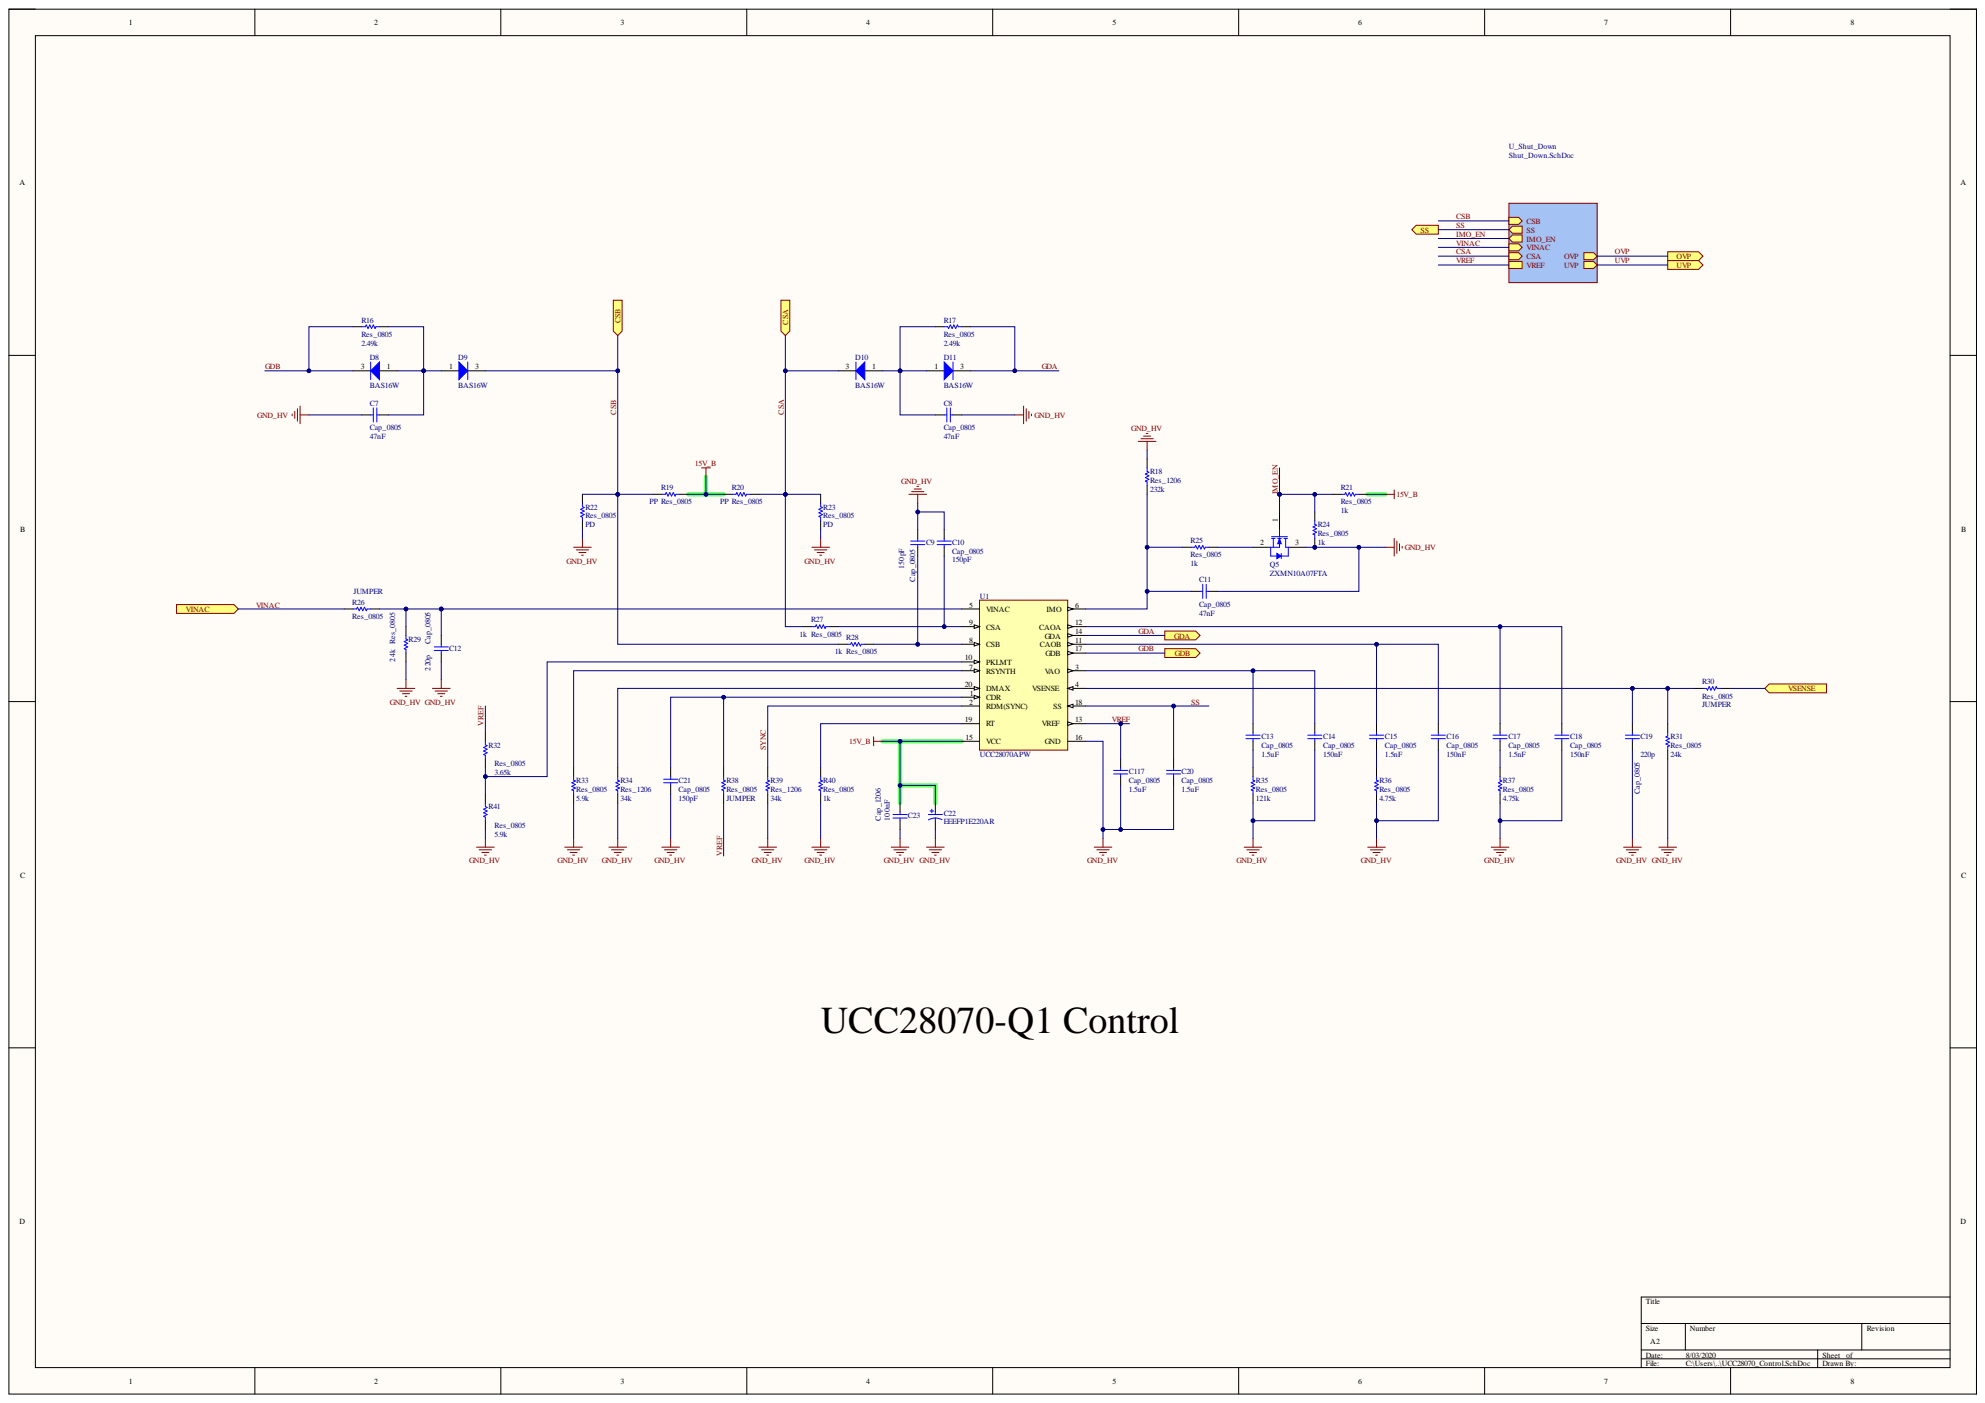
[picture p79: page 10]

2 0 | | 4
1 | | 1 8 | S S

1 9 | | 1 3 | VREF
