g-rahul/5KW_OBC/(list of files, drawings)

Other design files:
Auxillary_Supply_UCC28740/Auxillary_Supply_UCC28740.PcbDoc
Auxillary_Supply_UCC28740/Auxillary_Supply_UCC28740.PcbLib
Auxillary_Supply_UCC28740/Auxillary_Supply_UCC28740.PrjPcb
Auxillary_Supply_UCC28740/Auxillary_Supply_UCC28740.SchDoc
Auxillary_Supply_UCC28740/Auxillary_Supply_UCC28740.SchLib
Edge_Card_Ucc28951/Edge_Card_Connector.SchDoc
Edge_Card_Ucc28951/Edge_Card_Ucc2895.SchLib
Edge_Card_Ucc28951/Edge_Card_Ucc28951.PcbDoc
Edge_Card_Ucc28951/Edge_Card_Ucc28951.PcbLib
Edge_Card_Ucc28951/Edge_Card_Ucc28951.PrjPcb
Edge_Card_Ucc28951/Edge_Card_Ucc28951.SchDoc
Edge_Card_Ucc28951/Edge_Card_Ucc28951.SchLib
Edge_Card_Ucc28951/IR_Reciever.SchDoc
Edge_Card_Ucc28951/MCU.SchDoc
Edge_Card_Ucc28951/MCU_Breakout.SchDoc
Edge_Card_Ucc28951/MCU_CAN.SchDoc
Edge_Card_Ucc28951/MCU_Debug.SchDoc
Edge_Card_Ucc28951/MCU_LCD.SchDoc
Edge_Card_Ucc28951/MCU_Power.SchDoc
Edge_Card_Ucc28951/MCU_USB.SchDoc
Edge_Card_Ucc28951/MCU_UserPanel.SchDoc
Edge_Card_Ucc28951/PCIE/PCC-0001-00084-1/Released/PCIeX8-GF-2D-1000-1K-O98.PcbLib
Edge_Card_Ucc28951/PCIE/SYM-0001-00115-1/Released/PCIeX8-GF-2D-1000-1K-O98.SchLib
Edge_Card_Ucc28951/Power.SchDoc
Edge_Card_Ucc28951/Ucc_28951_Breakout.SchDoc
MCU.SchDoc
PFC_Stage/AC mains Sensing.SchDoc
PFC_Stage/Current_Sense_1.SchDoc
PFC_Stage/Current_Sense_2.SchDoc
PFC_Stage/Edge_Card_Interface.SchDoc
PFC_Stage/EMC_Stage.SchDoc
PFC_Stage/External_connector_Power.SchDoc
PFC_Stage/Gate_Driver.SchDoc
PFC_Stage/LOGO.PcbLib
PFC_Stage/PFC_Stage.PrjPcb
PFC_Stage/PFC_Stage.SchDoc
PFC_Stage/PFC_Stage.SchLib
PFC_Stage/Shut_Down.SchDoc
PFC_Stage/UCC28070_Control.SchDoc
Power Board UCC28951/5V_Isolated_Bias.SchDoc
Power Board UCC28951/Auxillary Supply Break Out.SchDoc
Power Board UCC28951/E_Switch.SchDoc
Power Board UCC28951/EMI Stage Break Out.SchDoc
Power Board UCC28951/Fan Control.SchDoc
Power Board UCC28951/Gate Driver HV.SchDoc
Power Board UCC28951/Gate Driver Rectifier.SchDoc
Power Board UCC28951/Input Current Sense.SchDoc
Power Board UCC28951/Input Sense Network.SchDoc
Power Board UCC28951/Input Voltage Sense.SchDoc
Power Board UCC28951/Output Current Sense.SchDoc
Power Board UCC28951/Output Sense Network.SchDoc
Power Board UCC28951/PCIE98 Break Out.SchDoc
Power Board UCC28951/Power Board UCC28951.PcbDoc
Power Board UCC28951/Power Board UCC28951.PcbLib
Power Board UCC28951/Power Board UCC28951.PrjPcb
Power Board UCC28951/Power Board UCC28951.SchDoc
Power Board UCC28951/Power Board UCC28951.SchLib
Power Board UCC28951/Power Circuit.SchDoc
Power Board UCC28951/Synchronous Rectification Stage.SchDoc
Power Board UCC28951/Thermal Sense Network.SchDoc
