g-rahul/5KW_OBC/UCC28951-Q-5KW-Firmware/UCC28951-Q-5KW-Firmware.ioc

Mcu.UserName=STM32G431VBTx
PA0.Signal=COMP3_INP
PA1.GPIO_Label=Vout_PSFB_Sense
PA1.Signal=ADC1_IN2
PA11.Signal=USB_DM
PA12.Signal=USB_DP
PA13.Signal=SYS_JTMS-SWDIO
PA14.Signal=SYS_JTCK-SWCLK
PA15.Signal=SYS_JTDI
PA2.GPIO_Label=Iout_PSFB_Sense
PA2.Signal=ADC1_IN3
PA4.GPIO_Label=Vref
PA4.Signal=COMP_DAC11_group
PA5.GPIO_Label=Iref
PA5.Signal=COMP_DAC12_group
PA7.Signal=COMP2_INP
PA8.GPIO_Label=SMBus_T_RST
PA8.Signal=GPIO_Output
PA9.GPIO_Label=SMBus_T_SMBA
PA9.Signal=I2C3_SMBA
PB0.Signal=COMP4_INP
PB1.Signal=COMP1_INP
PB10.GPIO_Label=FAN1_TACH
PB10.Signal=S_TIM2_CH3
PB11.GPIO_Label=FAN2_TACH
PB11.Signal=S_TIM2_CH4
PB12.GPIO_Label=PFC_UV_SIG
PB12.Signal=GPXTI12
PB13.GPIO_Label=PFC_OV_SIG
PB13.Signal=GPXTI13
PB14.GPIO_Label=PFC_Vac_Sense
PB14.Signal=ADC1_IN5
PB15.GPIO_Label=PFC_OC_SIG
PB15.Signal=GPXTI15
PB3.Signal=SYS_JTDO-SWO
PB4.Signal=SYS_JTRST
PC0.GPIO_Label=V_ref_PWM
PC0.Signal=S_TIM1_CH1
PC1.GPIO_Label=I_ref_PWM
PC1.Signal=S_TIM1_CH2
PC14-OSC32_IN.Signal=RCC_OSC32_IN
PC15-OSC32_OUT.Signal=RCC_OSC32_OUT
PC3.GPIO_Label=Iin_PSFB_Sense
PC3.Signal=ADC1_IN9
PC4.Signal=USART1_TX
PC5.Signal=USART1_RX
PC6.GPIO_Label=SYNC
PC6.Signal=S_TIM3_CH1
PC7.GPIO_Label=EN_28951
PC7.Signal=GPIO_Output
PC8.GPIO_Label=SMBus_T_SCL
PC8.Signal=I2C3_SCL
PC9.GPIO_Label=SMBus_T_SDA
PC9.Signal=I2C3_SDA
PD0.Signal=FDCAN1_RX
PD1.Signal=FDCAN1_TX
PD10.GPIO_Label=PFC_Relay_1
PD10.Signal=GPIO_Output
PD11.GPIO_Label=PFC_SD
PD11.Signal=GPIO_Output
PD2.GPIO_Label=FAN_EN
PD2.Signal=GPIO_Output
PD3.GPIO_Label=FAN1_PWM
PD3.Signal=S_TIM2_CH1
PD4.GPIO_Label=FAN2_PWM
PD4.Signal=S_TIM2_CH2
PD8.GPIO_Label=PFC_GD_En
PD8.Signal=GPIO_Output
PD9.GPIO_Label=PFC_Relay_2
PD9.Signal=GPIO_Output
PE0.GPIO_Label=LCD_D0
PE0.Signal=GPIO_Output
PE1.GPIO_Label=LCD_D1
PE1.Signal=GPIO_Output
PE10.GPIO_Label=LCD_RS
PE10.Signal=GPIO_Output
PE11.GPIO_Label=LCD_WR
PE11.Signal=GPIO_Output
PE12.Signal=GPIO_Output
PE2.GPIO_Label=LCD_D2
PE2.Signal=GPIO_Output
PE3.GPIO_Label=LCD_D3
PE3.Signal=GPIO_Output
PE4.GPIO_Label=LCD_D4
PE4.Signal=GPIO_Output
PE5.GPIO_Label=LCD_D5
PE5.Signal=GPIO_Output
PE6.GPIO_Label=LCD_D6
PE6.Signal=GPIO_Output
PE7.GPIO_Label=LCD_D7
PE7.Signal=GPIO_Output
PE8.GPIO_Label=LCD_RST
PE8.Signal=GPIO_Output
PE9.GPIO_Label=LCD_CS
PE9.Signal=GPIO_Output
PF0-OSC_IN.Signal=RCC_OSC_IN
PF1-OSC_OUT.Signal=RCC_OSC_OUT
