g-rahul/5KW_OBC/(commit log)

2020-07-27 changes made
    [Auxillary_Supply_UCC28740.SchDoc]
2020-07-27 removed text
    [Auxillary_Supply_UCC28740.SchDoc]
2020-07-27 Text delete
    [Auxillary_Supply_UCC28740.SchDoc]
2020-07-27 text file for branch test added
    [Auxillary_Supply_UCC28740.SchDoc]
2020-07-28 'compress action'
    [Auxillary_Supply_UCC28740.SchDoc]
2020-07-28 Added Pull up - 7:26
    [Thermal Sense Network.SchDoc]
2020-07-28 added more pull ups
    [Thermal Sense Network.SchDoc]
2020-07-28 thermal sense ckt complete note needed
    [Power Board UCC28951.PrjPcb, Thermal Sense Network.SchDoc, Thermal_Sensor_1.SchDoc, Thermal_Sensor_2.SchDoc]
2020-07-29 fan control added and pcie98 updated
    [E_Switch.SchDoc, Fan Control.SchDoc, Gate Driver Rectifier.SchDoc, PCIE98 Break Out.SchDoc, Power Board UCC28951.PcbLib, Power Board UCC28951.PrjPcb, Power Board UCC28951.SchDoc, Power Board UCC28951.SchLib]
2020-07-29 local power supply created for temp sense - add on
    [Auxillary Supply Break Out.SchDoc, E_Switch.SchDoc, Fan Control.SchDoc, Output Sense Network.SchDoc, Power Board UCC28951.PrjPcb, Power Board UCC28951.SchDoc, Thermal Sense Network.SchDoc]
2020-07-30 Edge card PCB layout
    [Dac_Reference.SchDoc, Edge_Card_Connector.SchDoc, Edge_Card_Ucc28951.PcbDoc, Edge_Card_Ucc28951.PrjPcb, Edge_Card_Ucc28951.SchDoc, Edge_Card_Ucc28951.SchLib, PCIeX8-GF-2D-1000-1K-O98.PcbLib, PCIeX8-GF-2D-1000-1K-O98.SchLib]
2020-08-02 PCB arrangement staged
    [Dac_Reference.SchDoc, EMI Stage Break Out.SchDoc, E_Switch.SchDoc, Edge_Card_Ucc28951.PcbDoc, Edge_Card_Ucc28951.SchDoc, Gate Driver HV.SchDoc, Power Board UCC28951.PcbDoc, Power Board UCC28951.SchDoc]
2020-08-02 Firmware file added , edge card updated
    [Edge_Card_Connector.SchDoc, Edge_Card_Interface.SchDoc, Edge_Card_Ucc28951.PcbDoc, Edge_Card_Ucc28951.PrjPcb, Edge_Card_Ucc28951.SchDoc, Edge_Card_Ucc28951.SchLib, MCU.SchDoc, MCU_Breakout.SchDoc]
2020-08-02 LDO Config Done 100 pin LQFP
    [Edge_Card_Ucc28951.SchLib, MCU.SchDoc, MCU_Breakout.SchDoc, MCU_CAN.SchDoc, MCU_JTAG.SchDoc, MCU_Power.SchDoc, MCU_USB.SchDoc, Power.SchDoc]
2020-08-03 CAN updated
    [Edge_Card_Ucc28951.SchLib, Gate Driver HV.SchDoc, MCU_CAN.SchDoc, Power.SchDoc]
2020-08-03 Inter Connect made synchronization in progress
    [Auxillary_Supply_UCC28740.PrjPcb, Edge_Card_Connector.SchDoc, Edge_Card_Interface.SchDoc, Edge_Card_Ucc28951.PcbDoc, Edge_Card_Ucc28951.PrjPcb, Edge_Card_Ucc28951.SchDoc, Edge_Card_Ucc28951.SchLib, External_connector_Power.SchDoc]
2020-08-04 PCB Arranegement Finished
    [Auxillary_Supply_UCC28740.PcbDoc, Auxillary_Supply_UCC28740.PrjPcb, Dac_Reference.SchDoc, E_Switch.SchDoc, Edge_Card_Ucc28951.PrjPcb, Edge_Card_Ucc28951.SchDoc, Edge_Card_Ucc28951.SchLib, Gate Driver HV.SchDoc]
2020-08-05 First Stacking in progess
    [Auxillary Supply Break Out.SchDoc, Auxillary_Supply_UCC28740.PcbDoc, EMI Stage Break Out.SchDoc, External_connector_Power.SchDoc, Gate Driver HV.SchDoc, PCIE98 Break Out.SchDoc, PFC_Stage.PrjPcb, PFC_Stage.SchDoc]
2020-08-06 PCB PFC board changed interconnect finish
    [Auxillary Supply Break Out.SchDoc, Auxillary_Supply_UCC28740.PcbDoc, Current_Sense_2.SchDoc, EMC_Stage.SchDoc, EMI Stage Break Out.SchDoc, External_connector_Power.SchDoc, PFC_Stage.PrjPcb, PFC_Stage.SchDoc]
2020-08-07 PCB Arranegement UCC28951
    [5V_Isolated_Bias.SchDoc, Auxillary Supply Break Out.SchDoc, Auxillary_Supply_UCC28740.PcbDoc, EMC_Stage.SchDoc, EMI Stage Break Out.SchDoc, E_Switch.SchDoc, External_connector_Power.SchDoc, Fan Control.SchDoc]
2020-08-07 Componet Gross alignment Finished
    [Output Sense Network.SchDoc, Power Circuit.SchDoc]
2020-10-08 PFC PCB
2020-10-08 Schematic Test
    [Auxillary_Supply_UCC28740.SchDoc]
2020-11-22 aux mod t1
    [5V_Isolated_Bias.SchDoc, Auxillary_Supply_UCC28740.PcbDoc, Auxillary_Supply_UCC28740.PcbLib, Auxillary_Supply_UCC28740.PrjPcb, Auxillary_Supply_UCC28740.SchDoc, Auxillary_Supply_UCC28740.SchLib, External_connector_Power.SchDoc]
2020-11-24 auxillary supply pcb
    [Auxillary_Supply_UCC28740.PcbDoc, Auxillary_Supply_UCC28740.PcbLib, Auxillary_Supply_UCC28740.SchDoc, Auxillary_Supply_UCC28740.SchLib]
2020-12-07 Routing 5VB
    [Auxillary_Supply_UCC28740.GBL, Auxillary_Supply_UCC28740.GBO, Auxillary_Supply_UCC28740.GBP, Auxillary_Supply_UCC28740.GBS, Auxillary_Supply_UCC28740.GM1, Auxillary_Supply_UCC28740.GTL, Auxillary_Supply_UCC28740.GTO, Auxillary_Supply_UCC28740.GTP]
2020-12-08 PFC 28070 placement
    [External_connector_Power.SchDoc, UCC28070_Control.SchDoc]
2020-12-08 Current sense routing 2_43
    [Current_Sense_1.SchDoc, Current_Sense_2.SchDoc, LOGO.PcbLib]
2020-12-09 Shut Down Circuit
    [AC mains Sensing.SchDoc, Current_Sense_1.SchDoc, Current_Sense_2.SchDoc, EMC_Stage.SchDoc, Shut_Down.SchDoc]
2020-12-09 earth plane added
    [AC mains Sensing.SchDoc, EMC_Stage.SchDoc, PFC_Stage.PrjPcb, PFC_Stage.SchLib]
2020-12-10 logo and glyph process 1
    [Edge_Card_Interface.SchDoc]
2020-12-10 poly and soldermask
    [Edge_Card_Interface.SchDoc]
2020-12-10 clearance with soldermask
2020-12-10 compliance logo
    [EMC_Stage.SchDoc]
2020-12-16 PFC resume #9:20 16122020
    [Current_Sense_1.SchDoc, Current_Sense_2.SchDoc, EMC_Stage.SchDoc, Edge_Card_Interface.SchDoc, PFC_Stage.SchDoc, PFC_Stage.SchLib]
2020-12-17 1152 17122020
    [Current_Sense_2.SchDoc, External_connector_Power.SchDoc]
2020-12-17 Routing Done
    [Current_Sense_1.SchDoc, Current_Sense_2.SchDoc, External_connector_Power.SchDoc]
2020-12-17 PFC DRC Verification DOne
    [EMC_Stage.SchDoc, PFC_Stage.SchDoc]
2020-12-17 External JST Conn Added
    [Edge_Card_Interface.SchDoc, External_connector_Power.SchDoc]
2020-12-18 12:52 18122020 TEST POINT ADDED Desing Phase End
    [AC mains Sensing.SchDoc, Current_Sense_1.SchDoc, Current_Sense_2.SchDoc, EMC_Stage.SchDoc, Edge_Card_Interface.SchDoc, External_connector_Power.SchDoc, Gate_Driver.SchDoc, PFC_Stage.SchDoc]
2020-12-18 Production Check List Process
    [5V_Isolated_Bias.SchDoc, Auxillary_Supply_UCC28740.PrjPcb, Auxillary_Supply_UCC28740.SchDoc, Input Current Sense.SchDoc, Input Sense Network.SchDoc, Output Current Sense.SchDoc, Output Sense Network.SchDoc, PFC_Stage.PrjPcb]
2020-12-19 Draftsman/template aux
    [Auxillary_Supply_UCC28740.PrjPcb, Auxillary_Supply_UCC28740.SchDoc, Auxillary_Supply_UCC28740.SchLib]
2020-12-19 PFC Title BLock
    [AC mains Sensing.SchDoc, Auxillary_Supply_UCC28740.SchDoc, Current_Sense_1.SchDoc, Current_Sense_2.SchDoc, EMC_Stage.SchDoc, Edge_Card_Interface.SchDoc, External_connector_Power.SchDoc, Gate_Driver.SchDoc]
2020-12-20 modified waiver
    [Auxillary_Supply_UCC28740.SchDoc]
2020-12-20 logo title block resolve #1
    [Auxillary_Supply_UCC28740.SchDoc, Auxillary_Supply_UCC28740.SchLib]
2020-12-20 logo title block resolve #2
    [Auxillary_Supply_UCC28740.SchDoc]
2020-12-20 Shee Mod Aux
    [Auxillary_Supply_UCC28740.PrjPcb, Auxillary_Supply_UCC28740.SchDoc]
2020-12-20 Shee Mod#23
    [Auxillary_Supply_UCC28740.SchDoc]
2020-12-20 PFC Sheet Template
    [Auxillary_Supply_UCC28740.SchDoc, PFC_Stage.SchDoc]
2020-12-22 Manufacturing Sequence Initiated
    [Auxillary_Supply_UCC28740.GBL, Auxillary_Supply_UCC28740.GBO, Auxillary_Supply_UCC28740.GBP, Auxillary_Supply_UCC28740.GBS, Auxillary_Supply_UCC28740.GM1, Auxillary_Supply_UCC28740.GTL, Auxillary_Supply_UCC28740.GTO, Auxillary_Supply_UCC28740.GTP]
2020-12-22 Aux_Supply Manufacturing Sequence Completed
    [Auxillary_Supply_UCC28740.GBL, Auxillary_Supply_UCC28740.GBO, Auxillary_Supply_UCC28740.GBP, Auxillary_Supply_UCC28740.GBS, Auxillary_Supply_UCC28740.GM1, Auxillary_Supply_UCC28740.GTL, Auxillary_Supply_UCC28740.GTO, Auxillary_Supply_UCC28740.GTP]
2020-12-22 PFC Drafts man Files Gen
    [PFC_Stage.PrjPcb, PFC_Stage.SchDoc]
2020-12-22 PFC PP Check
    [AC mains Sensing.SchDoc, Auxillary_Supply_UCC28740.SchDoc, Current_Sense_1.SchDoc, Current_Sense_2.SchDoc, EMC_Stage.SchDoc, Edge_Card_Interface.SchDoc, External_connector_Power.SchDoc, Gate_Driver.SchDoc]
2020-12-23 Solder Bridge ##12
    [Auxillary_Supply_UCC28740.PrjPcb, Current_Sense_1.SchDoc, Current_Sense_2.SchDoc, EMC_Stage.SchDoc, External_connector_Power.SchDoc, PFC_Stage.PrjPcb, PFC_Stage.SchDoc, PFC_Stage.SchLib]
2020-12-23 Solder Bridge Sequence Finish
    [AC mains Sensing.SchDoc, Current_Sense_1.SchDoc, EMC_Stage.SchDoc, Edge_Card_Interface.SchDoc, Gate_Driver.SchDoc, Shut_Down.SchDoc, UCC28070_Control.SchDoc]
2020-12-25 Silk Label PFC
    [EMC_Stage.SchDoc]
2020-12-25 LED PFC
    [Edge_Card_Interface.SchDoc, External_connector_Power.SchDoc, PFC_Stage.SchDoc]
2020-12-25 Logo Embed
    [AC mains Sensing.SchDoc, Current_Sense_1.SchDoc, Current_Sense_2.SchDoc, EMC_Stage.SchDoc, Edge_Card_Interface.SchDoc, External_connector_Power.SchDoc, Gate_Driver.SchDoc, PFC_Stage.SchDoc]
2020-12-25 Relay Error
    [EMC_Stage.SchDoc, PFC_Stage.PrjPcb, PFC_Stage.SchDoc]
2020-12-26 SEQUENCE PPC
    [Current_Sense_1.SchDoc, EMC_Stage.SchDoc, Edge_Card_Interface.SchDoc, External_connector_Power.SchDoc, PFC_Stage.PrjPcb, Shut_Down.SchDoc]
2020-12-27 PPC Done PFC/Aux
    [Auxillary_Supply_UCC28740.GBL, Auxillary_Supply_UCC28740.GBO, Auxillary_Supply_UCC28740.GBP, Auxillary_Supply_UCC28740.GBS, Auxillary_Supply_UCC28740.GTL, Auxillary_Supply_UCC28740.GTO, Auxillary_Supply_UCC28740.GTP, Auxillary_Supply_UCC28740.GTS]
2020-12-29 PPC Complete
    [Auxillary_Supply_UCC28740.GBL, Auxillary_Supply_UCC28740.GBO, Auxillary_Supply_UCC28740.GBP, Auxillary_Supply_UCC28740.GBS, Auxillary_Supply_UCC28740.GTL, Auxillary_Supply_UCC28740.GTO, Auxillary_Supply_UCC28740.GTP, Auxillary_Supply_UCC28740.GTS]
2021-01-05 REV5121 Solder mask missing Manufacture rev
    [Auxillary_Supply_UCC28740.PrjPcb, EMC_Stage.SchDoc, EMI Stage Break Out.SchDoc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]
